PrithviBhende/emg-teleoperation-ros2/docs/images/pcb/ROUTING_BOTTOM.png

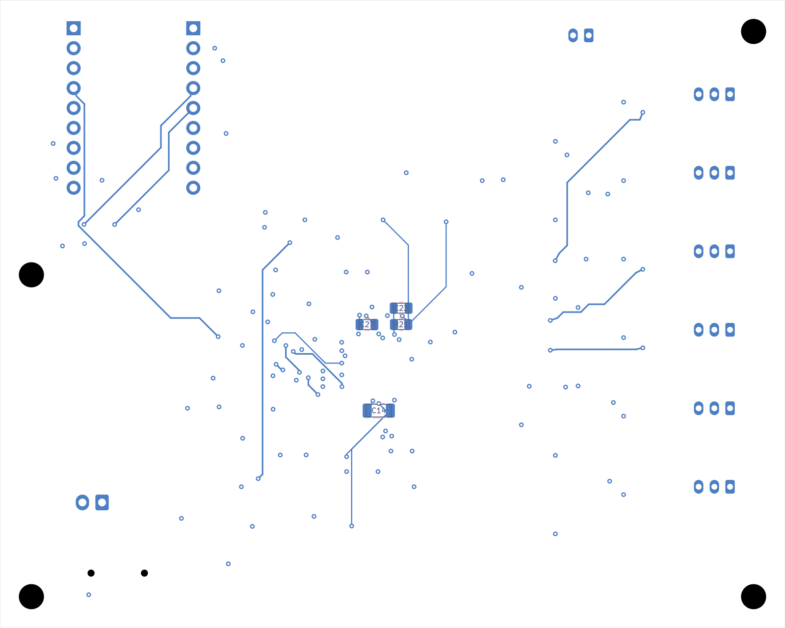
docs/images/pcb/ROUTING_BOTTOM.png
