PrithviBhende/emg-teleoperation-ros2/docs/images/projections/P01_P1_8_gestures_training_KNN_SVM_LDA_2D.png

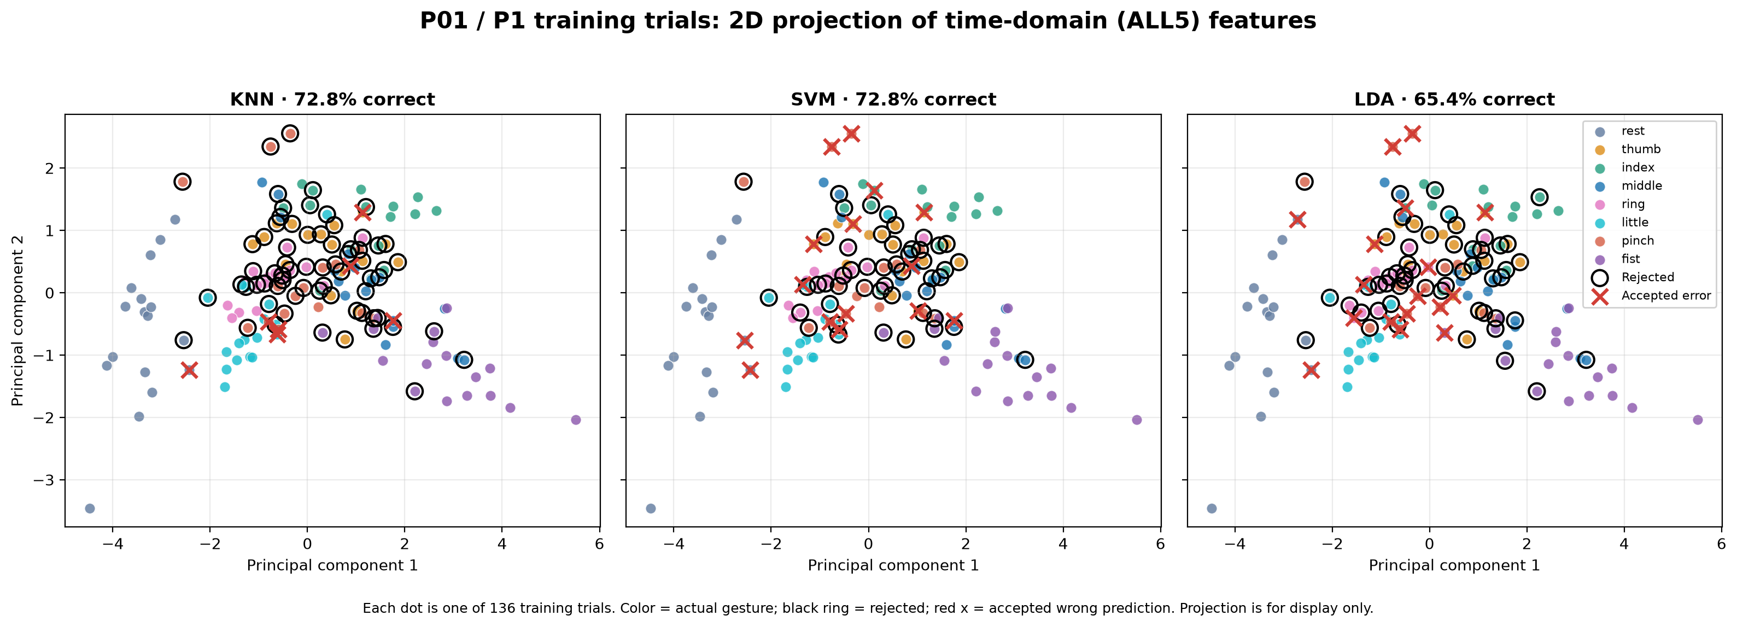
docs/images/projections/P01_P1_8_gestures_training_KNN_SVM_LDA_2D.png
