PrithviBhende/emg-teleoperation-ros2/docs/images/tiny_schematic.png

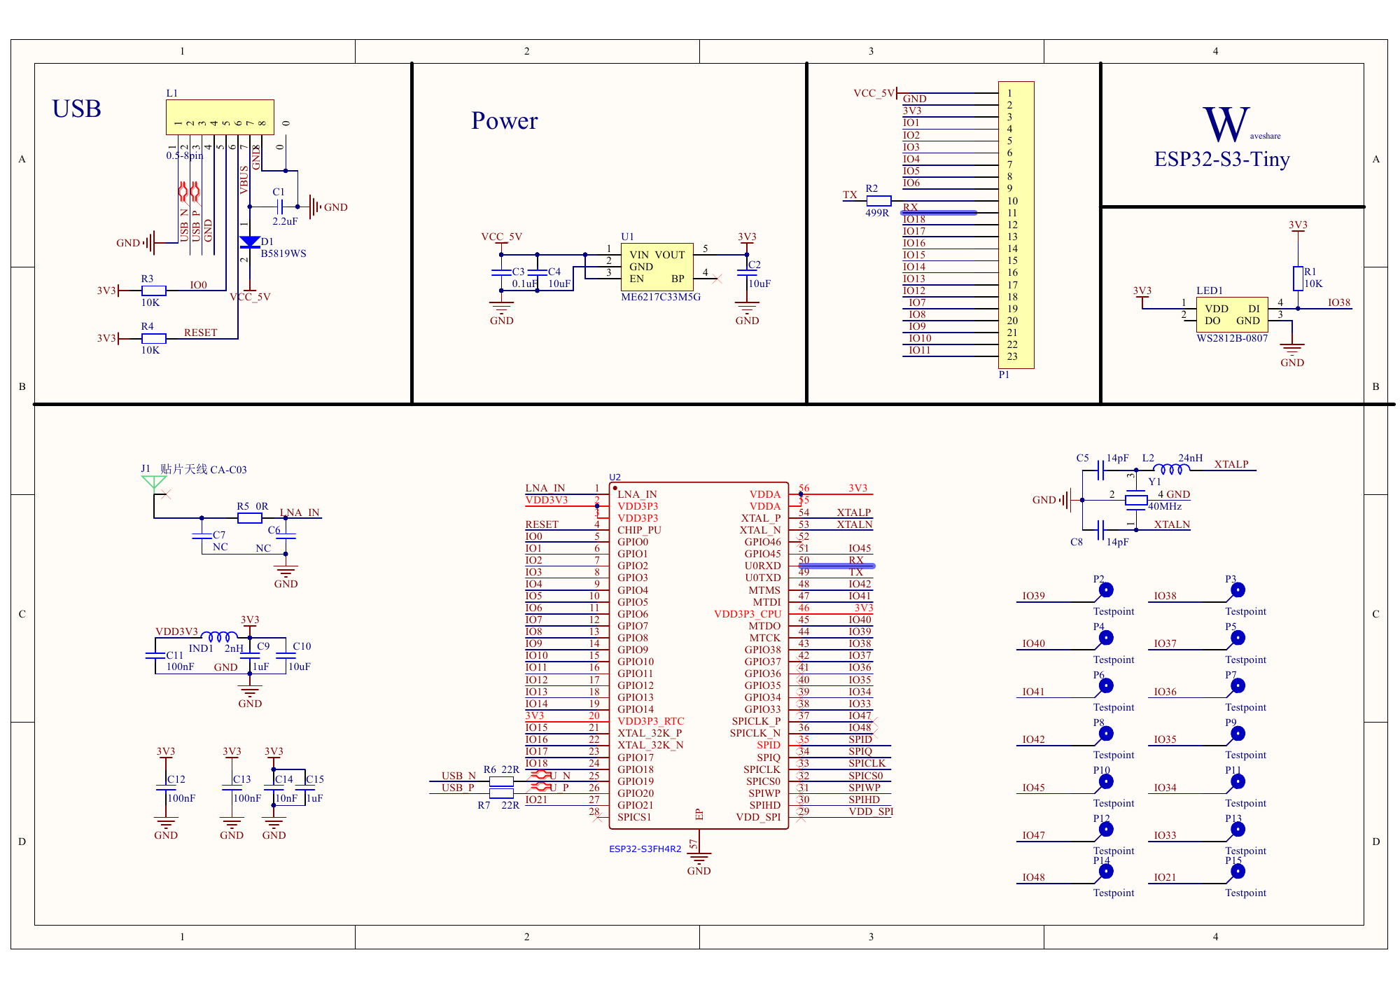
docs/images/tiny_schematic.png
