PrithviBhende/emg-teleoperation-ros2/docs/images/voltage_divider_schematic.png

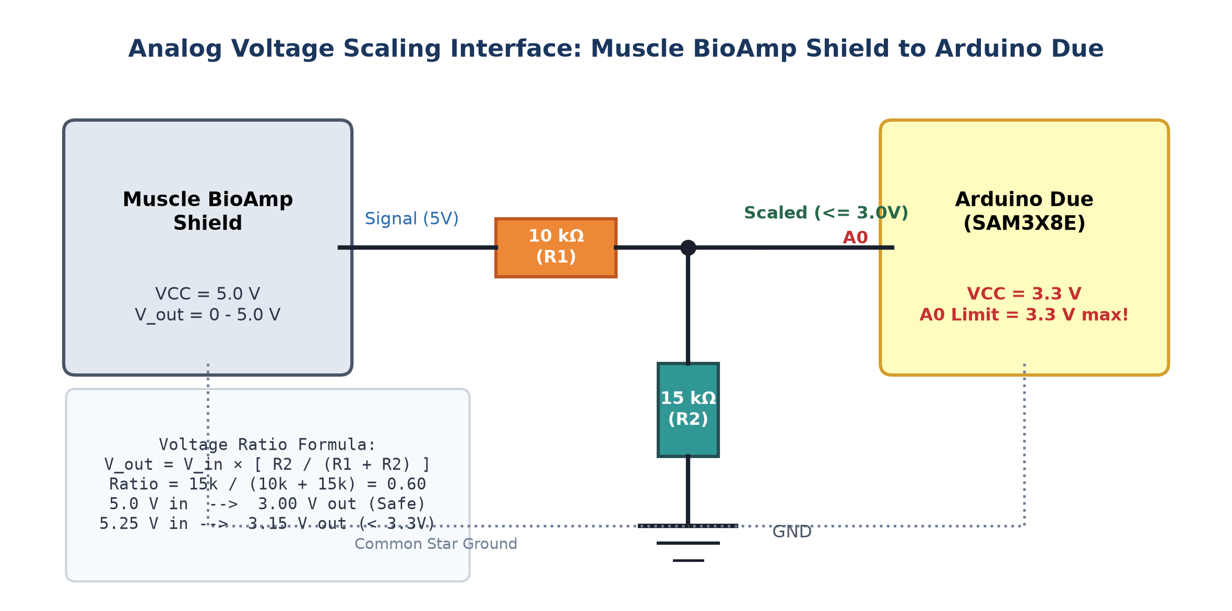
docs/images/voltage_divider_schematic.png
