PrithviBhende/emg-teleoperation-ros2/hardware/ADS1296_6CH_sEMG/connection_diagrams/01_main_connections.png

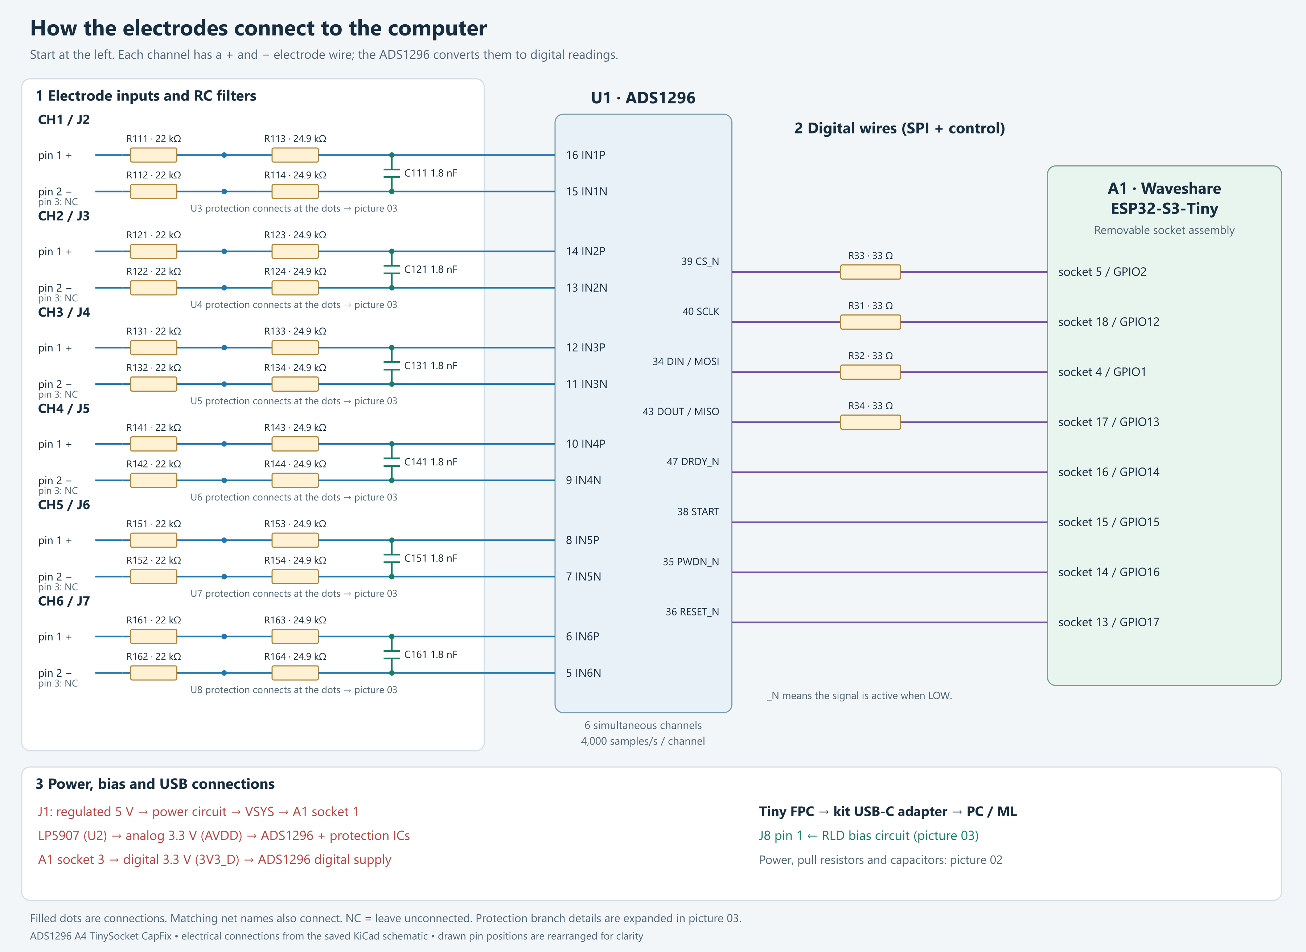
hardware/ADS1296_6CH_sEMG/connection_diagrams/01_main_connections.png
