PrithviBhende/emg-teleoperation-ros2/hardware/ADS1296_6CH_sEMG/connection_diagrams/02_power_and_capacitors.png

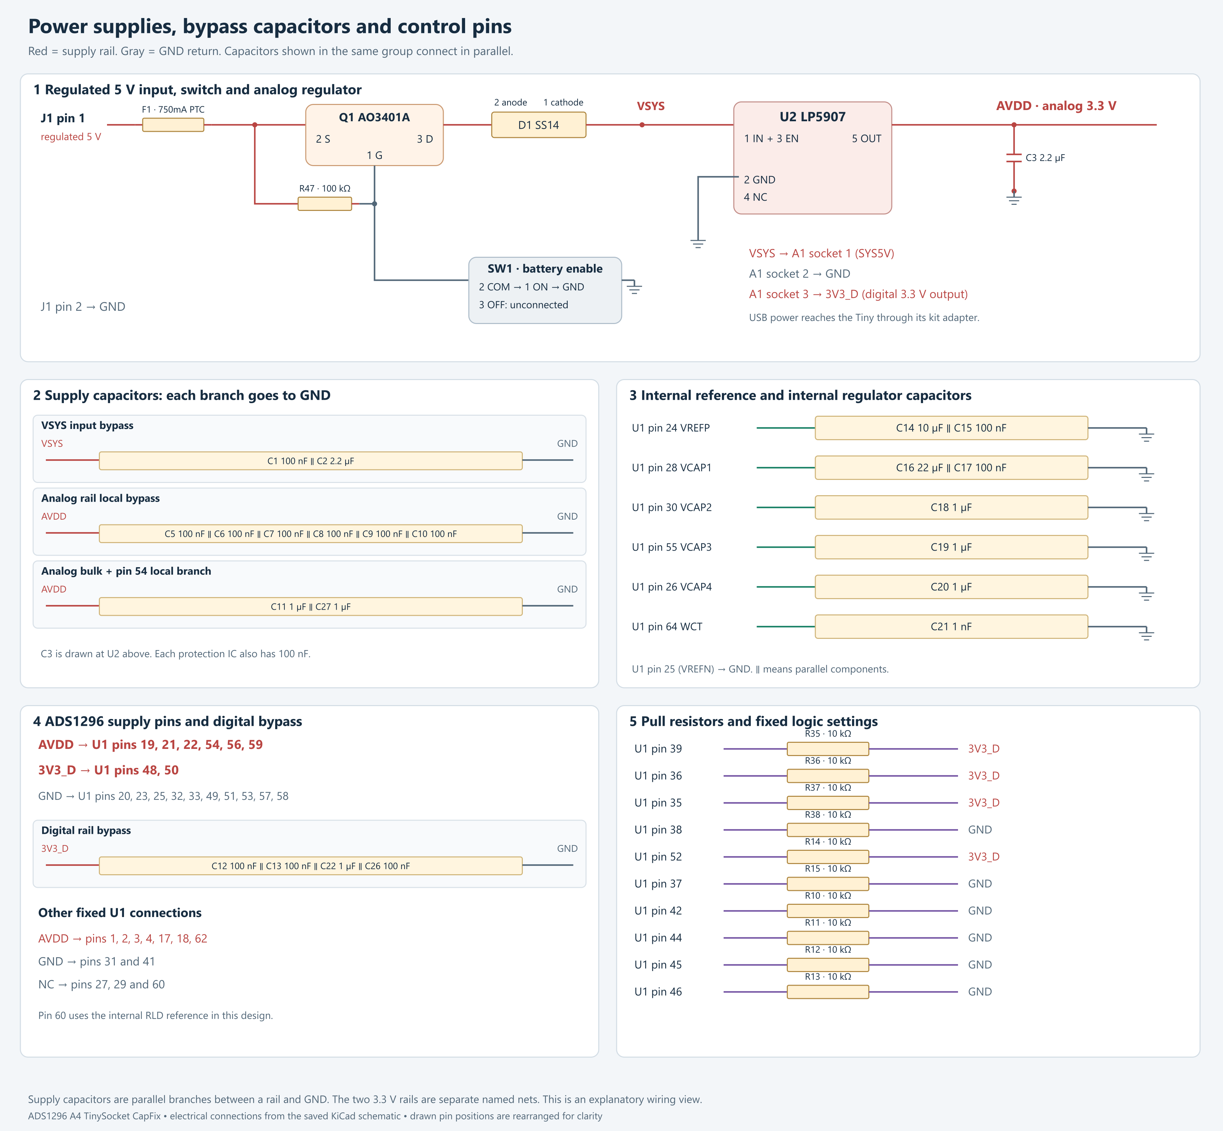
hardware/ADS1296_6CH_sEMG/connection_diagrams/02_power_and_capacitors.png
