PrithviBhende/emg-teleoperation-ros2/hardware/ADS1296_6CH_sEMG/connection_diagrams/03_protection_and_bias.png

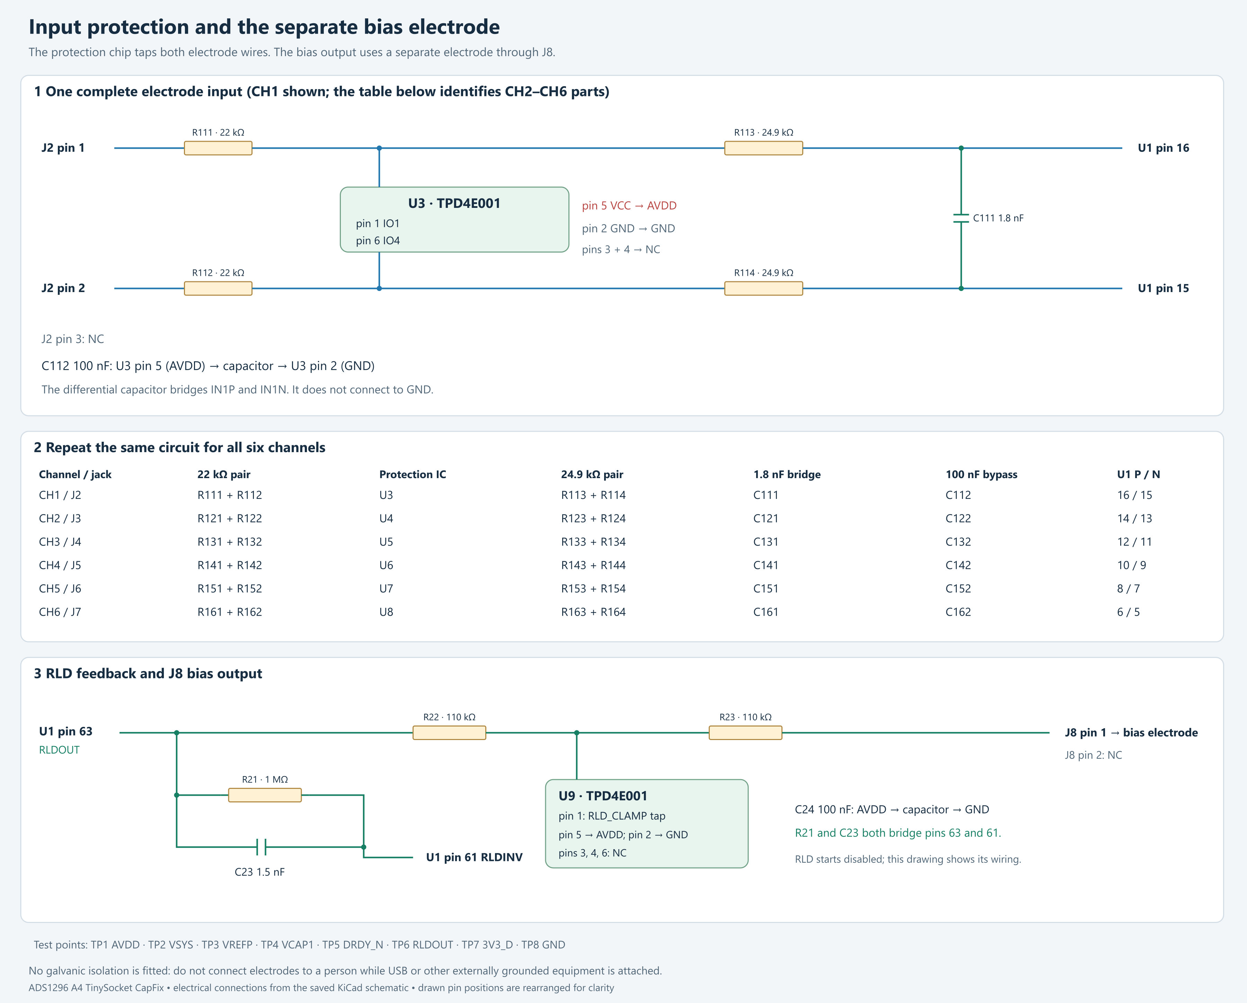
hardware/ADS1296_6CH_sEMG/connection_diagrams/03_protection_and_bias.png
