PrithviBhende/emg-teleoperation-ros2/hardware/ADS1296_6CH_sEMG/release_review_2026-10-08/external_items_preview.png

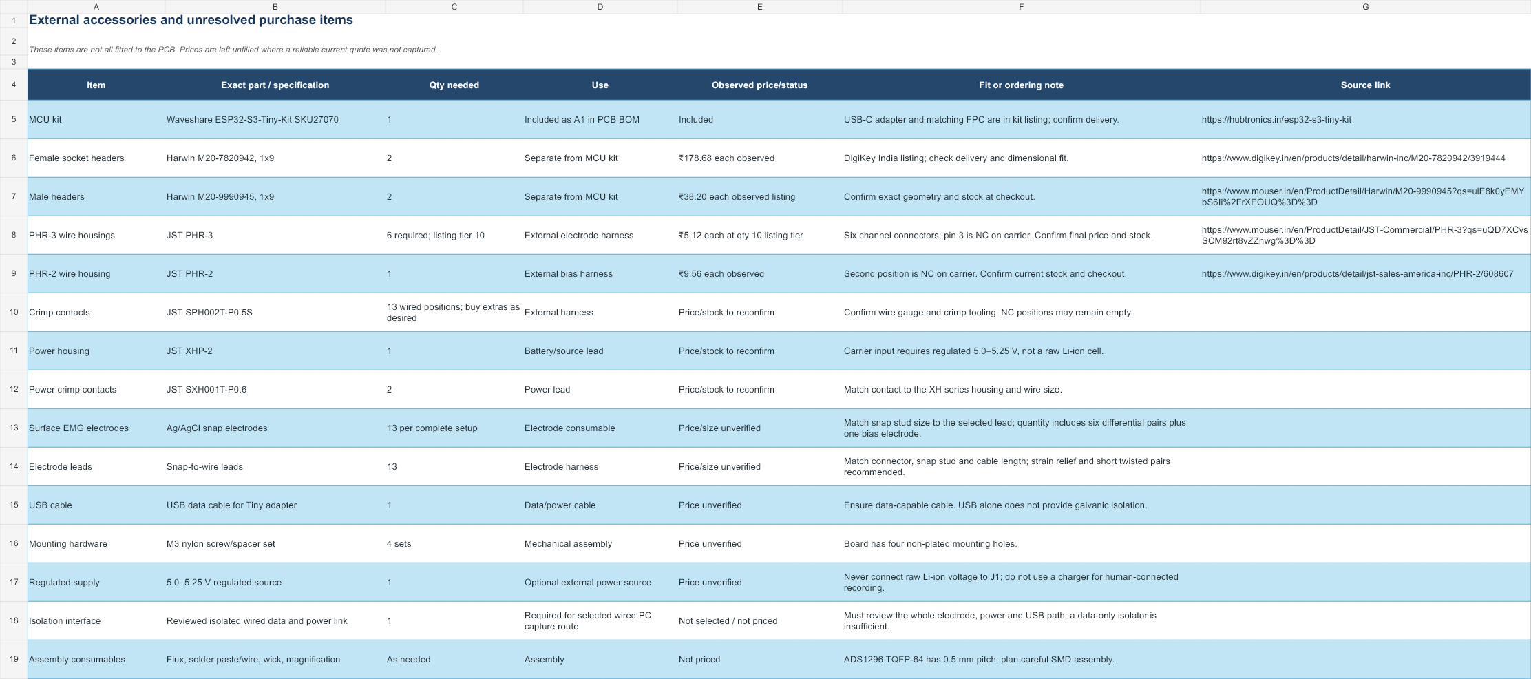
hardware/ADS1296_6CH_sEMG/release_review_2026-10-08/external_items_preview.png
