PrithviBhende/emg-teleoperation-ros2/hardware/ADS1296_6CH_sEMG/release_review_2026-10-08/ADS1296_RevA4_TinySocket_CapFix_BOM.xlsx

Sheet: PCB BOM
ADS1296 RevA4 TinySocket CapFix | Purchase BOM
Grouped by exact part number. Prices are observed listings, not a delivered quote. Blank amounts mean no dependable price was captured. Confirm stock, tax, shipping and PIN 576104 before ordering.
Note: 26 purchase groups cover 101 fitted components. TP1–TP8 are bare copper pads and H1–H4 are unplated holes, not purchased components. Amounts are estimates, not a landed total. TPD4E001 is out of stock.
Ref(s) | Component | Exact manufacturer part / SKU | Value / rating | PCB qty | Min quote qty | Observed unit price (₹) | Indicative buy amount (₹) | Quote status | Supplier | Price/source link | Package / footprint | Ordering notes
U1 | Six-channel biopotential ADC | ADS1296IPAG | 24-bit, 6-channel, TQFP-64 | 1 | 1 | ₹4429.78 | ₹4429.78 | Listing observed; reconfirm | Mouser India | https://www.mouser.in/en/ProductDetail/Texas-Instruments/ADS1296IPAG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 | TQFP-64, 0.5 mm pitch | Candidate price only; listing/stock/landed costs need checkout reconfirmation. TI direct showed out of stock.
A1 | MCU development module + adapter kit | ESP32-S3-Tiny-Kit, Waveshare SKU 27070 | ESP32-S3-Tiny + USB-C adapter + FPC | 1 | 1 | ₹635.00 | ₹635.00 | Listing observed; reconfirm | Hubtronics | https://hubtronics.in/esp32-s3-tiny-kit | Socket kit / assembled module | ₹635 incl. GST shown. Carrier socket fit and delivery to PIN 576104 remain unconfirmed.
SW1 | Slide switch | JS102011SAQN | SPDT, On-On, SMD | 1 | 1 | ₹86.00 | ₹86.00 | Listing observed; reconfirm | DigiKey India | https://www.digikey.in/en/products/detail/c-k/JS102011SAQN/1640095 | SMD | In stock shown on 2026-10-08.
C16 | Ceramic capacitor | C1210C226K4PACTU | 22 µF, 16 V, X5R, 10%, 1210 | 1 | 1 | ₹83.13 | ₹83.13 | Listing observed; reconfirm | DigiKey India | https://www.digikey.in/en/products/detail/kemet/C1210C226K4PACTU/1465626 | 1210 | Observed listing; reconfirm current price, import/tax and shipping at checkout.
U3-U8, U9 | ESD protection array | TPD4E001DBVR | 4-line low-capacitance ESD, standard DBV pinout | 7 | 1 | ₹64.01 | ₹448.07 | Unavailable at checked suppliers | Mouser India | https://www.mouser.in/en/ProductDetail/Texas-Instruments/TPD4E001DBVR?qs=TeC8nwD7mVpPZhmkNxkg4A%3D%3D | SOT-23-6 | BLOCKED: checked stock 0; incoming shown in 2027. Do not treat as buyable for the deadline. Alternative not approved.
C14 | Ceramic capacitor | C1206C106K4PACTU | 10 µF, 16 V, X5R, 10%, 1206 | 1 | 1 | ₹51.60 | ₹51.60 | Listing observed; reconfirm | DigiKey India | https://www.digikey.in/en/products/detail/kemet/C1206C106K4PACTU/1465625 | 1206 | DigiKey listing showed ₹51.60 each and stock on 2026-10-08; import/tax/shipping extra per checkout.
Q1 | P-channel MOSFET | AO3401A | 30 V, SOT-23 | 1 | 1 | ₹49.69 | ₹49.69 | Listing observed; reconfirm | DigiKey India | https://www.digikey.in/en/products/detail/alpha-omega-semiconductor-inc/AO3401A/1855773 | SOT-23 | Quote is for AOS manufacturer part.
D1 | Schottky diode | SS14 (onsemi) | 40 V, 1 A, SMA / DO-214AC | 1 | 1 | ₹42.04 | ₹42.04 | Listing observed; reconfirm | DigiKey India | https://www.digikey.in/en/products/detail/onsemi/SS14/965474 | SMA | Use SMA package; SS14W in SOD-123 is not footprint-compatible.
C2-C3 | Ceramic capacitor | C0805C225K4RACTU | 2.2 µF, 16 V, X7R, 10%, 0805 | 2 | 1 | ₹37.70 | ₹75.40 | Listing observed; reconfirm | LionCircuits | https://www.lioncircuits.com/parts/C0805C225K4RACTU | 0805 | Observed listing; reconfirm live price, stock and delivery at checkout.
F1 | Resettable fuse | MF-MSMF075-2 | 750 mA hold, 1.5 A trip, 13.2 V, 1812 | 1 | 1 | ₹36.31 | ₹36.31 | Listing observed; reconfirm | DigiKey India | https://www.digikey.in/en/products/detail/bourns-inc/MF-MSMF075-2/662843 | 1812 SMD | In stock shown on 2026-10-08; marked Not For New Designs by supplier.
U2 | Low-noise LDO regulator | LP5907MFX-3.3/NOPB | 3.3 V fixed, 250 mA, SOT-23-5 | 1 | 1 | ₹17.11 | ₹17.11 | Listing observed; reconfirm | Evelta | https://evelta.com/texas-instruments-lp5907mfx-3-3-nopb-fixed-ldo-voltage-regulator-3-3vout/ | SOT-23-5 | ₹17.11 incl. GST shown; supplier authorization not established; reconfirm.
C21 | Ceramic capacitor | C0805C102J5GACTU | 1 nF, 50 V, C0G, 5%, 0805 | 1 | 1 | ₹16.24 | ₹16.24 | Listing observed; reconfirm | DigiKey India | https://www.digikey.in/en/products/detail/kemet/C0805C102J5GACTU/411135 | 0805 | DigiKey listing showed ₹16.24 each and stock on 2026-10-08; import/tax/shipping extra per checkout.
C111, C121, C131, C141, C151, C161 | Ceramic capacitor | C0805C182J5GACTU | 1.8 nF, 50 V, C0G, 5%, 0805 | 6 | 10 | ₹15.62 | ₹156.21 | Observed; delivery unconfirmed | LionCircuits | https://www.lioncircuits.com/ | 0805 | Fresh listing: 10-piece tier ₹15.621 each; buy quantity 10 minimum (₹156.21 listing subtotal); delivery estimate 7-10 days, not arrival guarantee.
J2-J7 | 3-way electrode connector | B3B-PH-K-S(LF)(SN) | JST PH, 2.00 mm, vertical | 6 | 1 | ₹15.29 | ₹91.74 | Listing observed; reconfirm | DigiKey India | https://www.digikey.in/en/products/detail/jst-sales-america-inc/B3B-PH-K-S/926612 | Through-hole | Unit listing observed; checkout/tax/shipping reconfirm.
C23 | Ceramic capacitor | C0805C152J5GACTU | 1.5 nF, 50 V, C0G, 5%, 0805 | 1 | 1 | ₹15.29 | ₹15.29 | Listing observed; reconfirm | DigiKey India | https://www.digikey.in/en/products/detail/kemet/C0805C152J5GACTU/2211962 | 0805 | DigiKey listing showed ₹15.29 each and stock on 2026-10-08; import/tax/shipping extra per checkout.
J8 | 2-way bias connector | B2B-PH-K-S(LF)(SN) | JST PH, 2.00 mm, vertical | 1 | 1 | ₹11.47 | ₹11.47 | Listing observed; reconfirm | DigiKey India | https://www.digikey.in/en/products/detail/jst-sales-america-inc/B2B-PH-K-S/926611 | Through-hole | Unit listing observed; confirm current stock/tax at checkout.
R47 | Resistor | RC0805FR-07100KL | 100 kΩ, 1%, 0805 | 1 | 1 | ₹9.32 | ₹9.32 | Listing observed; reconfirm | Mouser India | https://www.mouser.in/en/ProductDetail/YAGEO/RC0805FR-07100KL?qs=8Y8p%252BasKcI7rEWn6FcVdAA%3D%3D | 0805 | Observed supplier listing; reconfirm price, tax and stock.
C11, C18-C20, C22, C27 | Ceramic capacitor | C0805C105K4RACTU | 1 µF, 16 V, X7R, 10%, 0805 | 6 | 10 | ₹8.39 | ₹83.90 | Listing observed; reconfirm | Mouser India | https://www.mouser.in/ProductDetail/KEMET/C0805C105K4RACTU?qs=yrVqjCObULOefkidH6lLLQ%3D%3D | 0805 | Mouser listing showed ₹8.39 each at quantity 10 and stock on 2026-10-08; delivery/tax at checkout.
R111, R121, R131, R141, R151, R161, R112, R122, R132, R142, R152, R162 | Precision resistor | RT0805BRD0722KL | 22 kΩ, 0.1%, ≤25 ppm/K, 0805 | 12 | 10 | ₹7.93 | ₹95.17 | Listing observed; reconfirm | DigiKey India | https://www.digikey.in/en/products/detail/yageo/RT0805BRD0722KL/5139281 | 0805 | Quantity-10 tier; 12 required. ₹7.931/unit observed; tax/shipping treatment to confirm.
R113, R123, R133, R143, R153, R163, R114, R124, R134, R144, R154, R164 | Precision resistor | RT0805BRD0724K9L | 24.9 kΩ, 0.1%, ≤25 ppm/K, 0805 | 12 | 10 | ₹7.93 | ₹95.17 | Listing observed; reconfirm | DigiKey India | https://www.digikey.in/en/products/detail/yageo/RT0805BRD0724K9L/1075743 | 0805 | Quantity-10 tier; 12 required. ₹7.931/unit observed; tax/shipping treatment to confirm.
J1 | 2-way power connector | B2B-XH-A(LF)(SN) | JST XH, 2.50 mm, vertical | 1 | 1 | ₹7.43 | ₹7.43 | Listing observed; reconfirm | element14 India | https://in.element14.com/jst-japan-solderless-terminals/b2b-xh-a-lf-sn/header-vertical-2way/dp/1516276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 | Through-hole | ₹7.43 listing, MOQ 1; checkout/tax/delivery reconfirm.
C1, C5-C10, C12-C13, C15, C17, C24, C26, C112, C122, C132, C142, C152, C162 | Ceramic capacitor | C0805C104K4RACTU | 100 nF, 16 V, X7R, 10%, 0805 | 19 | 10 | ₹5.57 | ₹105.83 | Listing observed; reconfirm | Mouser India | https://www.mouser.in/ProductDetail/KEMET/C0805C104K4RACTU?qs=Pc30aiB8zWWfqQNJWggt%252BA%3D%3D | 0805 | Historical observed quantity-tier price; live stock/price needs reconfirmation.
R31-R34 | Resistor | RC0805FR-0733RL | 33 Ω, 1%, 0805 | 4 | 1 | ₹2.36 | ₹9.44 | Listing observed; reconfirm | Evelta | https://evelta.com/33r-1-0-125w-0805-chip-resistor/ | 0805 | ₹2 ex-GST each; ₹2.36 incl. 18% GST estimate; shipping extra.
R21 | Resistor | RC0805FR-071ML | 1 MΩ, 1%, 0805 | 1 | 1 | ₹1.30 | ₹1.30 | Listing observed; reconfirm | Evelta | https://evelta.com/1m-1-0-125w-0805-chip-resistor/ | 0805 | ₹1.10 ex-GST / ₹1.30 incl. GST observed; shipping extra.
R22-R23 | Resistor | RC0805FR-07110KL | 110 kΩ, 1%, 0805 | 2 | 1 | ₹1.30 | ₹2.60 | Listing observed; reconfirm | Evelta | https://evelta.com/110k-1-0-125w-0805-chip-resistor/ | 0805 | ₹1.10 ex-GST each; ₹1.298 incl. 18% GST estimate; shipping extra.
R10-R15, R35-R38 | Resistor | RC0805FR-0710KL | 10 kΩ, 1%, 0805 | 10 | 10 | ₹1.27 | ₹12.74 | Listing observed; reconfirm | Evelta | https://evelta.com/10k-1-0-125w-0805-chip-resistor/ | 0805 | ₹1.08 ex-GST each at qty 10; ₹1.2744 incl. 18% GST estimate; shipping extra.
Indicative extension of priced rows only (mixed tax basis; excludes shipping, PCB, isolation and unpriced items) |  |  |  |  |  |  | 6667.98

Sheet: External items
External accessories and unresolved purchase items
These items are not all fitted to the PCB. Prices are left unfilled where a reliable current quote was not captured.
Item | Exact part / specification | Qty needed | Use | Observed price/status | Fit or ordering note | Source link
MCU kit | Waveshare ESP32-S3-Tiny-Kit SKU27070 | 1 | Included as A1 in PCB BOM | Included | USB-C adapter and matching FPC are in kit listing; confirm delivery. | https://hubtronics.in/esp32-s3-tiny-kit
Female socket headers | Harwin M20-7820942, 1x9 | 2 | Separate from MCU kit | ₹178.68 each observed | DigiKey India listing; check delivery and dimensional fit. | https://www.digikey.in/en/products/detail/harwin-inc/M20-7820942/3919444
Male headers | Harwin M20-9990945, 1x9 | 2 | Separate from MCU kit | ₹38.20 each observed listing | Confirm exact geometry and stock at checkout. | https://www.mouser.in/en/ProductDetail/Harwin/M20-9990945?qs=ulE8k0yEMYbS6Ii%2FrXEOUQ%3D%3D
PHR-3 wire housings | JST PHR-3 | 6 required; listing tier 10 | External electrode harness | ₹5.12 each at qty 10 listing tier | Six channel connectors; pin 3 is NC on carrier. Confirm final price and stock. | https://www.mouser.in/en/ProductDetail/JST-Commercial/PHR-3?qs=uQD7XCvsSCM92rt8vZZnwg%3D%3D
PHR-2 wire housing | JST PHR-2 | 1 | External bias harness | ₹9.56 each observed | Second position is NC on carrier. Confirm current stock and checkout. | https://www.digikey.in/en/products/detail/jst-sales-america-inc/PHR-2/608607
Crimp contacts | JST SPH002T-P0.5S | 13 wired positions; buy extras as desired | External harness | Price/stock to reconfirm | Confirm wire gauge and crimp tooling. NC positions may remain empty.
Power housing | JST XHP-2 | 1 | Battery/source lead | Price/stock to reconfirm | Carrier input requires regulated 5.0–5.25 V, not a raw Li-ion cell.
Power crimp contacts | JST SXH001T-P0.6 | 2 | Power lead | Price/stock to reconfirm | Match contact to the XH series housing and wire size.
Surface EMG electrodes | Ag/AgCl snap electrodes | 13 per complete setup | Electrode consumable | Price/size unverified | Match snap stud size to the selected lead; quantity includes six differential pairs plus one bias electrode.
Electrode leads | Snap-to-wire leads | 13 | Electrode harness | Price/size unverified | Match connector, snap stud and cable length; strain relief and short twisted pairs recommended.
USB cable | USB data cable for Tiny adapter | 1 | Data/power cable | Price unverified | Ensure data-capable cable. USB alone does not provide galvanic isolation.
Mounting hardware | M3 nylon screw/spacer set | 4 sets | Mechanical assembly | Price unverified | Board has four non-plated mounting holes.
Regulated supply | 5.0–5.25 V regulated source | 1 | Optional external power source | Price unverified | Never connect raw Li-ion voltage to J1; do not use a charger for human-connected recording.
Isolation interface | Reviewed isolated wired data and power link | 1 | Required for selected wired PC capture route | Not selected / not priced | Must review the whole electrode, power and USB path; a data-only isolator is insufficient.
Assembly consumables | Flux, solder paste/wire, wick, magnification | As needed | Assembly | Not priced | ADS1296 TQFP-64 has 0.5 mm pitch; plan careful SMD assembly.
