PrithviBhende/emg-teleoperation-ros2/hardware/ADS1296_6CH_sEMG/release_review_2026-10-08/bom_preview.png

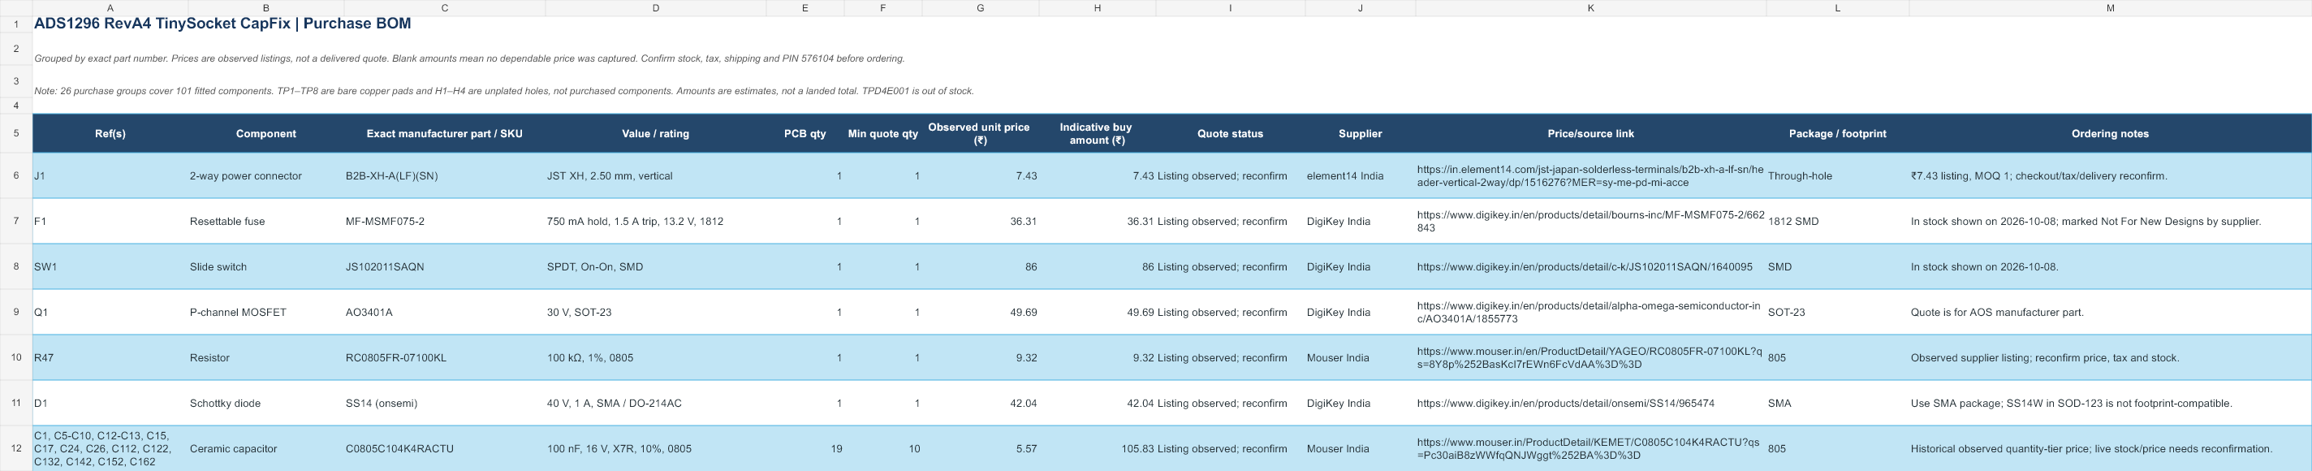
hardware/ADS1296_6CH_sEMG/release_review_2026-10-08/bom_preview.png
