PrithviBhende/emg-teleoperation-ros2/ros2/inmoov_hand_ros/src/inmoov_hand_description/meshes/r_cover_ring.stl

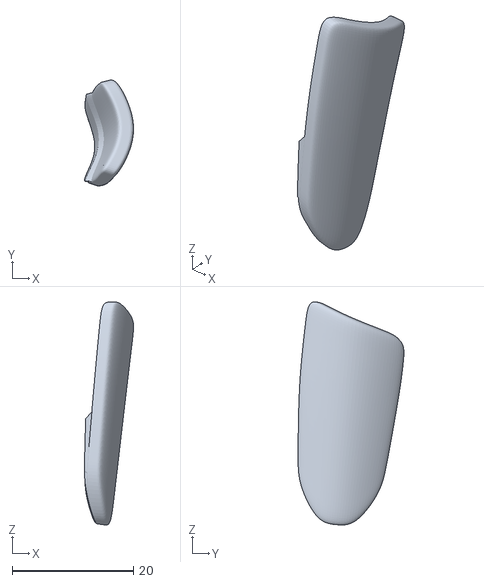
[picture p34: CAD file, 2026-11-13]
ros2/inmoov_hand_ros/src/inmoov_hand_description/meshes/r_cover_ring.stl
8.09 x 17.4 x 36.7
