PrithviBhende/emg-teleoperation-ros2/ros2/inmoov_hand_ros/src/inmoov_hand_description/meshes/l_ring3_1.stl

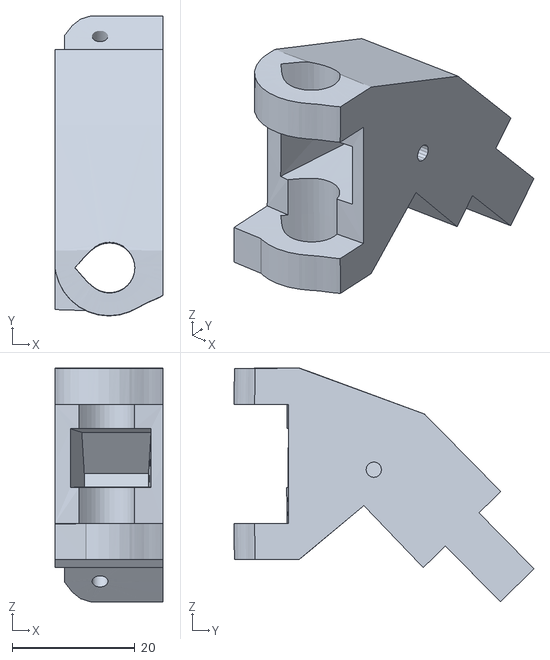
[picture p35: CAD file, 2026-11-13]
ros2/inmoov_hand_ros/src/inmoov_hand_description/meshes/l_ring3_1.stl
17.7 x 48.9 x 38.1
