PrithviBhende/emg-teleoperation-ros2/ros2/inmoov_hand_ros/src/inmoov_hand_description/meshes/virtual.stl

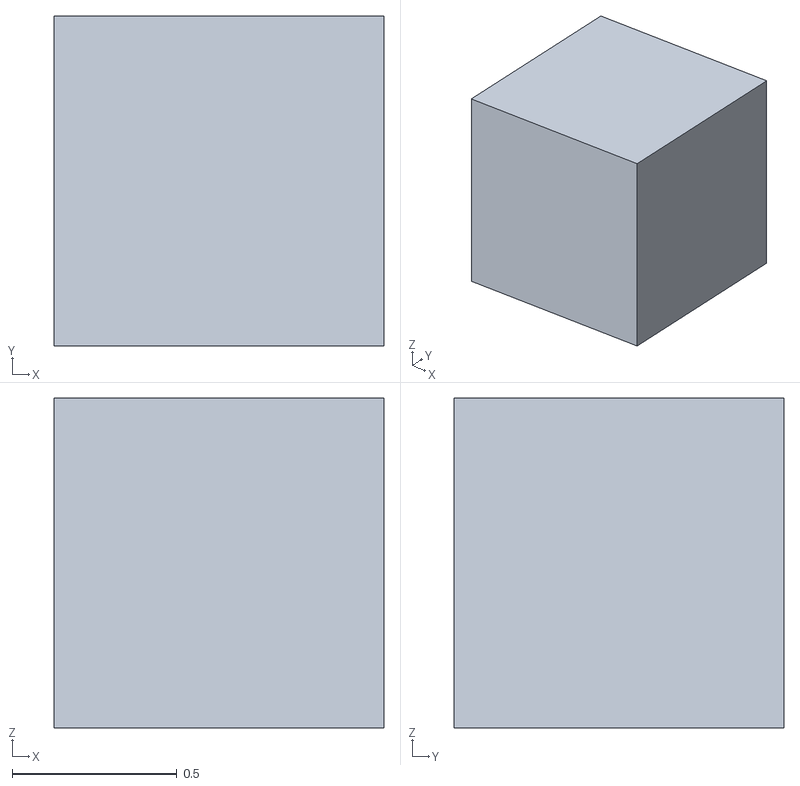
[picture p36: CAD file, 2026-11-13]
ros2/inmoov_hand_ros/src/inmoov_hand_description/meshes/virtual.stl
1.00 x 1.00 x 1.00
