PrithviBhende/emg-teleoperation-ros2/ros2/inmoov_hand_ros/src/inmoov_hand_description/meshes/head.stl

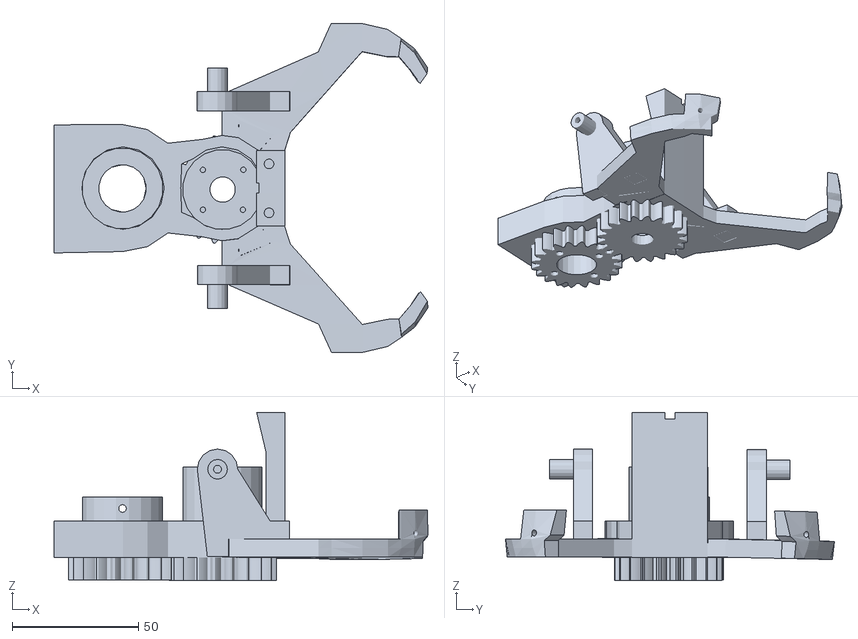
[picture p37: CAD file, 2026-11-13]
ros2/inmoov_hand_ros/src/inmoov_hand_description/meshes/head.stl
148.3 x 130.5 x 66.7
