PrithviBhende/emg-teleoperation-ros2/ros2/inmoov_hand_ros/src/inmoov_hand_description/meshes/camera.stl

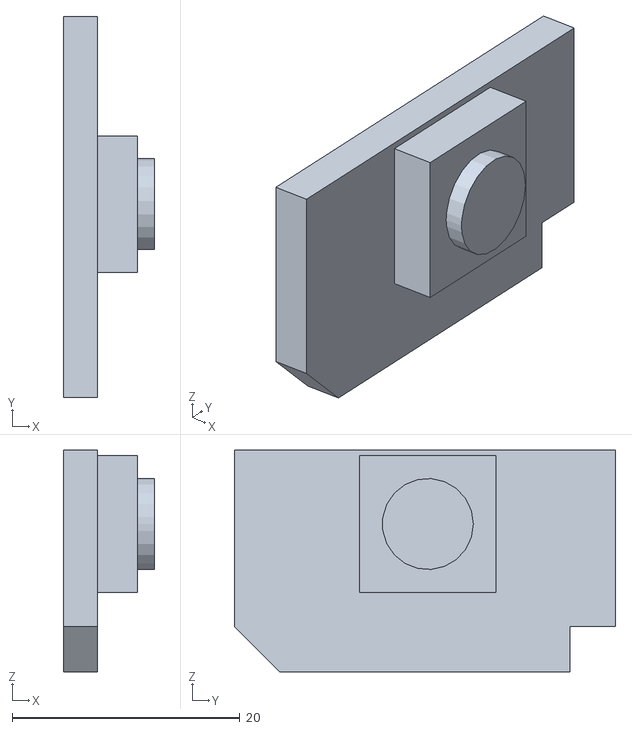
[picture p38: CAD file, 2026-11-13]
ros2/inmoov_hand_ros/src/inmoov_hand_description/meshes/camera.stl
8.00 x 33.5 x 19.5
