PrithviBhende/emg-teleoperation-ros2/ros2/inmoov_hand_ros/src/inmoov_hand_description/meshes/l_thumb5_1.stl

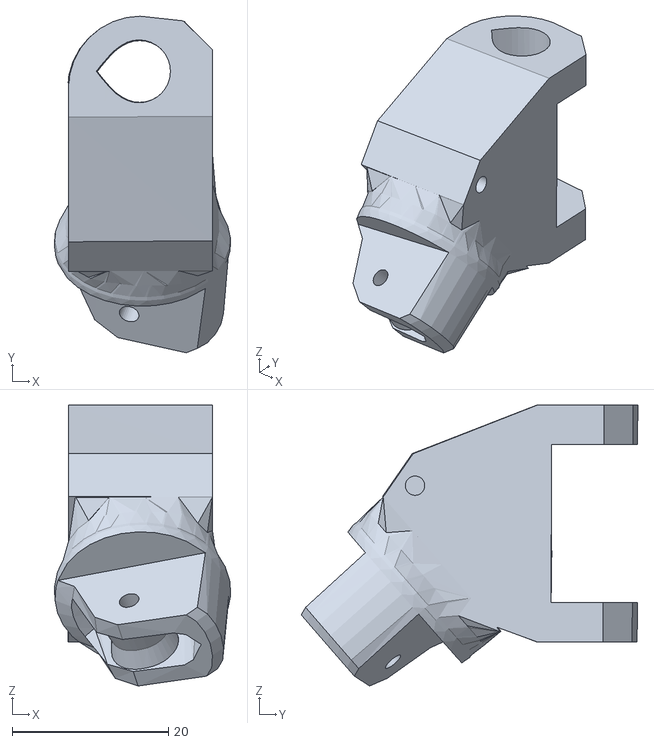
[picture p40: CAD file, 2026-11-13]
ros2/inmoov_hand_ros/src/inmoov_hand_description/meshes/l_thumb5_1.stl
22.6 x 43.0 x 35.9
