PrithviBhende/emg-teleoperation-ros2/ros2/inmoov_hand_ros/src/inmoov_hand_description/meshes/r_pinky3_1.stl

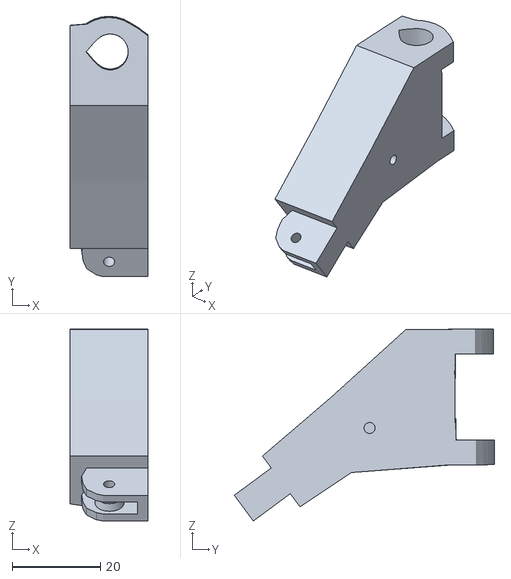
[picture p45: CAD file, 2026-11-13]
ros2/inmoov_hand_ros/src/inmoov_hand_description/meshes/r_pinky3_1.stl
17.7 x 58.9 x 43.4
