PrithviBhende/emg-teleoperation-ros2/ros2/inmoov_hand_ros/src/inmoov_hand_description/meshes/r_cover_middle.stl

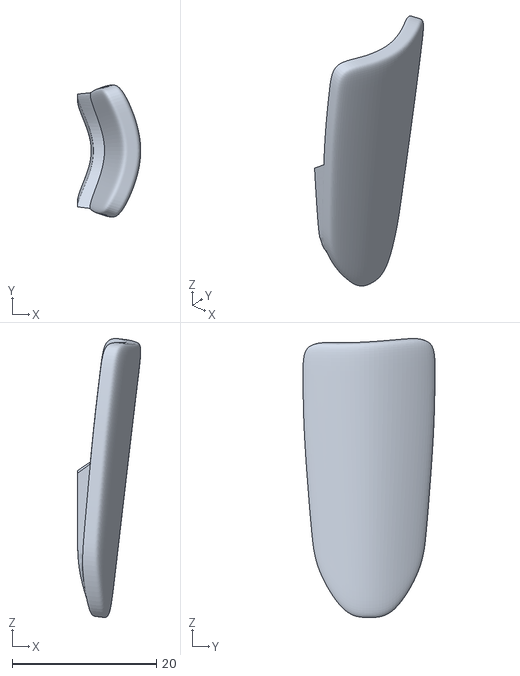
[picture p48: CAD file, 2026-11-13]
ros2/inmoov_hand_ros/src/inmoov_hand_description/meshes/r_cover_middle.stl
8.81 x 18.3 x 38.7
