PrithviBhende/emg-teleoperation-ros2/ros2/inmoov_hand_ros/src/inmoov_hand_description/meshes/l_cover_thumb.stl

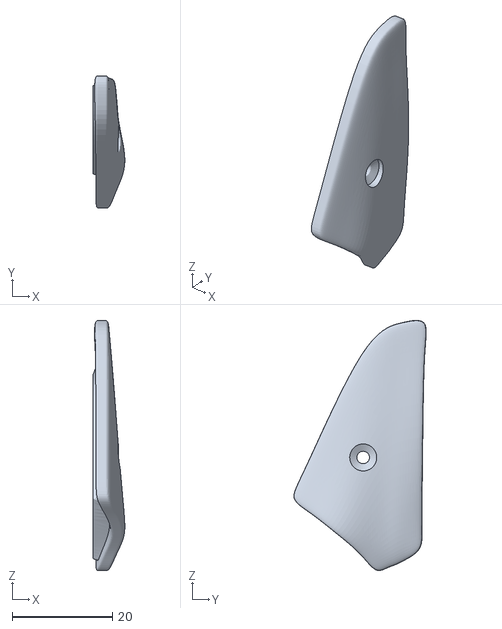
[picture p54: CAD file, 2026-11-13]
ros2/inmoov_hand_ros/src/inmoov_hand_description/meshes/l_cover_thumb.stl
6.32 x 26.3 x 49.8
