PrithviBhende/emg-teleoperation-ros2/ros2/inmoov_hand_ros/src/inmoov_hand_description/meshes/r_cover_handring.stl

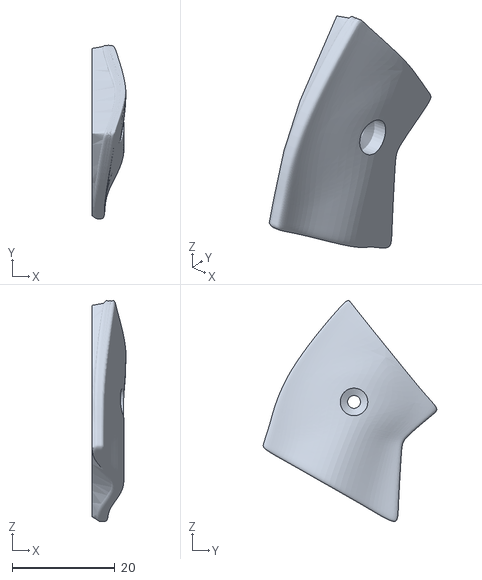
[picture p55: CAD file, 2026-11-13]
ros2/inmoov_hand_ros/src/inmoov_hand_description/meshes/r_cover_handring.stl
6.64 x 33.8 x 43.1
