PrithviBhende/emg-teleoperation-ros2/(list of files, cad)

Other CAD files:
ros2/inmoov_hand_ros/src/inmoov_hand_description/meshes/r_ring3_1.stl
ros2/inmoov_hand_ros/src/inmoov_hand_description/meshes/earleftv1.stl
ros2/inmoov_hand_ros/src/inmoov_hand_description/meshes/r_cover_thumb.stl
ros2/inmoov_hand_ros/src/inmoov_hand_description/meshes/l_cover_handring.stl
ros2/inmoov_hand_ros/src/inmoov_hand_description/meshes/r_cover_index.stl
ros2/inmoov_hand_ros/src/inmoov_hand_description/meshes/l_cover_ring.stl
ros2/inmoov_hand_ros/src/inmoov_hand_description/meshes/l_shoulder_base.stl
ros2/inmoov_hand_ros/src/inmoov_hand_description/meshes/r_thumb5_1.stl
ros2/inmoov_hand_ros/src/inmoov_hand_description/meshes/l_pinky3_1.stl
ros2/inmoov_hand_ros/src/inmoov_hand_description/meshes/l_cover_handpinky.stl
ros2/inmoov_hand_ros/src/inmoov_hand_description/meshes/r_cover_pinky.stl
ros2/inmoov_hand_ros/src/inmoov_hand_description/meshes/l_cover_middle.stl
ros2/inmoov_hand_ros/src/inmoov_hand_description/meshes/l_eyesupport.stl
ros2/inmoov_hand_ros/src/inmoov_hand_description/meshes/r_shoulder.stl
ros2/inmoov_hand_ros/src/inmoov_hand_description/meshes/r_forearm.stl
ros2/inmoov_hand_ros/src/inmoov_hand_description/meshes/l_cover_hand.stl
ros2/inmoov_hand_ros/src/inmoov_hand_description/meshes/l_hand.stl
