PrithviBhende/emg-teleoperation-ros2/docs/images/pcb/ASSEMBLY_BOTTOM.png

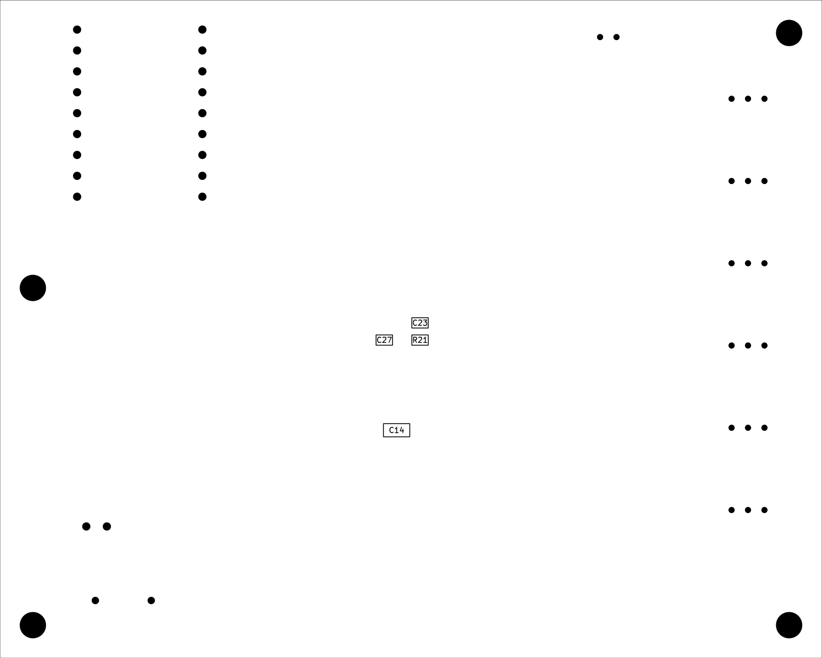
docs/images/pcb/ASSEMBLY_BOTTOM.png
