PrithviBhende/emg-teleoperation-ros2/results/training_results/01_rest_index_fist/README.md

# Study 1: rest, index, fist (3 Gestures)

- **Subject**: P01
- **Electrode Placement**: P4
- **Champion / Evaluated Model**: `A_RMS__KNN`
- **3-Fold Cross-Validation Accuracy**: 100.00% (60/60)
- **Held-Out Test Accuracy**: 100.00% (10/10)

---

## Graphical Representations & Decision Boundaries

### 2D Feature Projections & Decision Boundaries

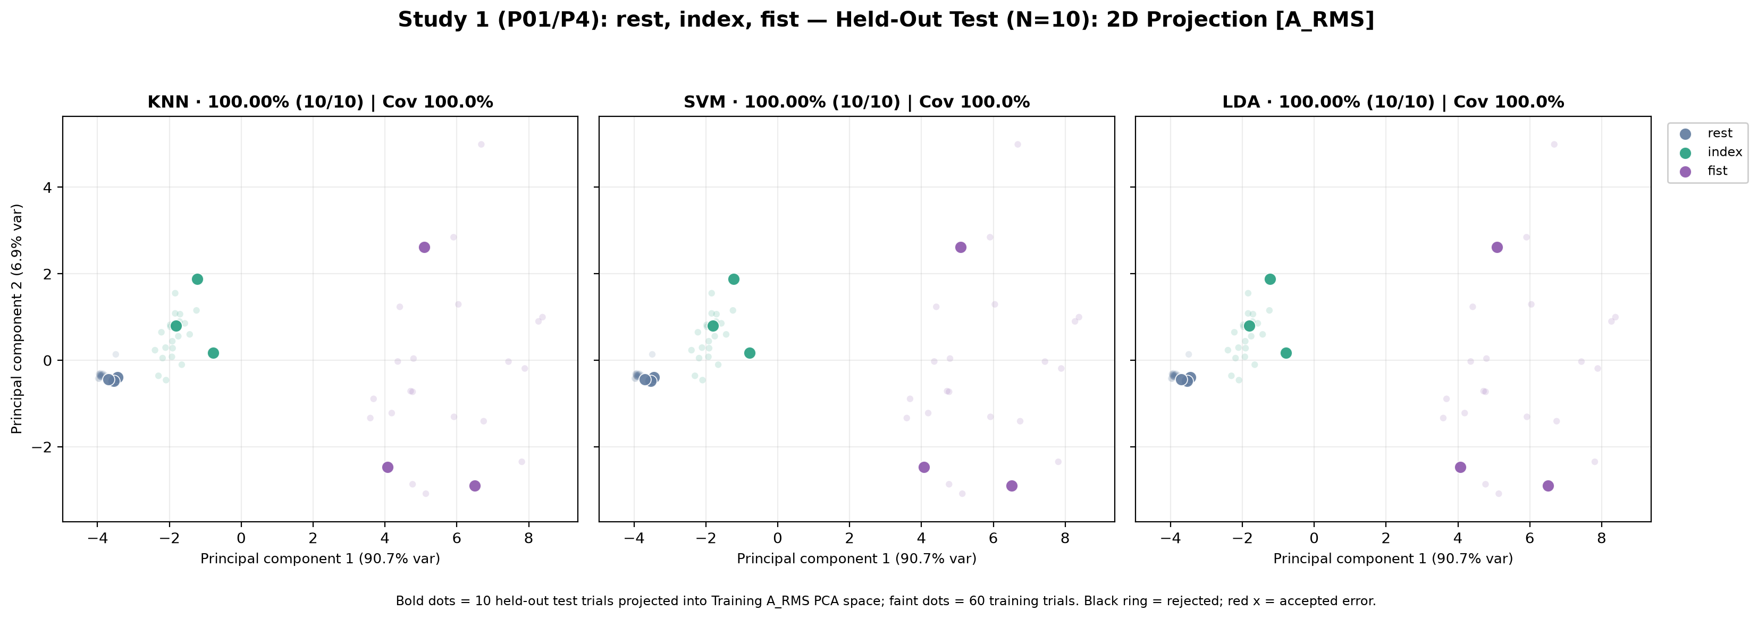
[picture p84: results/training_results/01_rest_index_fist/Study01_P01_P4_rest_index_fist_test_A_RMS_KNN_SVM_LDA_2D.png]


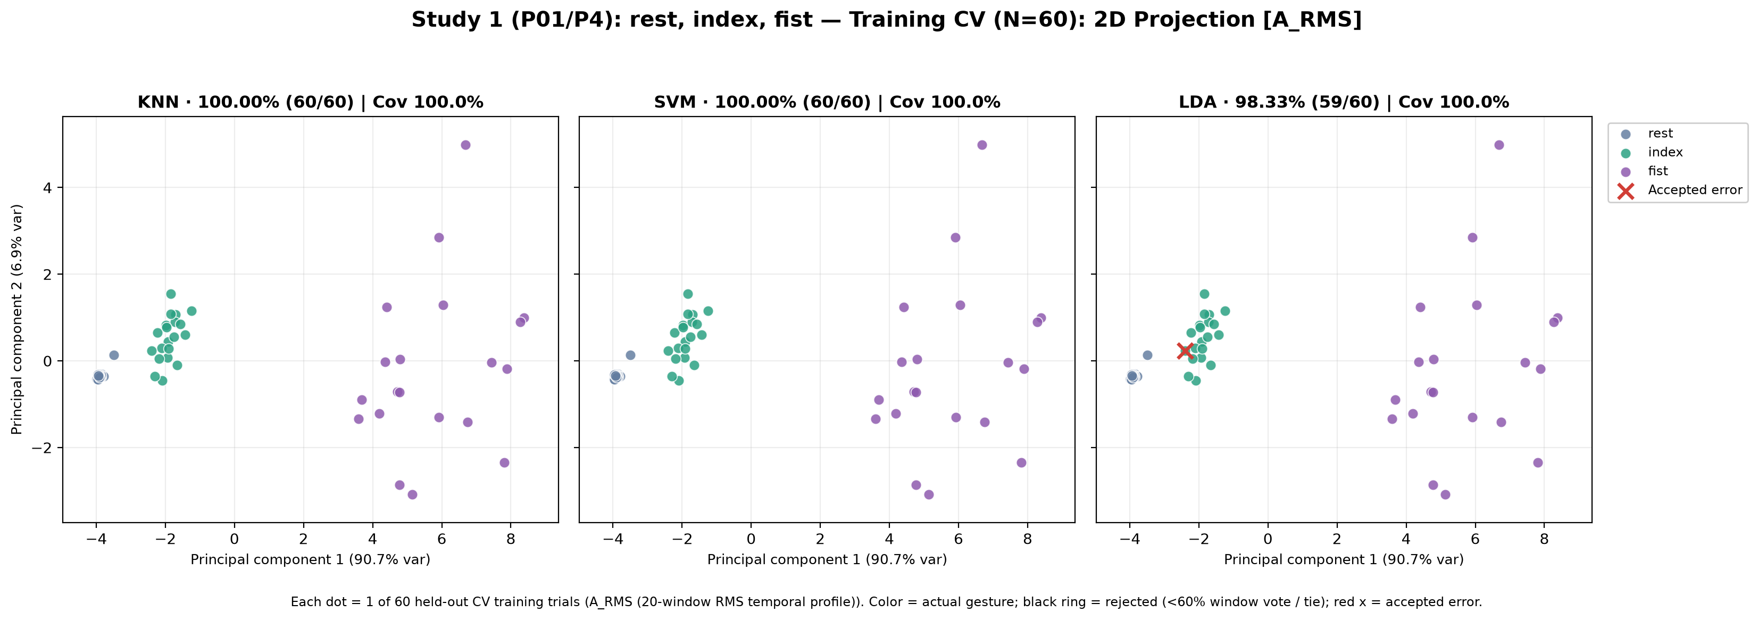
[picture p85: results/training_results/01_rest_index_fist/Study01_P01_P4_rest_index_fist_training_A_RMS_KNN_SVM_LDA_2D.png]


### 3D Feature Projections & Decision Boundaries

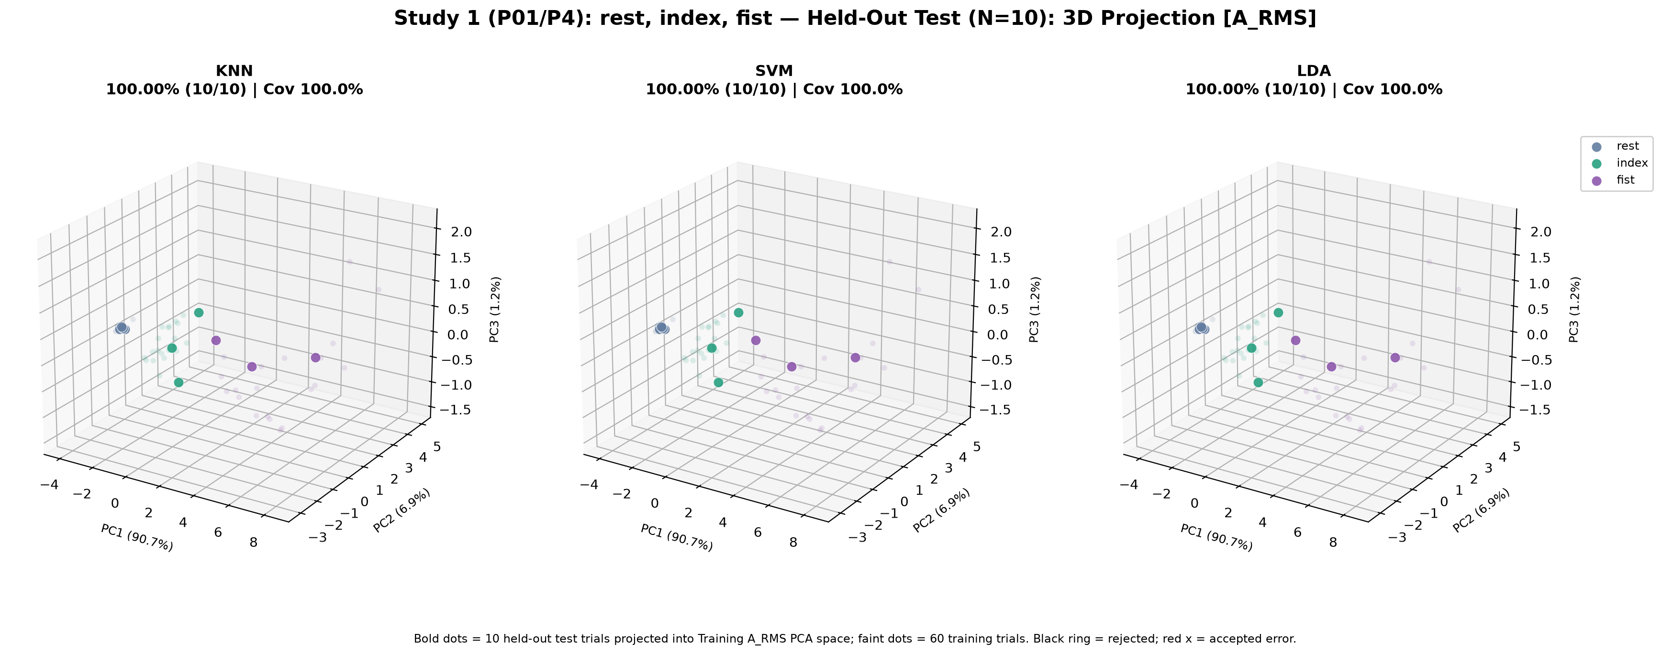
[picture p86: results/training_results/01_rest_index_fist/Study01_P01_P4_rest_index_fist_test_A_RMS_KNN_SVM_LDA_3D.png]


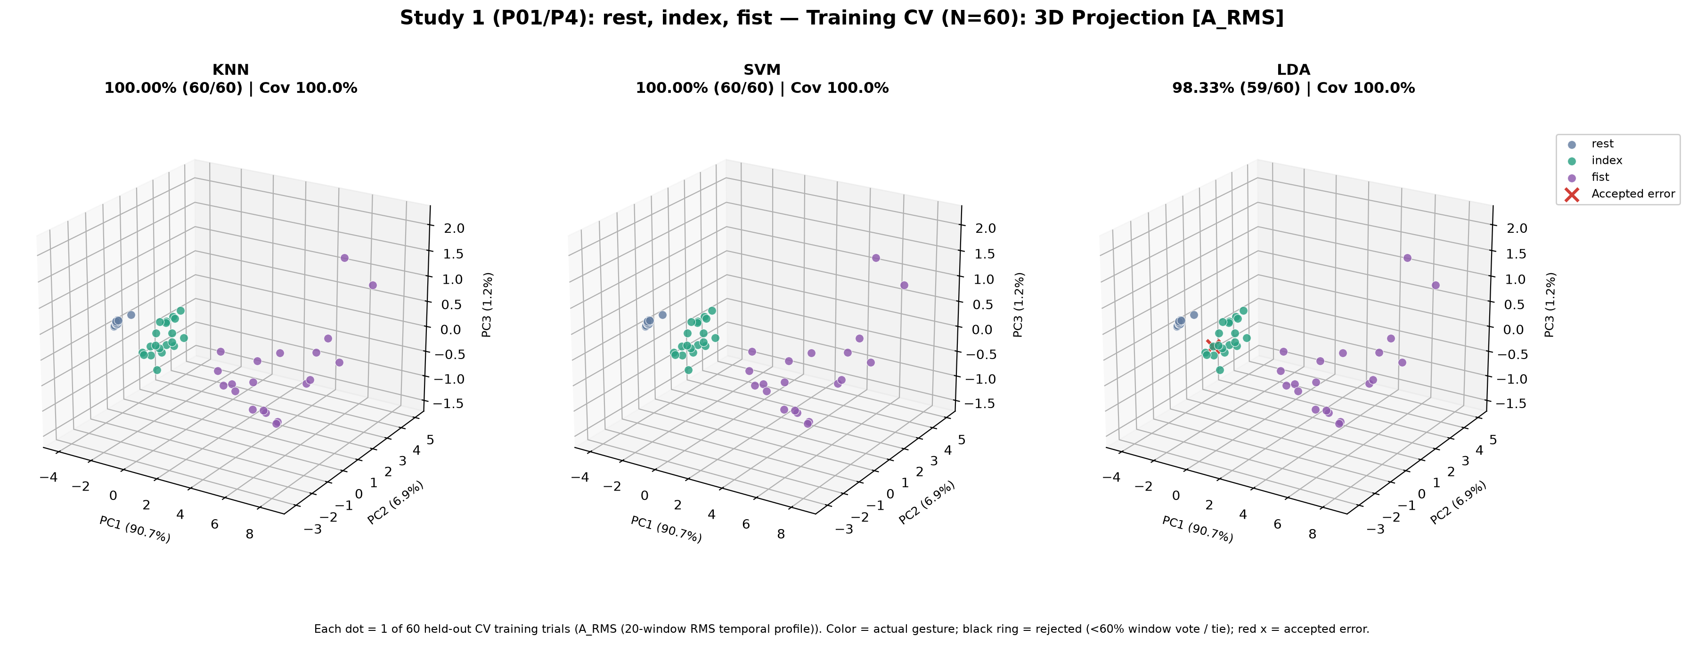
[picture p87: results/training_results/01_rest_index_fist/Study01_P01_P4_rest_index_fist_training_A_RMS_KNN_SVM_LDA_3D.png]


### Classifier Decision Boundary Gradient Heatmaps

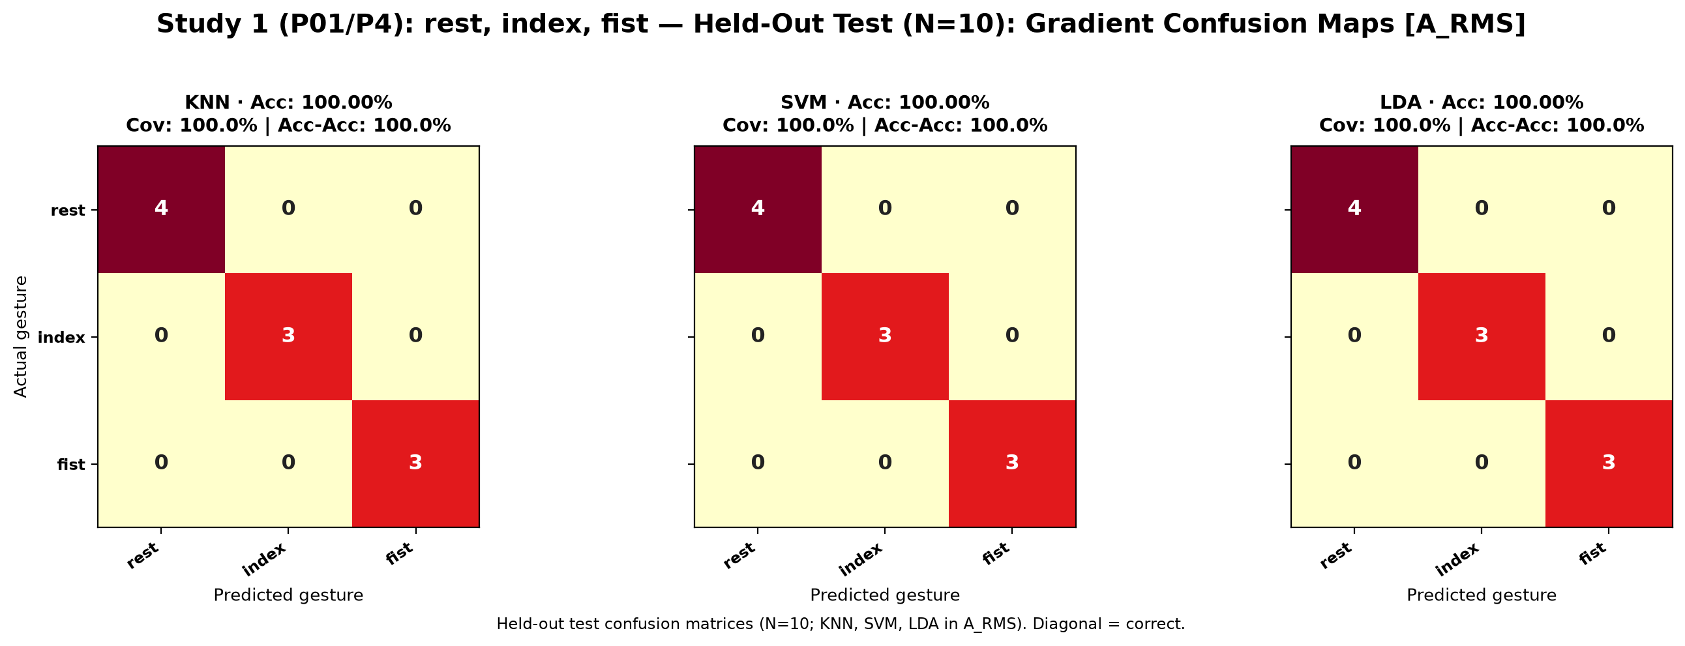
[picture p88: results/training_results/01_rest_index_fist/Study01_P01_P4_rest_index_fist_test_A_RMS_KNN_SVM_LDA_gradient_heatmaps.png]


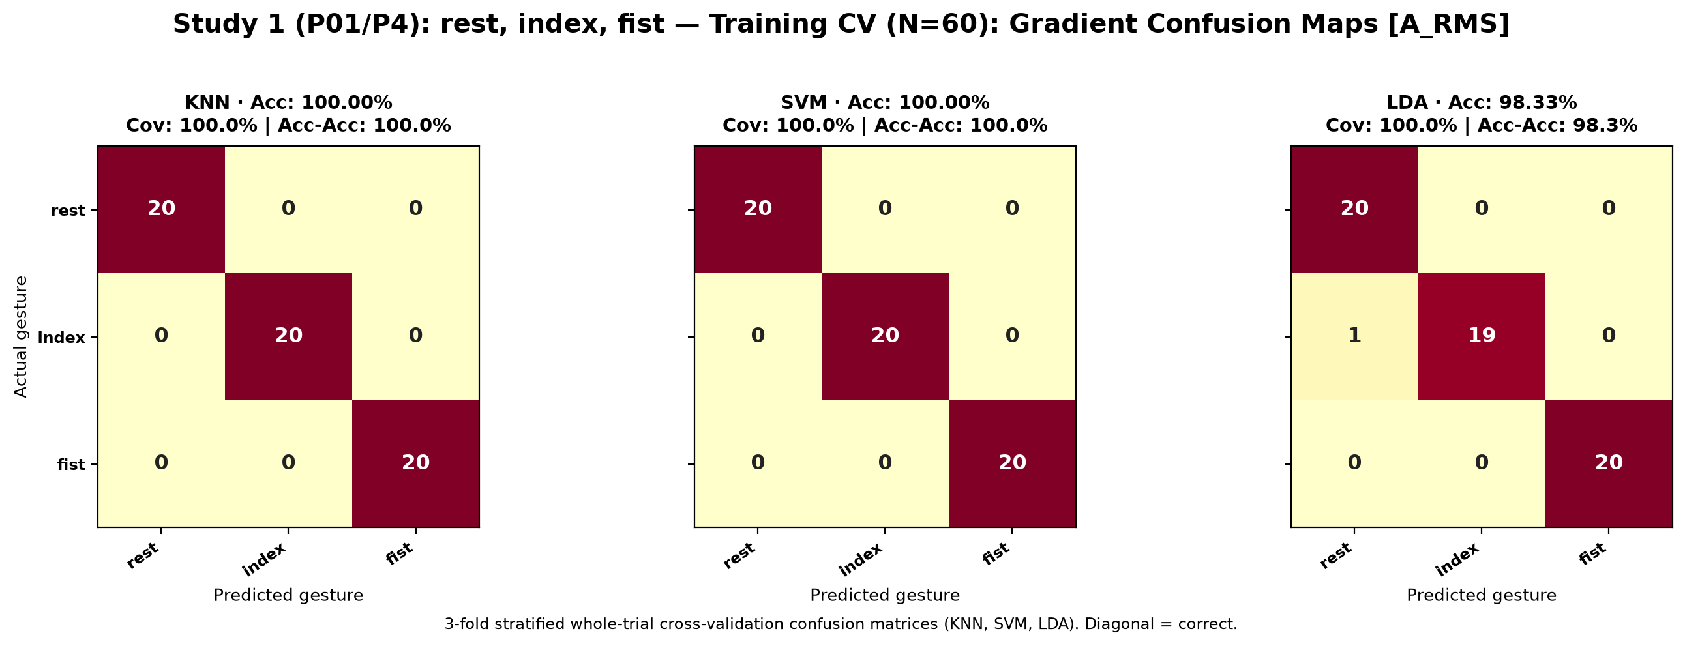
[picture p89: results/training_results/01_rest_index_fist/Study01_P01_P4_rest_index_fist_training_A_RMS_KNN_SVM_LDA_gradient_heatmaps.png]
