PrithviBhende/emg-teleoperation-ros2/results/training_results/02_rest_middle_fist/README.md

# Study 2: rest, middle, fist (3 Gestures)

- **Subject**: P01
- **Electrode Placement**: P5
- **Champion / Evaluated Model**: `B_MAV__KNN`
- **3-Fold Cross-Validation Accuracy**: 100.00% (60/60)
- **Held-Out Test Accuracy**: 100.00% (10/10)

---

## Graphical Representations & Decision Boundaries

### 2D Feature Projections & Decision Boundaries

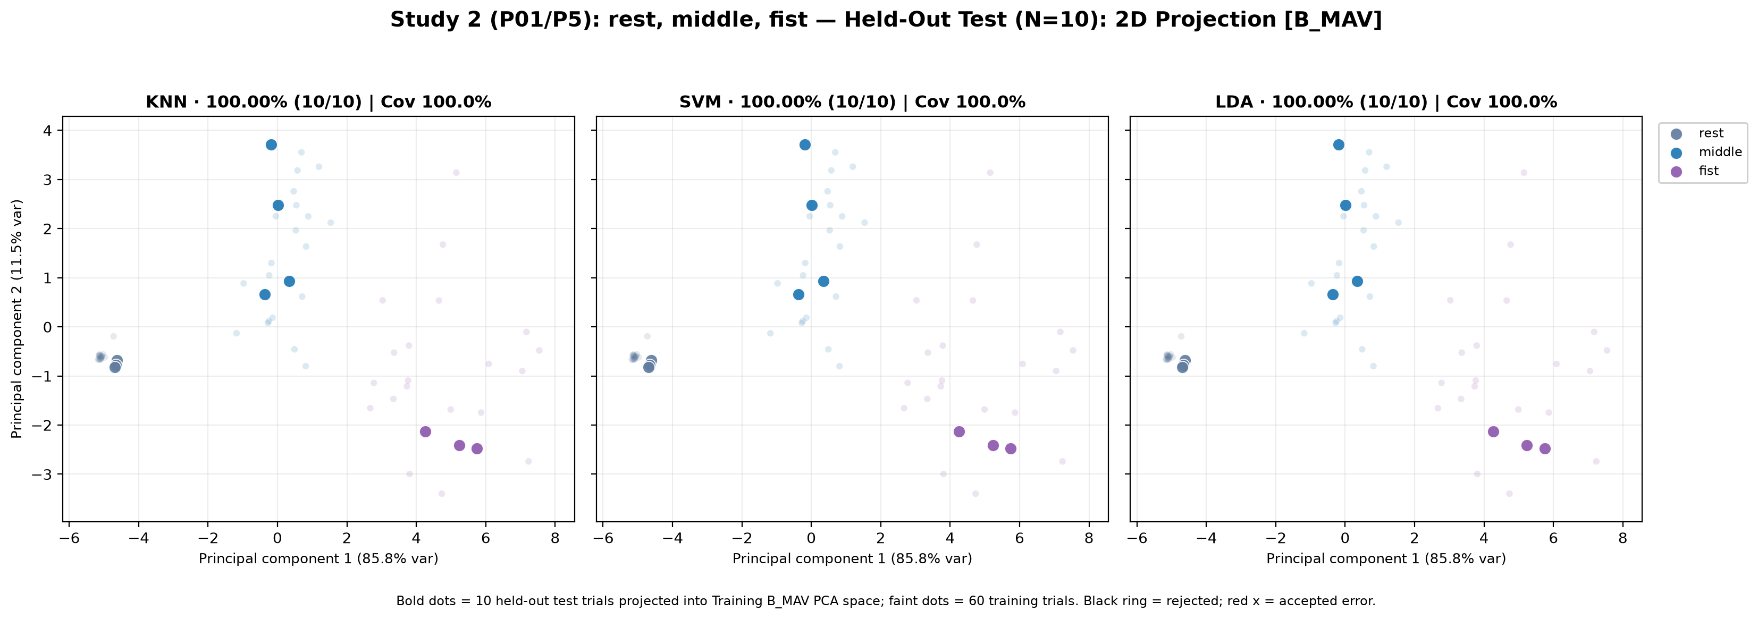
[picture p90: results/training_results/02_rest_middle_fist/Study02_P01_P5_rest_middle_fist_test_B_MAV_KNN_SVM_LDA_2D.png]


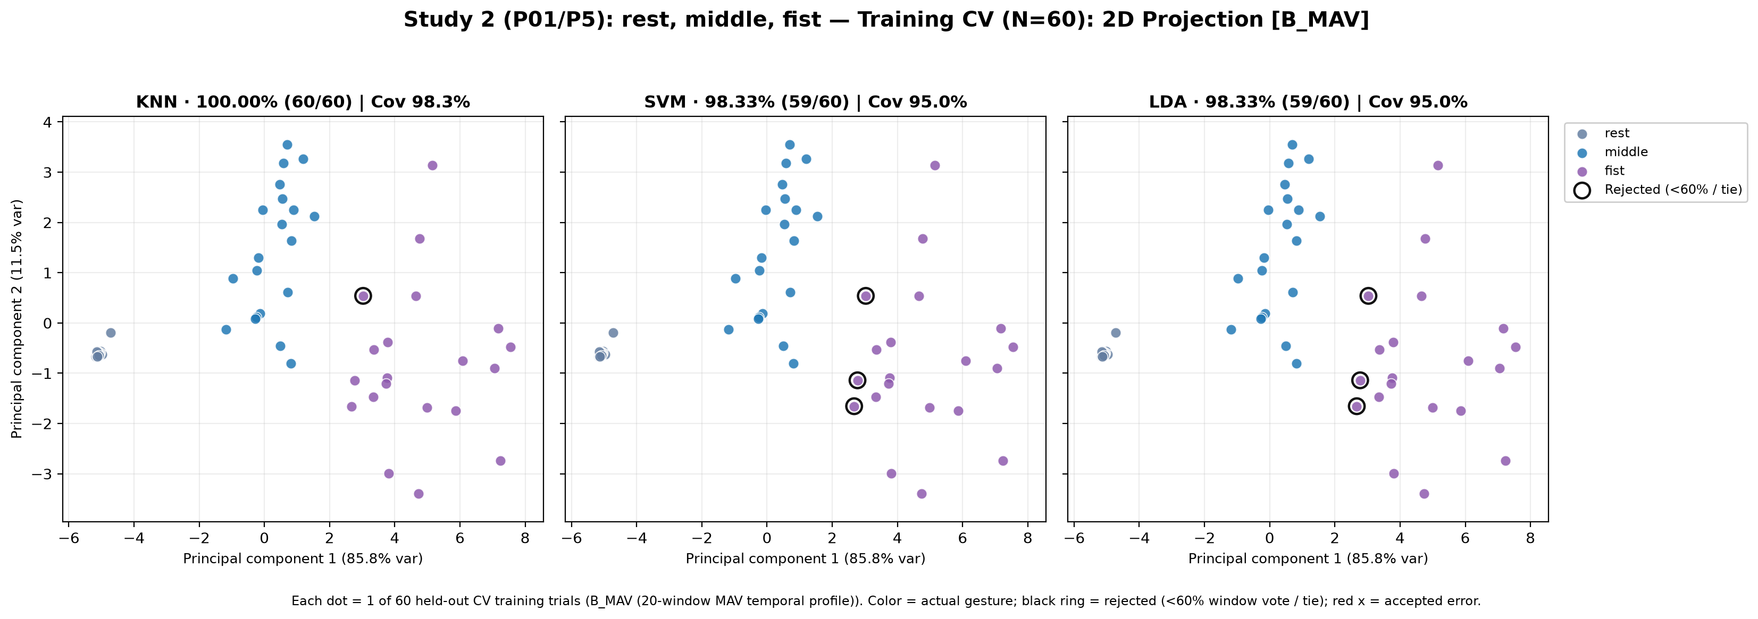
[picture p91: results/training_results/02_rest_middle_fist/Study02_P01_P5_rest_middle_fist_training_B_MAV_KNN_SVM_LDA_2D.png]


### 3D Feature Projections & Decision Boundaries

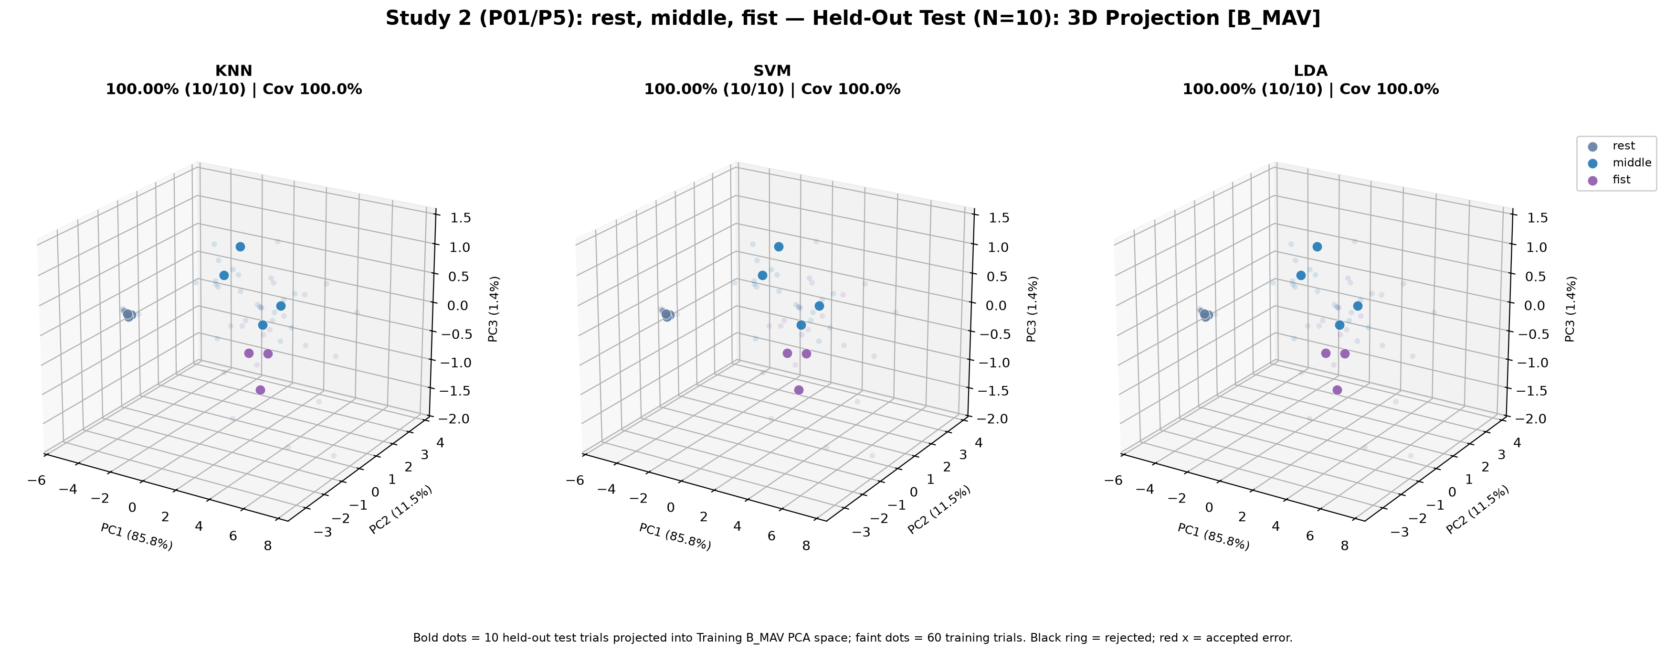
[picture p92: results/training_results/02_rest_middle_fist/Study02_P01_P5_rest_middle_fist_test_B_MAV_KNN_SVM_LDA_3D.png]


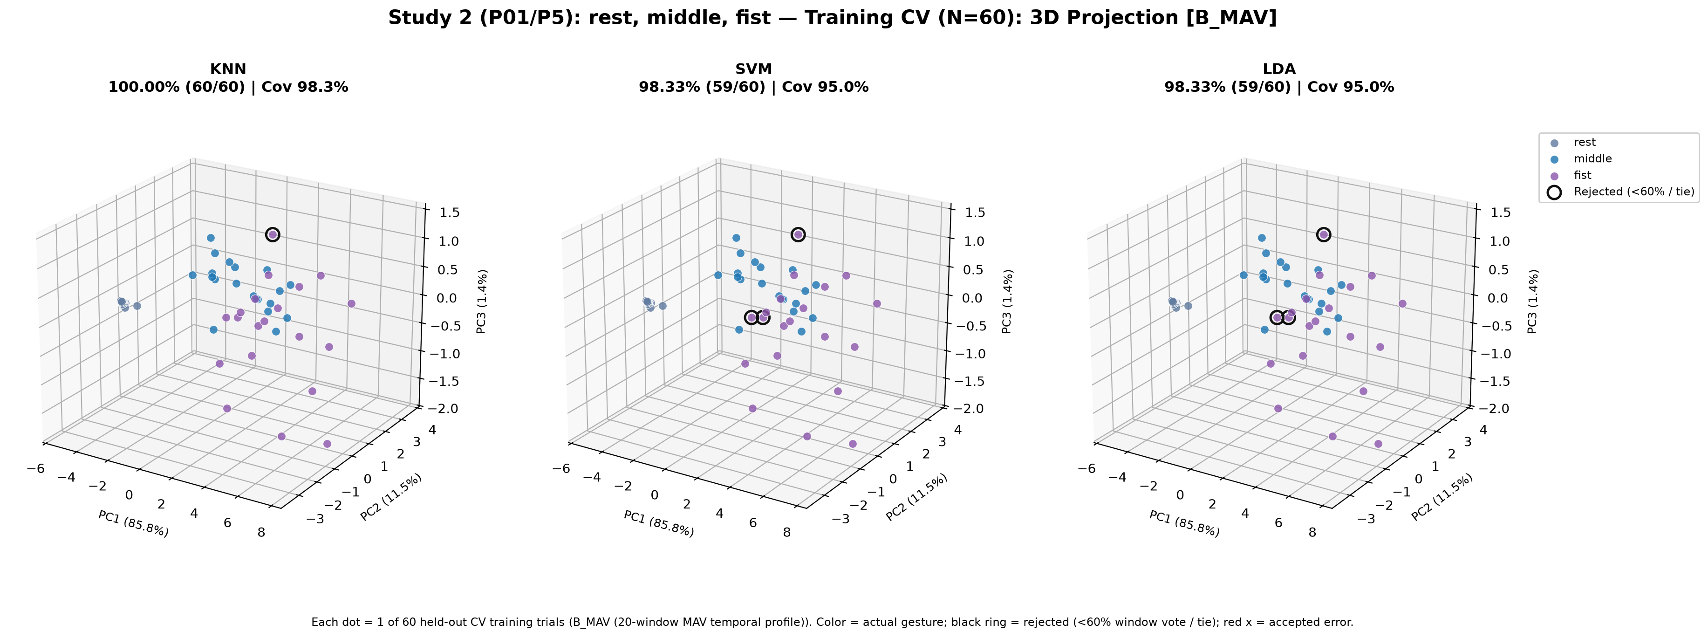
[picture p93: results/training_results/02_rest_middle_fist/Study02_P01_P5_rest_middle_fist_training_B_MAV_KNN_SVM_LDA_3D.png]


### Classifier Decision Boundary Gradient Heatmaps

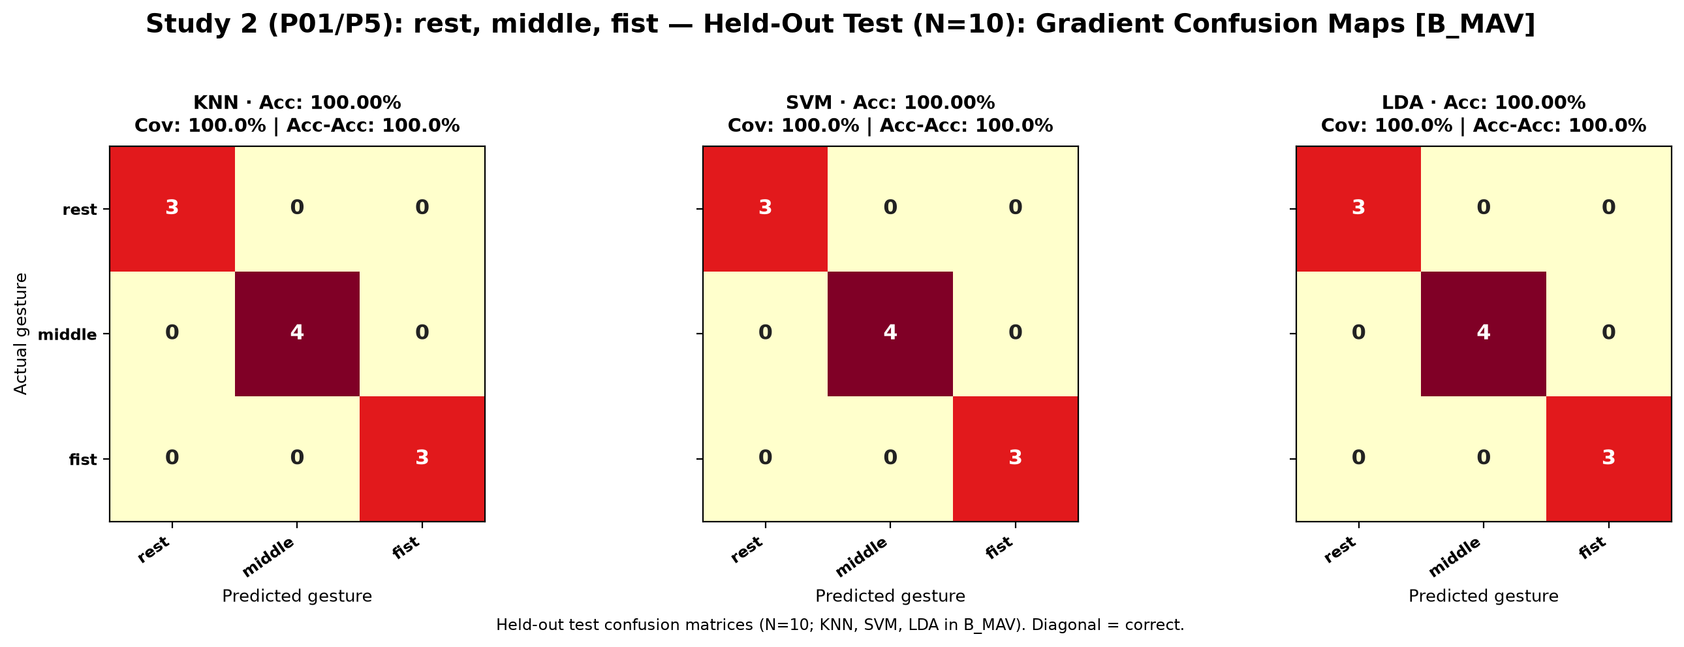
[picture p94: results/training_results/02_rest_middle_fist/Study02_P01_P5_rest_middle_fist_test_B_MAV_KNN_SVM_LDA_gradient_heatmaps.png]


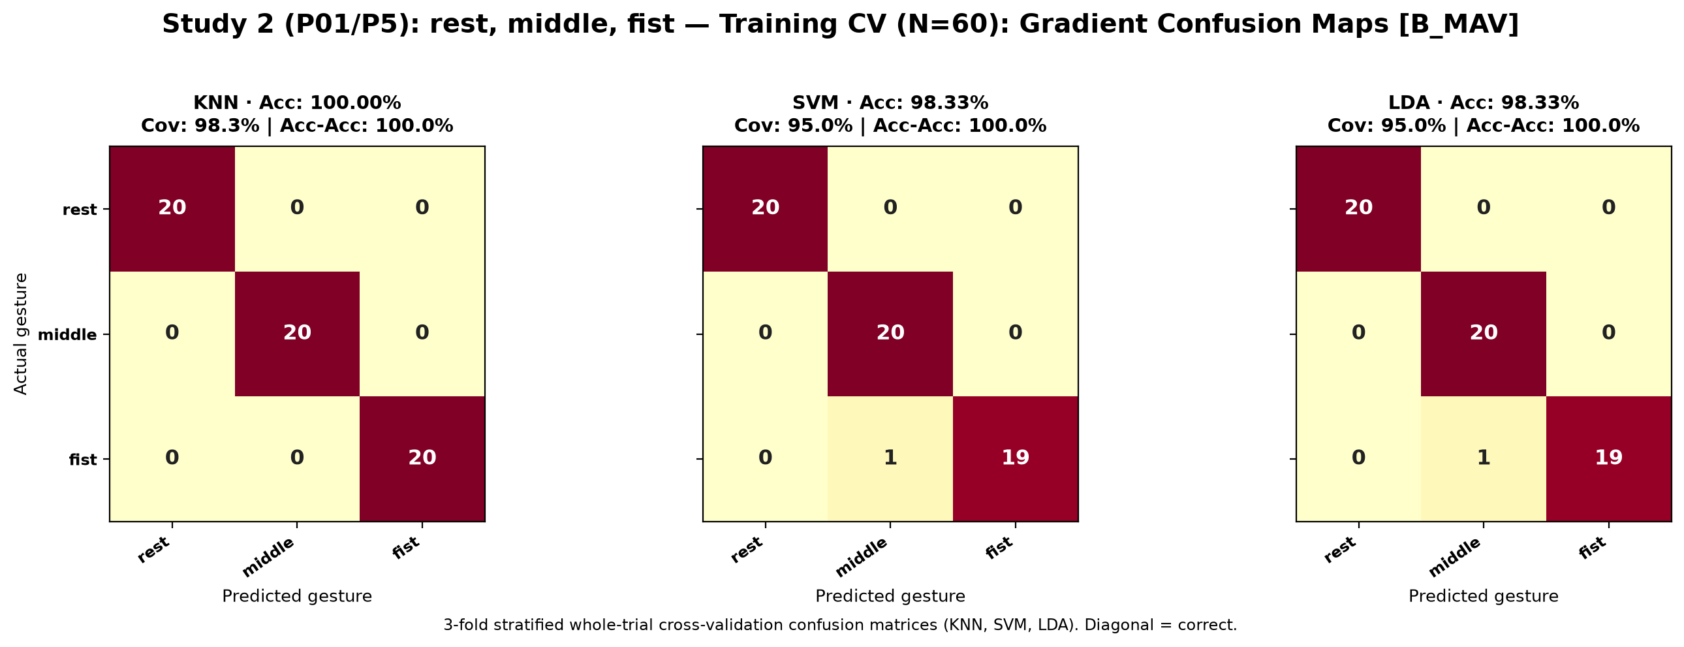
[picture p95: results/training_results/02_rest_middle_fist/Study02_P01_P5_rest_middle_fist_training_B_MAV_KNN_SVM_LDA_gradient_heatmaps.png]
