PrithviBhende/emg-teleoperation-ros2/results/training_results/03_ring_little/README.md

# Study 3: ring, little (2 Hard Adjacent Gestures)

- **Subject**: P01
- **Electrode Placement**: P7 / ring-little
- **Champion / Evaluated Model**: `C_WL__KNN (Selected) / F_MAV_MAX_MIN__SVM (Best Test)`
- **3-Fold Cross-Validation Accuracy**: 70.00% (28/40)
- **Held-Out Test Accuracy**: 50.00% (Selected) / 68.75% (Best Test)

---

## Graphical Representations & Decision Boundaries

### 2D Feature Projections & Decision Boundaries

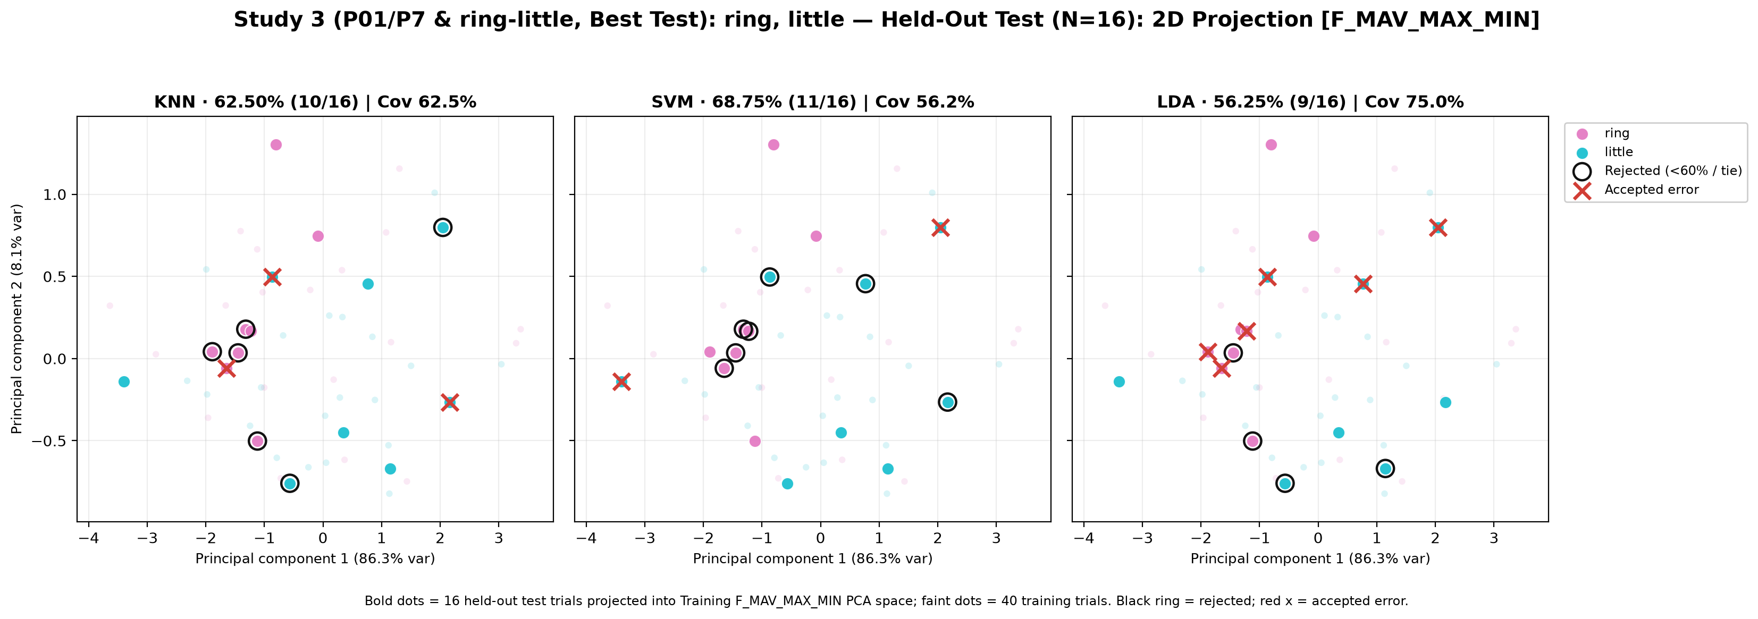
[picture p96: results/training_results/03_ring_little/Study03_P01_P7_ring_little_test_best_F_MAV_MAX_MIN_KNN_SVM_LDA_2D.png]


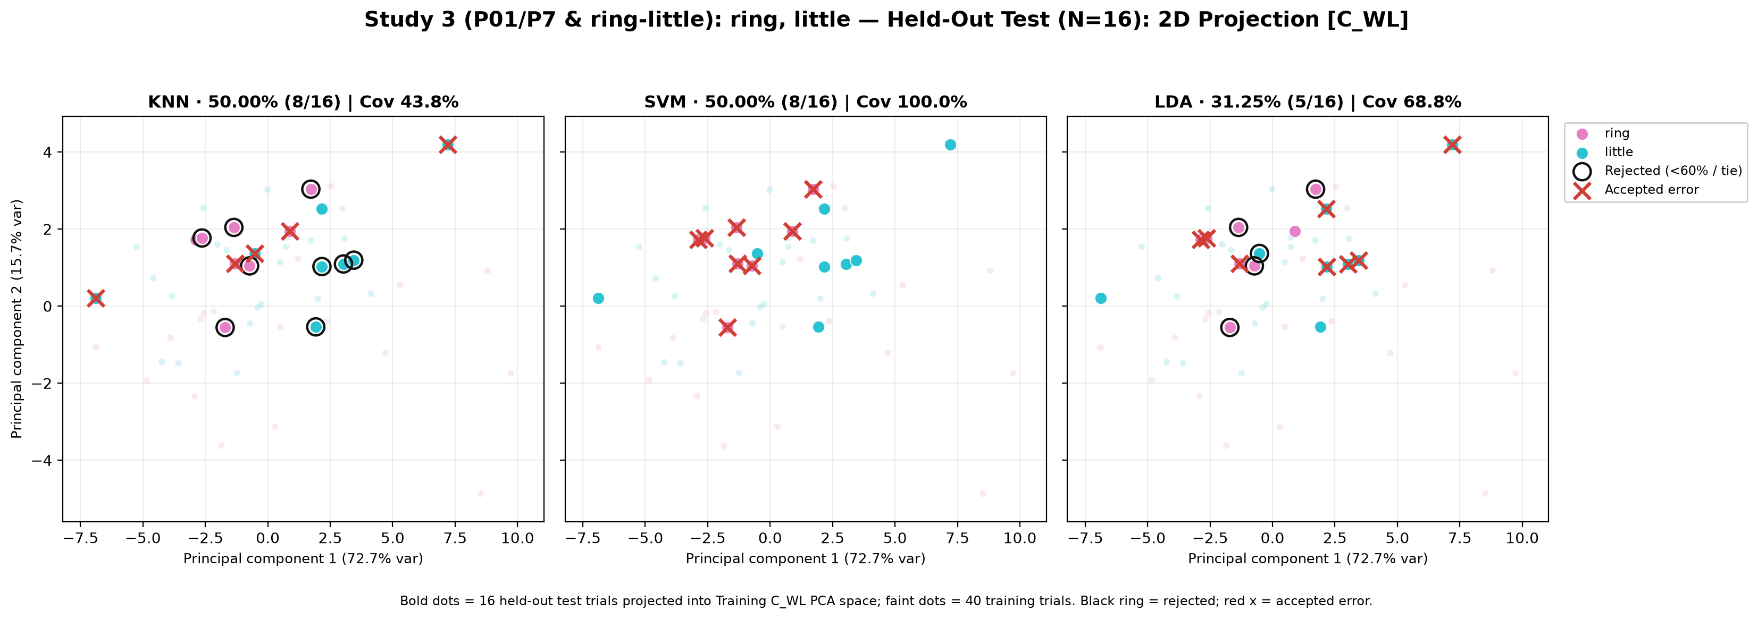
[picture p97: results/training_results/03_ring_little/Study03_P01_P7_ring_little_test_C_WL_KNN_SVM_LDA_2D.png]


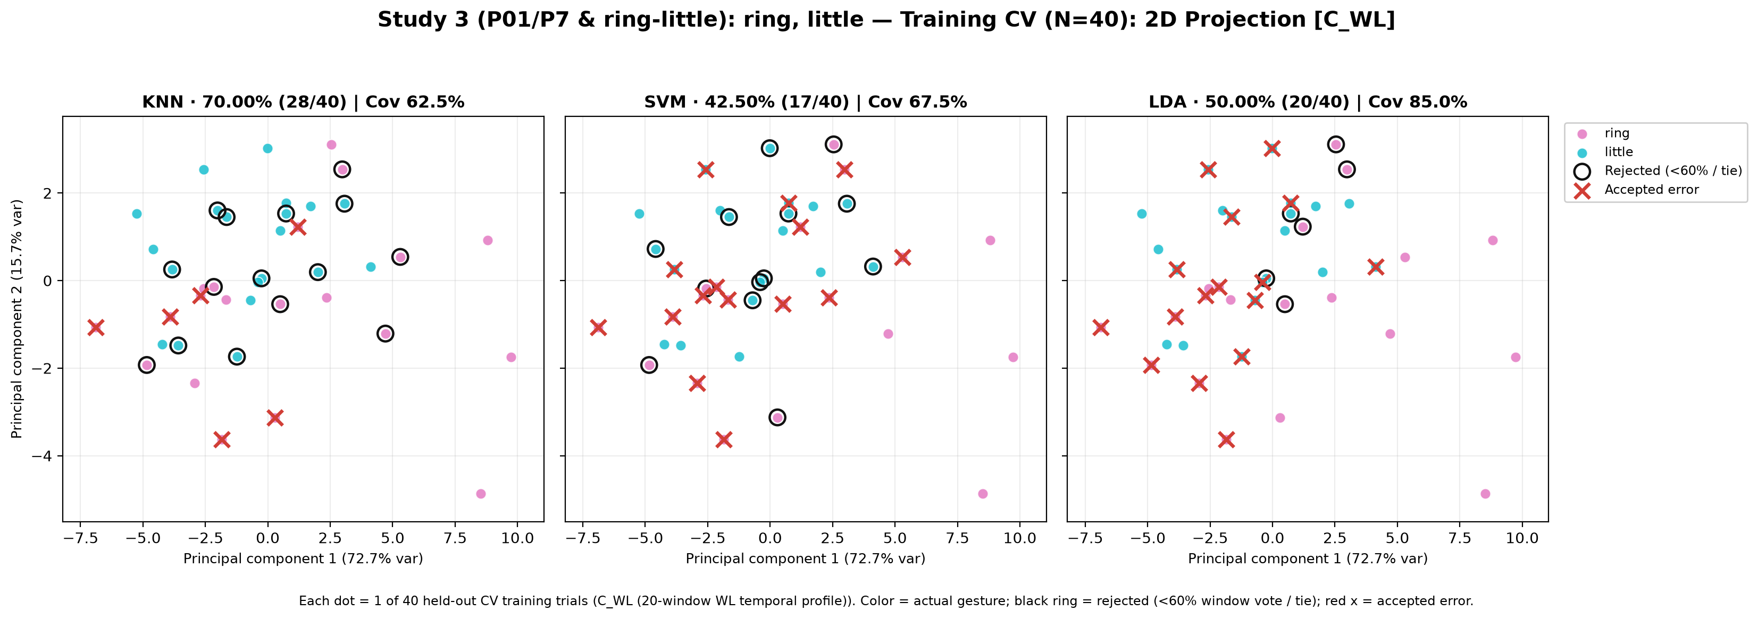
[picture p98: results/training_results/03_ring_little/Study03_P01_P7_ring_little_training_C_WL_KNN_SVM_LDA_2D.png]


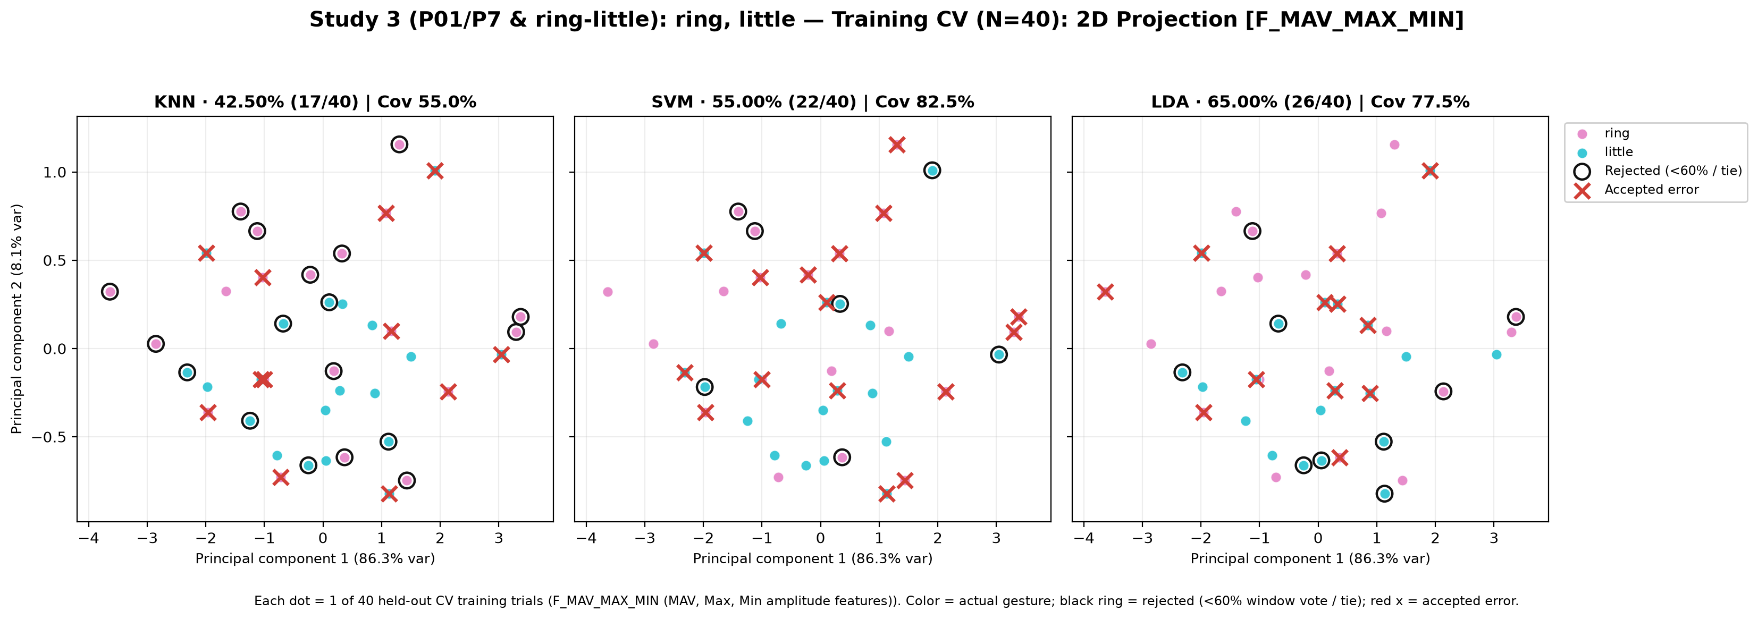
[picture p99: results/training_results/03_ring_little/Study03_P01_P7_ring_little_training_F_MAV_MAX_MIN_KNN_SVM_LDA_2D.png]


### 3D Feature Projections & Decision Boundaries

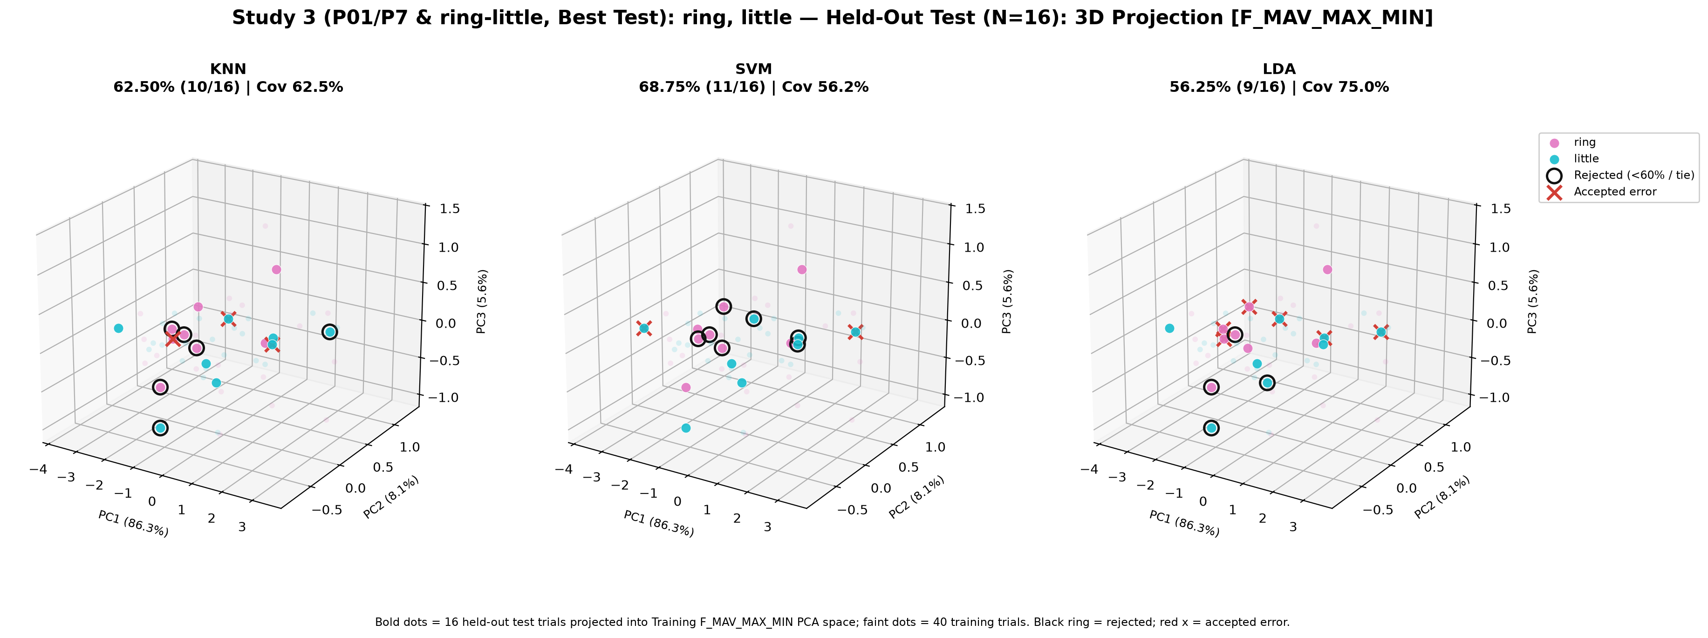
[picture p100: results/training_results/03_ring_little/Study03_P01_P7_ring_little_test_best_F_MAV_MAX_MIN_KNN_SVM_LDA_3D.png]


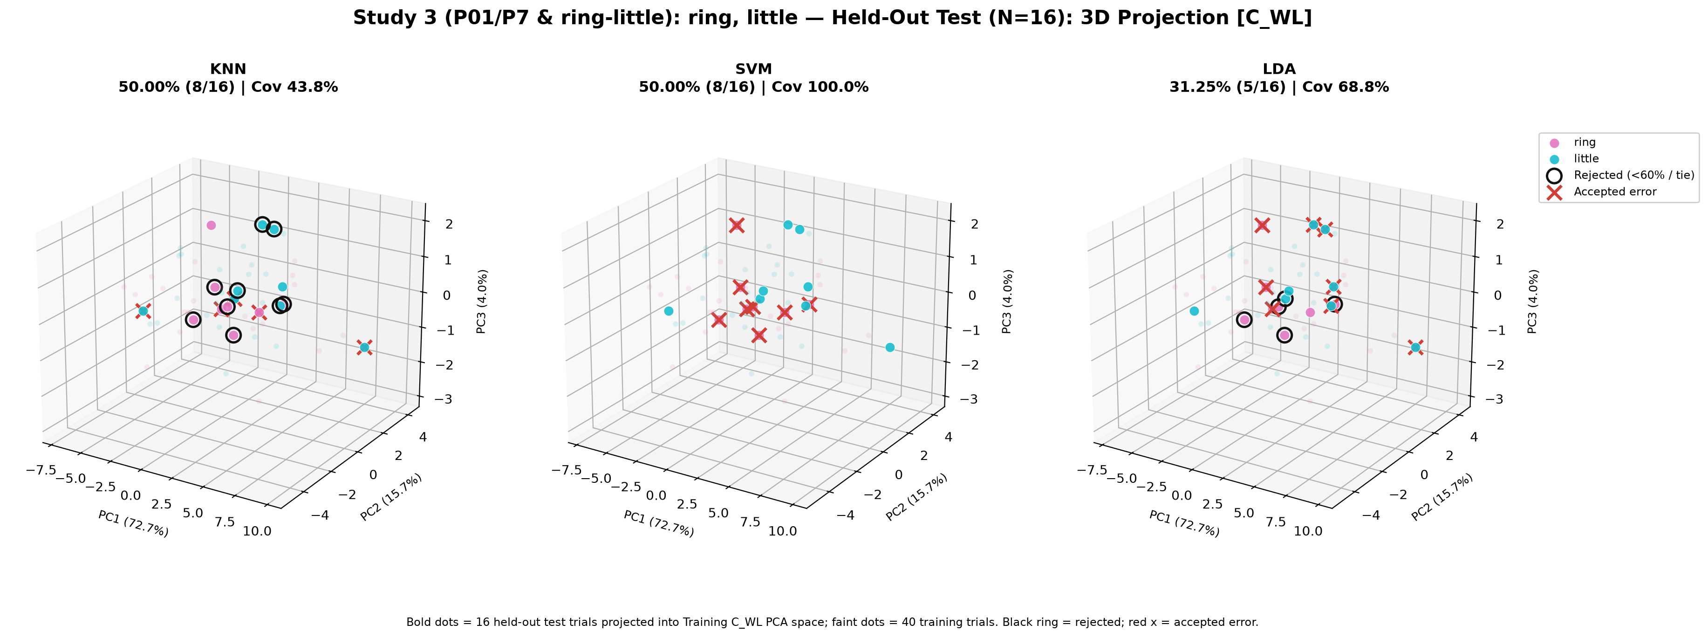
[picture p101: results/training_results/03_ring_little/Study03_P01_P7_ring_little_test_C_WL_KNN_SVM_LDA_3D.png]


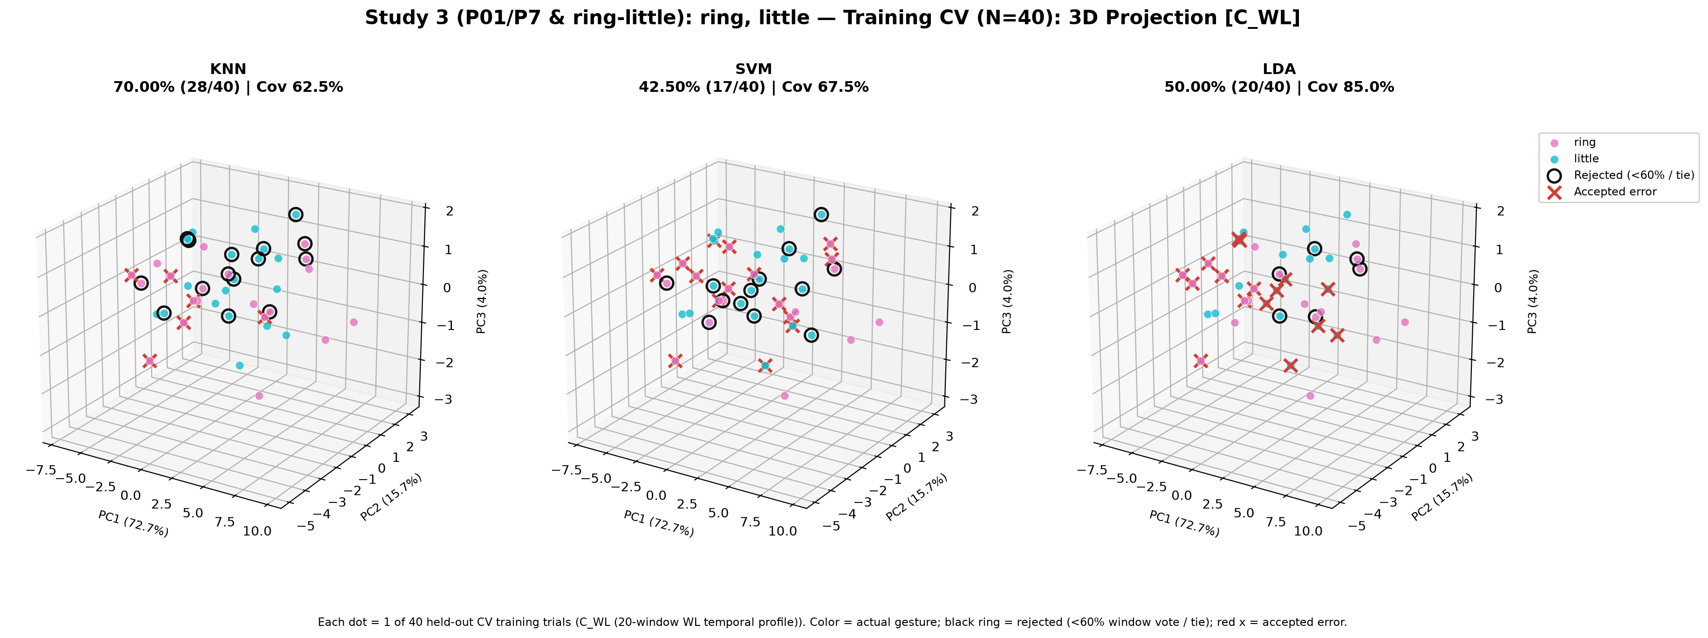
[picture p102: results/training_results/03_ring_little/Study03_P01_P7_ring_little_training_C_WL_KNN_SVM_LDA_3D.png]


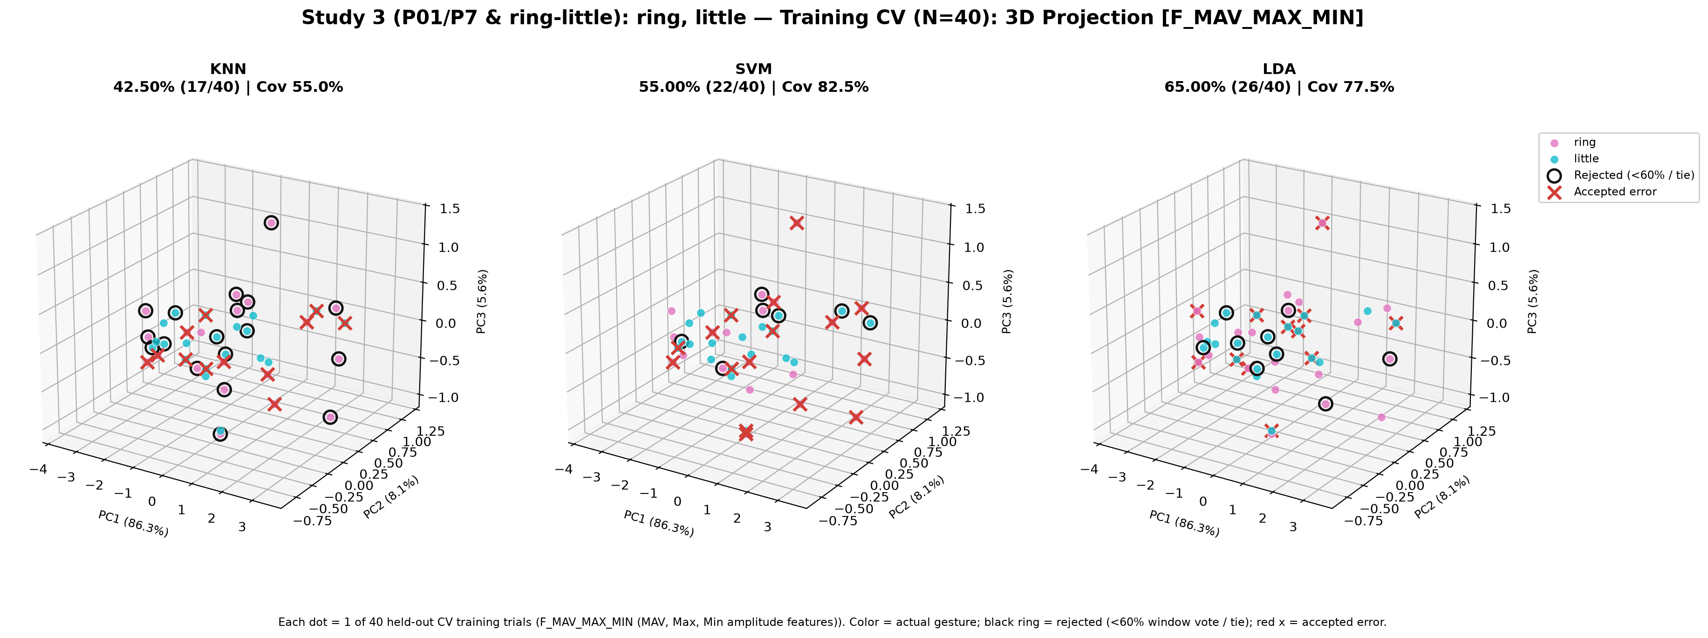
[picture p103: results/training_results/03_ring_little/Study03_P01_P7_ring_little_training_F_MAV_MAX_MIN_KNN_SVM_LDA_3D.png]


### Classifier Decision Boundary Gradient Heatmaps

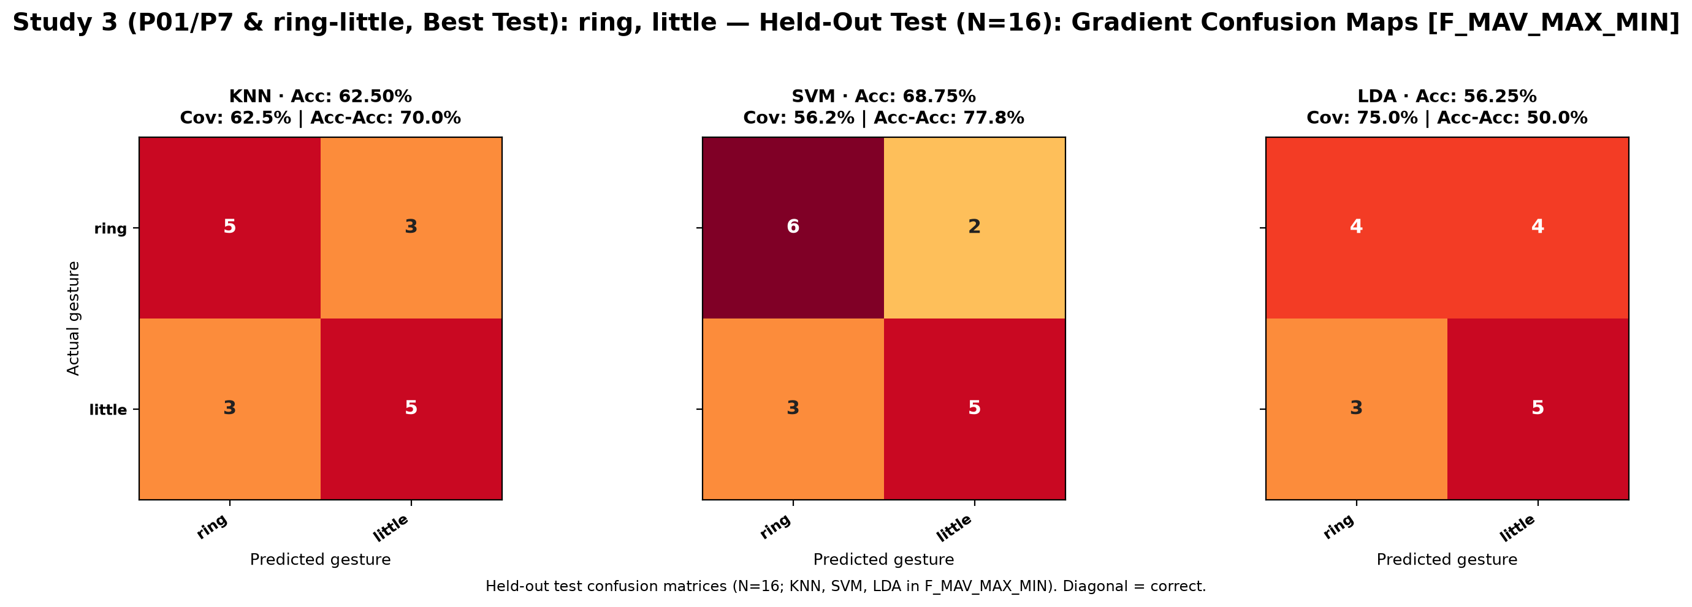
[picture p104: results/training_results/03_ring_little/Study03_P01_P7_ring_little_test_best_F_MAV_MAX_MIN_KNN_SVM_LDA_gradient_heatmaps.png]


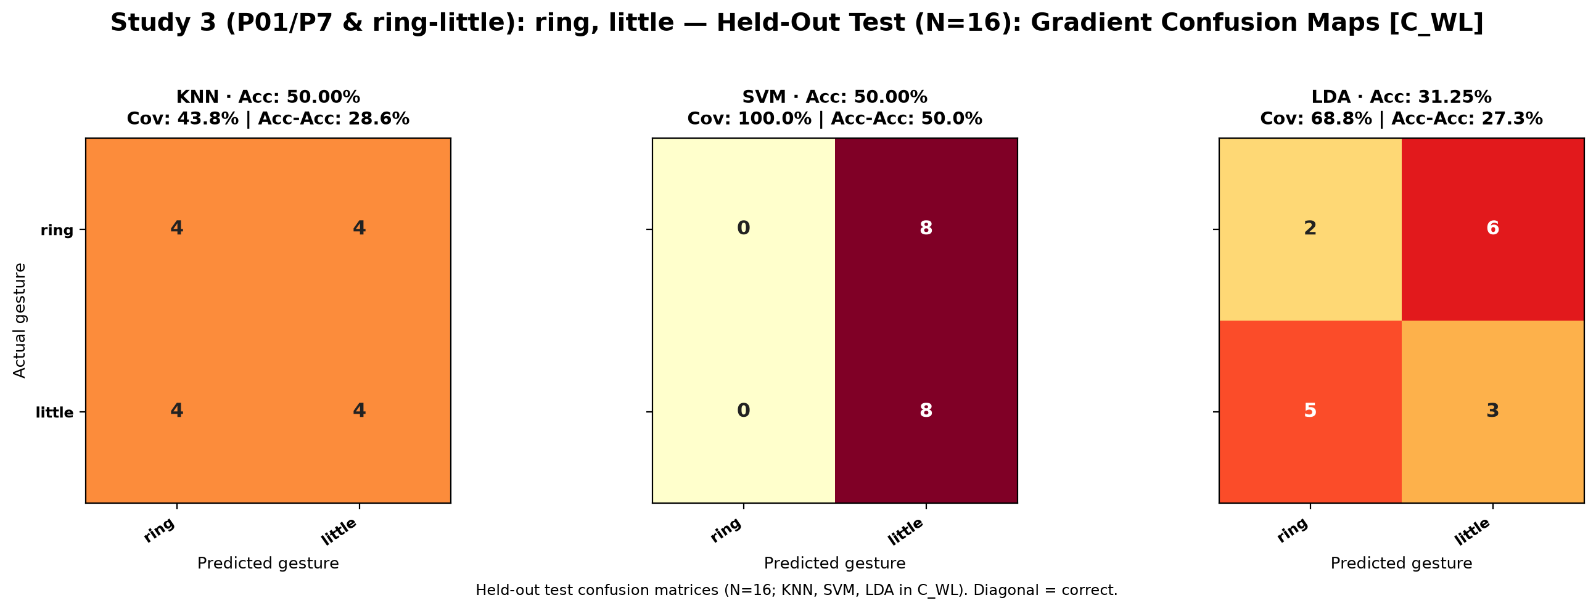
[picture p105: results/training_results/03_ring_little/Study03_P01_P7_ring_little_test_C_WL_KNN_SVM_LDA_gradient_heatmaps.png]


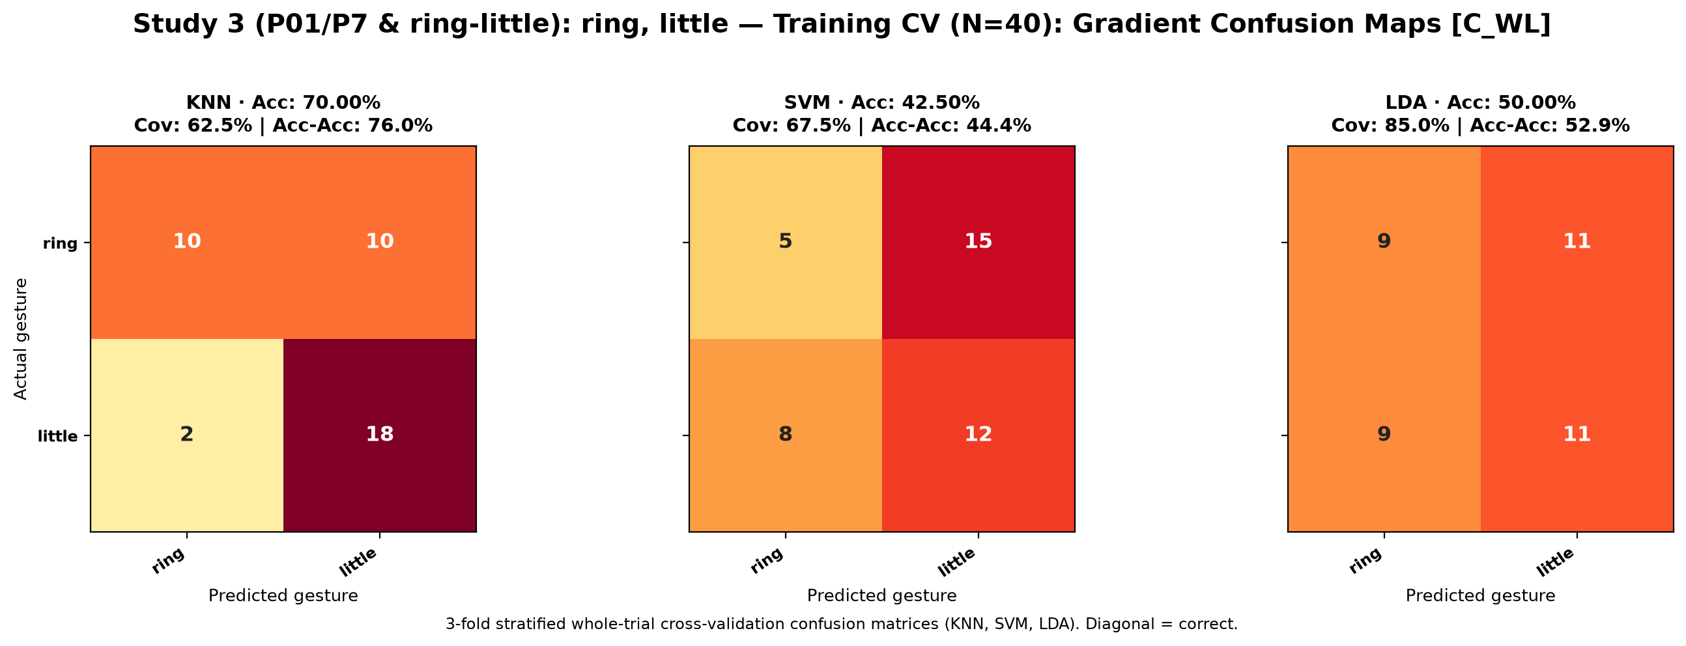
[picture p106: results/training_results/03_ring_little/Study03_P01_P7_ring_little_training_C_WL_KNN_SVM_LDA_gradient_heatmaps.png]


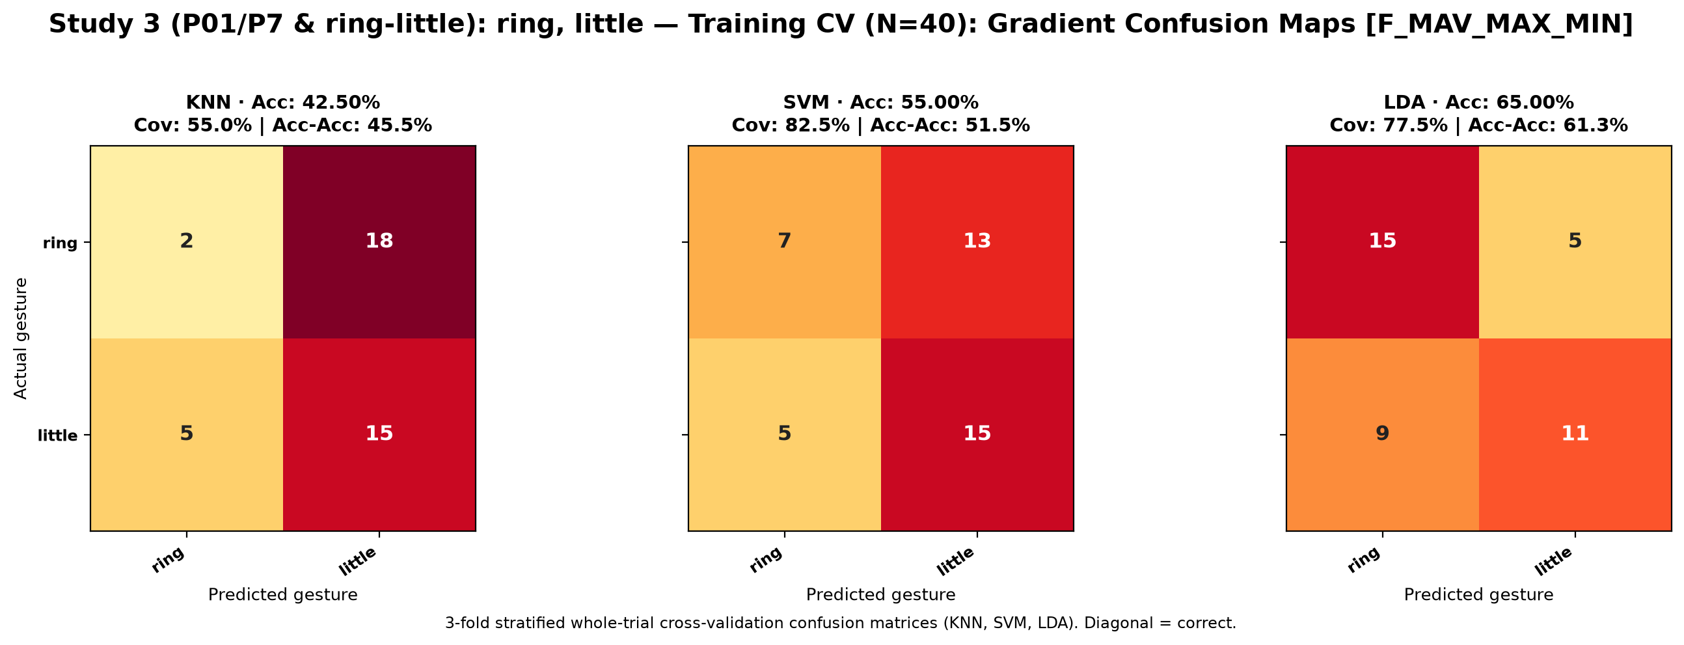
[picture p107: results/training_results/03_ring_little/Study03_P01_P7_ring_little_training_F_MAV_MAX_MIN_KNN_SVM_LDA_gradient_heatmaps.png]
