PrithviBhende/emg-teleoperation-ros2/results/training_results/04_middle_ring_little/README.md

# Study 4: middle, ring, little (3 Adjacent Central/Ulnar Digits)

- **Subject**: P01
- **Electrode Placement**: P7
- **Champion / Evaluated Model**: `D_TD4__LDA (Selected) / G_TF8__KNN (Best Test)`
- **3-Fold Cross-Validation Accuracy**: 76.67% (46/60)
- **Held-Out Test Accuracy**: 35.71% (Selected) / 92.86% (Best Test)

---

## Graphical Representations & Decision Boundaries

### 2D Feature Projections & Decision Boundaries

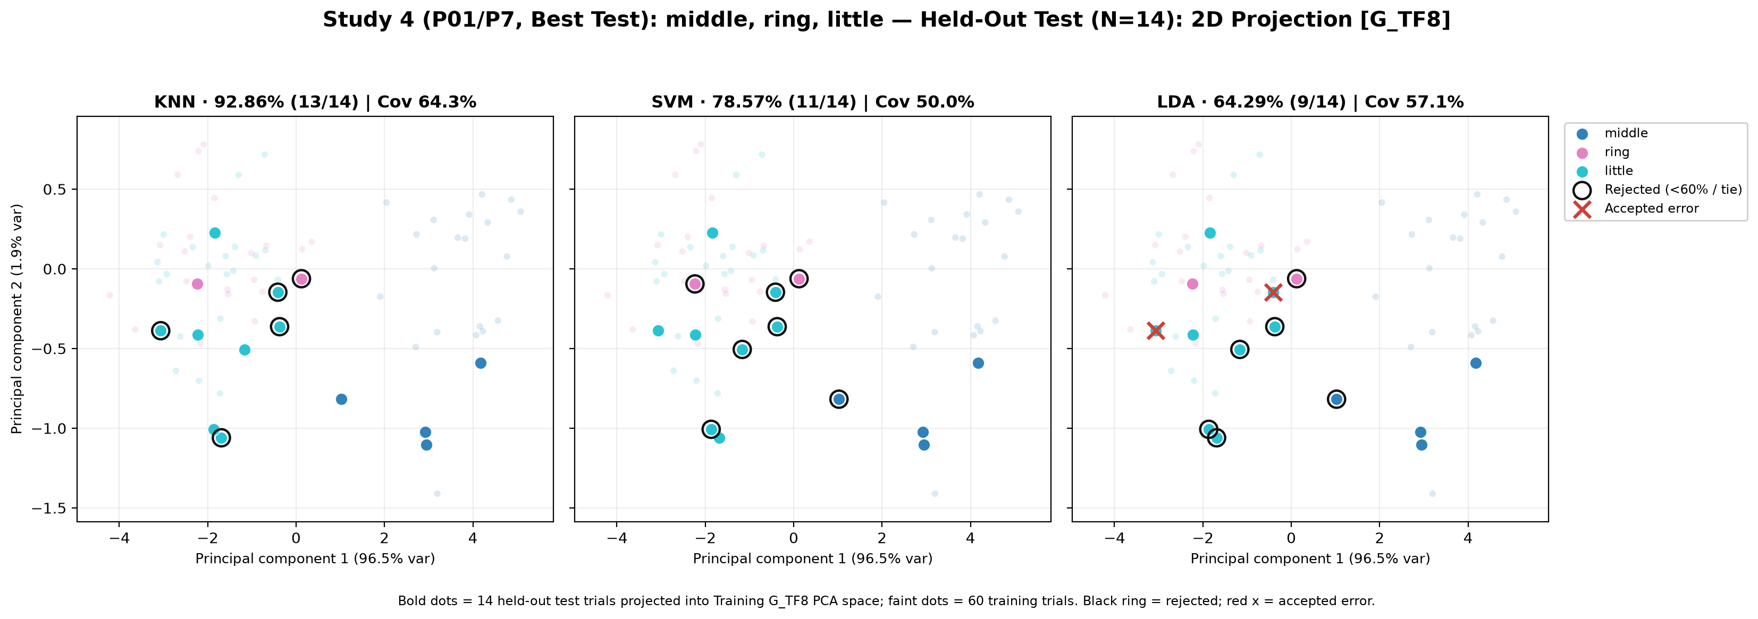
[picture p108: results/training_results/04_middle_ring_little/Study04_P01_P7_middle_ring_little_test_best_G_TF8_KNN_SVM_LDA_2D.png]


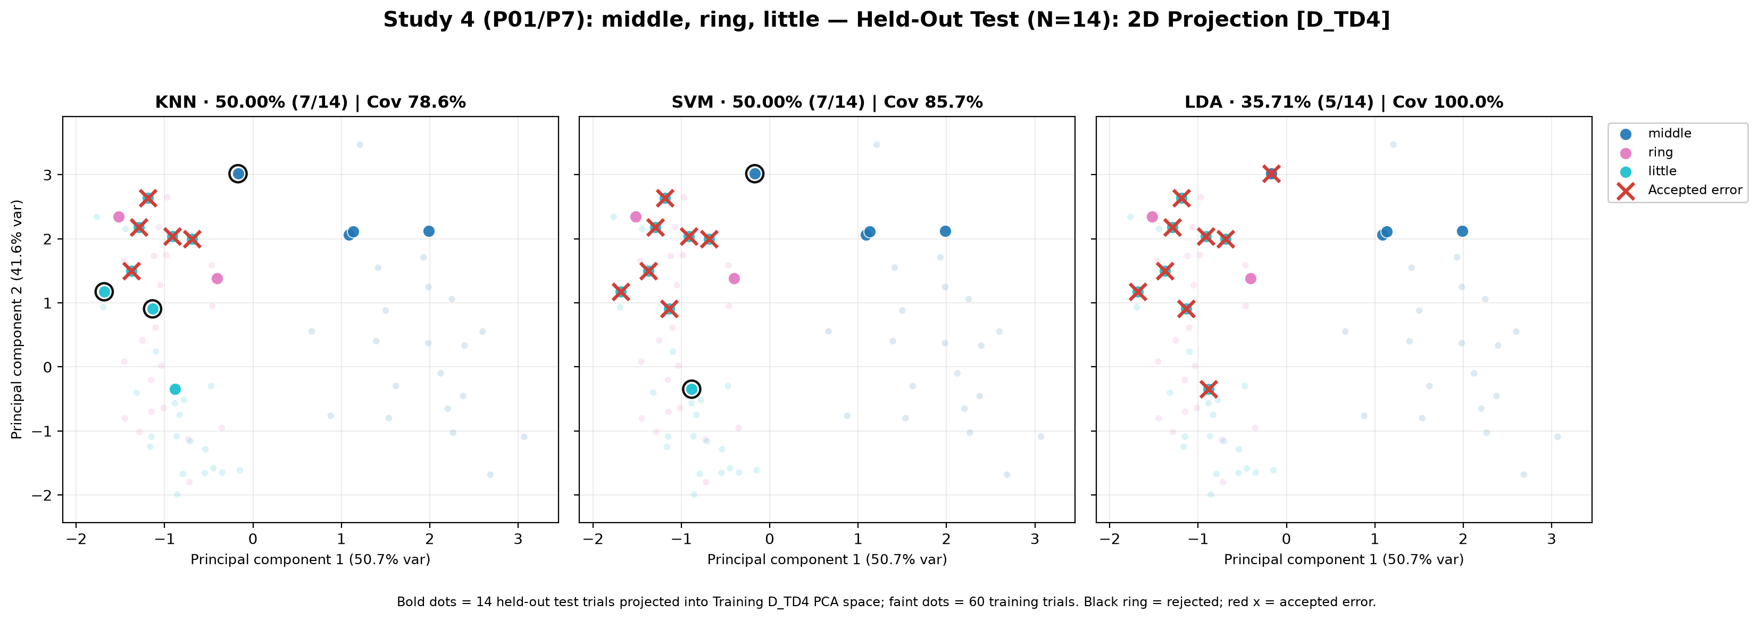
[picture p109: results/training_results/04_middle_ring_little/Study04_P01_P7_middle_ring_little_test_D_TD4_KNN_SVM_LDA_2D.png]


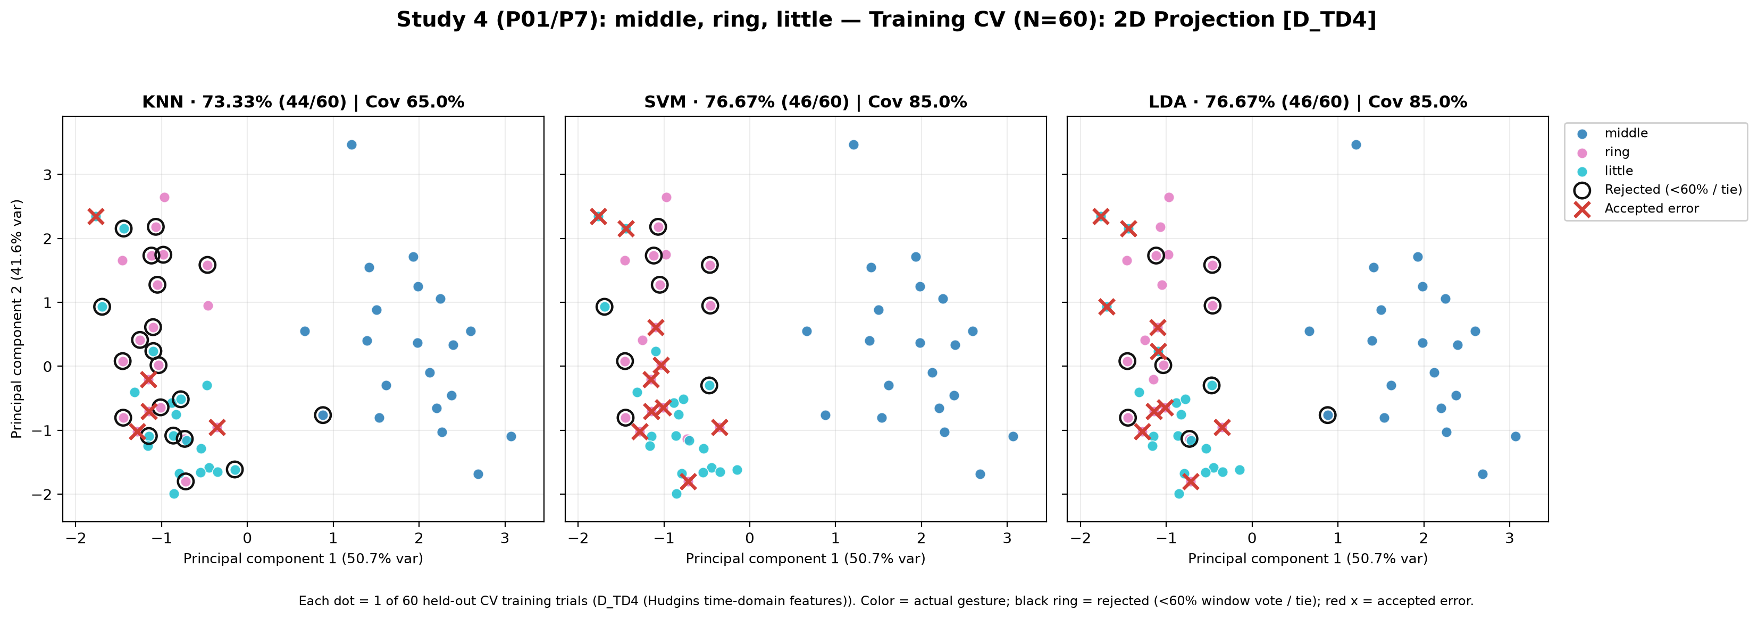
[picture p110: results/training_results/04_middle_ring_little/Study04_P01_P7_middle_ring_little_training_D_TD4_KNN_SVM_LDA_2D.png]


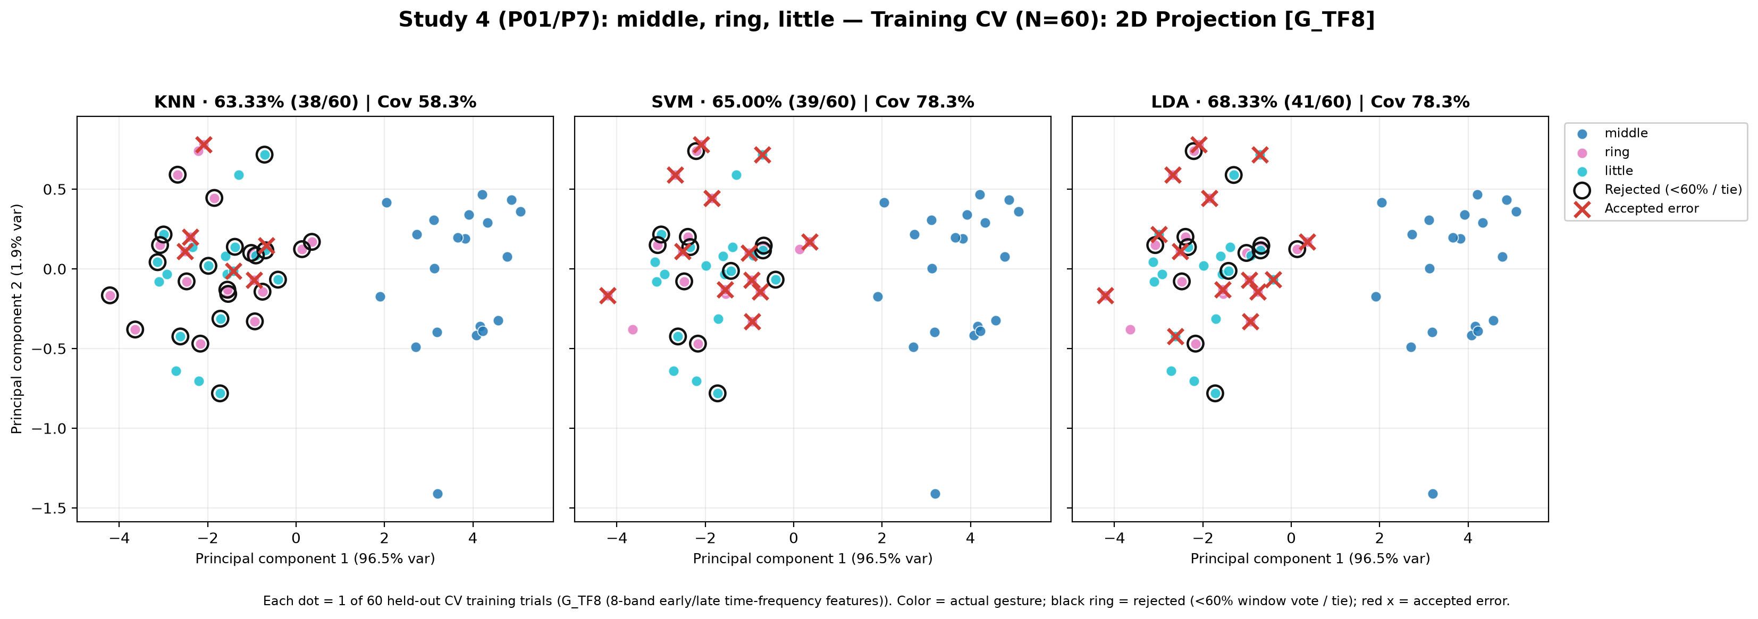
[picture p111: results/training_results/04_middle_ring_little/Study04_P01_P7_middle_ring_little_training_G_TF8_KNN_SVM_LDA_2D.png]


### 3D Feature Projections & Decision Boundaries

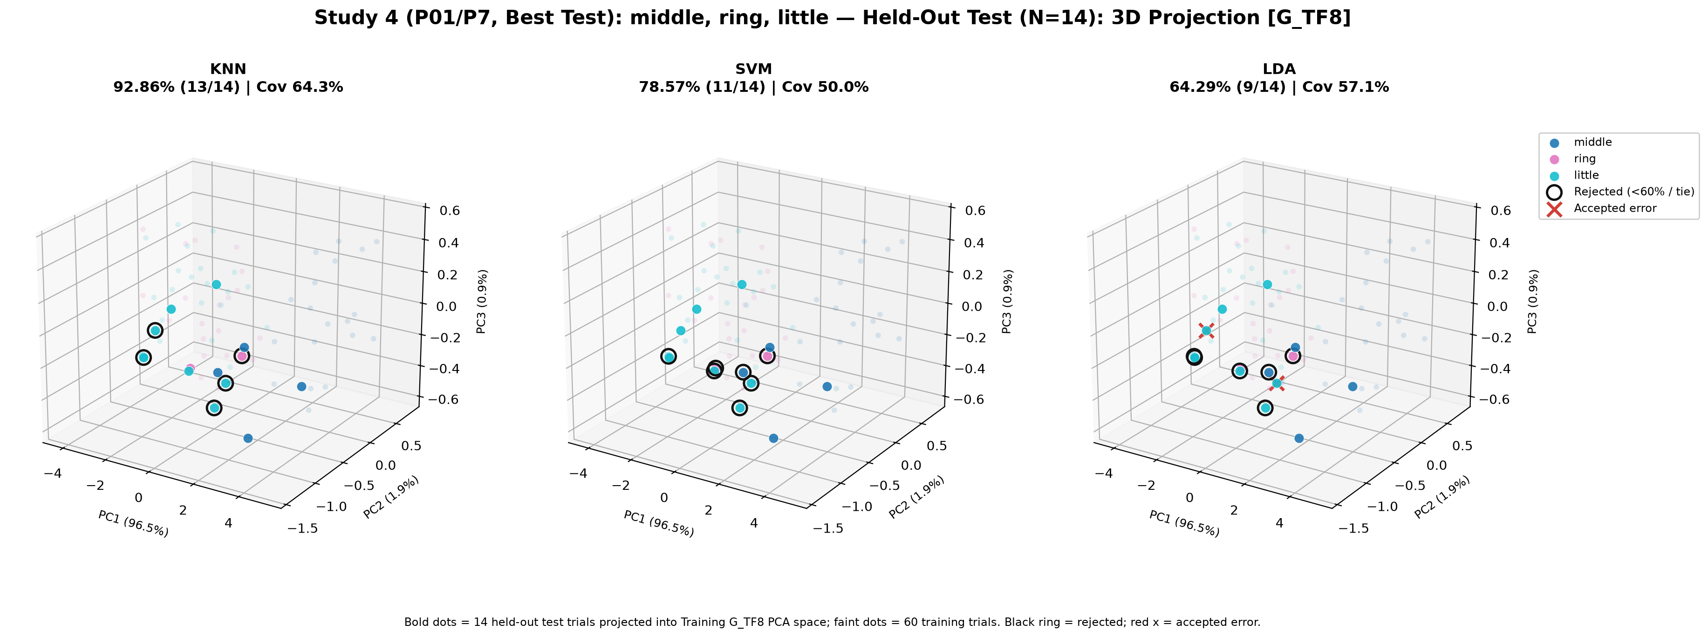
[picture p112: results/training_results/04_middle_ring_little/Study04_P01_P7_middle_ring_little_test_best_G_TF8_KNN_SVM_LDA_3D.png]


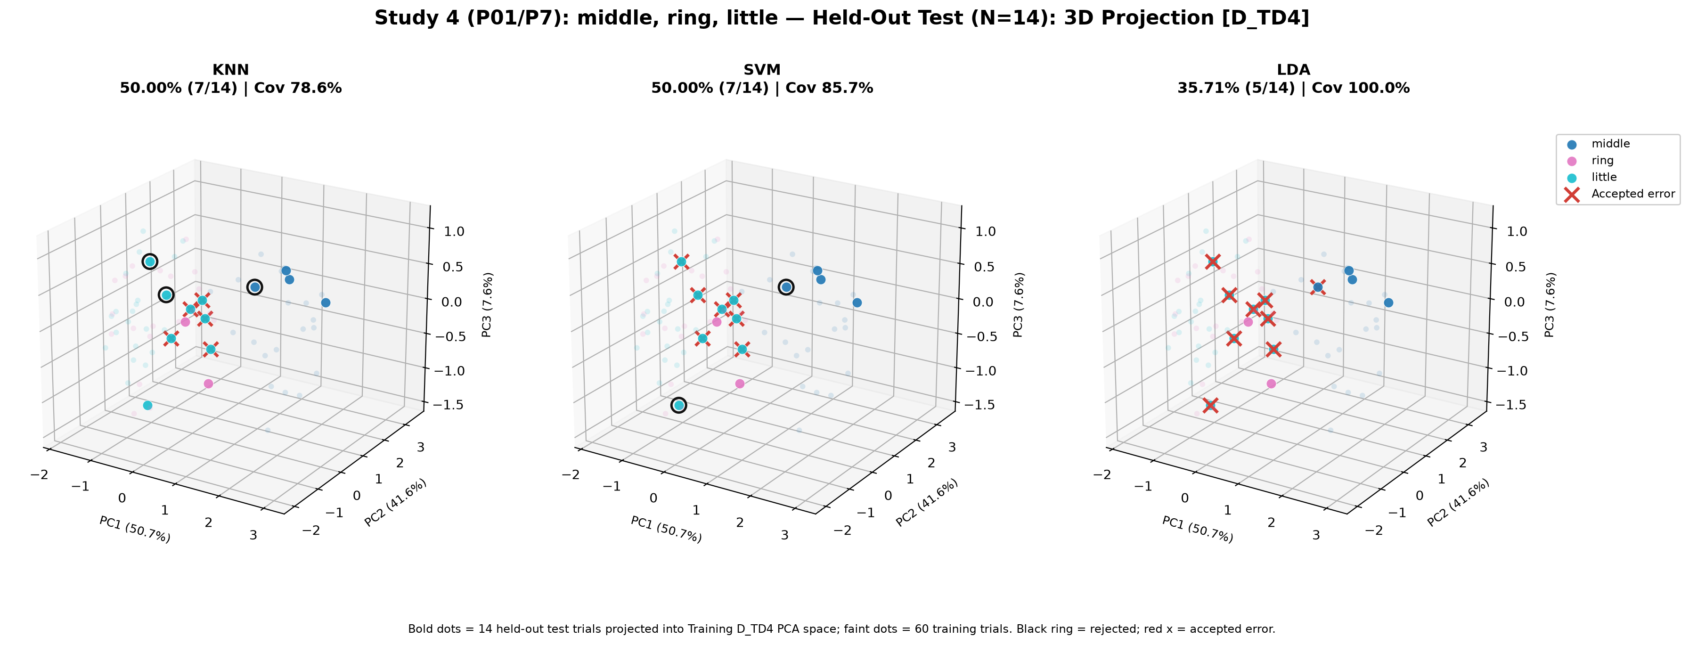
[picture p113: results/training_results/04_middle_ring_little/Study04_P01_P7_middle_ring_little_test_D_TD4_KNN_SVM_LDA_3D.png]


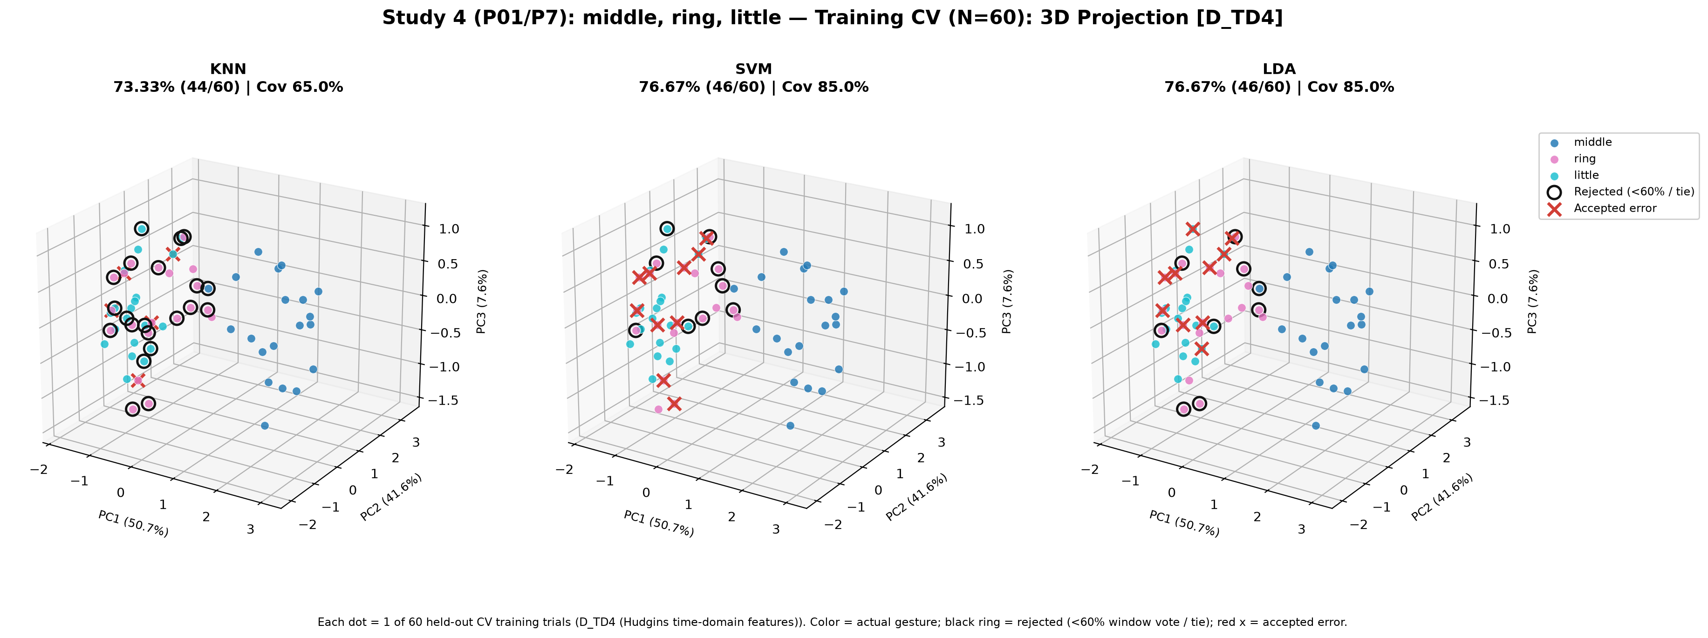
[picture p114: results/training_results/04_middle_ring_little/Study04_P01_P7_middle_ring_little_training_D_TD4_KNN_SVM_LDA_3D.png]


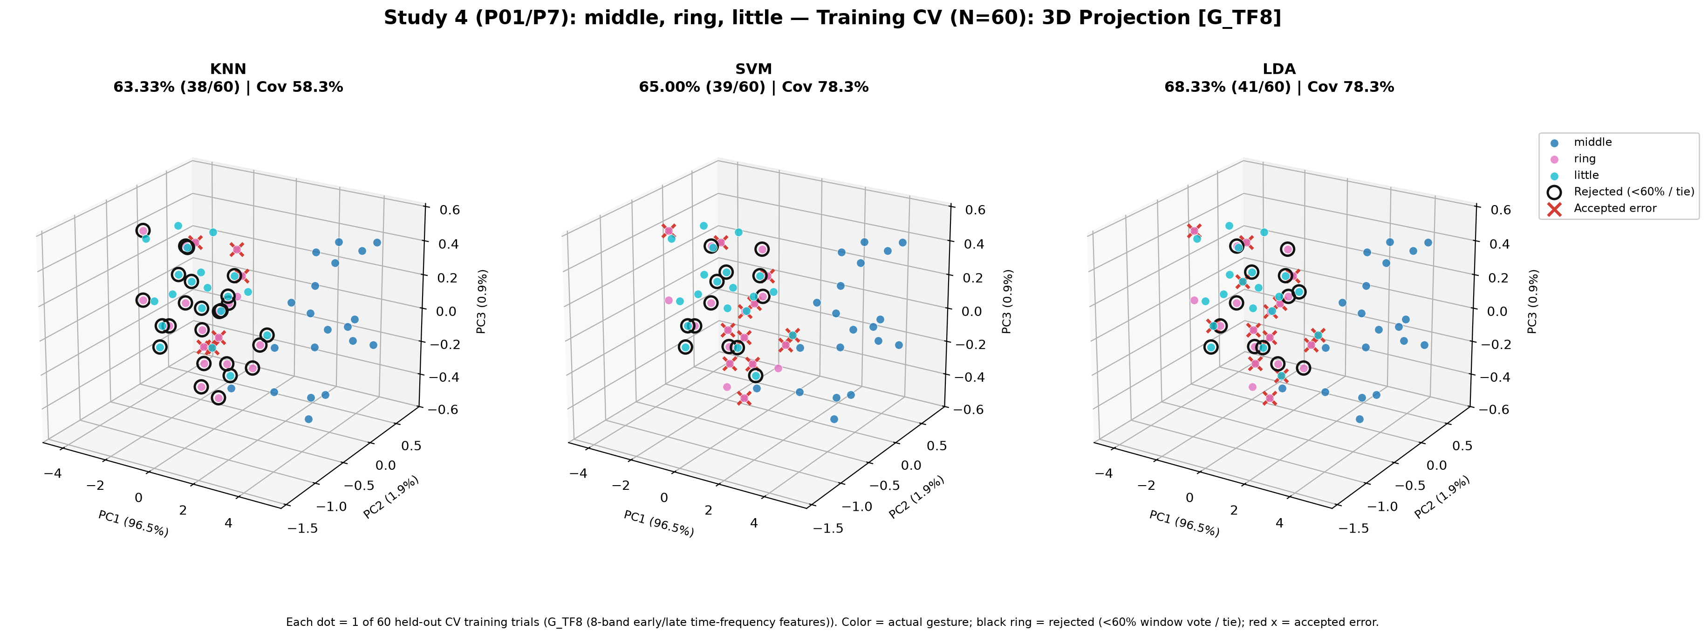
[picture p115: results/training_results/04_middle_ring_little/Study04_P01_P7_middle_ring_little_training_G_TF8_KNN_SVM_LDA_3D.png]


### Classifier Decision Boundary Gradient Heatmaps

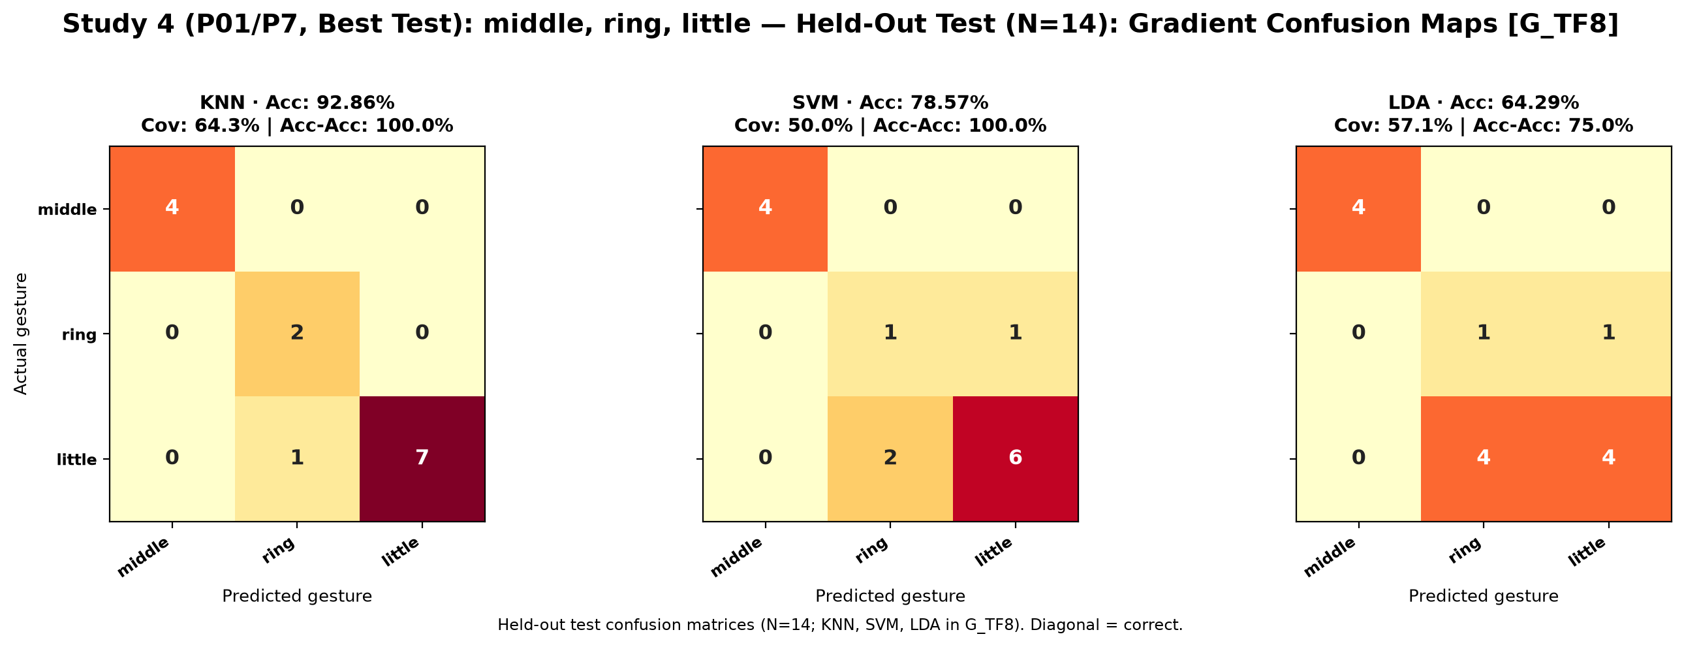
[picture p116: results/training_results/04_middle_ring_little/Study04_P01_P7_middle_ring_little_test_best_G_TF8_KNN_SVM_LDA_gradient_heatmaps.png]


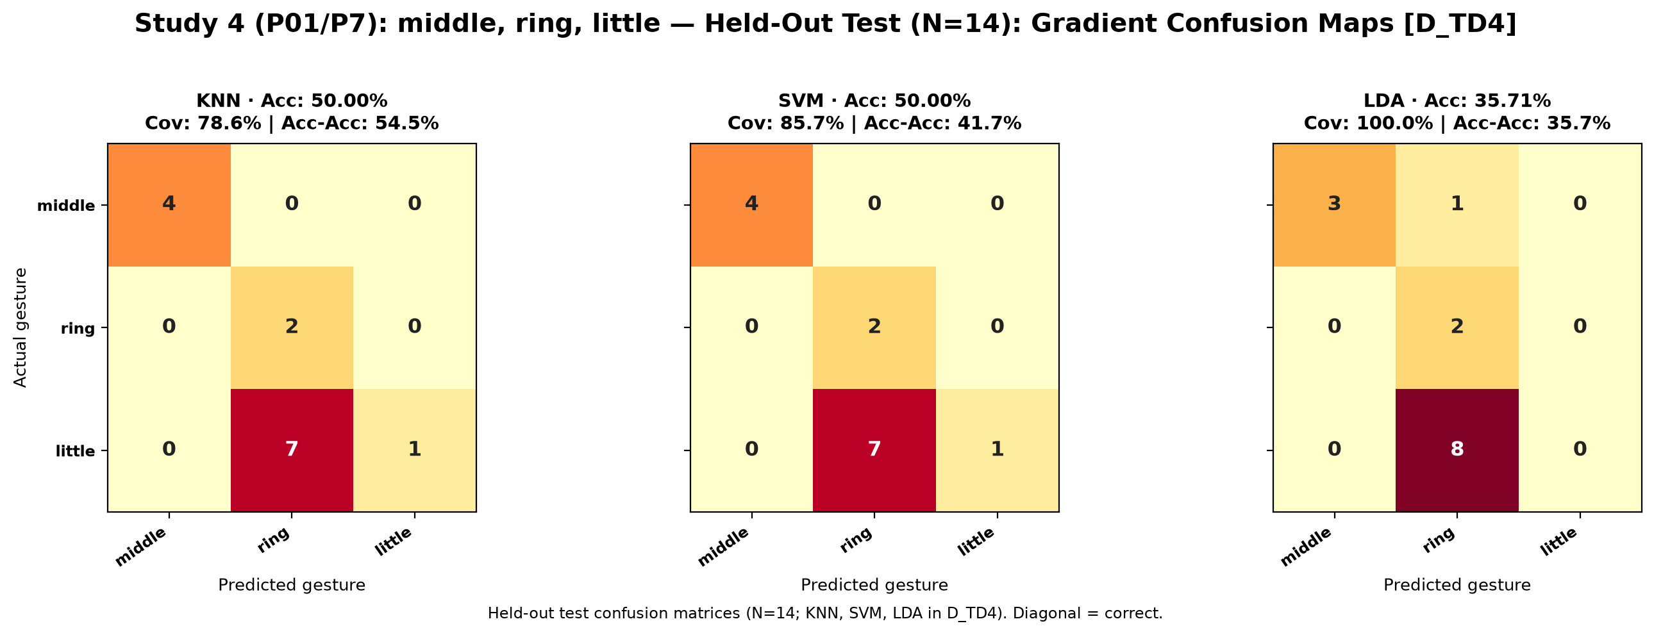
[picture p117: results/training_results/04_middle_ring_little/Study04_P01_P7_middle_ring_little_test_D_TD4_KNN_SVM_LDA_gradient_heatmaps.png]


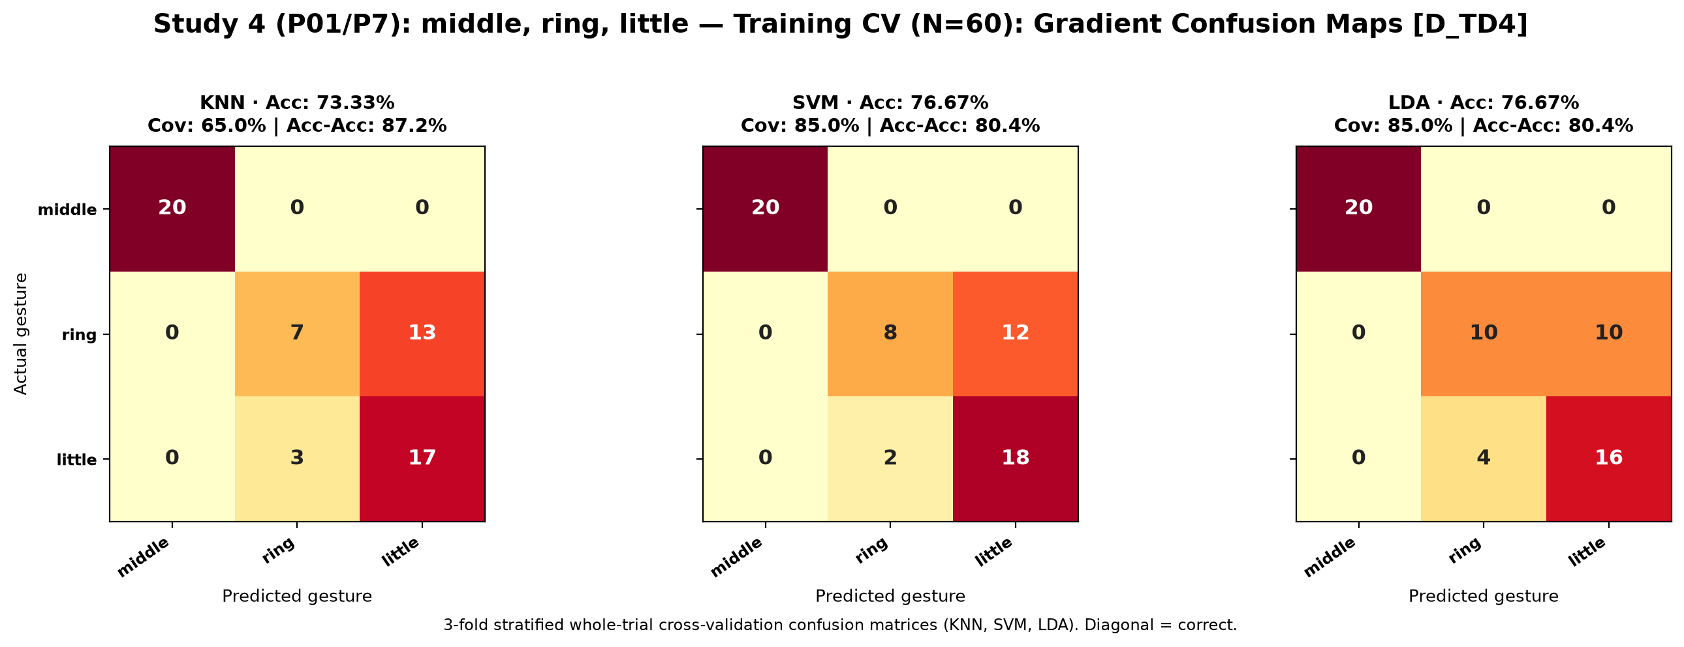
[picture p118: results/training_results/04_middle_ring_little/Study04_P01_P7_middle_ring_little_training_D_TD4_KNN_SVM_LDA_gradient_heatmaps.png]


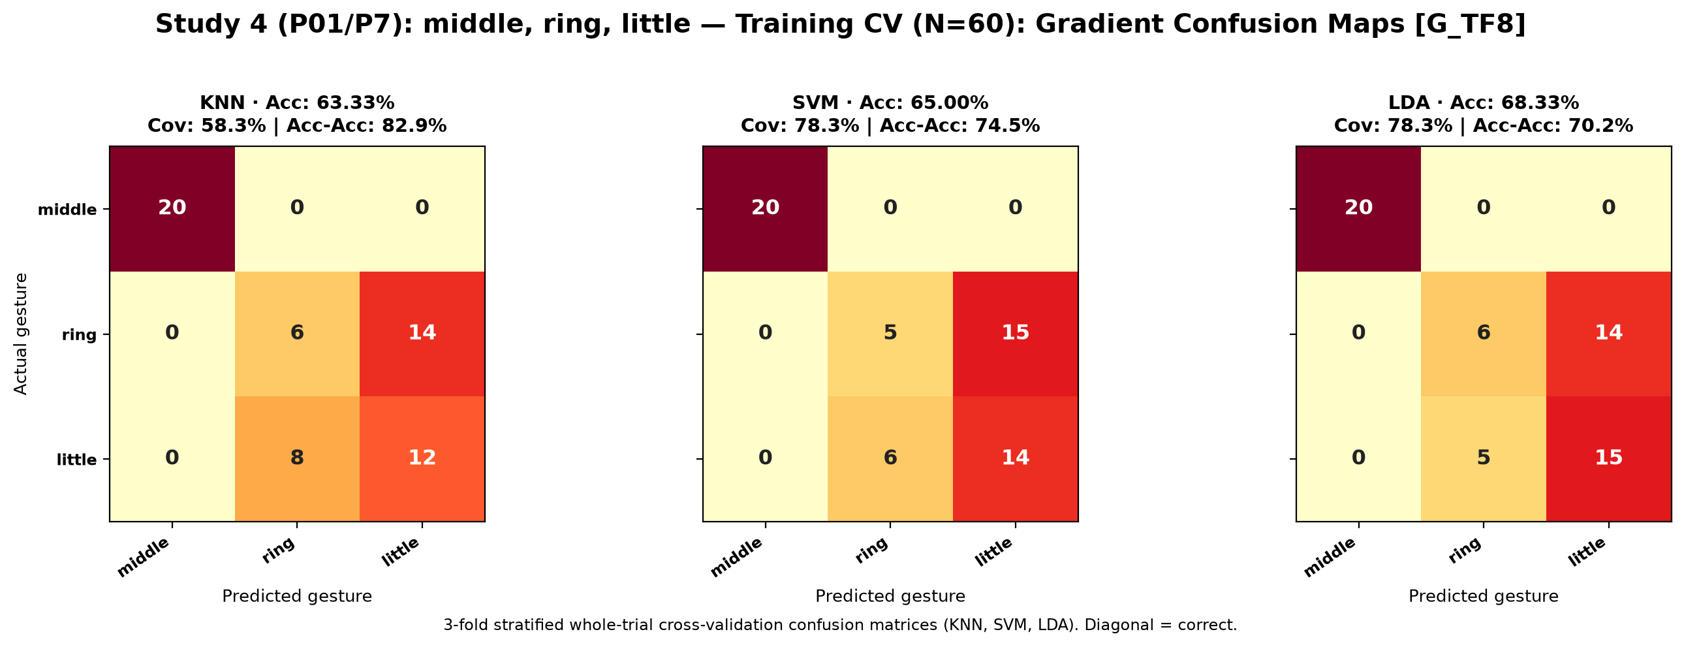
[picture p119: results/training_results/04_middle_ring_little/Study04_P01_P7_middle_ring_little_training_G_TF8_KNN_SVM_LDA_gradient_heatmaps.png]
