PrithviBhende/emg-teleoperation-ros2/results/training_results/05_rest_thumb_index_middle_fist/README.md

# Study 5: rest, thumb, index, middle, fist (5 Gestures)

- **Subject**: P01
- **Electrode Placement**: P6
- **Champion / Evaluated Model**: `G_TF8__SVM`
- **3-Fold Cross-Validation Accuracy**: 98.00% (98/100)
- **Held-Out Test Accuracy**: 86.67% (39/45)

---

## Graphical Representations & Decision Boundaries

### 2D Feature Projections & Decision Boundaries

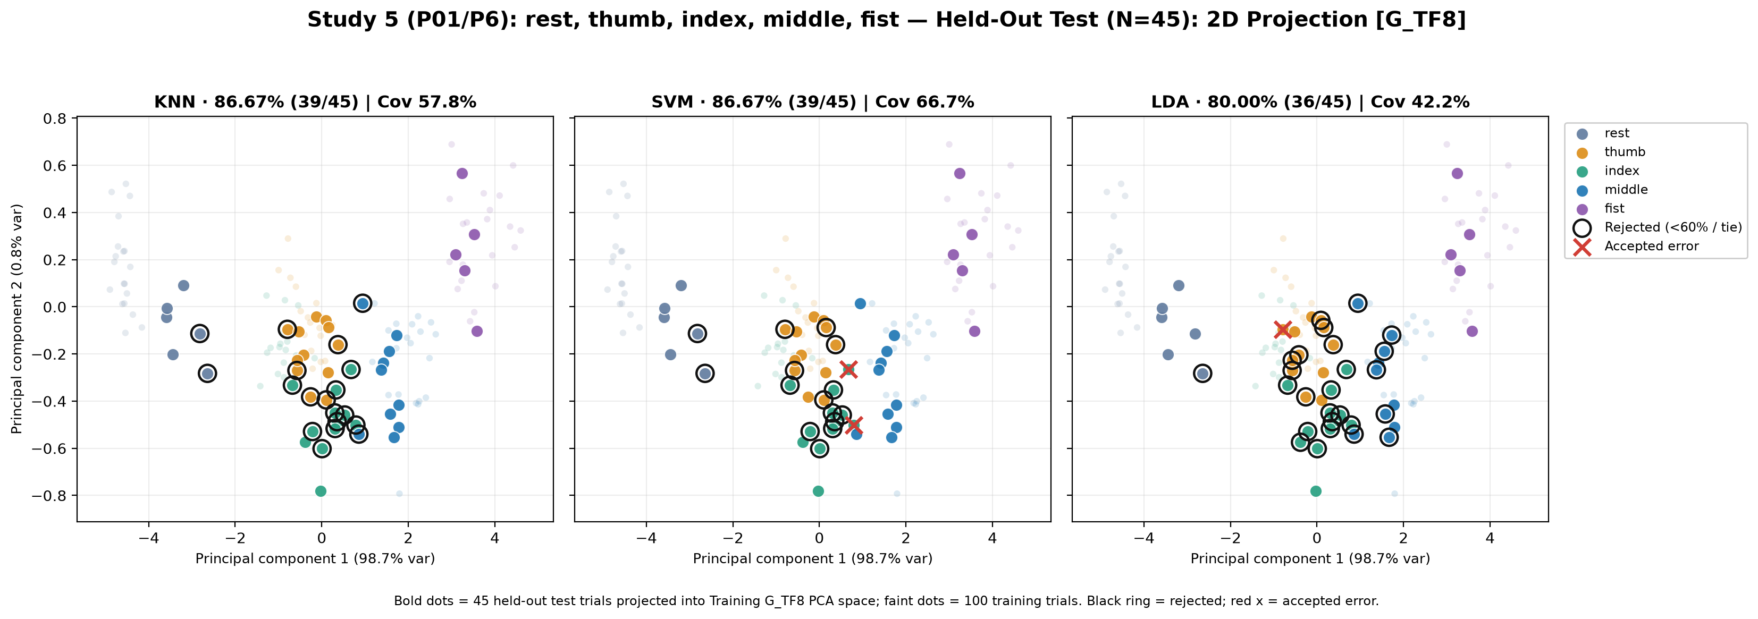
[picture p120: results/training_results/05_rest_thumb_index_middle_fist/Study05_P01_P6_rest_thumb_index_middle_fist_test_G_TF8_KNN_SVM_LDA_2D.png]


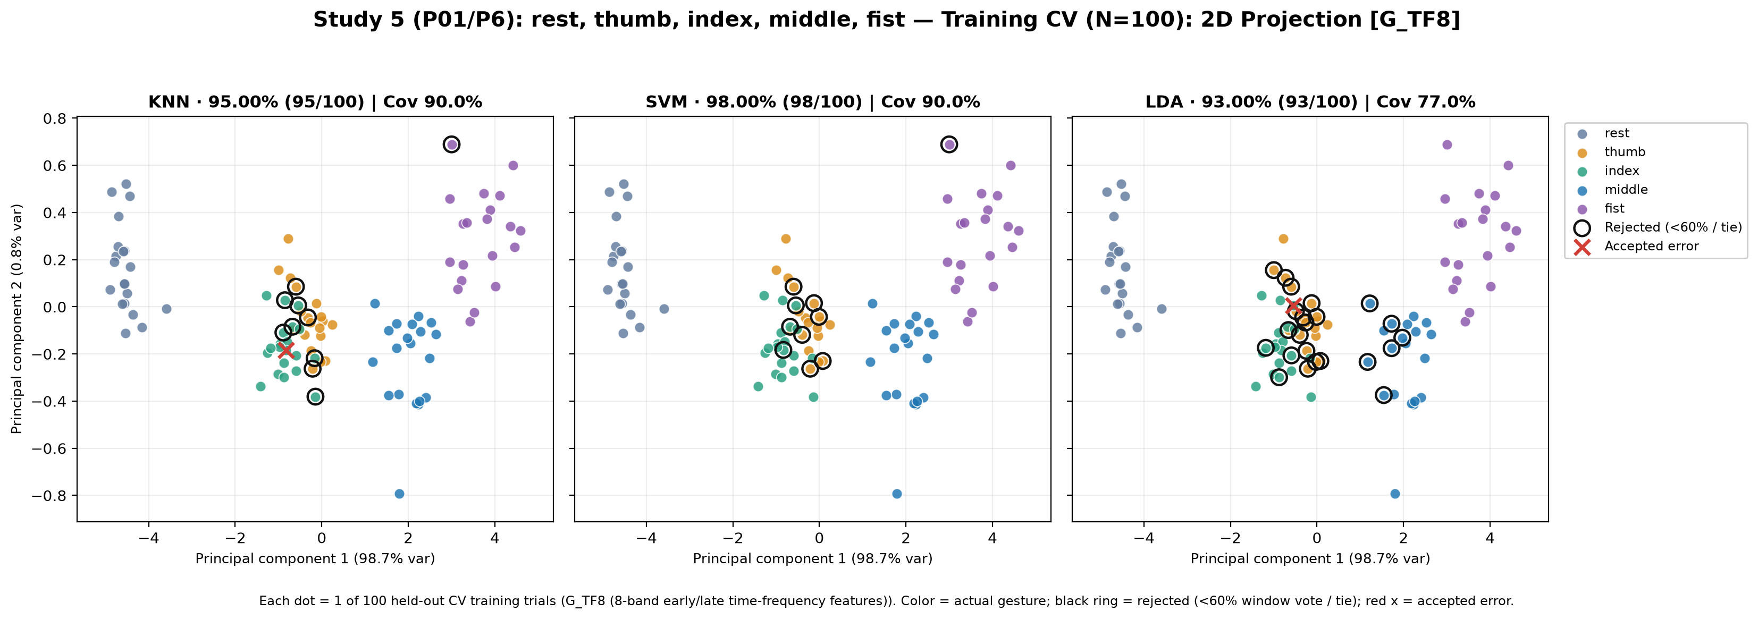
[picture p121: results/training_results/05_rest_thumb_index_middle_fist/Study05_P01_P6_rest_thumb_index_middle_fist_training_G_TF8_KNN_SVM_LDA_2D.png]


### 3D Feature Projections & Decision Boundaries

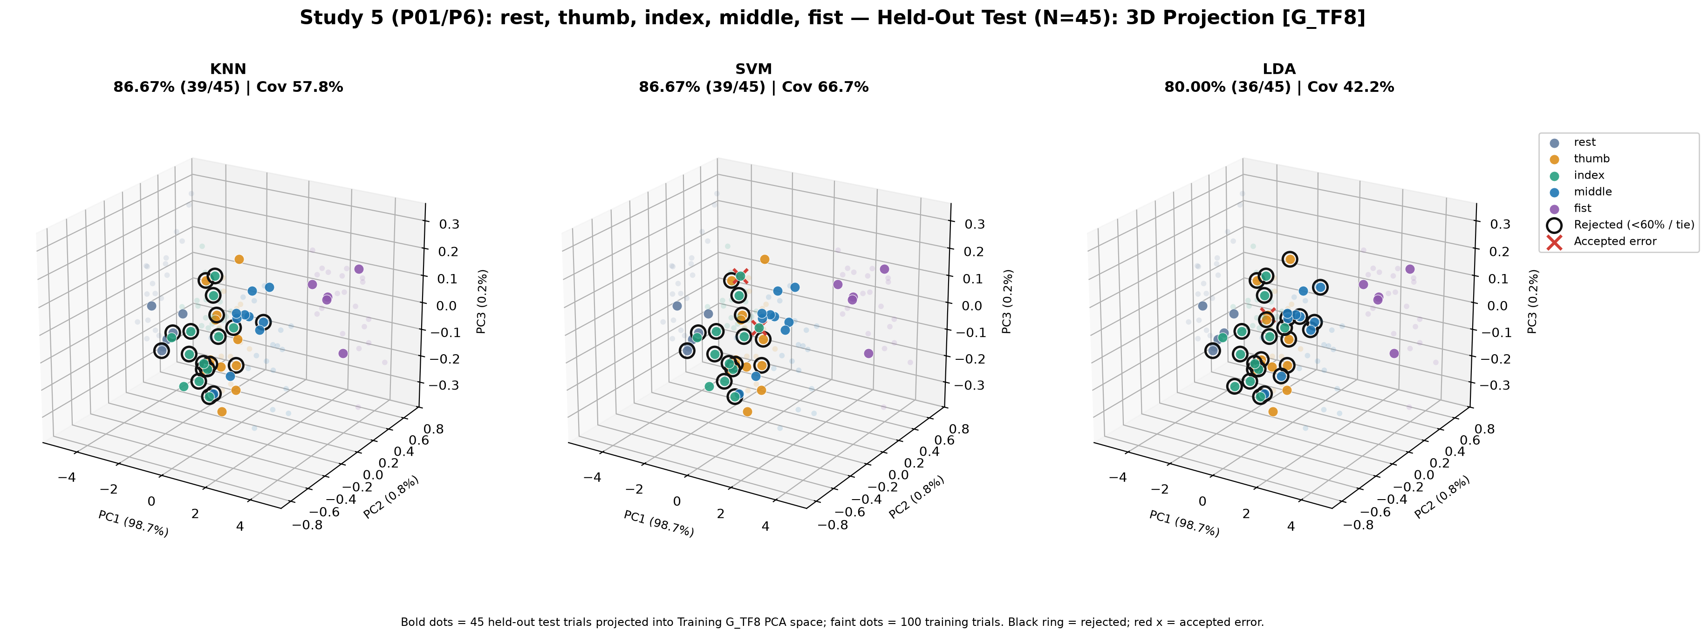
[picture p122: results/training_results/05_rest_thumb_index_middle_fist/Study05_P01_P6_rest_thumb_index_middle_fist_test_G_TF8_KNN_SVM_LDA_3D.png]


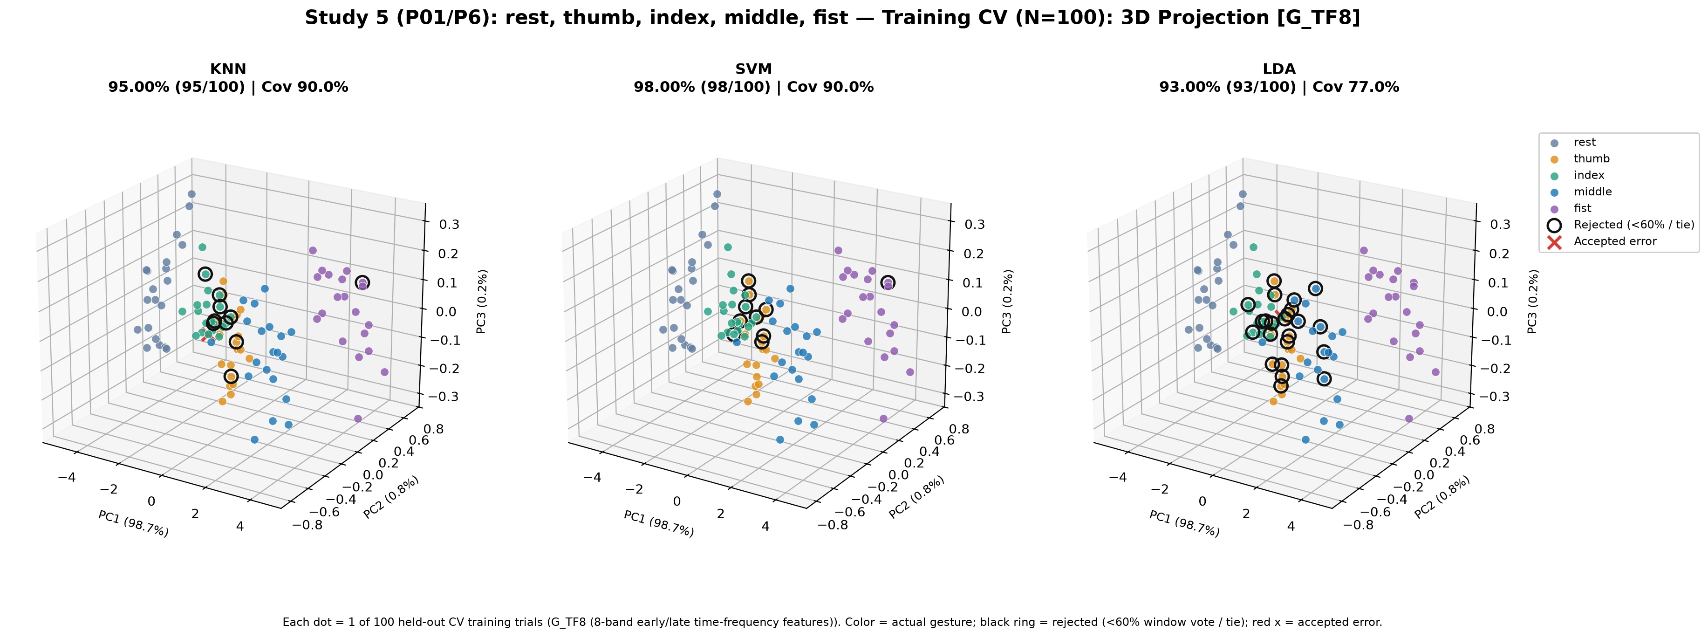
[picture p123: results/training_results/05_rest_thumb_index_middle_fist/Study05_P01_P6_rest_thumb_index_middle_fist_training_G_TF8_KNN_SVM_LDA_3D.png]


### Classifier Decision Boundary Gradient Heatmaps

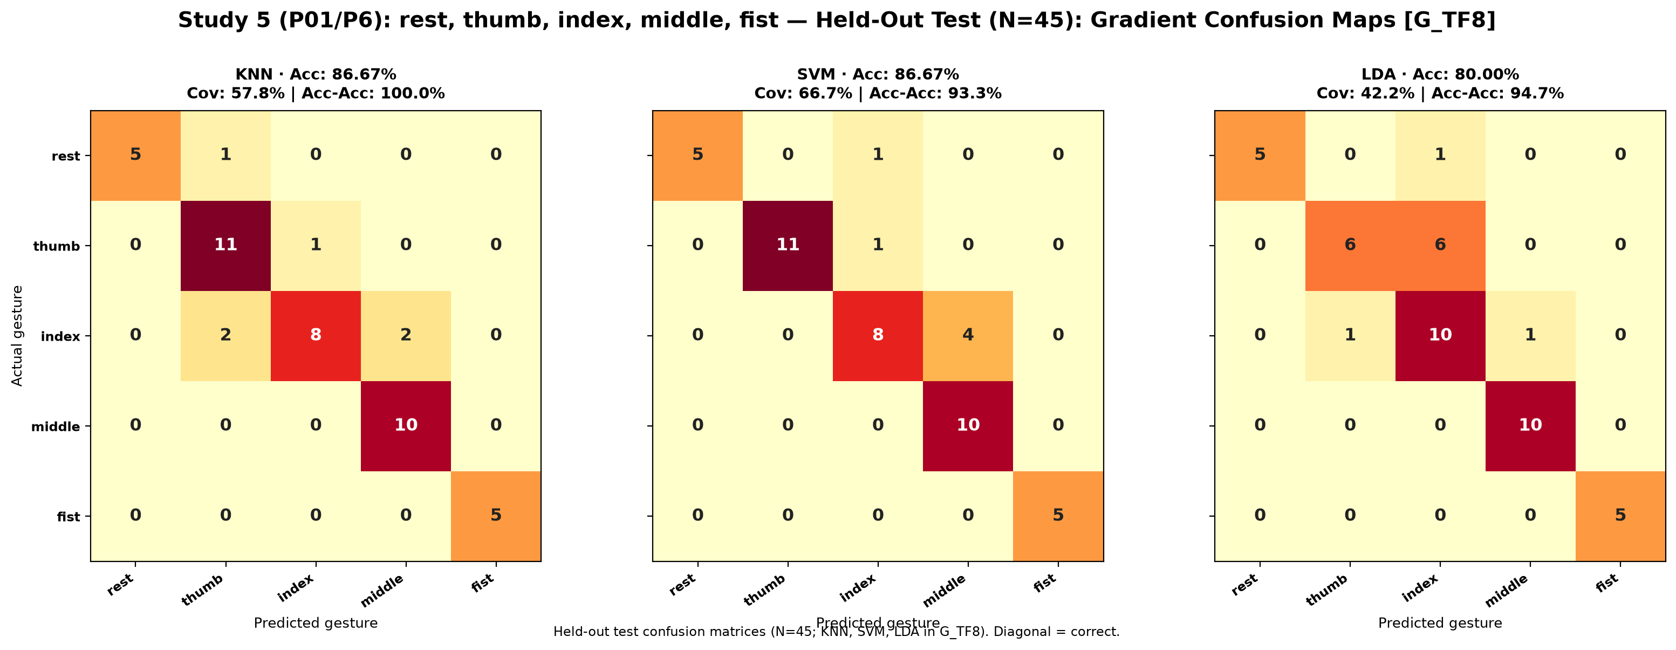
[picture p124: results/training_results/05_rest_thumb_index_middle_fist/Study05_P01_P6_rest_thumb_index_middle_fist_test_G_TF8_KNN_SVM_LDA_gradient_heatmaps.png]
Study05_P01_P6_rest_thumb_index_middle_fist_test_G_TF8_KNN_SVM_LDA_gradient_heatmaps.png


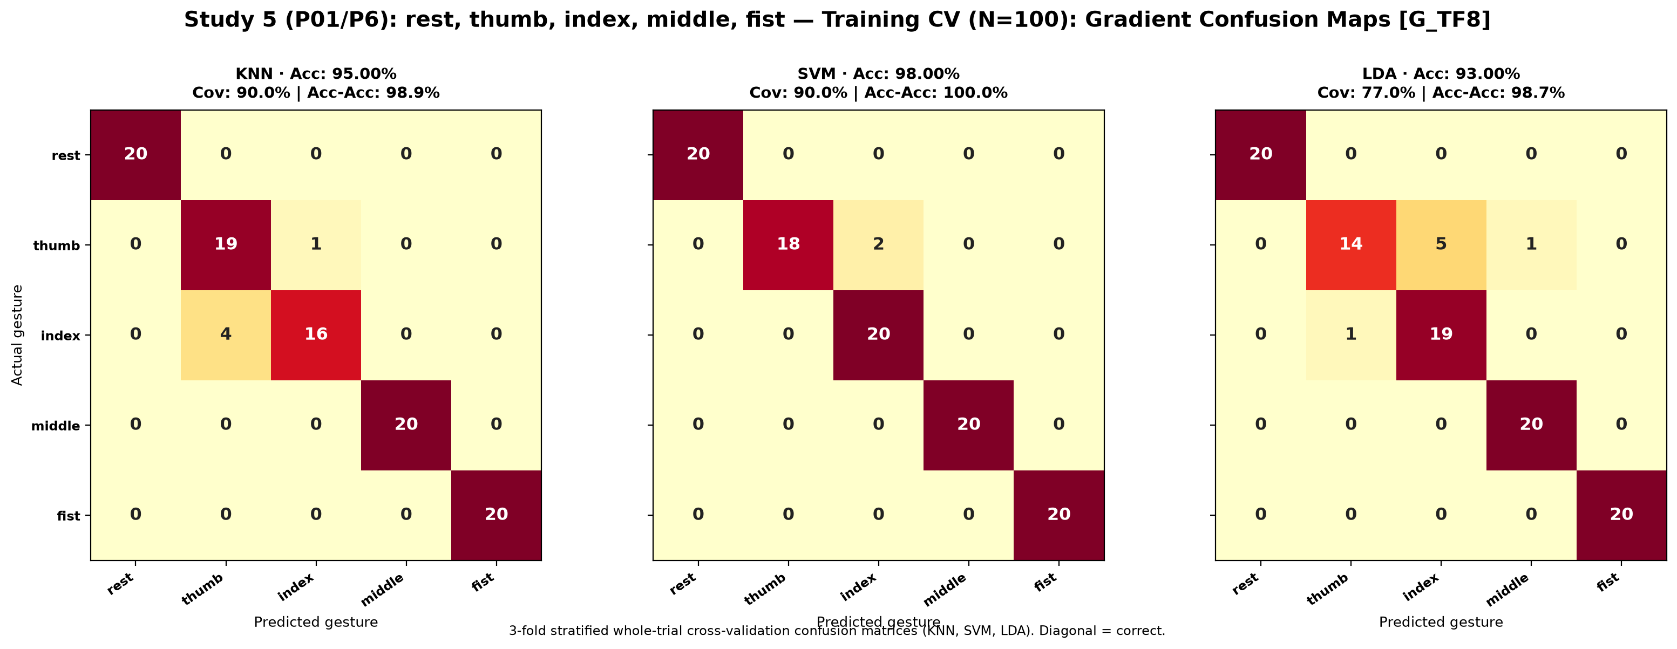
[picture p125: results/training_results/05_rest_thumb_index_middle_fist/Study05_P01_P6_rest_thumb_index_middle_fist_training_G_TF8_KNN_SVM_LDA_gradient_heatmaps.png]
Study05_P01_P6_rest_thumb_index_middle_fist_training_G_TF8_KNN_SVM_LDA_gradient_heatmaps.png
