PrithviBhende/emg-teleoperation-ros2/results/training_results/06_rest_thumb_index_pinch_fist/README.md

# Study 6: rest, thumb, index, pinch, fist (5 Gestures with Pinch)

- **Subject**: P01
- **Electrode Placement**: P8
- **Champion / Evaluated Model**: `G_TF8__SVM`
- **3-Fold Cross-Validation Accuracy**: 90.00% (90/100)
- **Held-Out Test Accuracy**: 92.31% (24/26)

---

## Graphical Representations & Decision Boundaries

### 2D Feature Projections & Decision Boundaries

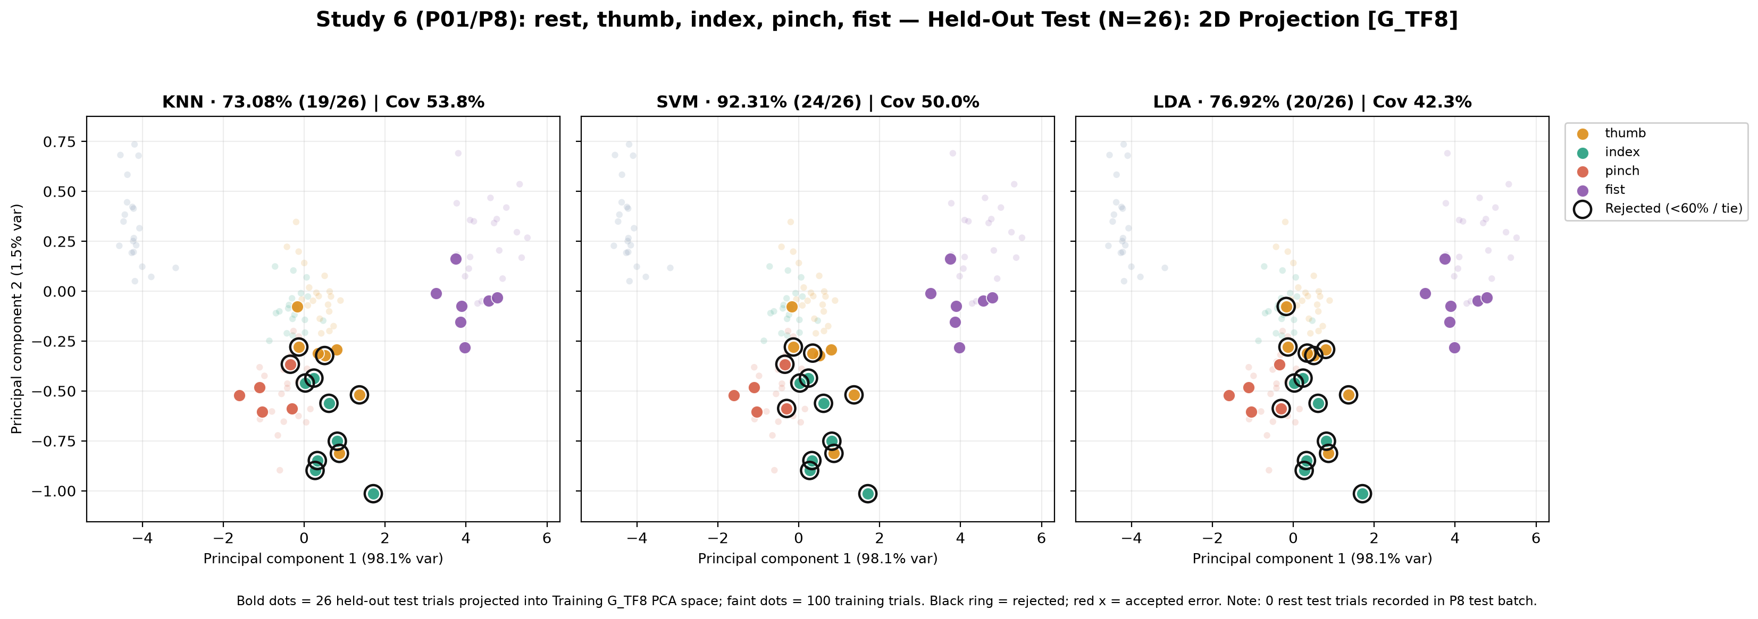
[picture p126: results/training_results/06_rest_thumb_index_pinch_fist/Study06_P01_P8_rest_thumb_index_pinch_fist_test_G_TF8_KNN_SVM_LDA_2D.png]


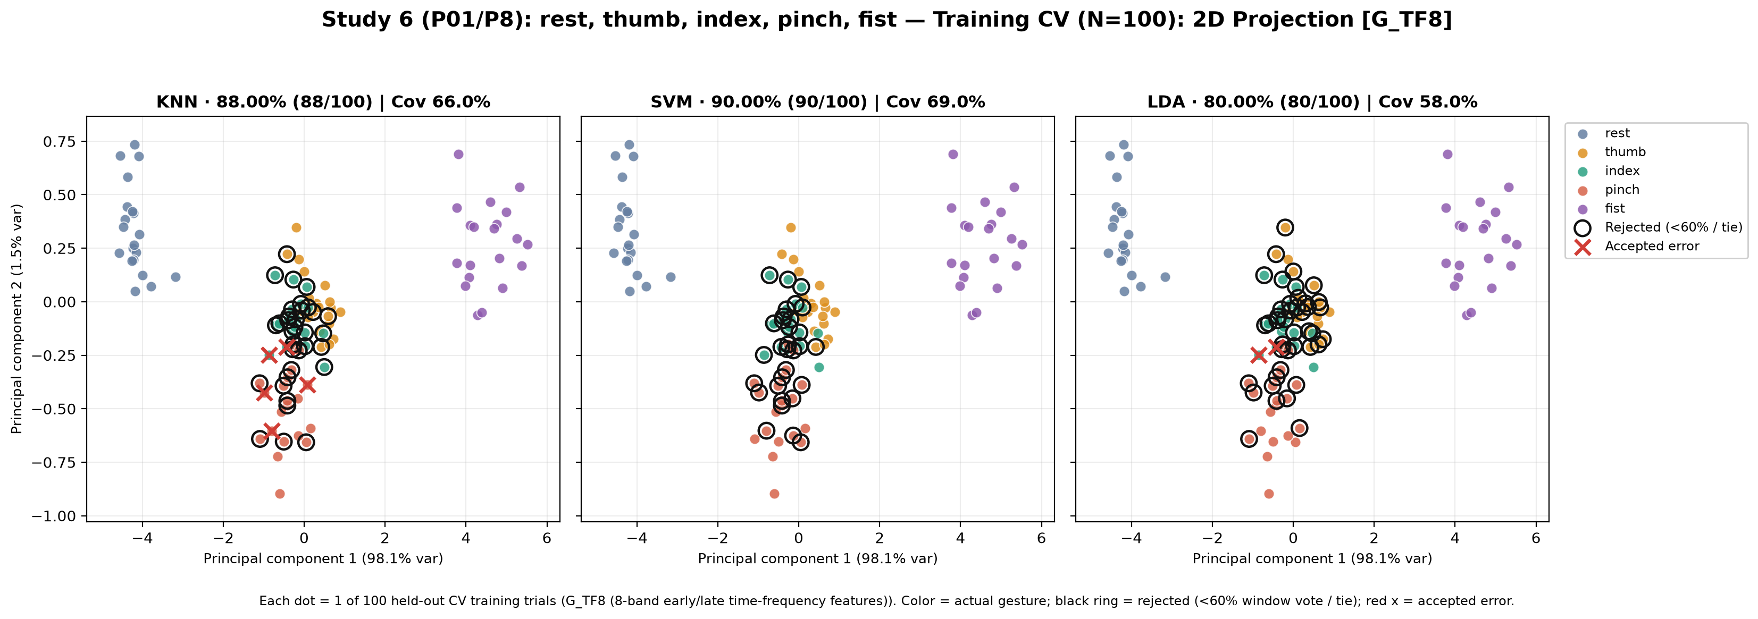
[picture p127: results/training_results/06_rest_thumb_index_pinch_fist/Study06_P01_P8_rest_thumb_index_pinch_fist_training_G_TF8_KNN_SVM_LDA_2D.png]


### 3D Feature Projections & Decision Boundaries

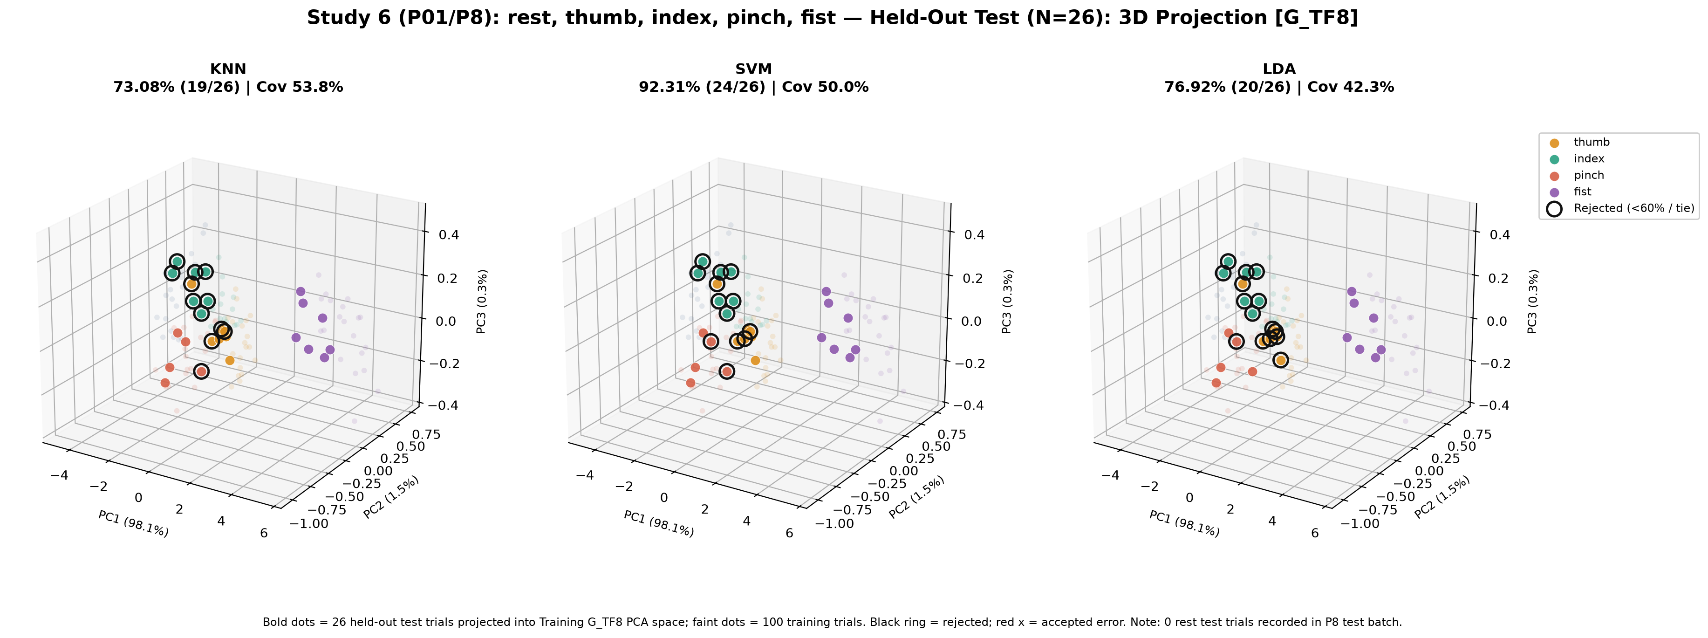
[picture p128: results/training_results/06_rest_thumb_index_pinch_fist/Study06_P01_P8_rest_thumb_index_pinch_fist_test_G_TF8_KNN_SVM_LDA_3D.png]


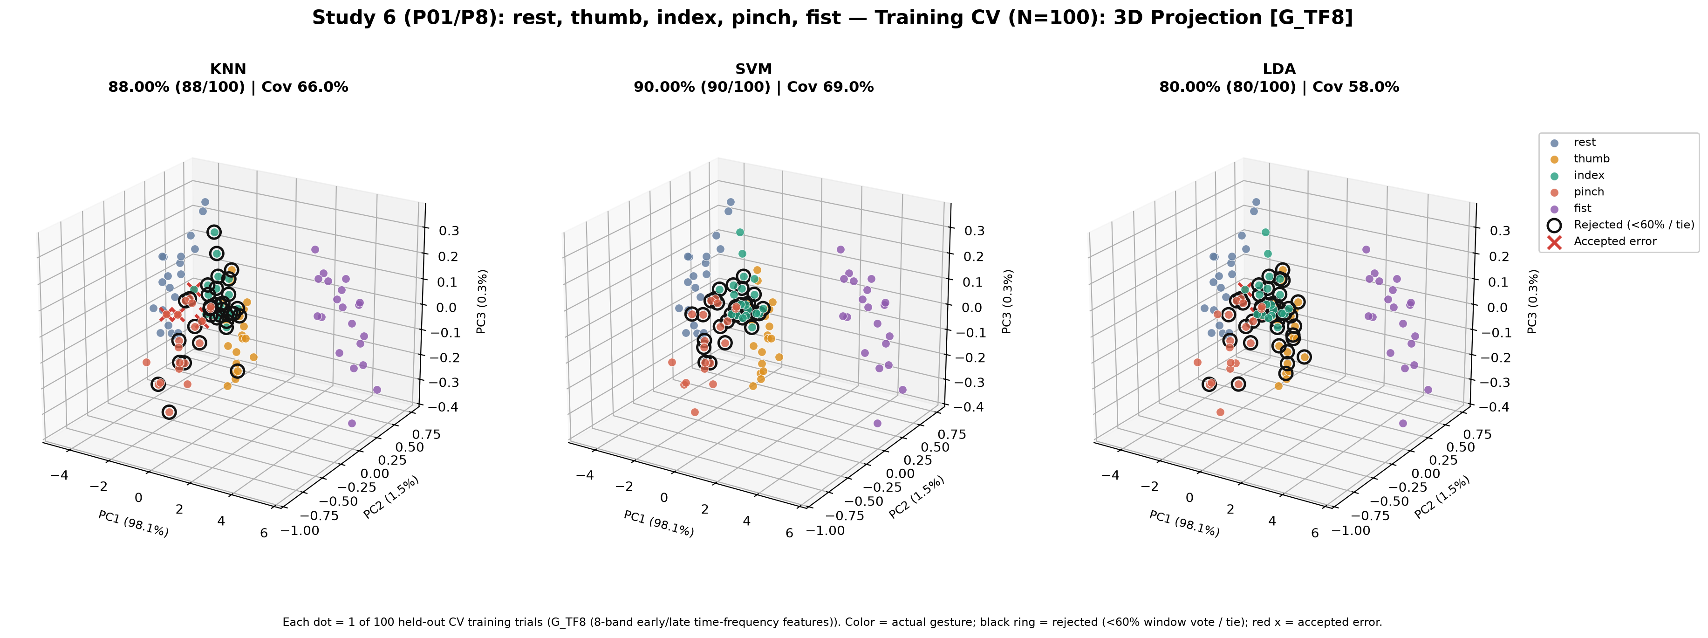
[picture p129: results/training_results/06_rest_thumb_index_pinch_fist/Study06_P01_P8_rest_thumb_index_pinch_fist_training_G_TF8_KNN_SVM_LDA_3D.png]


### Classifier Decision Boundary Gradient Heatmaps

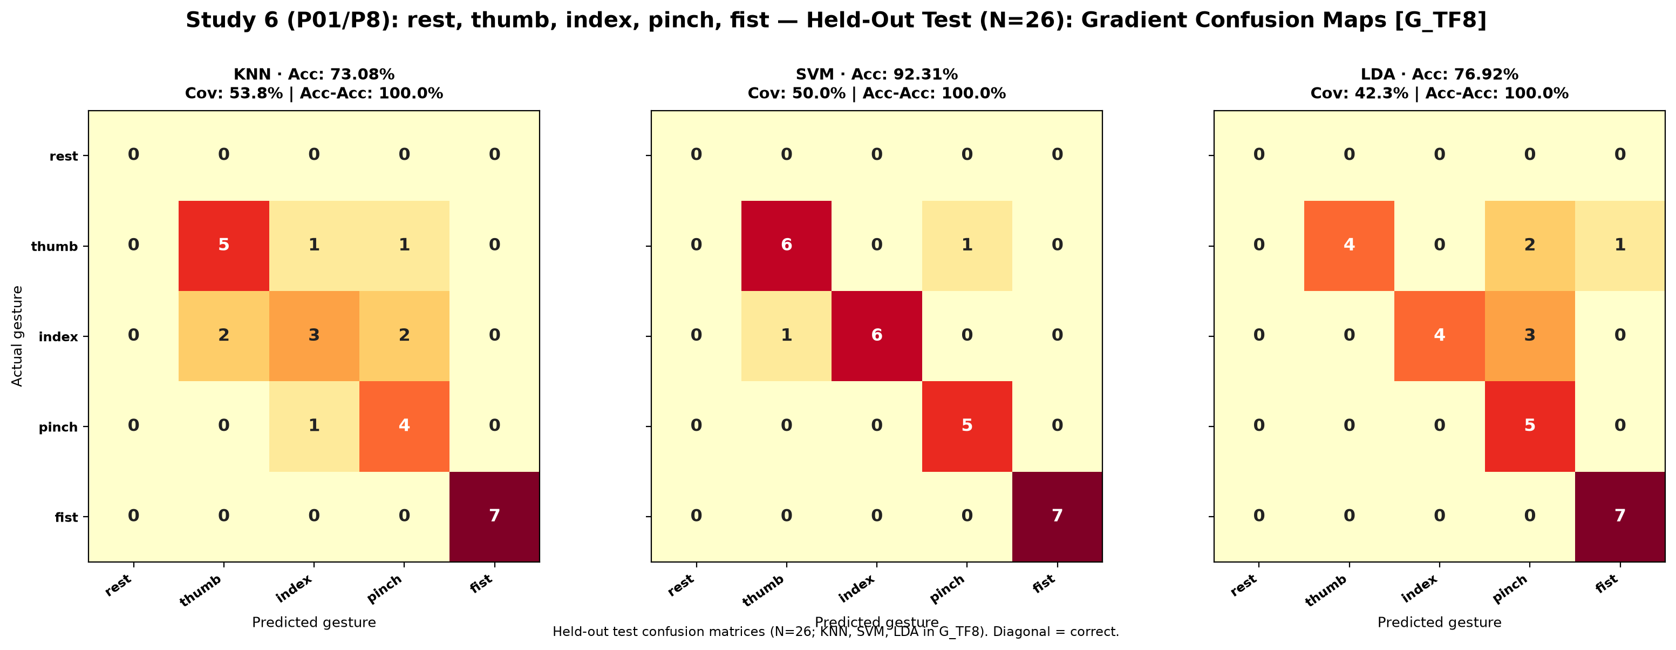
[picture p130: results/training_results/06_rest_thumb_index_pinch_fist/Study06_P01_P8_rest_thumb_index_pinch_fist_test_G_TF8_KNN_SVM_LDA_gradient_heatmaps.png]
Study06_P01_P8_rest_thumb_index_pinch_fist_test_G_TF8_KNN_SVM_LDA_gradient_heatmaps.png


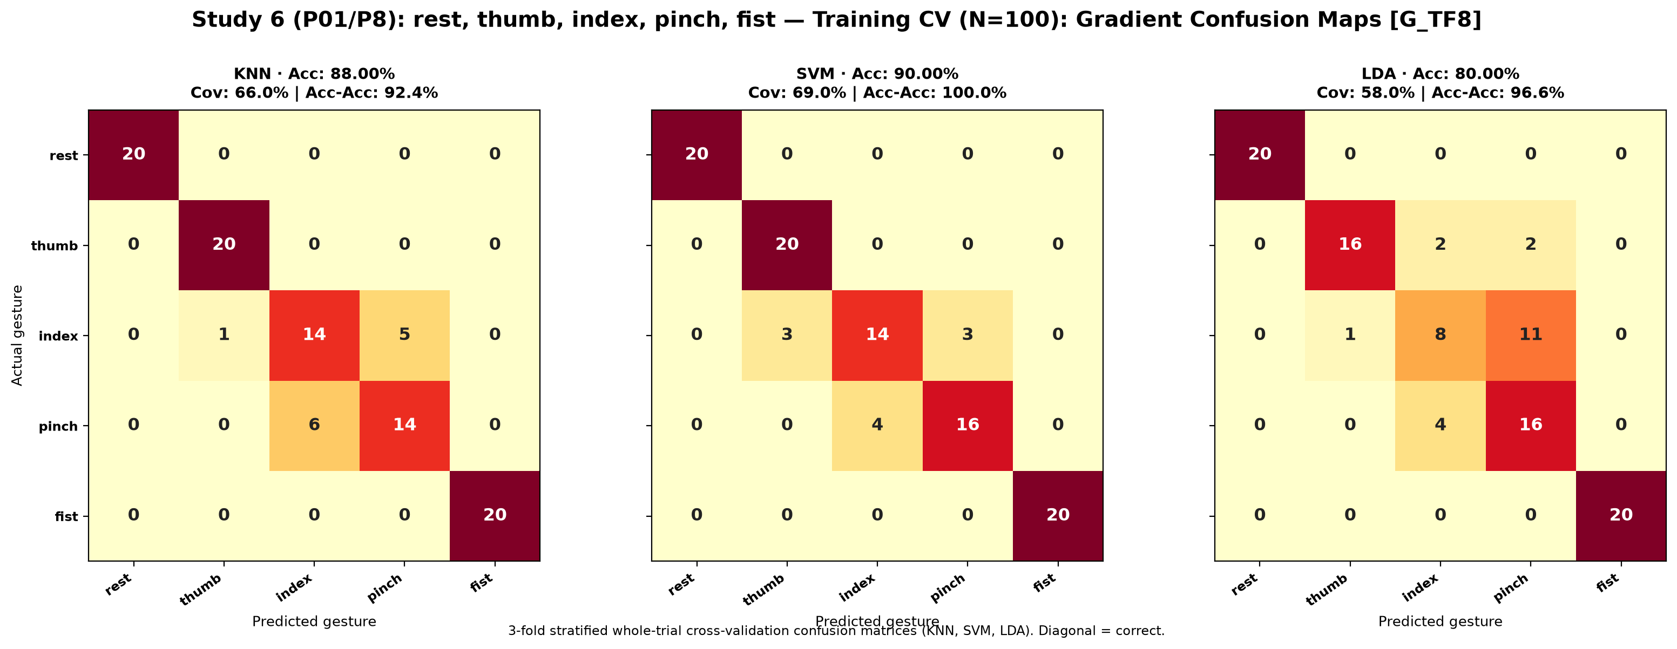
[picture p131: results/training_results/06_rest_thumb_index_pinch_fist/Study06_P01_P8_rest_thumb_index_pinch_fist_training_G_TF8_KNN_SVM_LDA_gradient_heatmaps.png]
Study06_P01_P8_rest_thumb_index_pinch_fist_training_G_TF8_KNN_SVM_LDA_gradient_heatmaps.png
