PrithviBhende/emg-teleoperation-ros2/results/training_results/07_all_8_gestures/README.md

# Study 7: All 8 Gestures (rest, thumb, index, middle, ring, little, pinch, fist)

- **Subject**: P01
- **Electrode Placement**: Train: all fingers (P02/P3), Test: P01/P1 (Cross-Day)
- **Champion / Evaluated Model**: `G_TF8__SVM`
- **3-Fold Cross-Validation Accuracy**: 76.40% (123/161)
- **Held-Out Test Accuracy**: 42.42% (14/33)

---

## Graphical Representations & Decision Boundaries

### 2D Feature Projections & Decision Boundaries

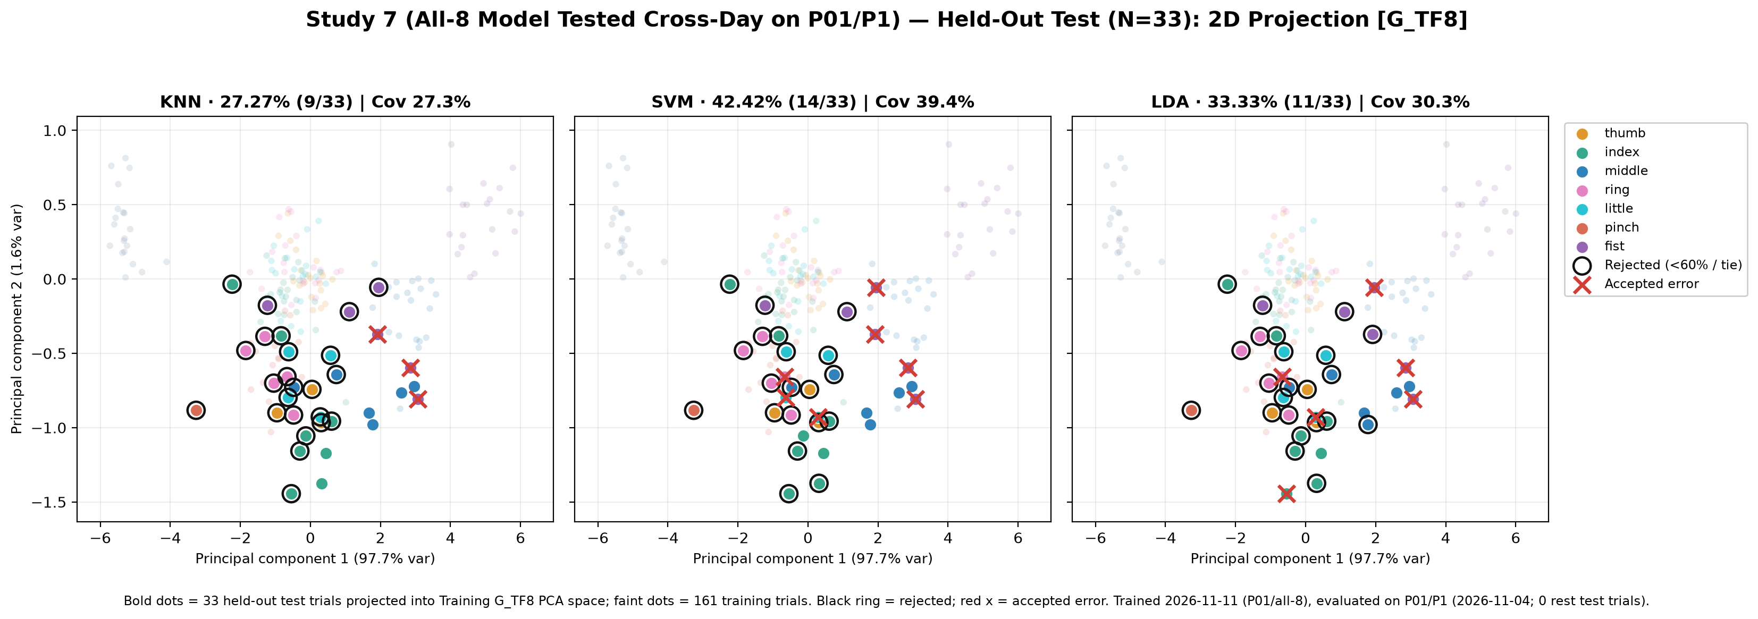
[picture p132: results/training_results/07_all_8_gestures/Study07_P01_all_8_gestures_test_on_P01_P1_G_TF8_KNN_SVM_LDA_2D.png]


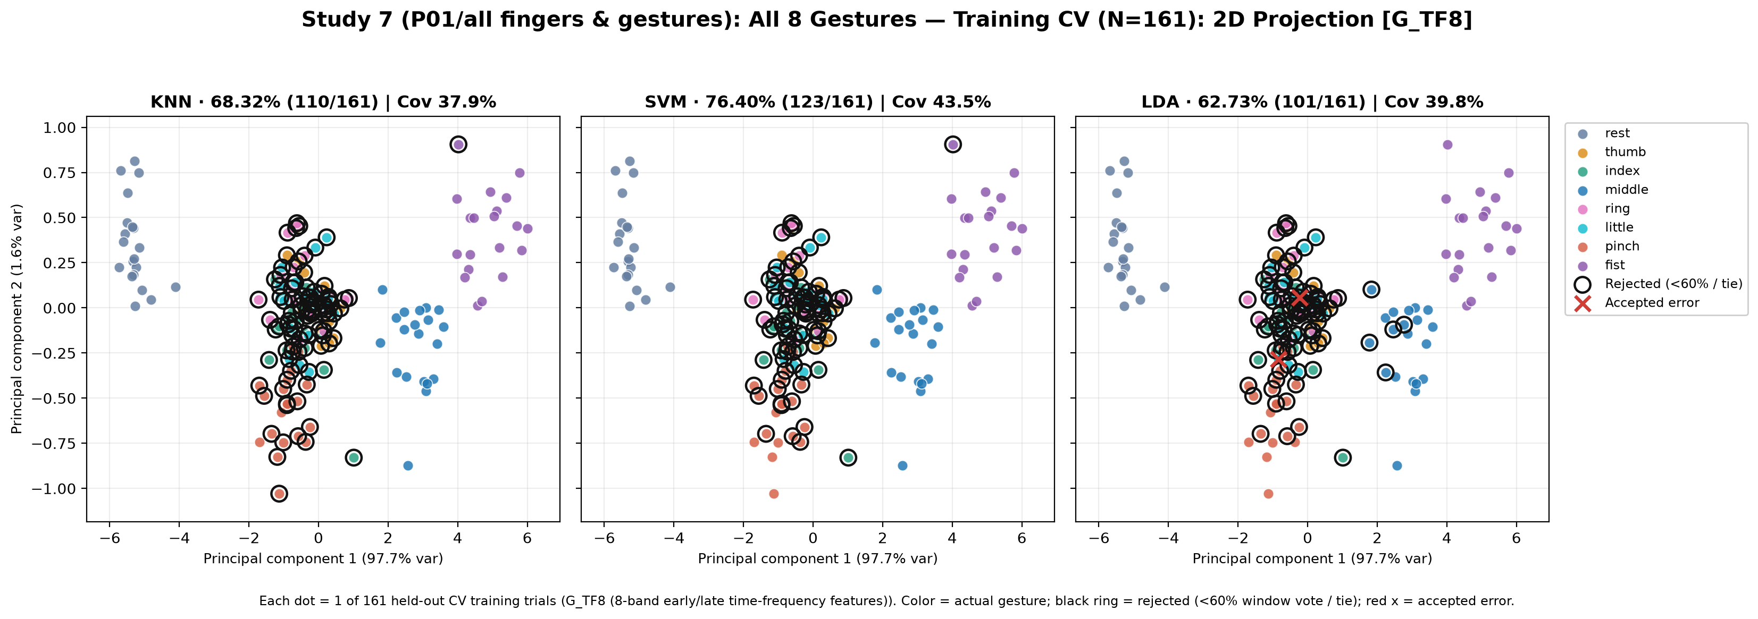
[picture p133: results/training_results/07_all_8_gestures/Study07_P01_all_8_gestures_training_G_TF8_KNN_SVM_LDA_2D.png]


### 3D Feature Projections & Decision Boundaries

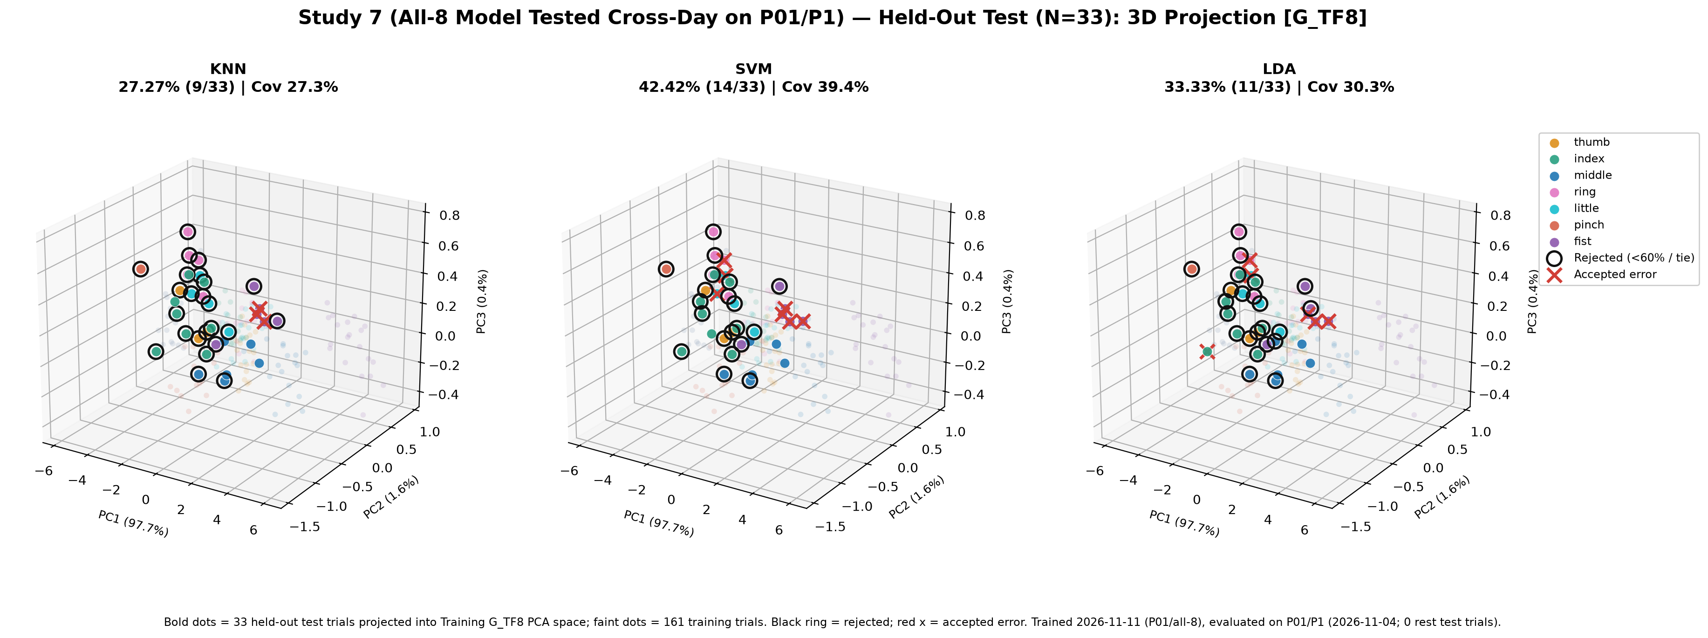
[picture p134: results/training_results/07_all_8_gestures/Study07_P01_all_8_gestures_test_on_P01_P1_G_TF8_KNN_SVM_LDA_3D.png]


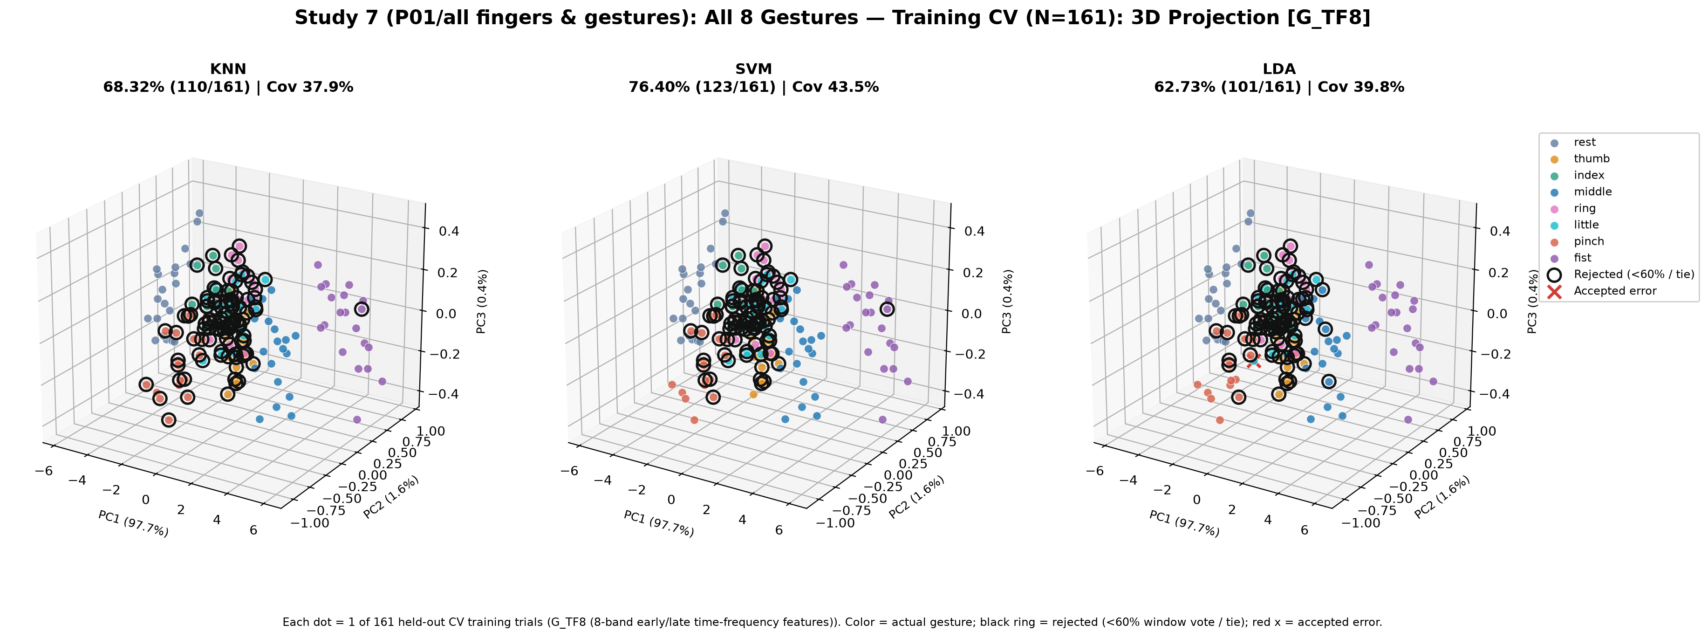
[picture p135: results/training_results/07_all_8_gestures/Study07_P01_all_8_gestures_training_G_TF8_KNN_SVM_LDA_3D.png]


### Classifier Decision Boundary Gradient Heatmaps

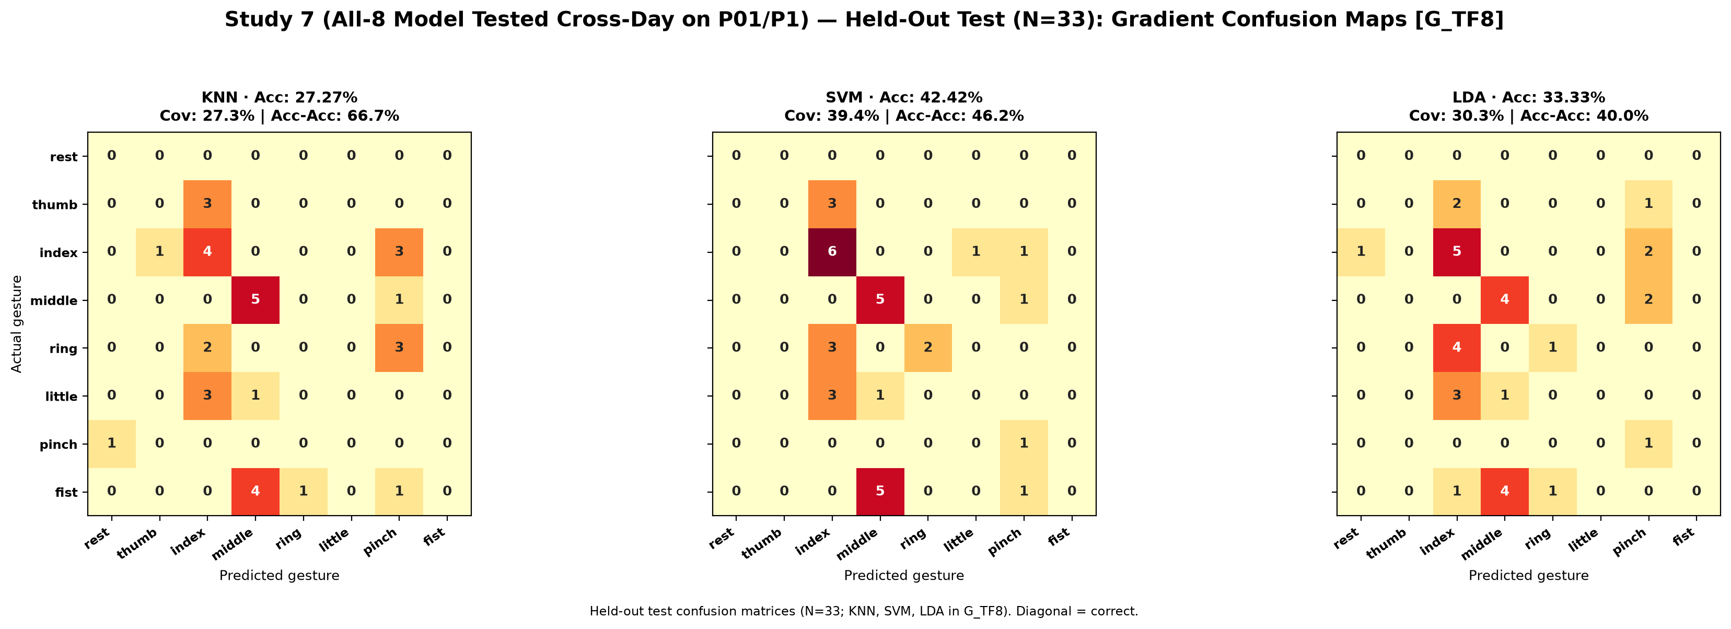
[picture p136: results/training_results/07_all_8_gestures/Study07_P01_all_8_gestures_test_on_P01_P1_G_TF8_KNN_SVM_LDA_gradient_heatmaps.png]


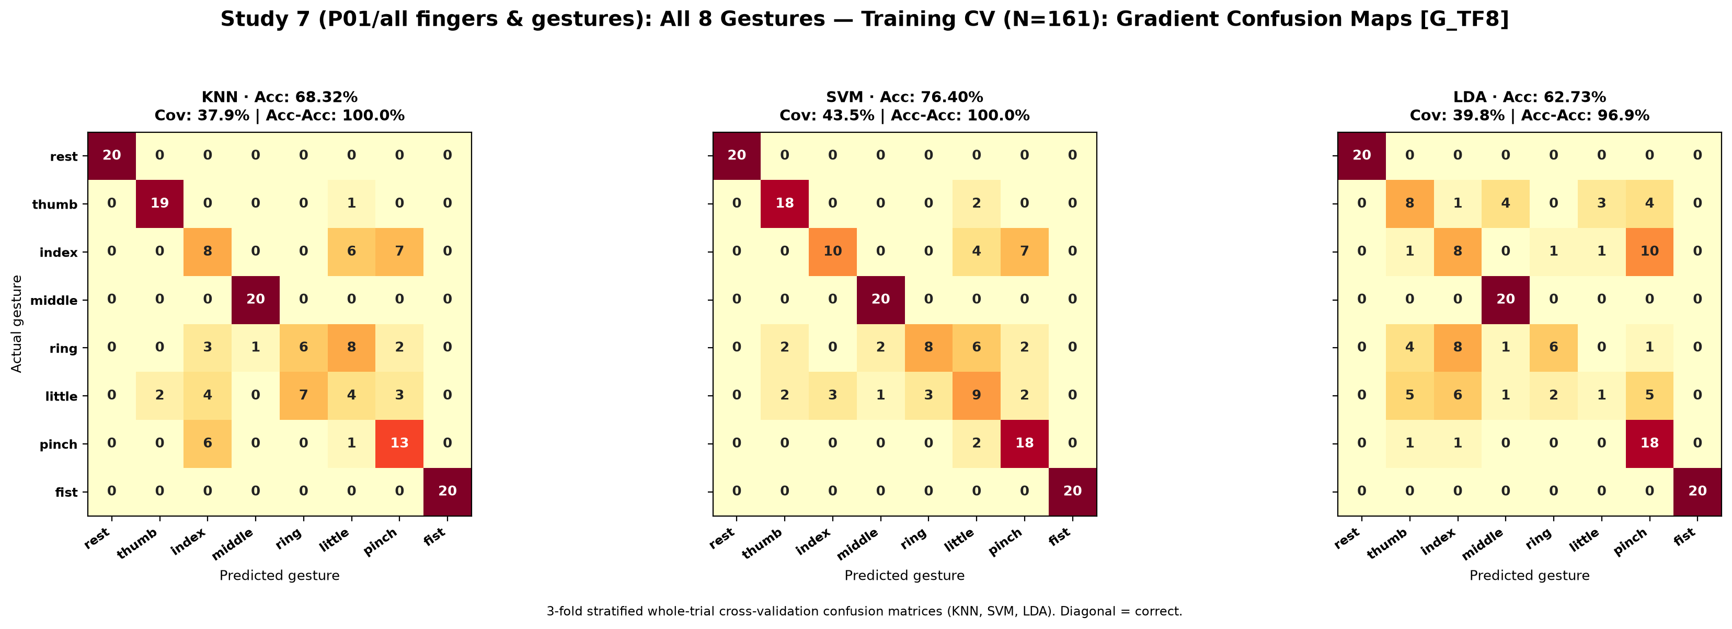
[picture p137: results/training_results/07_all_8_gestures/Study07_P01_all_8_gestures_training_G_TF8_KNN_SVM_LDA_gradient_heatmaps.png]
