PrithviBhende/emg-teleoperation-ros2/results/training_results/08_rest_index_fist_p3/README.md

# Study 8: rest, index, fist (Placement P3 Baseline)

- **Subject**: P01
- **Electrode Placement**: P3
- **Champion / Evaluated Model**: `C_WL__KNN`
- **3-Fold Cross-Validation Accuracy**: 100.00% (60/60)
- **Held-Out Test Accuracy**: 100.00% (5/5)

---

## Graphical Representations & Decision Boundaries

### 2D Feature Projections & Decision Boundaries

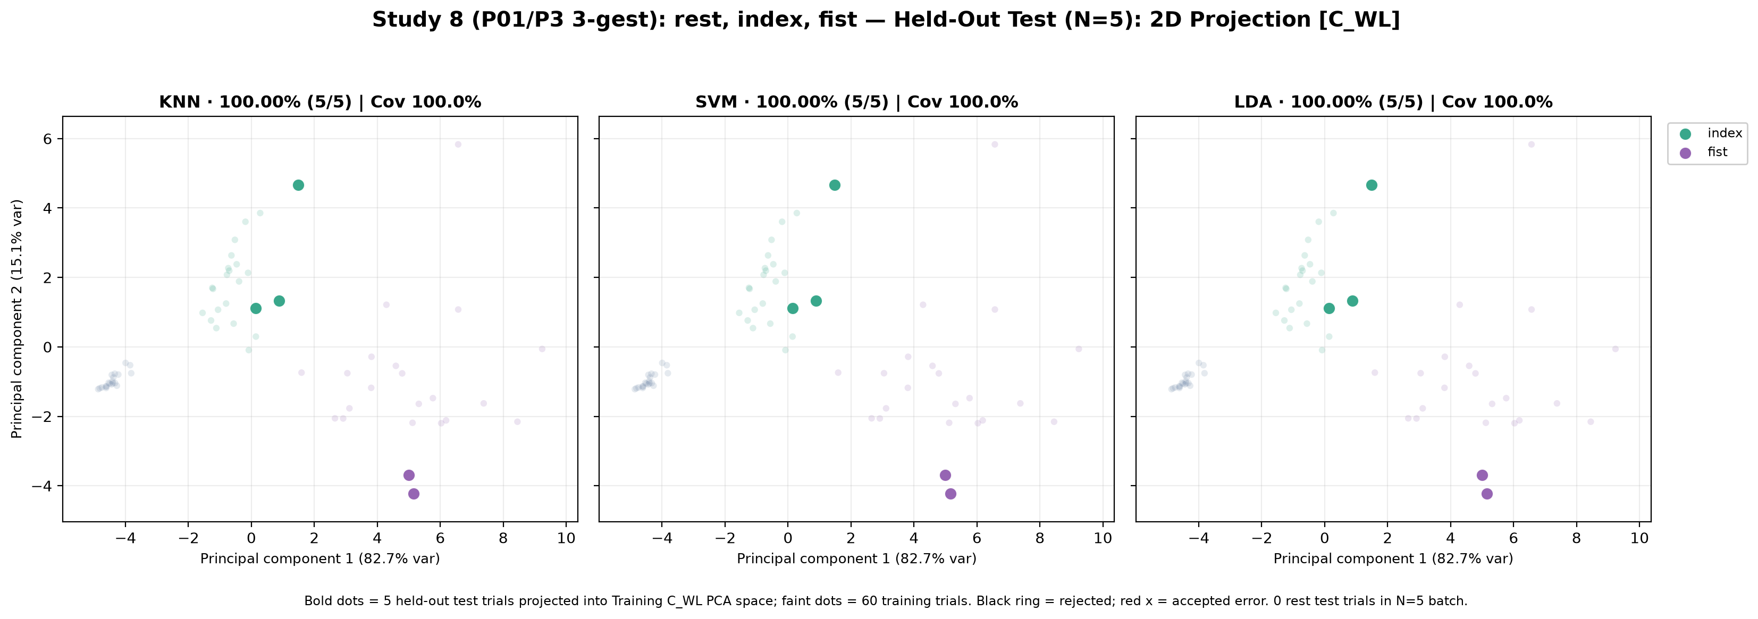
[picture p138: results/training_results/08_rest_index_fist_p3/Study08_P01_P3_rest_index_fist_test_C_WL_KNN_SVM_LDA_2D.png]


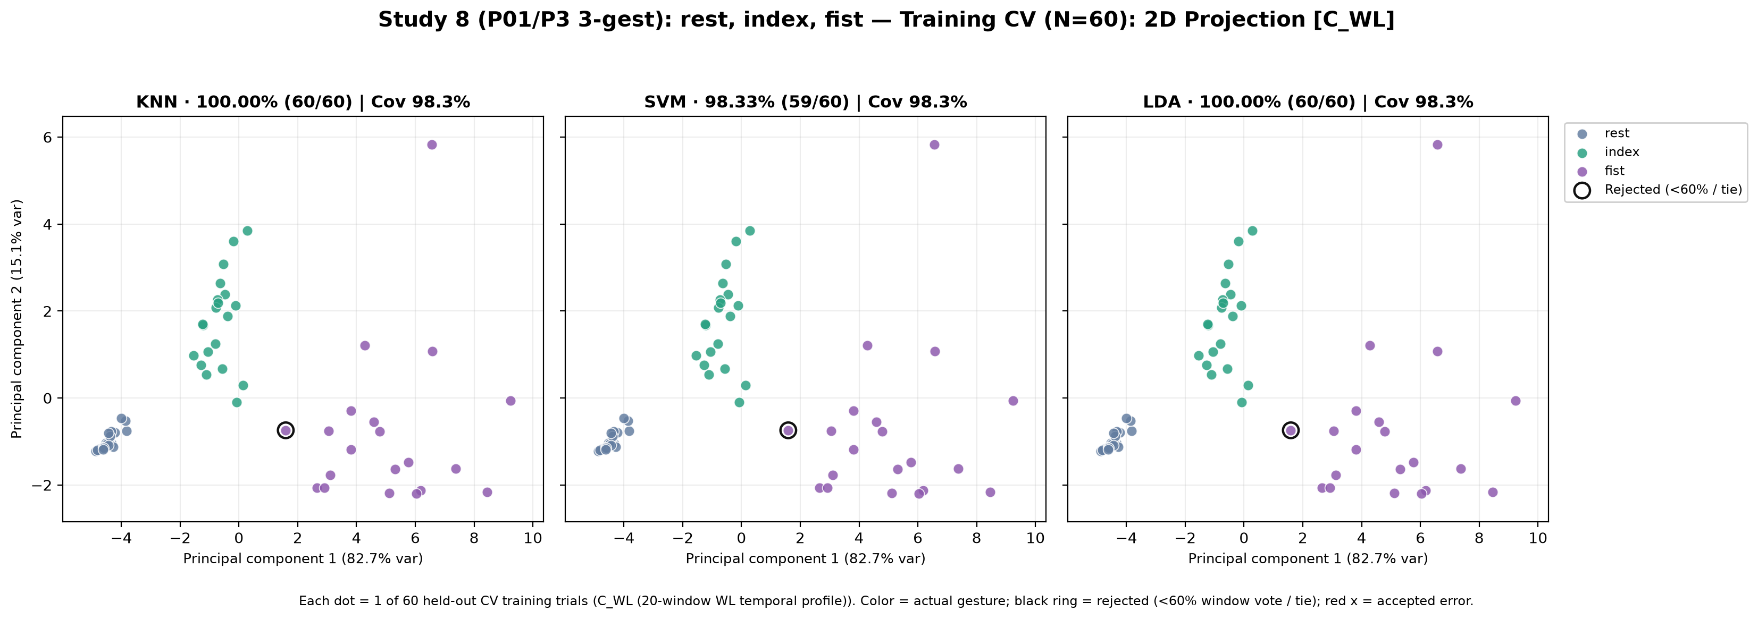
[picture p139: results/training_results/08_rest_index_fist_p3/Study08_P01_P3_rest_index_fist_training_C_WL_KNN_SVM_LDA_2D.png]


### 3D Feature Projections & Decision Boundaries

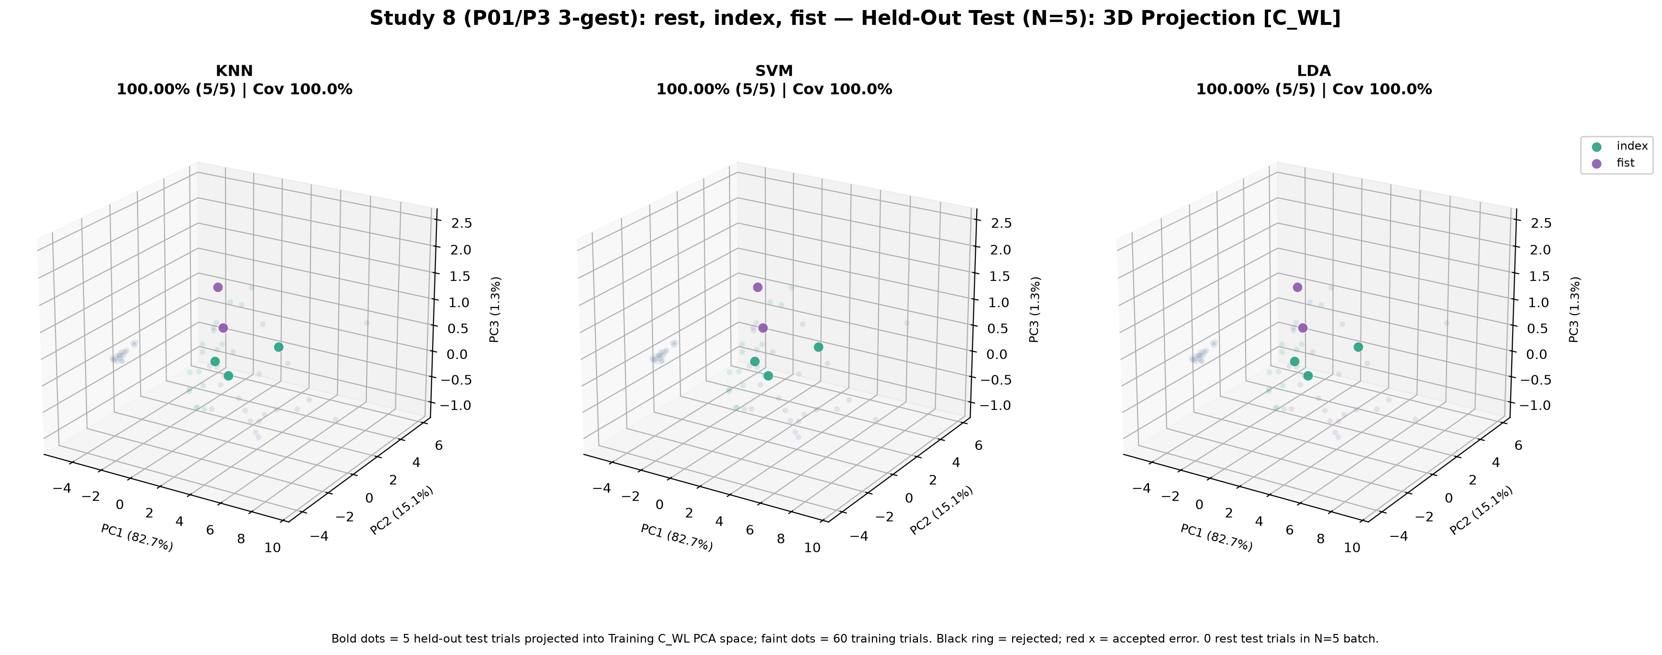
[picture p140: results/training_results/08_rest_index_fist_p3/Study08_P01_P3_rest_index_fist_test_C_WL_KNN_SVM_LDA_3D.png]


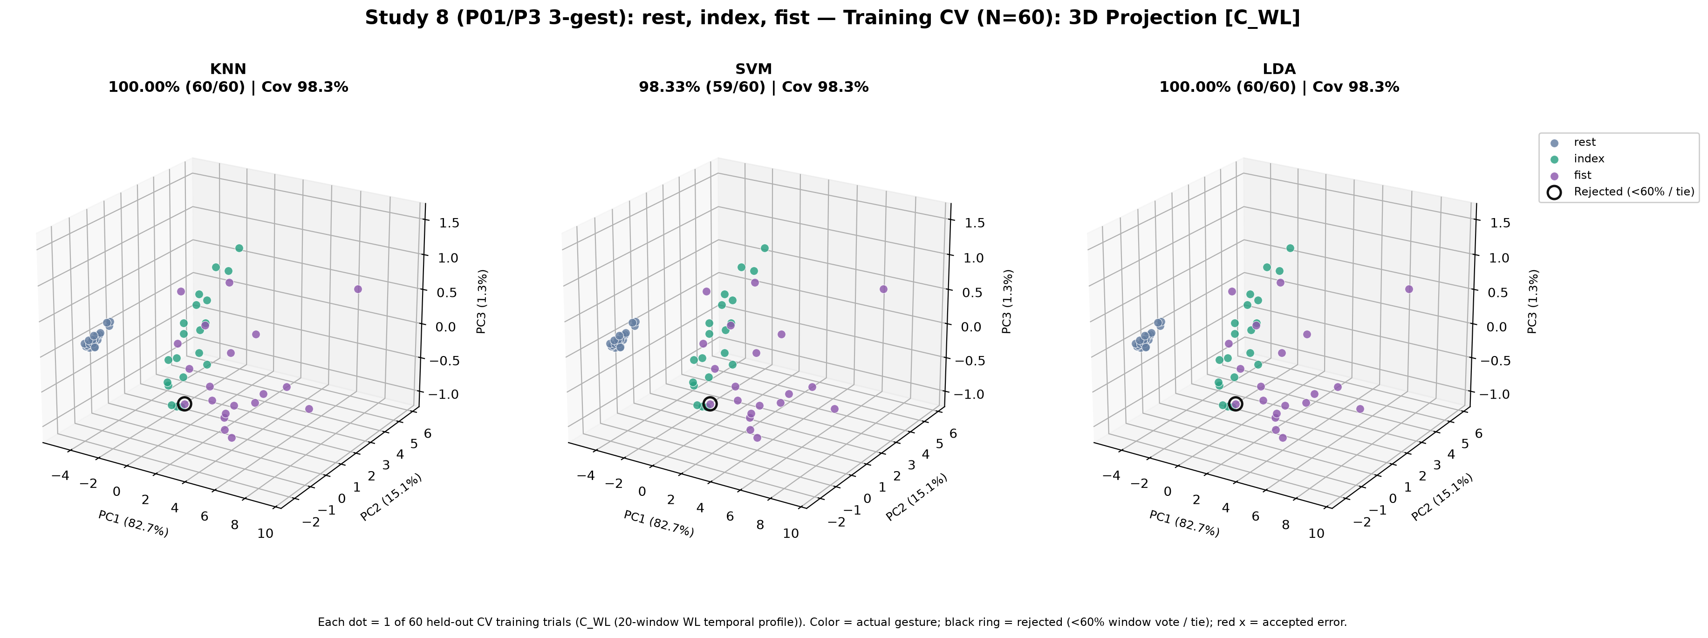
[picture p141: results/training_results/08_rest_index_fist_p3/Study08_P01_P3_rest_index_fist_training_C_WL_KNN_SVM_LDA_3D.png]


### Classifier Decision Boundary Gradient Heatmaps

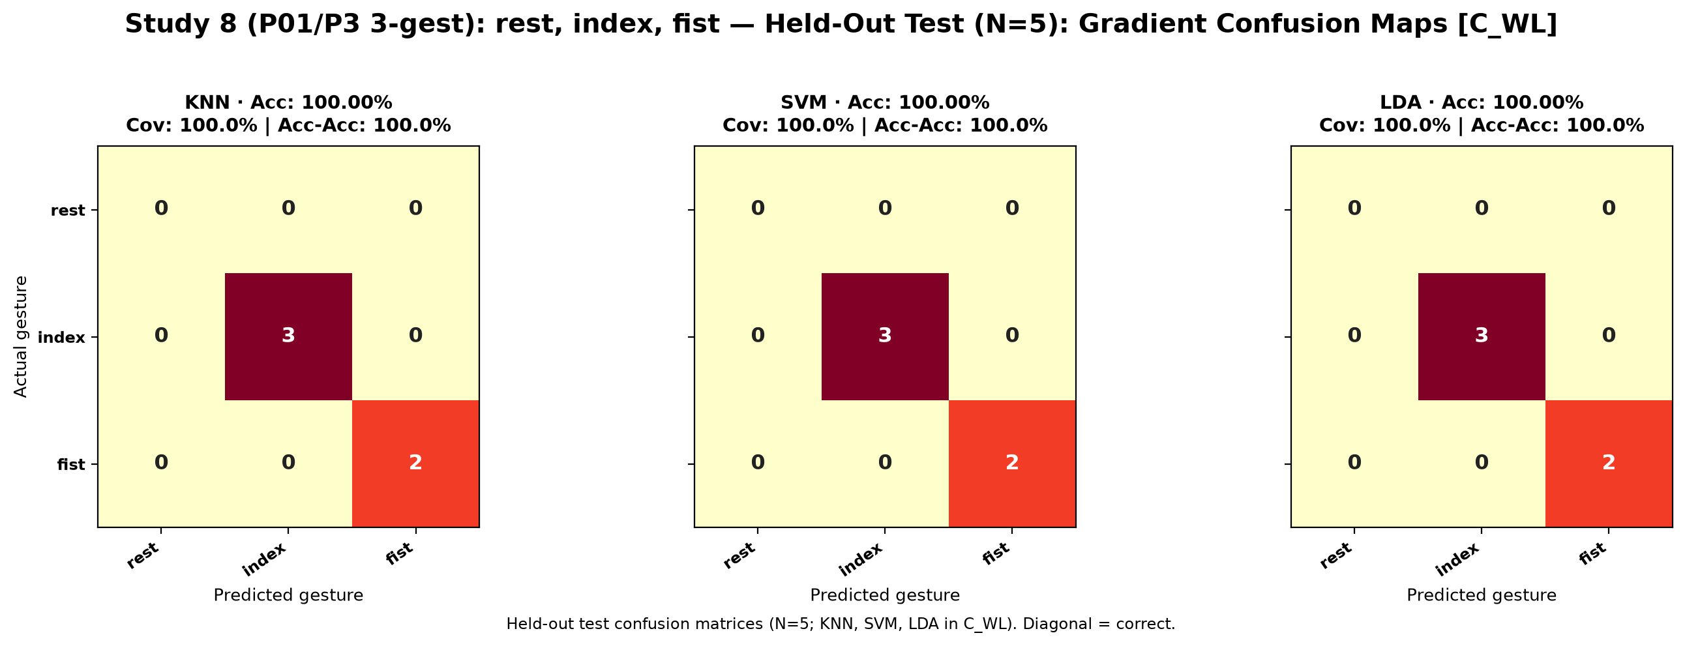
[picture p142: results/training_results/08_rest_index_fist_p3/Study08_P01_P3_rest_index_fist_test_C_WL_KNN_SVM_LDA_gradient_heatmaps.png]


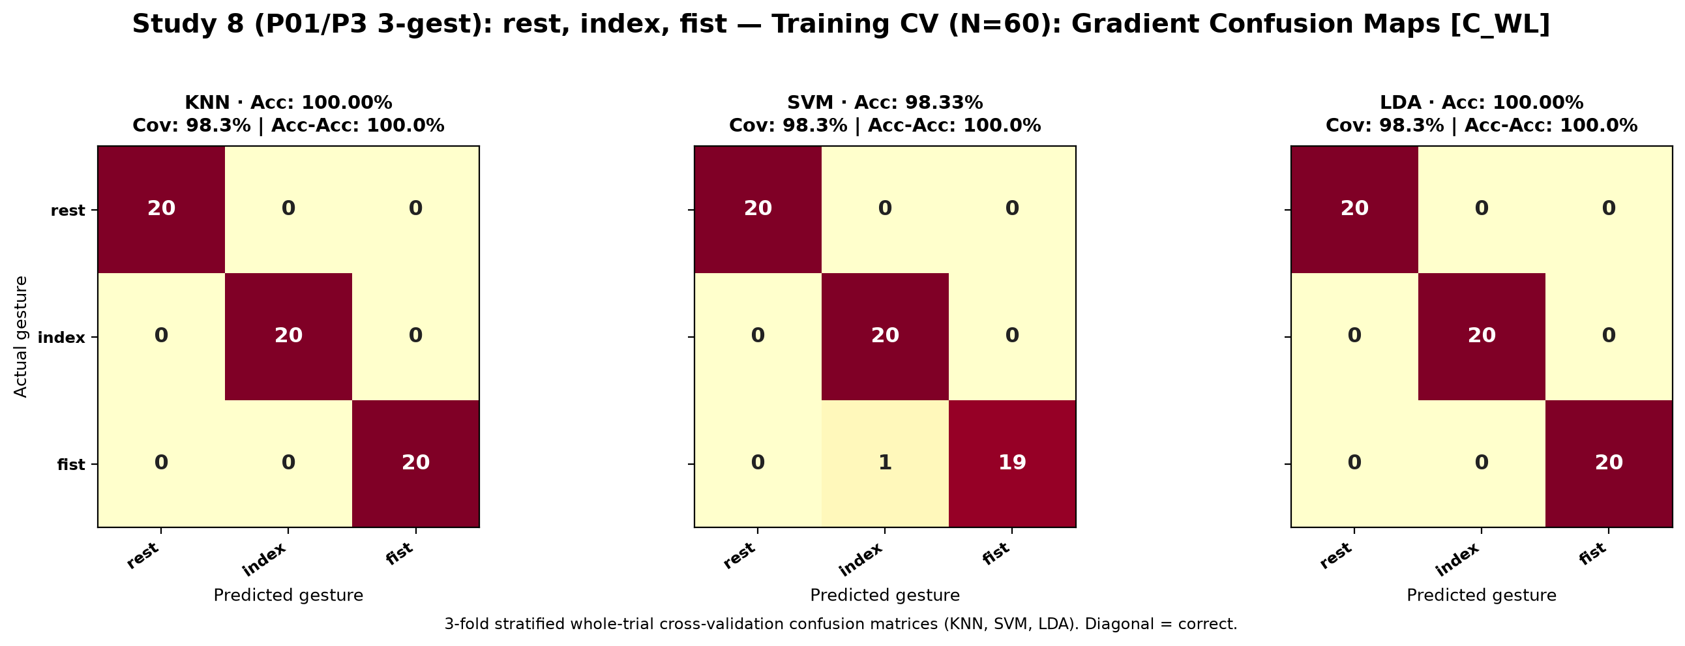
[picture p143: results/training_results/08_rest_index_fist_p3/Study08_P01_P3_rest_index_fist_training_C_WL_KNN_SVM_LDA_gradient_heatmaps.png]
