PrithviBhende/emg-teleoperation-ros2/results/training_results/09_rest_thumb_index_fist_p3/README.md

# Study 9: rest, thumb, index, fist (Placement P3 Multi-Session)

- **Subject**: P01
- **Electrode Placement**: P3
- **Champion / Evaluated Model**: `G_TF8__SVM / F_MAV_MAX_MIN__KNN`
- **3-Fold Cross-Validation Accuracy**: 96.25% (77/80)
- **Held-Out Test Accuracy**: 83.33% (N=30) / 87.27% (N=55 Best Test)

---

## Graphical Representations & Decision Boundaries

### 2D Feature Projections & Decision Boundaries

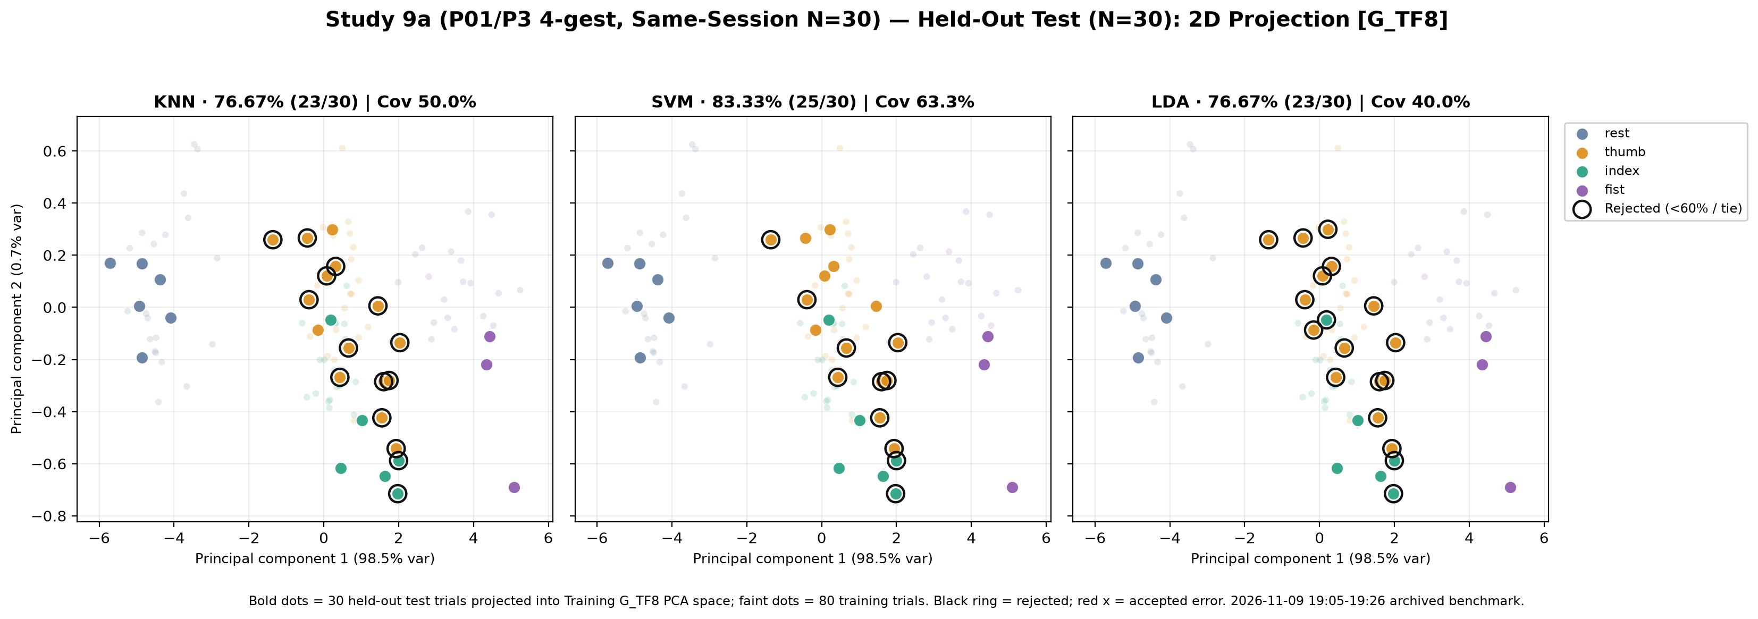
[picture p144: results/training_results/09_rest_thumb_index_fist_p3/Study09a_P01_P3_rest_thumb_index_fist_test_N30_G_TF8_KNN_SVM_LDA_2D.png]


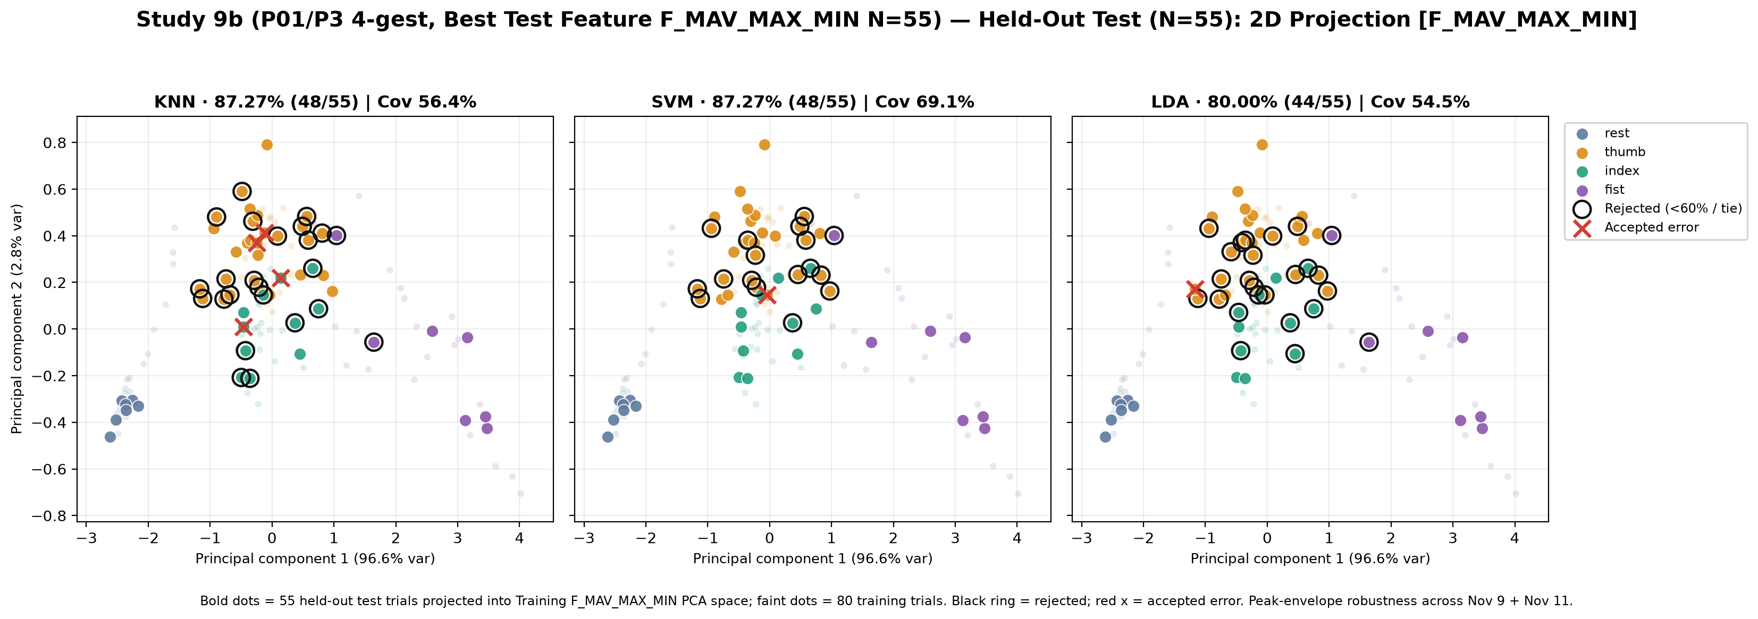
[picture p145: results/training_results/09_rest_thumb_index_fist_p3/Study09b_P01_P3_rest_thumb_index_fist_test_N55_best_F_MAV_MAX_MIN_KNN_SVM_LDA_2D.png]


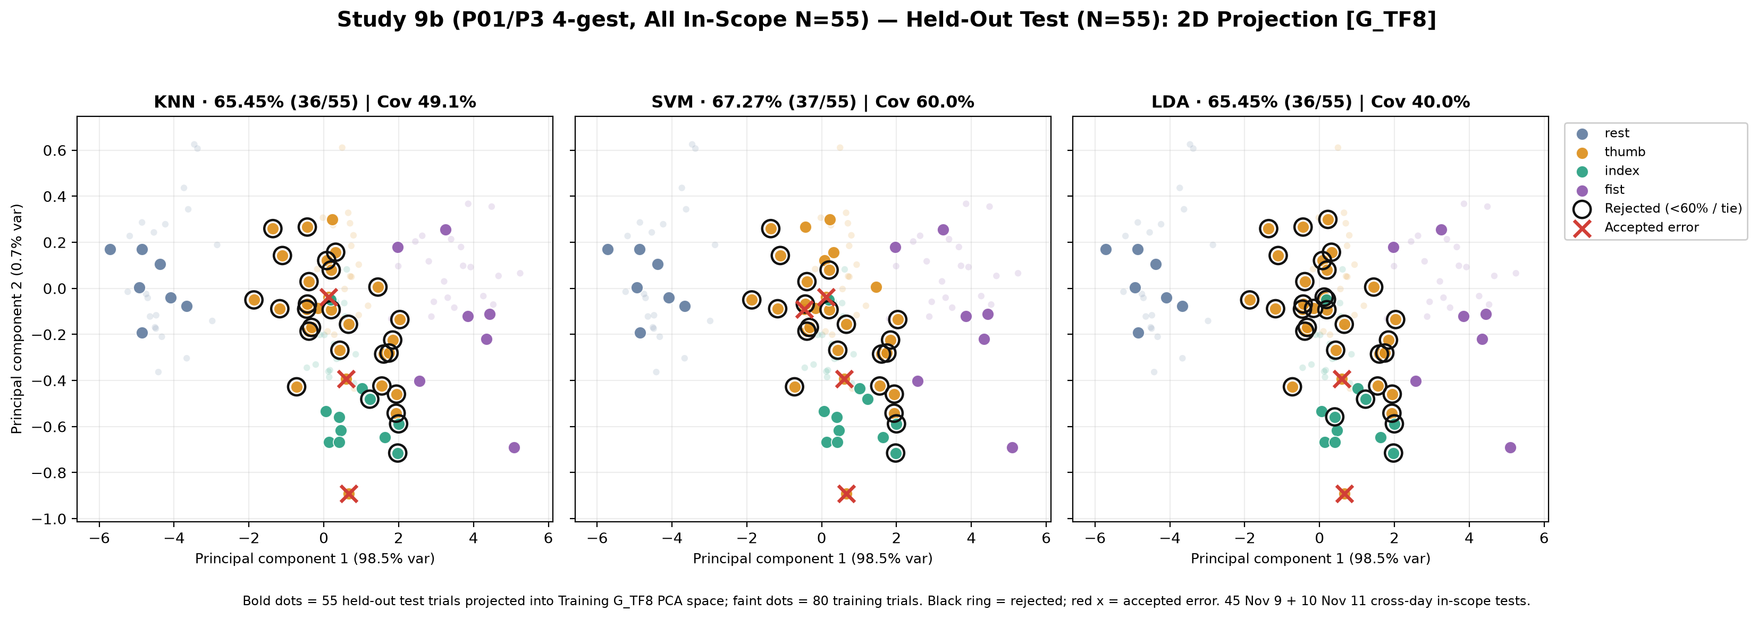
[picture p146: results/training_results/09_rest_thumb_index_fist_p3/Study09b_P01_P3_rest_thumb_index_fist_test_N55_inscope_G_TF8_KNN_SVM_LDA_2D.png]


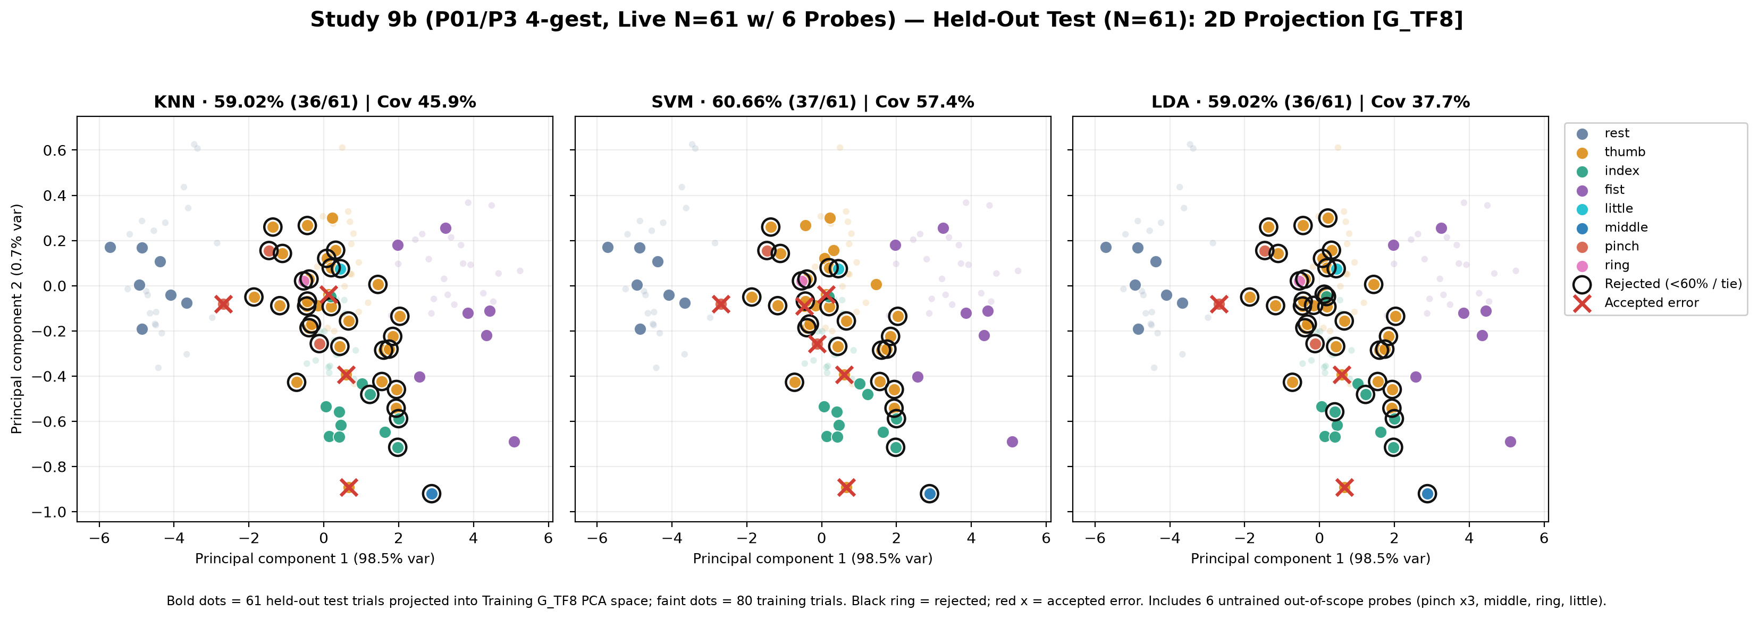
[picture p147: results/training_results/09_rest_thumb_index_fist_p3/Study09b_P01_P3_rest_thumb_index_fist_test_N61_live_G_TF8_KNN_SVM_LDA_2D.png]


### 3D Feature Projections & Decision Boundaries

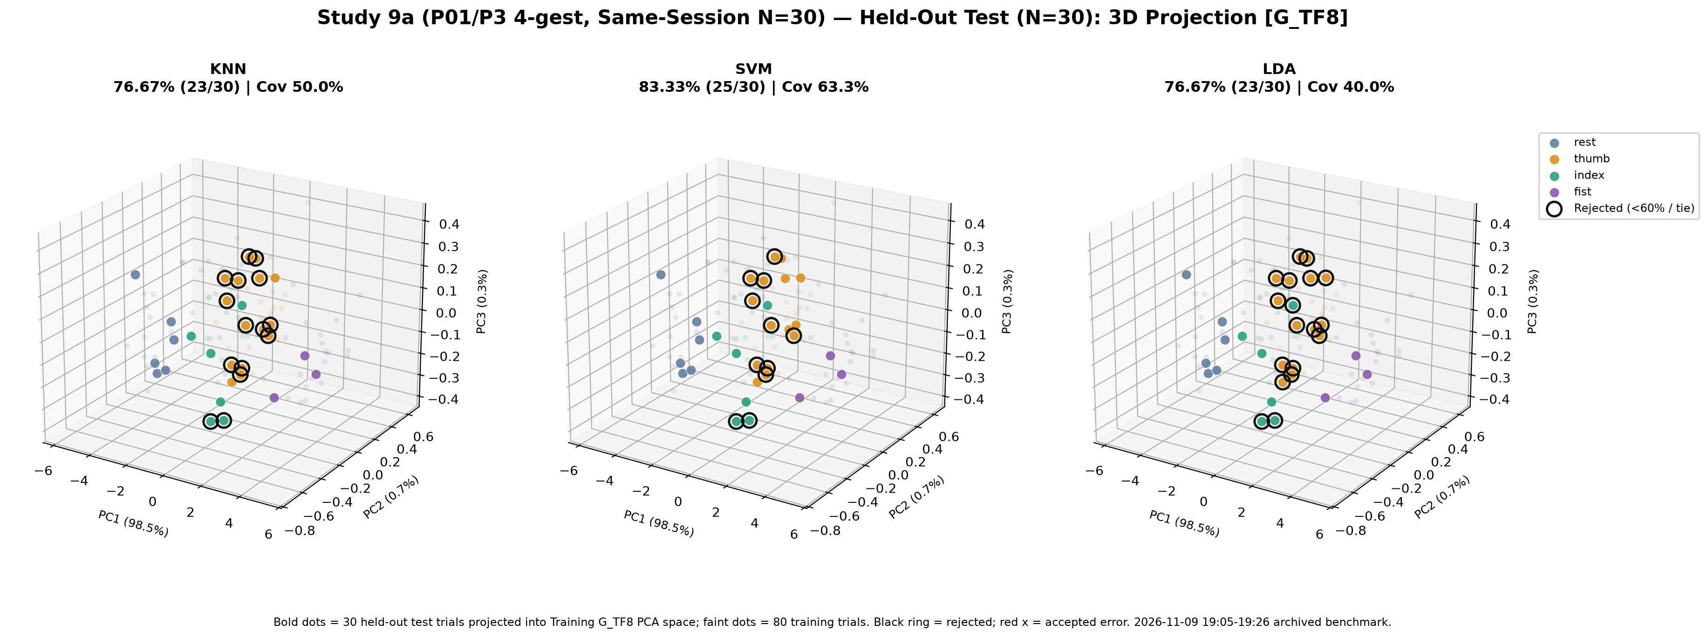
[picture p148: results/training_results/09_rest_thumb_index_fist_p3/Study09a_P01_P3_rest_thumb_index_fist_test_N30_G_TF8_KNN_SVM_LDA_3D.png]


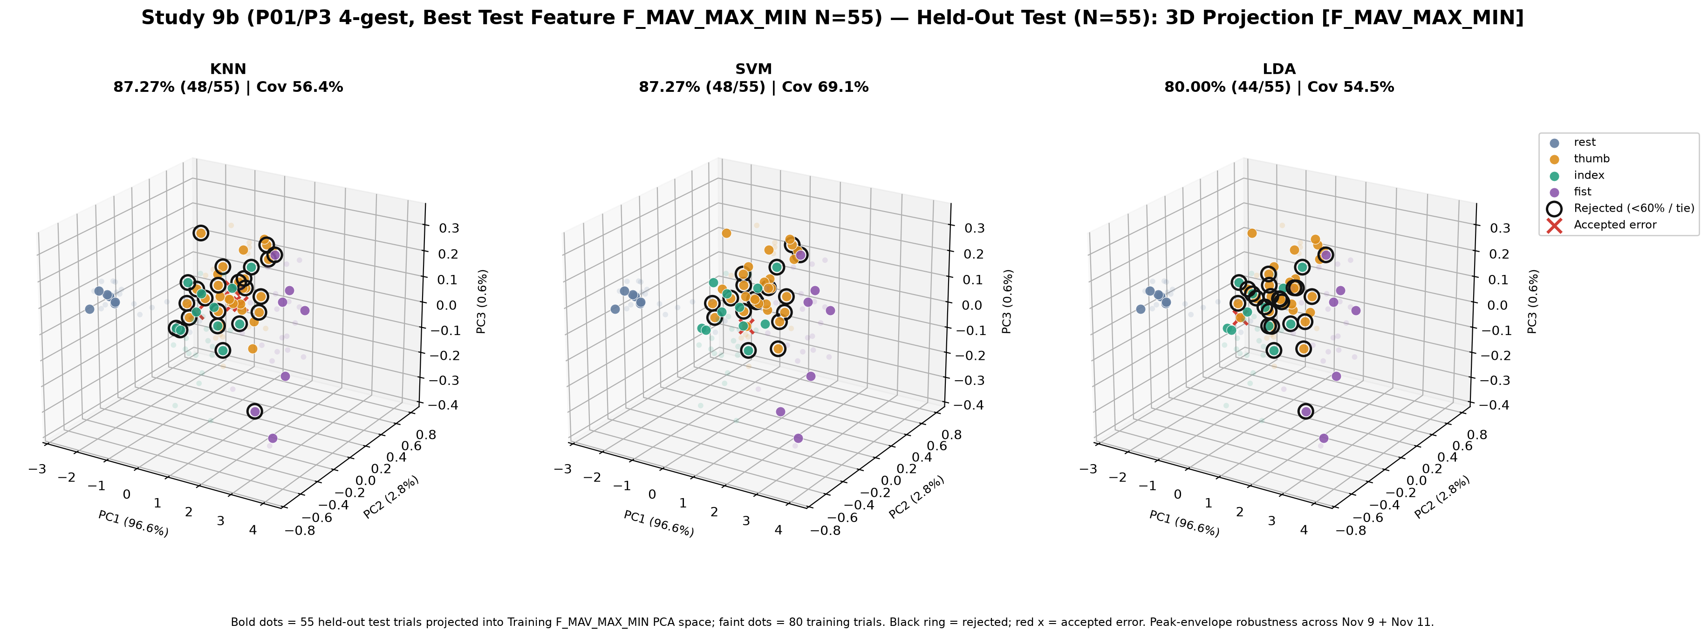
[picture p149: results/training_results/09_rest_thumb_index_fist_p3/Study09b_P01_P3_rest_thumb_index_fist_test_N55_best_F_MAV_MAX_MIN_KNN_SVM_LDA_3D.png]


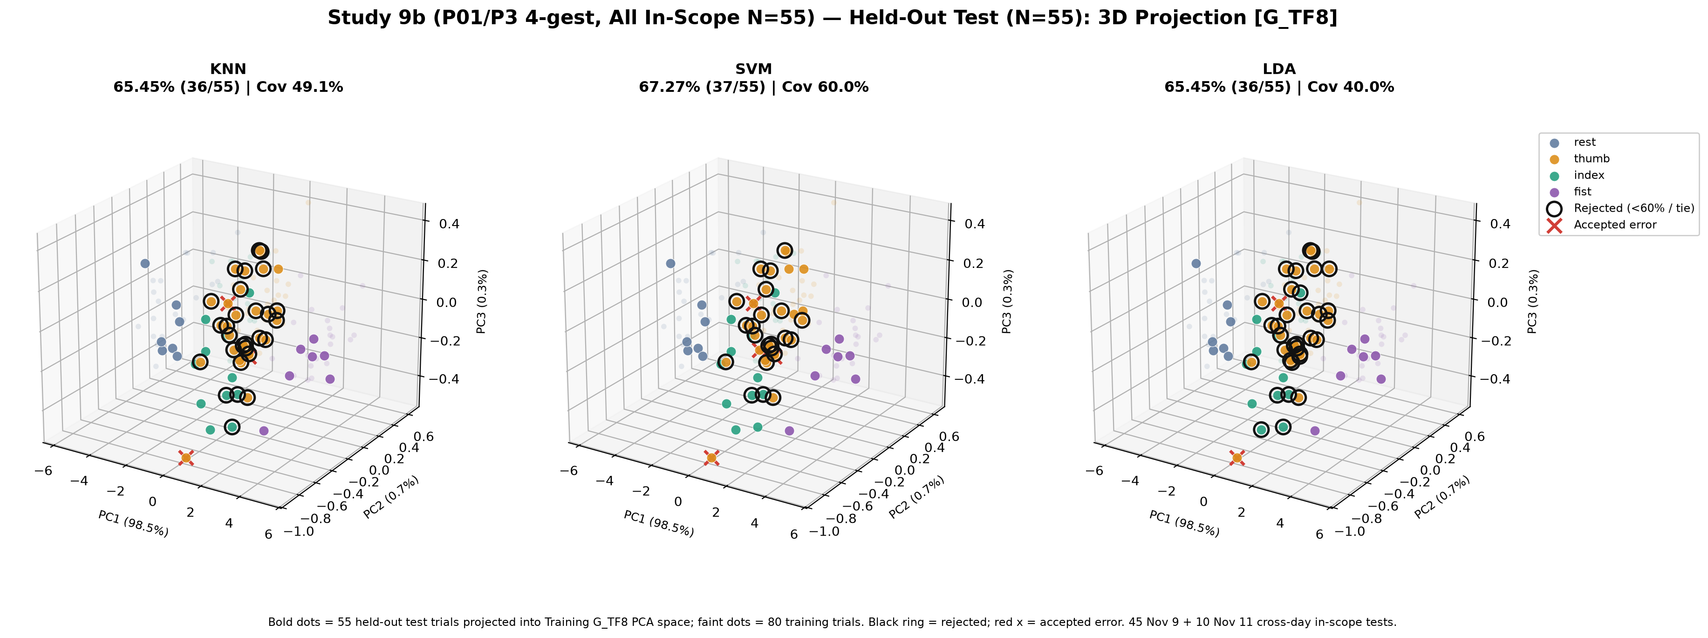
[picture p150: results/training_results/09_rest_thumb_index_fist_p3/Study09b_P01_P3_rest_thumb_index_fist_test_N55_inscope_G_TF8_KNN_SVM_LDA_3D.png]


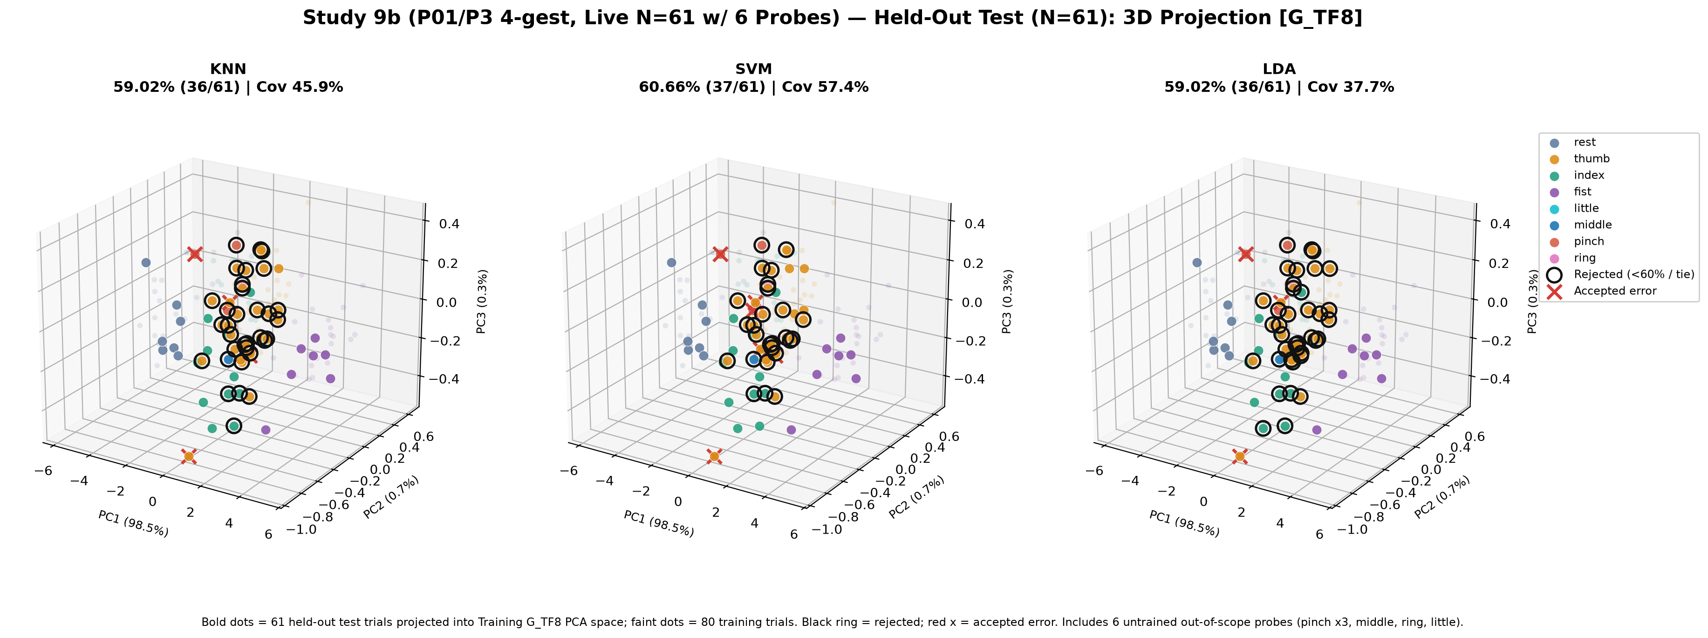
[picture p151: results/training_results/09_rest_thumb_index_fist_p3/Study09b_P01_P3_rest_thumb_index_fist_test_N61_live_G_TF8_KNN_SVM_LDA_3D.png]


### Classifier Decision Boundary Gradient Heatmaps

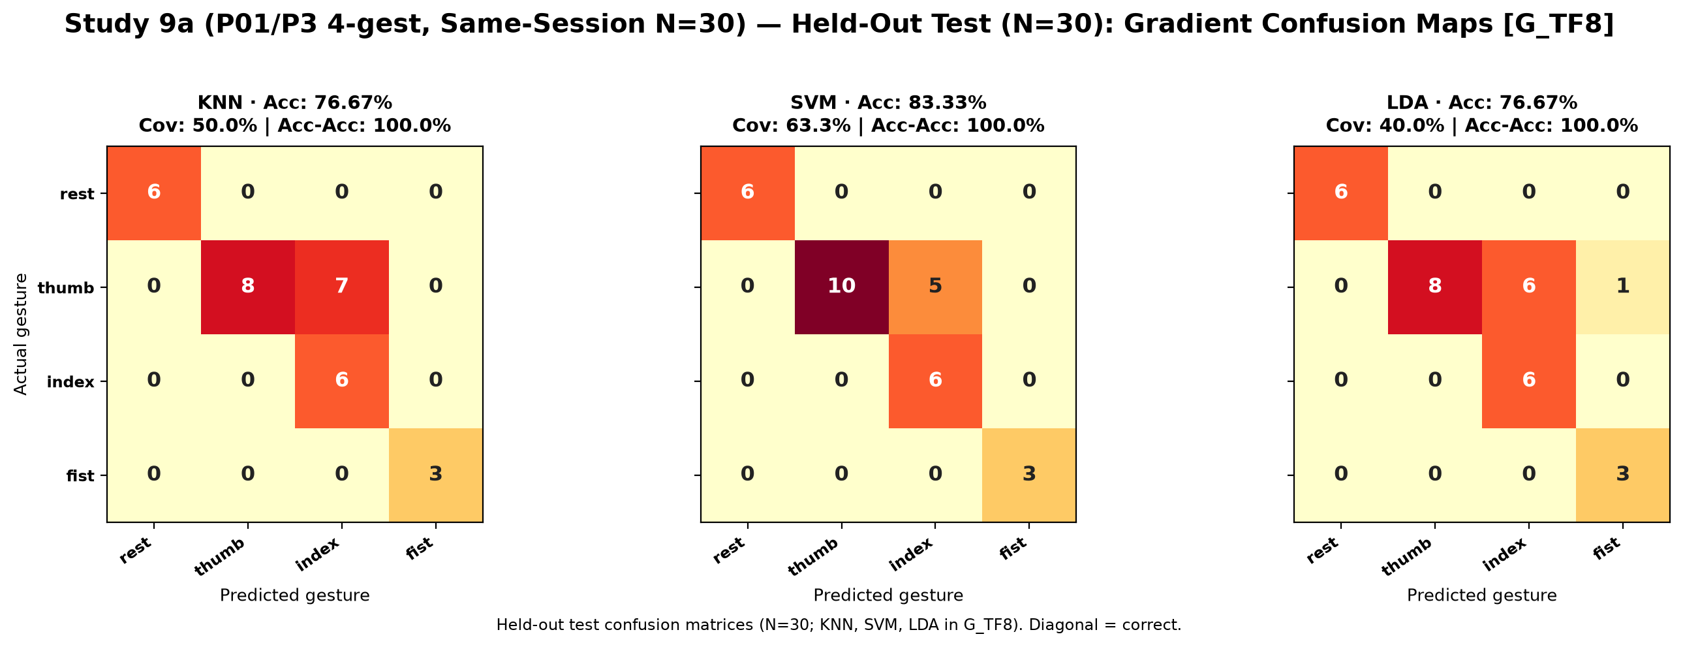
[picture p152: results/training_results/09_rest_thumb_index_fist_p3/Study09a_P01_P3_rest_thumb_index_fist_test_N30_G_TF8_KNN_SVM_LDA_gradient_heatmaps.png]
Study09a_P01_P3_rest_thumb_index_fist_test_N30_G_TF8_KNN_SVM_LDA_gradient_heatmaps.png


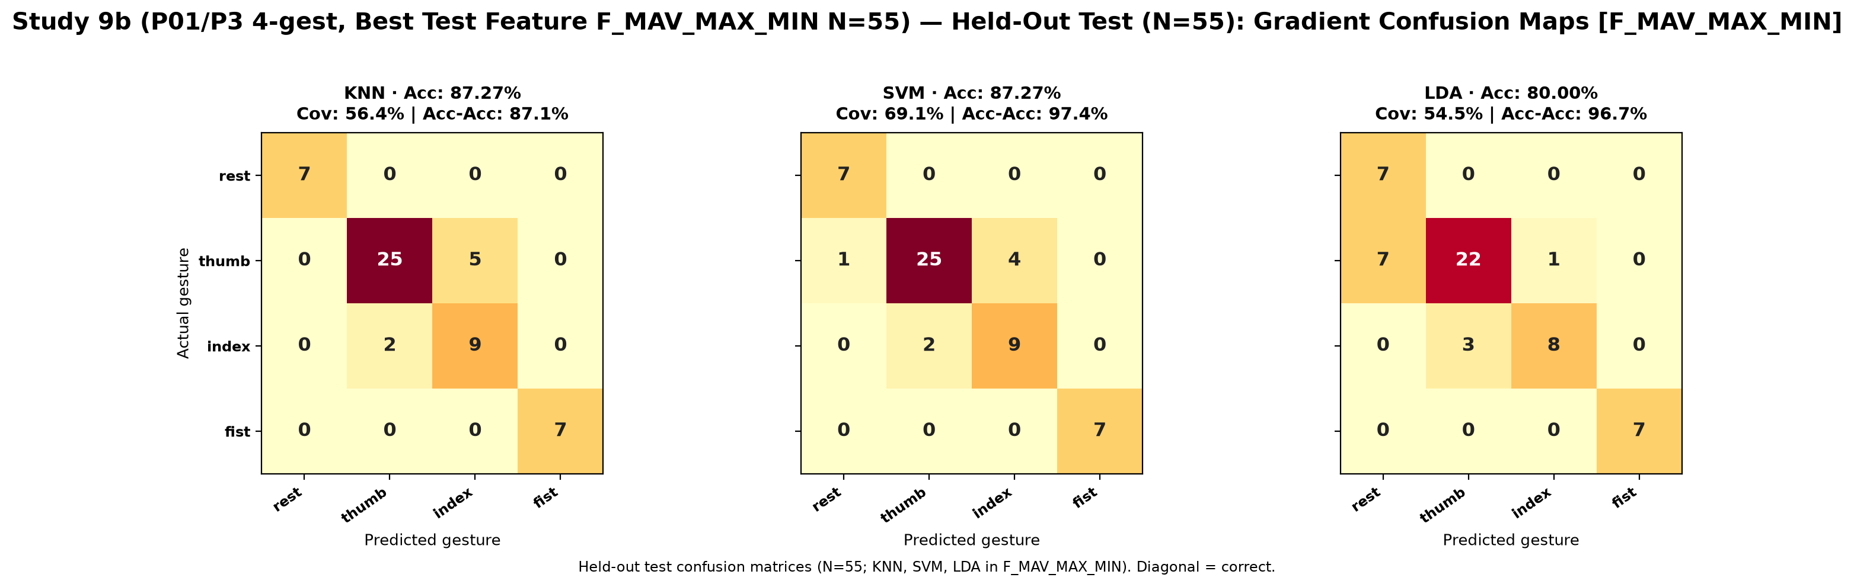
[picture p153: results/training_results/09_rest_thumb_index_fist_p3/Study09b_P01_P3_rest_thumb_index_fist_test_N55_best_F_MAV_MAX_MIN_KNN_SVM_LDA_gradient_heatmaps.png]
Study09b_P01_P3_rest_thumb_index_fist_test_N55_best_F_MAV_MAX_MIN_KNN_SVM_LDA_gradient_heatmaps.png


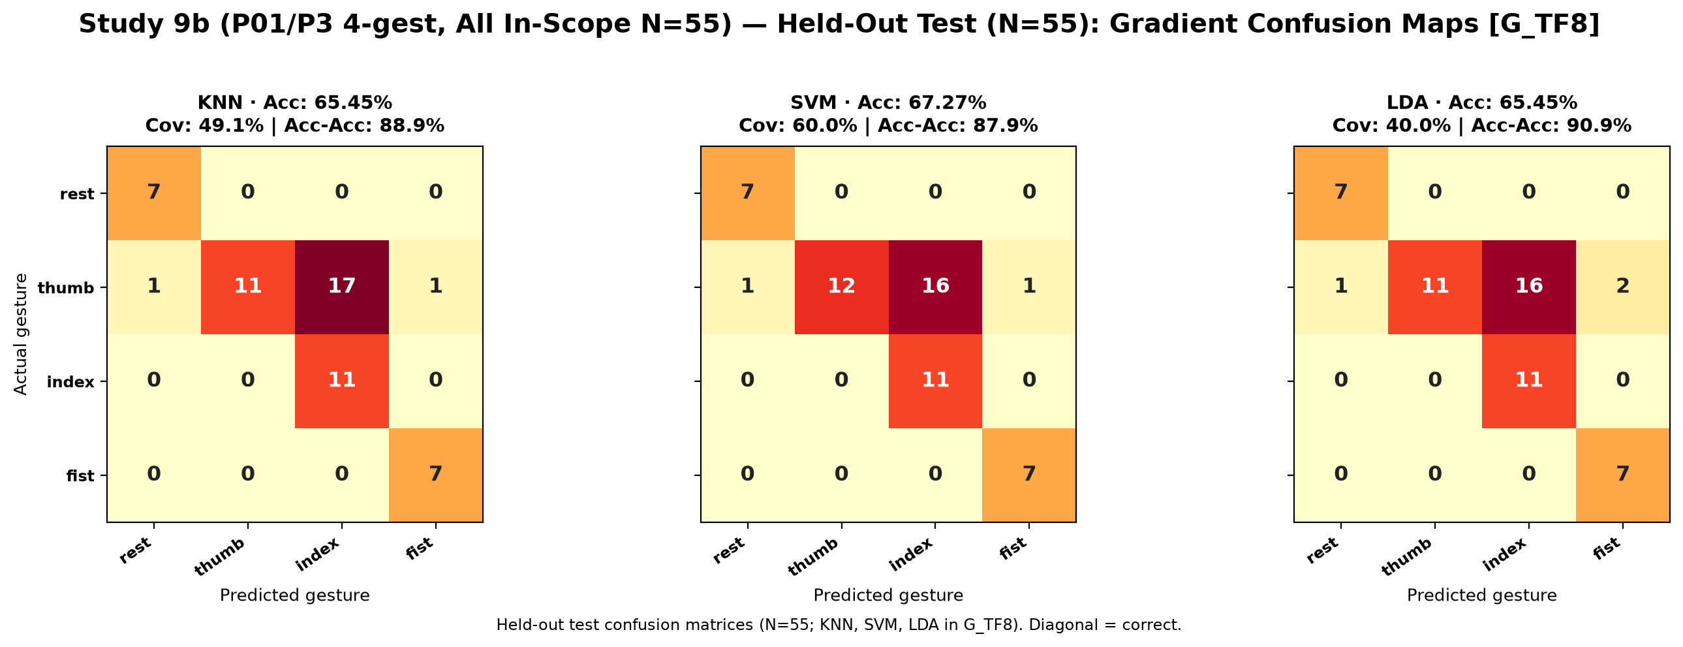
[picture p154: results/training_results/09_rest_thumb_index_fist_p3/Study09b_P01_P3_rest_thumb_index_fist_test_N55_inscope_G_TF8_KNN_SVM_LDA_gradient_heatmaps.png]
Study09b_P01_P3_rest_thumb_index_fist_test_N55_inscope_G_TF8_KNN_SVM_LDA_gradient_heatmaps.png


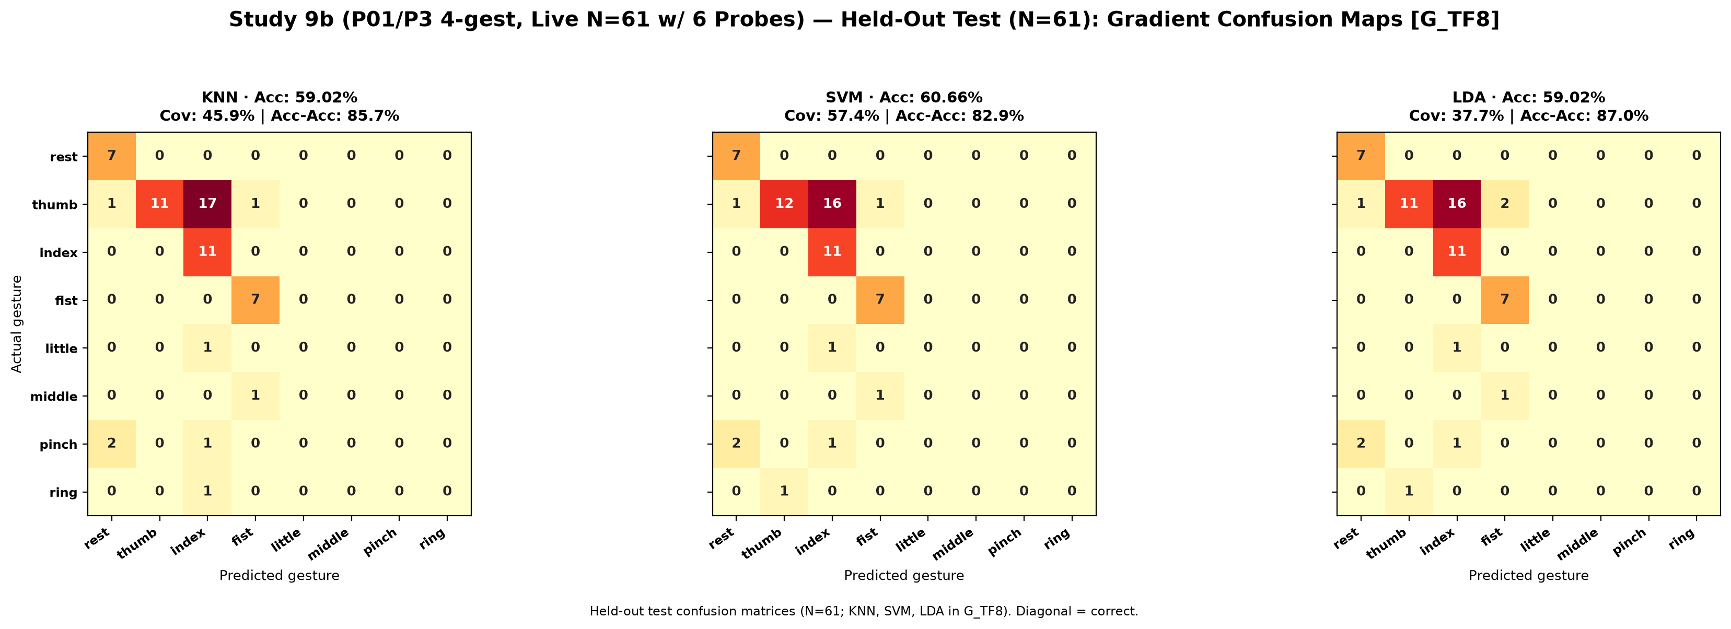
[picture p155: results/training_results/09_rest_thumb_index_fist_p3/Study09b_P01_P3_rest_thumb_index_fist_test_N61_live_G_TF8_KNN_SVM_LDA_gradient_heatmaps.png]
Study09b_P01_P3_rest_thumb_index_fist_test_N61_live_G_TF8_KNN_SVM_LDA_gradient_heatmaps.png
