PrithviBhende/emg-teleoperation-ros2/hardware/ADS1296_6CH_sEMG/ADS1296_RevA4_TinySocket.kicad_pcb

## KiCad design hardware/ADS1296_6CH_sEMG/ADS1296_RevA4_TinySocket.kicad_pcb (2026-11-13)

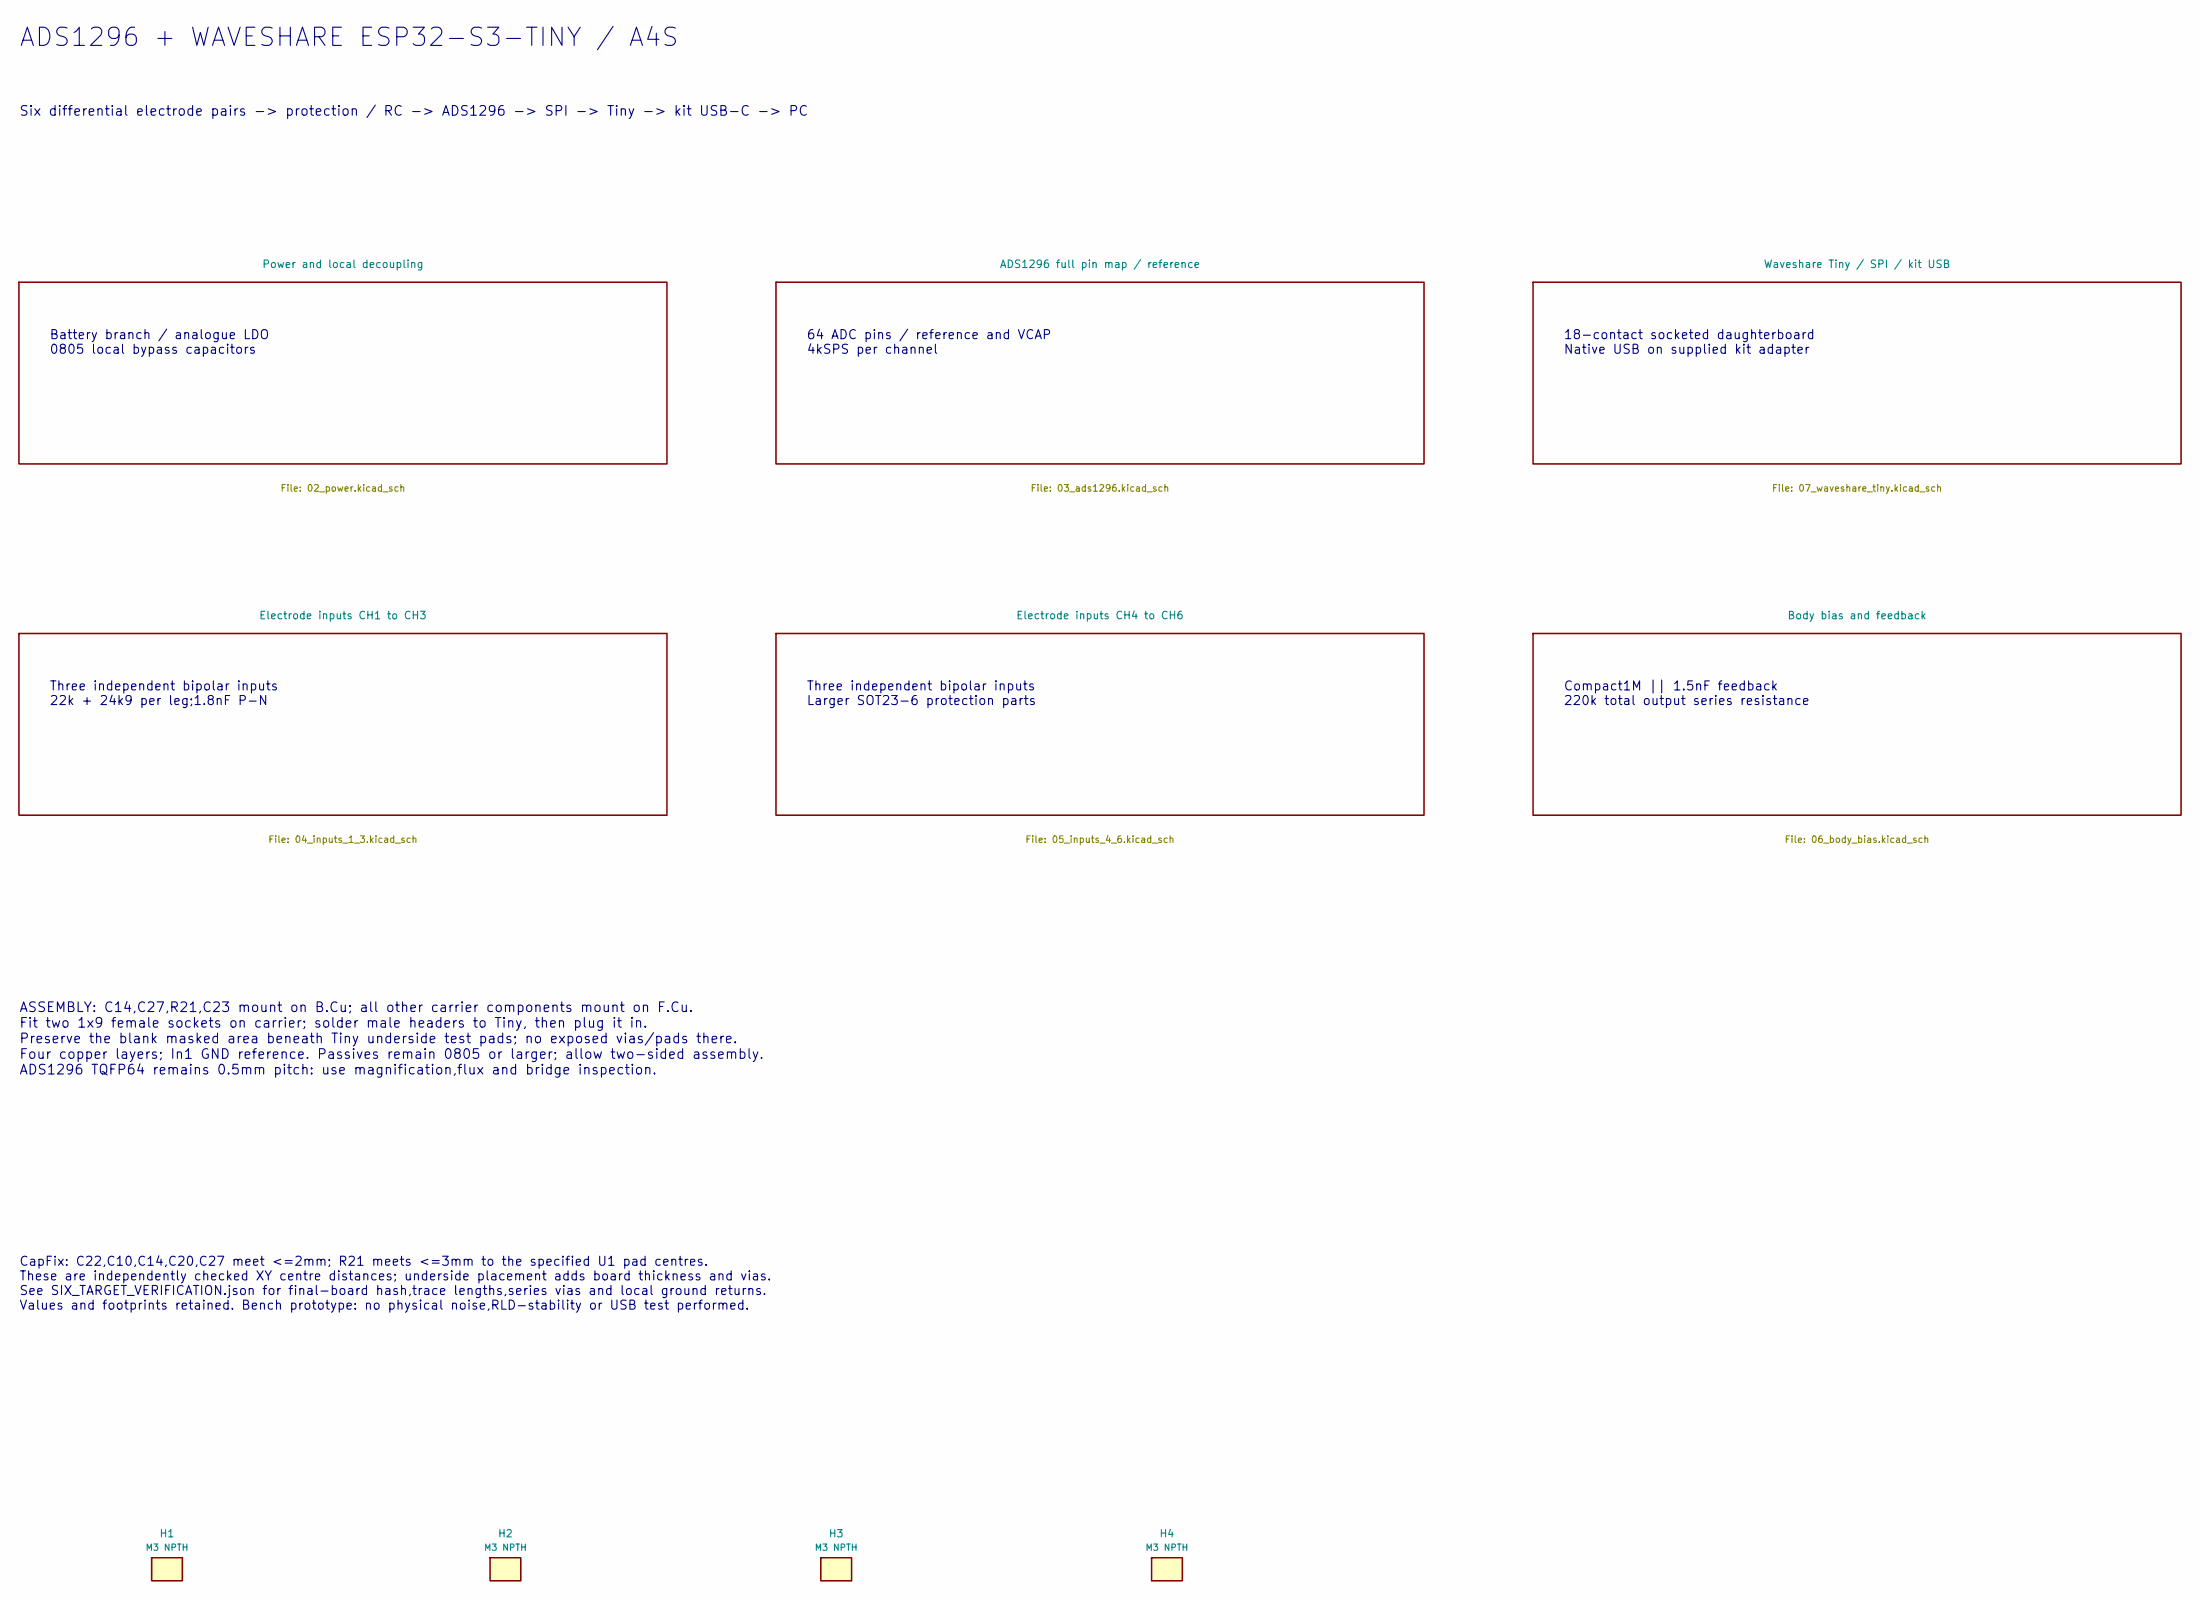
[picture p156: schematic ADS1296_RevA4_TinySocket.kicad_sch, 01 - Architecture / assembly]

Parts:
H1, H2, H3, H4: M3 NPTH; MountingHole_3.2mm_M3; MPN M3 nylon screw + spacer

Notes on the sheet:
ADS1296 + WAVESHARE ESP32-S3-TINY / A4S
Six differential electrode pairs -> protection / RC -> ADS1296 -> SPI -> Tiny -> kit USB-C -> PC
Battery branch / analogue LDO 0805 local bypass capacitors
64 ADC pins / reference and VCAP 4kSPS per channel
18-contact socketed daughterboard Native USB on supplied kit adapter
Three independent bipolar inputs 22k + 24k9 per leg;1.8nF P-N
Three independent bipolar inputs Larger SOT23-6 protection parts
Compact1M || 1.5nF feedback 220k total output series resistance
ASSEMBLY: C14,C27,R21,C23 mount on B.Cu; all other carrier components mount on F.Cu. Fit two 1x9 female sockets on carrier; solder male headers to Tiny, then plug it in. Preserve the blank masked area beneath Tiny underside test pads; no exposed vias/pads there. Four copper layers; In1 GND referenc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
CapFix: C22,C10,C14,C20,C27 meet <=2mm; R21 meets <=3mm to the specified U1 pad centres. These are independently checked XY centre distances; underside placement adds board thickness and vias. See SIX_TARGET_VERIFICATION.json for final-board hash,trace lengths,series vias and local ground returns. 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

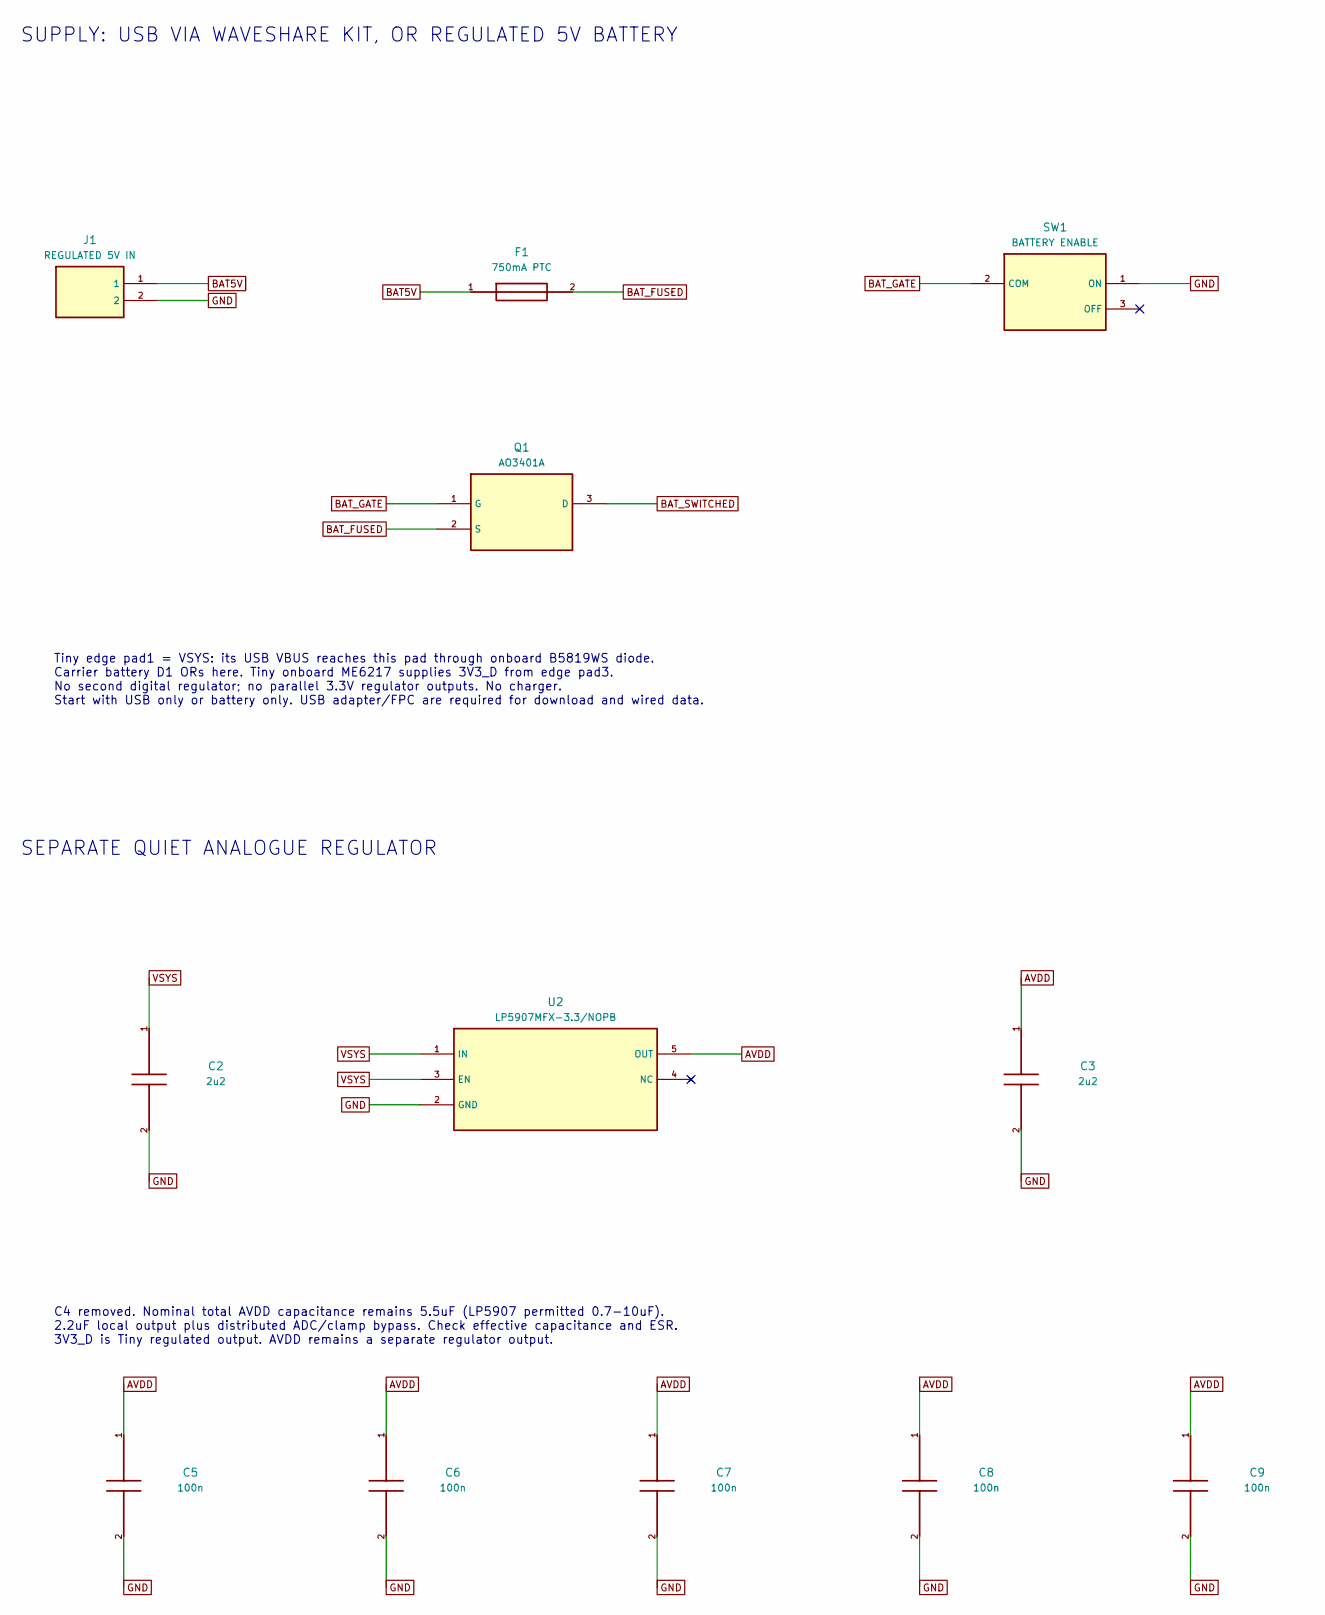
[picture p157: schematic 02_power.kicad_sch, 02 - Power and local decoupling, part in row 1, column 1]

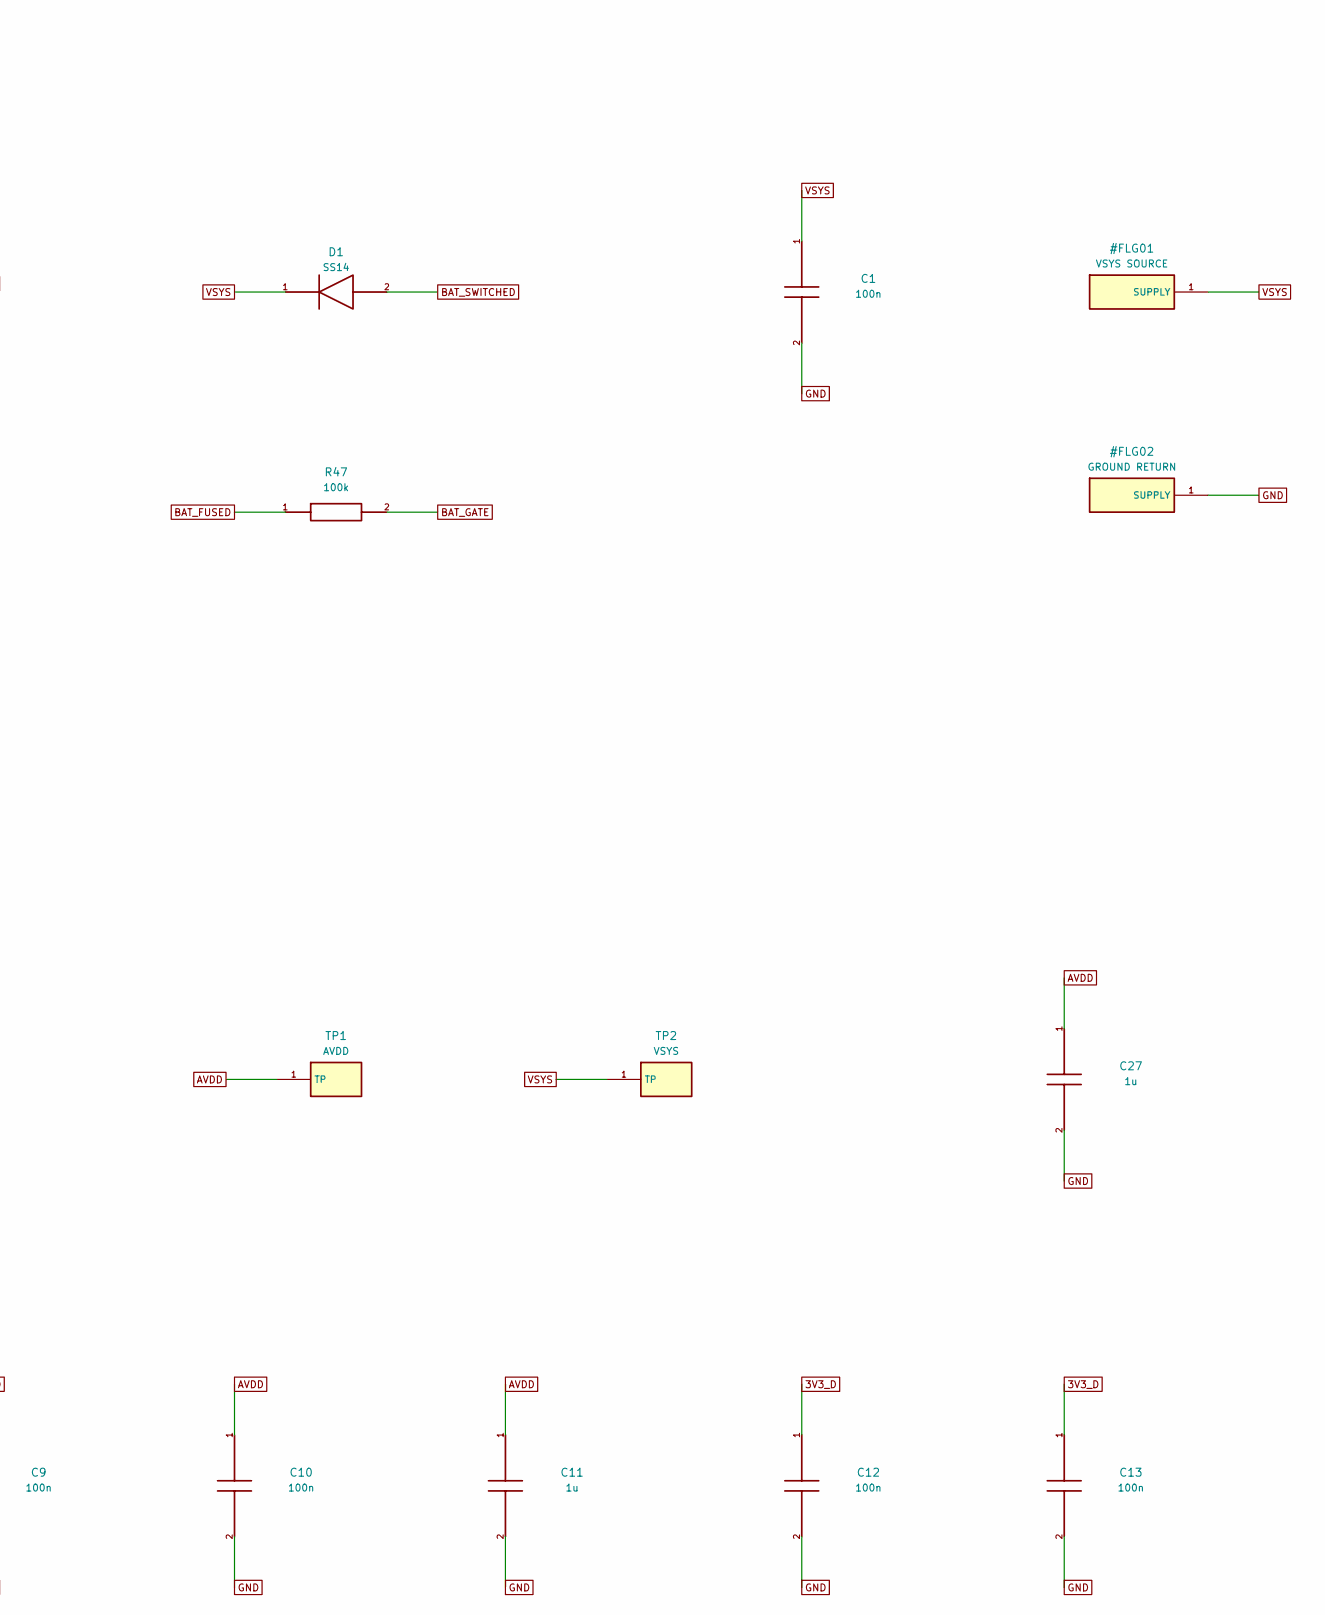
[picture p158: schematic 02_power.kicad_sch, 02 - Power and local decoupling, part in row 1, column 2]

Parts:
C1, C5, C6, C7, C8, C9, C10, C12, C13: 100n; C_0805_2012Metric; MPN C0805C104K4RACTU
C2, C3: 2u2; C_0805_2012Metric; MPN C0805C225K4RACTU
C11, C27: 1u; C_0805_2012Metric; MPN C0805C105K4RACTU
D1: SS14; D_SMA; MPN SS14
F1: 750mA PTC; Fuse_1812_4532Metric; MPN MF-MSMF075-2
J1: REGULATED 5V IN; JST_XH_B2B-XH-A_1x02_P2.50mm_Vertical; MPN B2B-XH-A(LF)(SN)
Q1: AO3401A; SOT-23; MPN AO3401A
R47: 100k; R_0805_2012Metric; MPN RC0805FR-07100KL
SW1: BATTERY ENABLE; SW_SPDT_CK_JS102011SAQN; MPN JS102011SAQN
TP1: AVDD; TestPoint_Pad_D1.5mm
TP2: VSYS; TestPoint_Pad_D1.5mm
U2: LP5907MFX-3.3/NOPB; SOT-23-5; MPN LP5907MFX-3.3/NOPB

Connections:
3V3_D: C12.1, C13.1; also elsewhere on the board
AVDD: C3.1, C5.1, C6.1, C7.1, C8.1, C9.1, C10.1, C11.1, C27.1, TP1.1, U2.5 (OUT); also elsewhere on the board
BAT5V: F1.1, J1.1
BAT_FUSED: F1.2, Q1.2 (S), R47.1
BAT_GATE: Q1.1 (G), R47.2, SW1.2 (COM)
BAT_SWITCHED: D1.2, Q1.3 (D)
GND: C1.2, C2.2, C3.2, C5.2, C6.2, C7.2, C8.2, C9.2, C10.2, C11.2, C12.2, C13.2, C27.2, J1.2, SW1.1 (ON), U2.2 (GND); also elsewhere on the board
VSYS: C1.1, C2.1, D1.1, TP2.1, U2.1 (IN), U2.3 (EN); also elsewhere on the board

Notes on the sheet:
SUPPLY: USB VIA WAVESHARE KIT, OR REGULATED 5V BATTERY
Tiny edge pad1 = VSYS: its USB VBUS reaches this pad through onboard B5819WS diode. Carrier battery D1 ORs here. Tiny onboard ME6217 supplies 3V3_D from edge pad3. No second digital regulator; no parallel 3.3V regulator outputs. No charger. Start with USB only or battery only. USB adapter/FPC are r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
SEPARATE QUIET ANALOGUE REGULATOR
C4 removed. Nominal total AVDD capacitance remains 5.5uF (LP5907 permitted 0.7-10uF). 2.2uF local output plus distributed ADC/clamp bypass. Check effective capacitance and ESR. 3V3_D is Tiny regulated output. AVDD remains a separate regulator output.

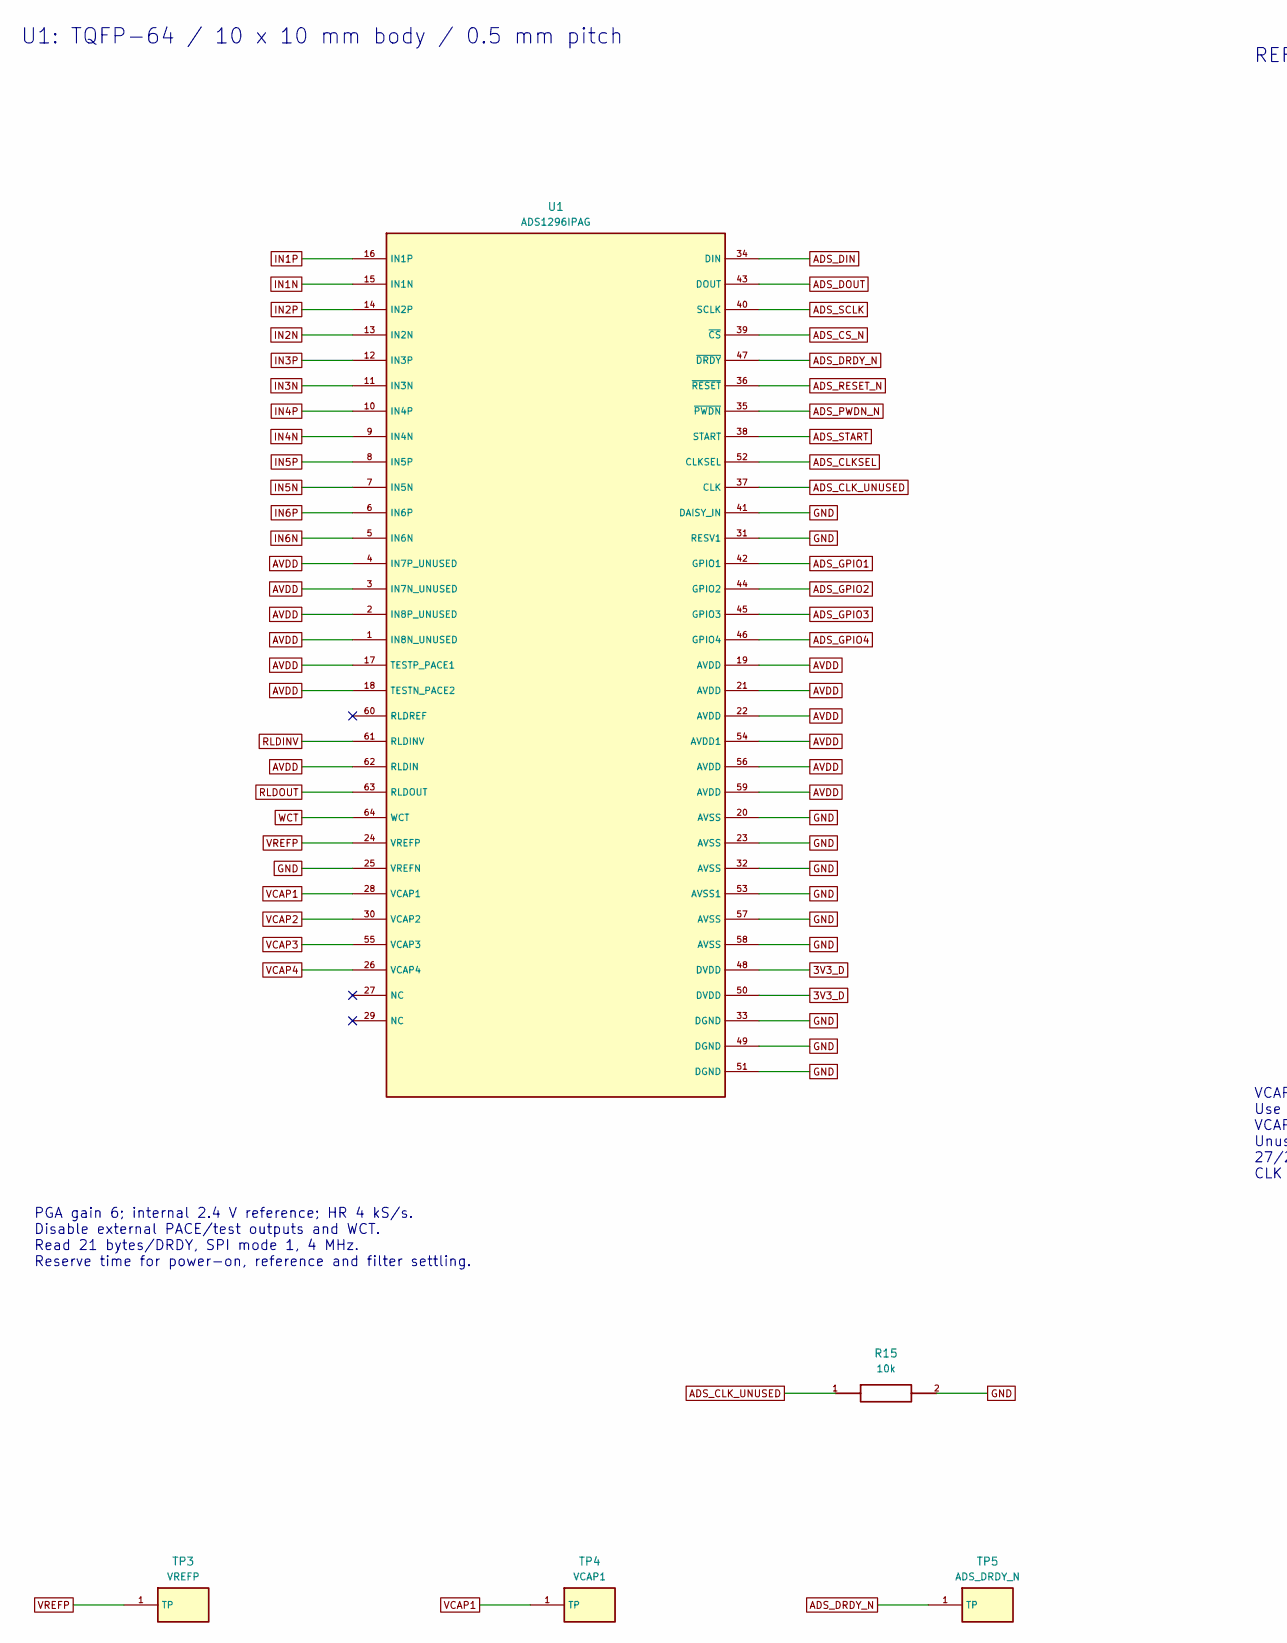
[picture p159: schematic 03_ads1296.kicad_sch, 03 - ADS1296 full pin map / reference, part in row 1, column 1]

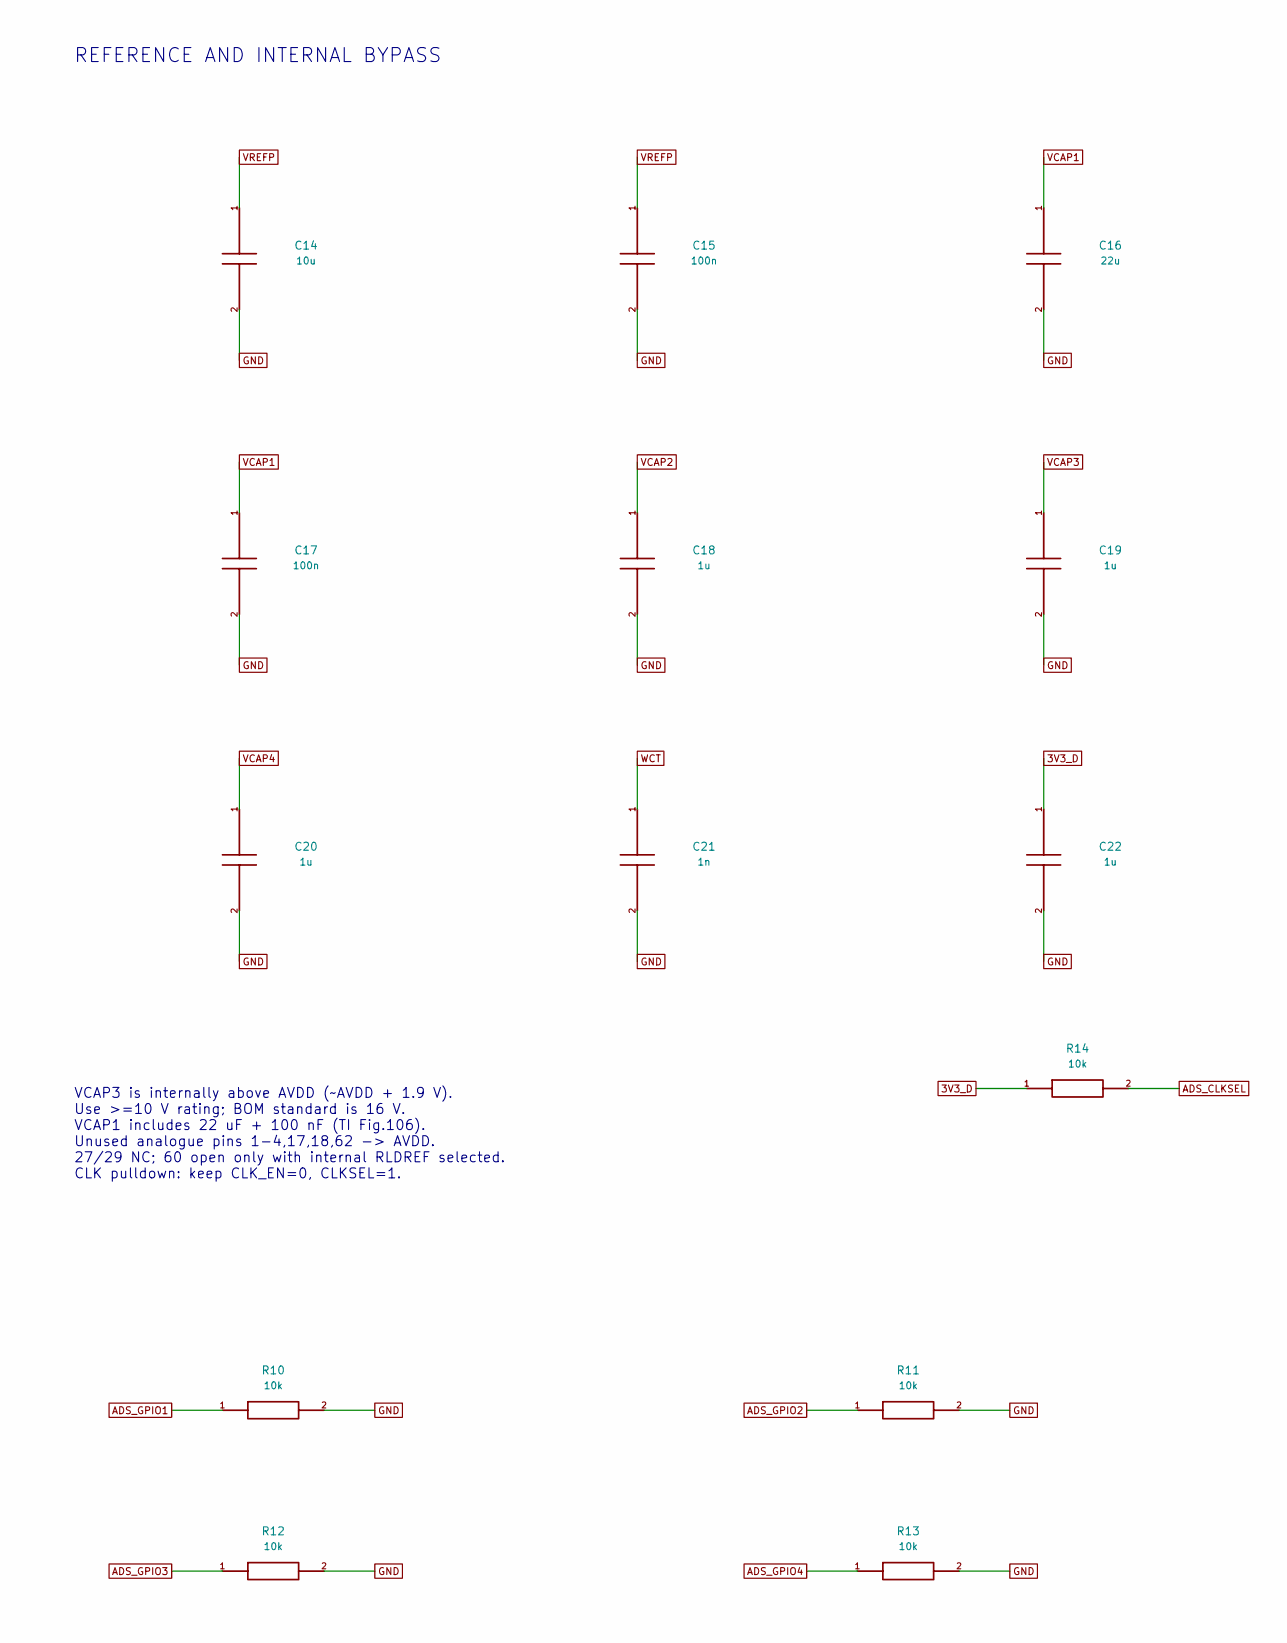
[picture p160: schematic 03_ads1296.kicad_sch, 03 - ADS1296 full pin map / reference, part in row 1, column 2]

Parts:
C14: 10u; C_1206_3216Metric; MPN C1206C106K4PACTU
C15, C17: 100n; C_0805_2012Metric; MPN C0805C104K4RACTU
C16: 22u; C_1210_3225Metric; MPN C1210C226K4PACTU
C18, C19, C20, C22: 1u; C_0805_2012Metric; MPN C0805C105K4RACTU
C21: 1n; C_0805_2012Metric; MPN C0805C102J5GACTU
R10, R11, R12, R13, R14, R15: 10k; R_0805_2012Metric; MPN RC0805FR-0710KL
TP3: VREFP; TestPoint_Pad_D1.5mm
TP4: VCAP1; TestPoint_Pad_D1.5mm
TP5: ADS_DRDY_N; TestPoint_Pad_D1.5mm
U1: ADS1296IPAG; TQFP-64_10x10mm_P0.5mm; MPN ADS1296IPAG

Connections:
3V3_D: C22.1, R14.1, U1.48 (DVDD), U1.50 (DVDD); also elsewhere on the board
ADS_CLKSEL: R14.2, U1.52 (CLKSEL)
ADS_CLK_UNUSED: R15.1, U1.37 (CLK)
ADS_CS_N: U1.39 (~CS); also elsewhere on the board
ADS_DIN: U1.34 (DIN); also elsewhere on the board
ADS_DOUT: U1.43 (DOUT); also elsewhere on the board
ADS_DRDY_N: TP5.1, U1.47 (~DRDY); also elsewhere on the board
ADS_GPIO1: R10.1, U1.42 (GPIO1)
ADS_GPIO2: R11.1, U1.44 (GPIO2)
ADS_GPIO3: R12.1, U1.45 (GPIO3)
ADS_GPIO4: R13.1, U1.46 (GPIO4)
ADS_PWDN_N: U1.35 (~PWDN); also elsewhere on the board
ADS_RESET_N: U1.36 (~RESET); also elsewhere on the board
ADS_SCLK: U1.40 (SCLK); also elsewhere on the board
ADS_START: U1.38 (START); also elsewhere on the board
AVDD: U1.1 (IN8N_UNUSED), U1.2 (IN8P_UNUSED), U1.3 (IN7N_UNUSED), U1.4 (IN7P_UNUSED), U1.17 (TESTP_PACE1), U1.18 (TESTN_PACE2), U1.19 (AVDD), U1.21 (AVDD), U1.22 (AVDD), U1.54 (AVDD1), U1.56 (AVDD), U1.59 (AVDD), U1.62 (RLDIN); also elsewhere on the board
GND: C14.2, C15.2, C16.2, C17.2, C18.2, C19.2, C20.2, C21.2, C22.2, R10.2, R11.2, R12.2, R13.2, R15.2, U1.20 (AVSS), U1.23 (AVSS), U1.25 (VREFN), U1.31 (RESV1), U1.32 (AVSS), U1.33 (DGND), U1.41 (DAISY_IN), U1.49 (DGND), U1.51 (DGND), U1.53 (AVSS1), U1.57 (AVSS), U1.58 (AVSS); also elsewhere on the board
IN1N: U1.15 (IN1N); also elsewhere on the board
IN1P: U1.16 (IN1P); also elsewhere on the board
IN2N: U1.13 (IN2N); also elsewhere on the board
IN2P: U1.14 (IN2P); also elsewhere on the board
IN3N: U1.11 (IN3N); also elsewhere on the board
IN3P: U1.12 (IN3P); also elsewhere on the board
IN4N: U1.9 (IN4N); also elsewhere on the board
IN4P: U1.10 (IN4P); also elsewhere on the board
IN5N: U1.7 (IN5N); also elsewhere on the board
IN5P: U1.8 (IN5P); also elsewhere on the board
IN6N: U1.5 (IN6N); also elsewhere on the board
IN6P: U1.6 (IN6P); also elsewhere on the board
RLDINV: U1.61 (RLDINV); also elsewhere on the board
RLDOUT: U1.63 (RLDOUT); also elsewhere on the board
VCAP1: C16.1, C17.1, TP4.1, U1.28 (VCAP1)
VCAP2: C18.1, U1.30 (VCAP2)
VCAP3: C19.1, U1.55 (VCAP3)
VCAP4: C20.1, U1.26 (VCAP4)
VREFP: C14.1, C15.1, TP3.1, U1.24 (VREFP)
WCT: C21.1, U1.64 (WCT)

Notes on the sheet:
U1: TQFP-64 / 10 x 10 mm body / 0.5 mm pitch
REFERENCE AND INTERNAL BYPASS
VCAP3 is internally above AVDD (~AVDD + 1.9 V). Use >=10 V rating; BOM standard is 16 V. VCAP1 includes 22 uF + 100 nF (TI Fig.106). Unused analogue pins 1-4,17,18,62 -> AVDD. 27/29 NC; 60 open only with internal RLDREF selected. CLK pulldown: keep CLK_EN=0, CLKSEL=1.
PGA gain 6; internal 2.4 V reference; HR 4 kS/s. Disable external PACE/test outputs and WCT. Read 21 bytes/DRDY, SPI mode 1, 4 MHz. Reserve time for power-on, reference and filter settling.

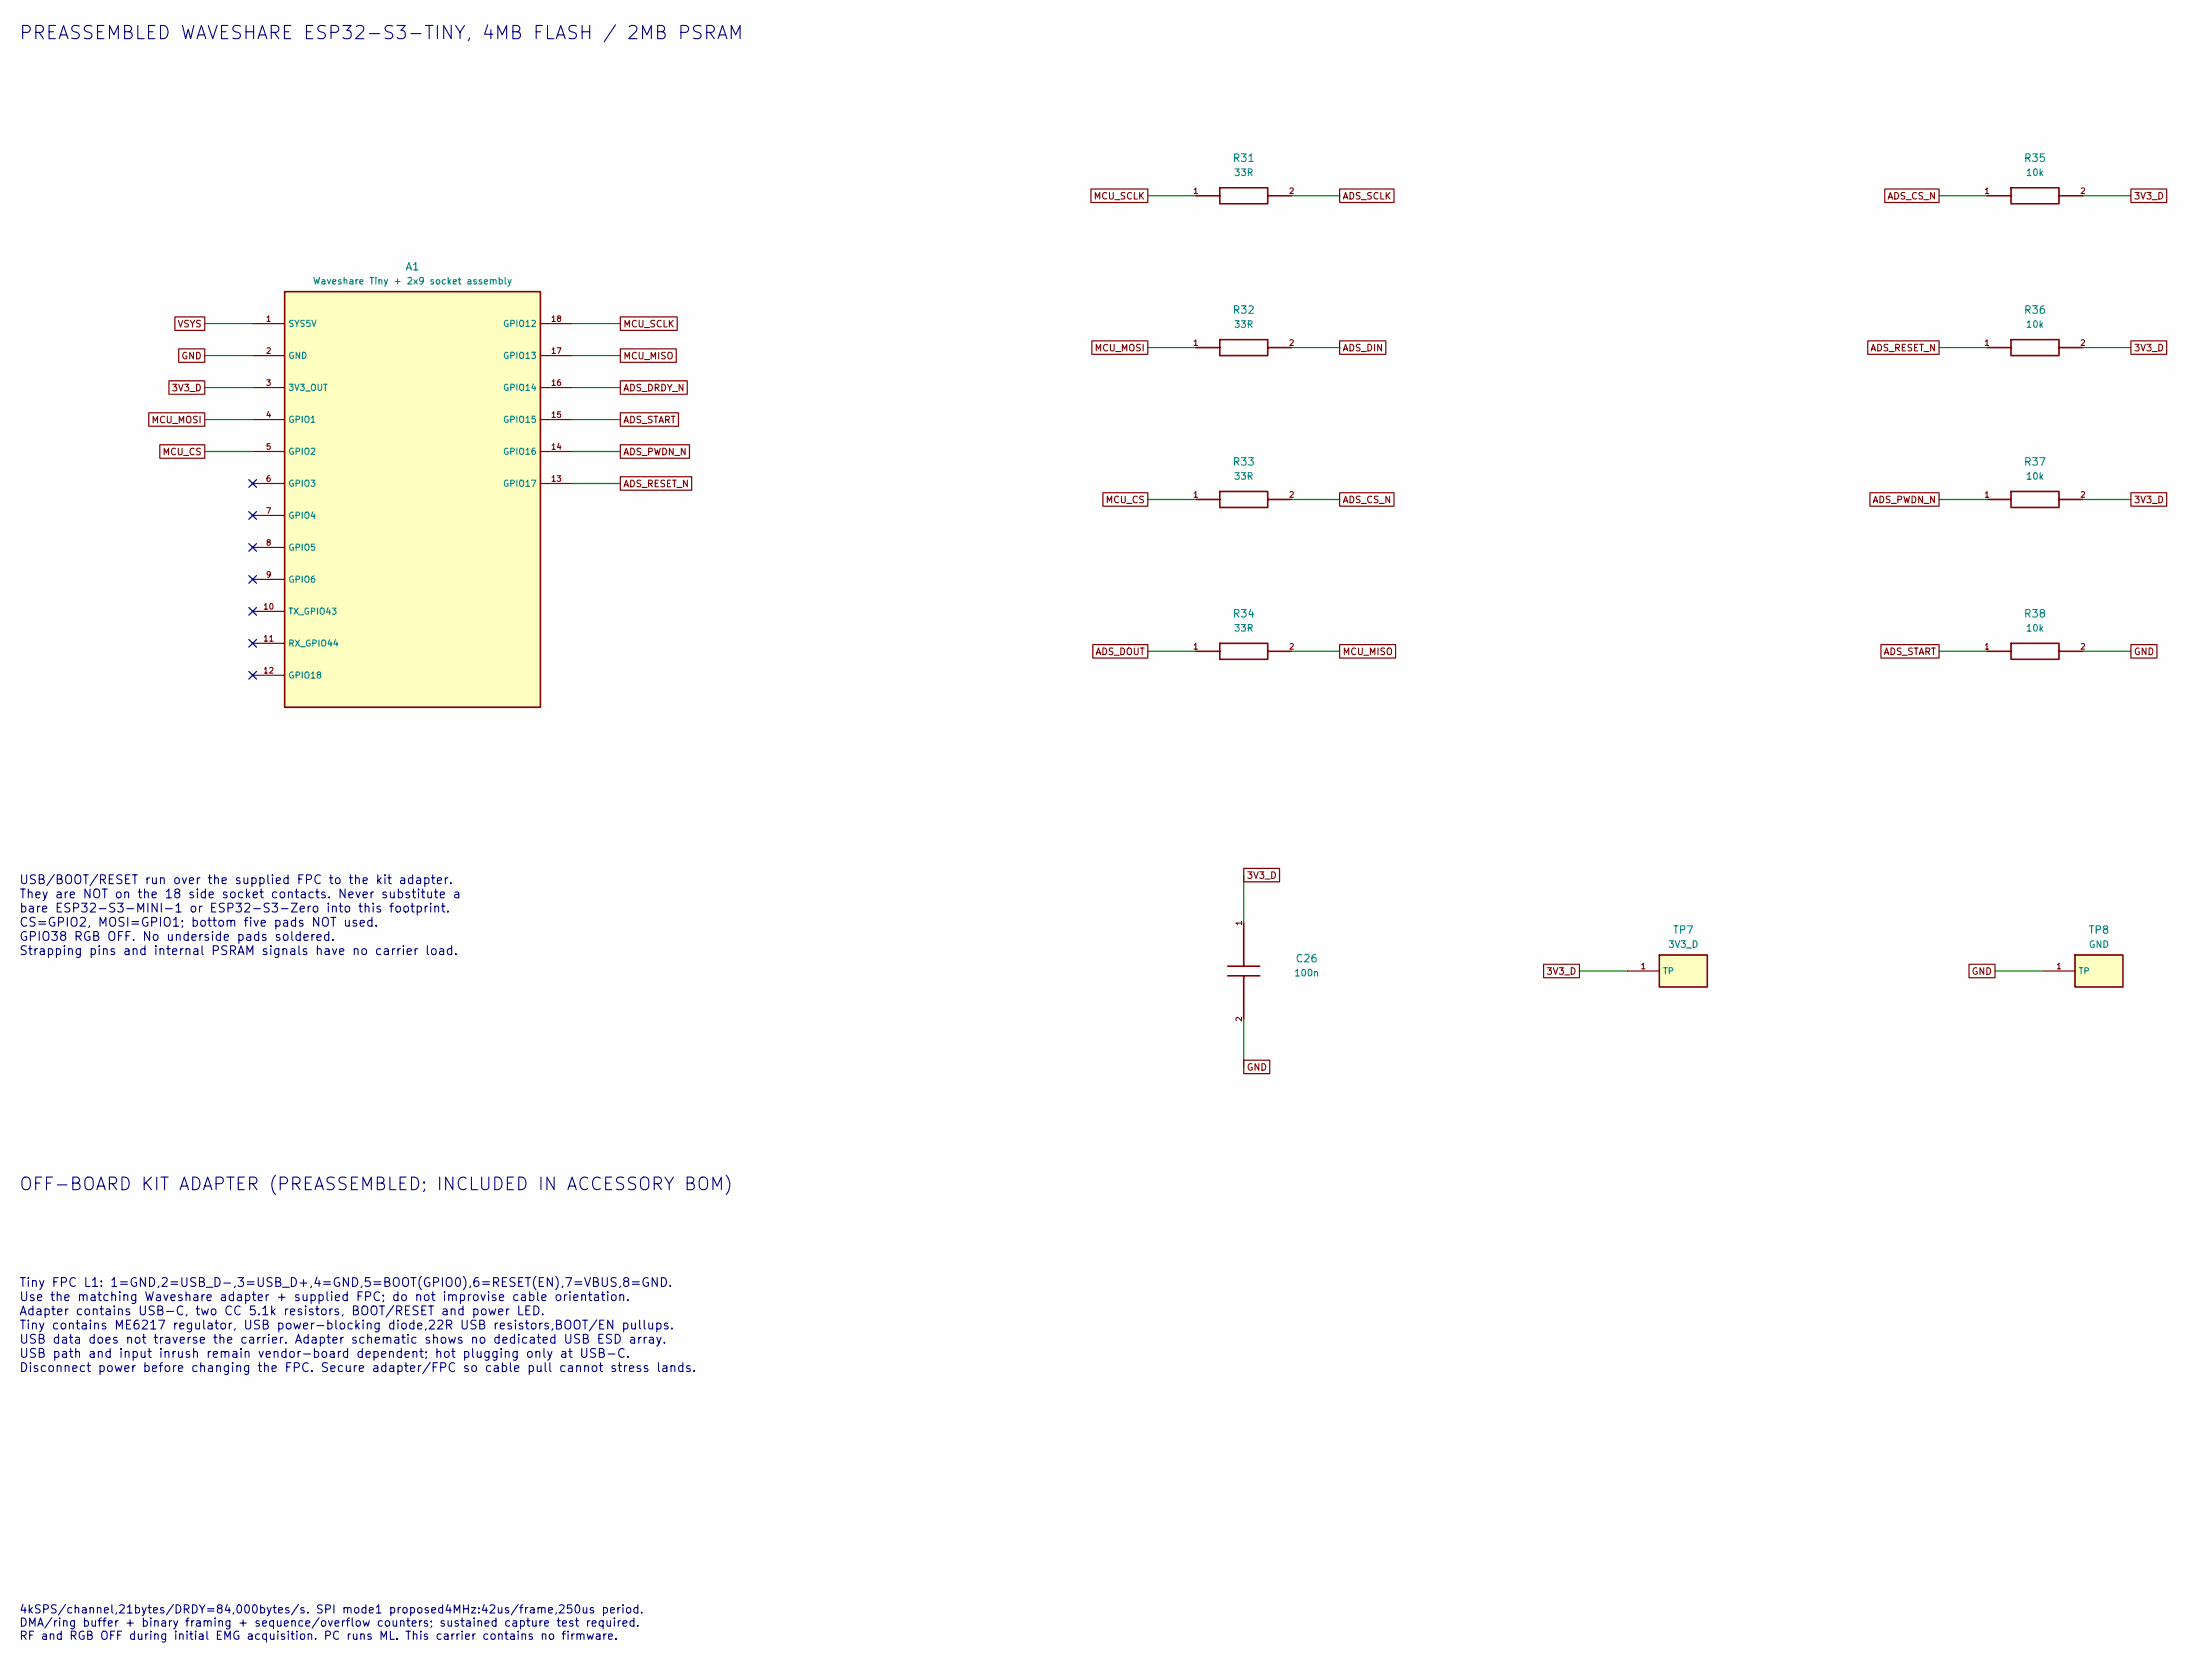
[picture p161: schematic 07_waveshare_tiny.kicad_sch, 07 - Waveshare Tiny / SPI / kit USB]

Parts:
A1: Waveshare Tiny + 2x9 socket assembly; Waveshare_ESP32_S3_Tiny_Socket18; MPN ESP32-S3-Tiny-Kit (27070)
C26: 100n; C_0805_2012Metric; MPN C0805C104K4RACTU
R31, R32, R33, R34: 33R; R_0805_2012Metric; MPN RC0805FR-0733RL
R35, R36, R37, R38: 10k; R_0805_2012Metric; MPN RC0805FR-0710KL
TP7: 3V3_D; TestPoint_Pad_D1.5mm
TP8: GND; TestPoint_Pad_D1.5mm

Connections:
3V3_D: A1.3 (3V3_OUT), C26.1, R35.2, R36.2, R37.2, TP7.1; also elsewhere on the board
ADS_CS_N: R33.2, R35.1; also elsewhere on the board
ADS_DIN: R32.2; also elsewhere on the board
ADS_DOUT: R34.1; also elsewhere on the board
ADS_DRDY_N: A1.16 (GPIO14); also elsewhere on the board
ADS_PWDN_N: A1.14 (GPIO16), R37.1; also elsewhere on the board
ADS_RESET_N: A1.13 (GPIO17), R36.1; also elsewhere on the board
ADS_SCLK: R31.2; also elsewhere on the board
ADS_START: A1.15 (GPIO15), R38.1; also elsewhere on the board
GND: A1.2 (GND), C26.2, R38.2, TP8.1; also elsewhere on the board
MCU_CS: A1.5 (GPIO2), R33.1
MCU_MISO: A1.17 (GPIO13), R34.2
MCU_MOSI: A1.4 (GPIO1), R32.1
MCU_SCLK: A1.18 (GPIO12), R31.1
VSYS: A1.1 (SYS5V); also elsewhere on the board

Notes on the sheet:
PREASSEMBLED WAVESHARE ESP32-S3-TINY, 4MB FLASH / 2MB PSRAM
USB/BOOT/RESET run over the supplied FPC to the kit adapter. They are NOT on the 18 side socket contacts. Never substitute a bare ESP32-S3-MINI-1 or ESP32-S3-Zero into this footprint. CS=GPIO2, MOSI=GPIO1; bottom five pads NOT used. GPIO38 RGB OFF. No underside pads soldered. Strapping pins and int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
OFF-BOARD KIT ADAPTER (PREASSEMBLED; INCLUDED IN ACCESSORY BOM)
Tiny FPC L1: 1=GND,2=USB_D-,3=USB_D+,4=GND,5=BOOT(GPIO0),6=RESET(EN),7=VBUS,8=GND. Use the matching Waveshare adapter + supplied FPC; do not improvise cable orientation. Adapter contains USB-C, two CC 5.1k resistors, BOOT/RESET and power LED. Tiny contains ME6217 regulator, USB power-blocking diode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
4kSPS/channel,21bytes/DRDY=84,000bytes/s. SPI mode1 proposed4MHz:42us/frame,250us period. DMA/ring buffer + binary framing + sequence/overflow counters; sustained capture test required. RF and RGB OFF during initial EMG acquisition. PC runs ML. This carrier contains no firmware.
