PrithviBhende/emg-teleoperation-ros2/hardware/ADS1296_6CH_sEMG/ADS1296_RevA4_TinySocket.kicad_pcb

## KiCad design hardware/ADS1296_6CH_sEMG/ADS1296_RevA4_TinySocket.kicad_pcb (continued)

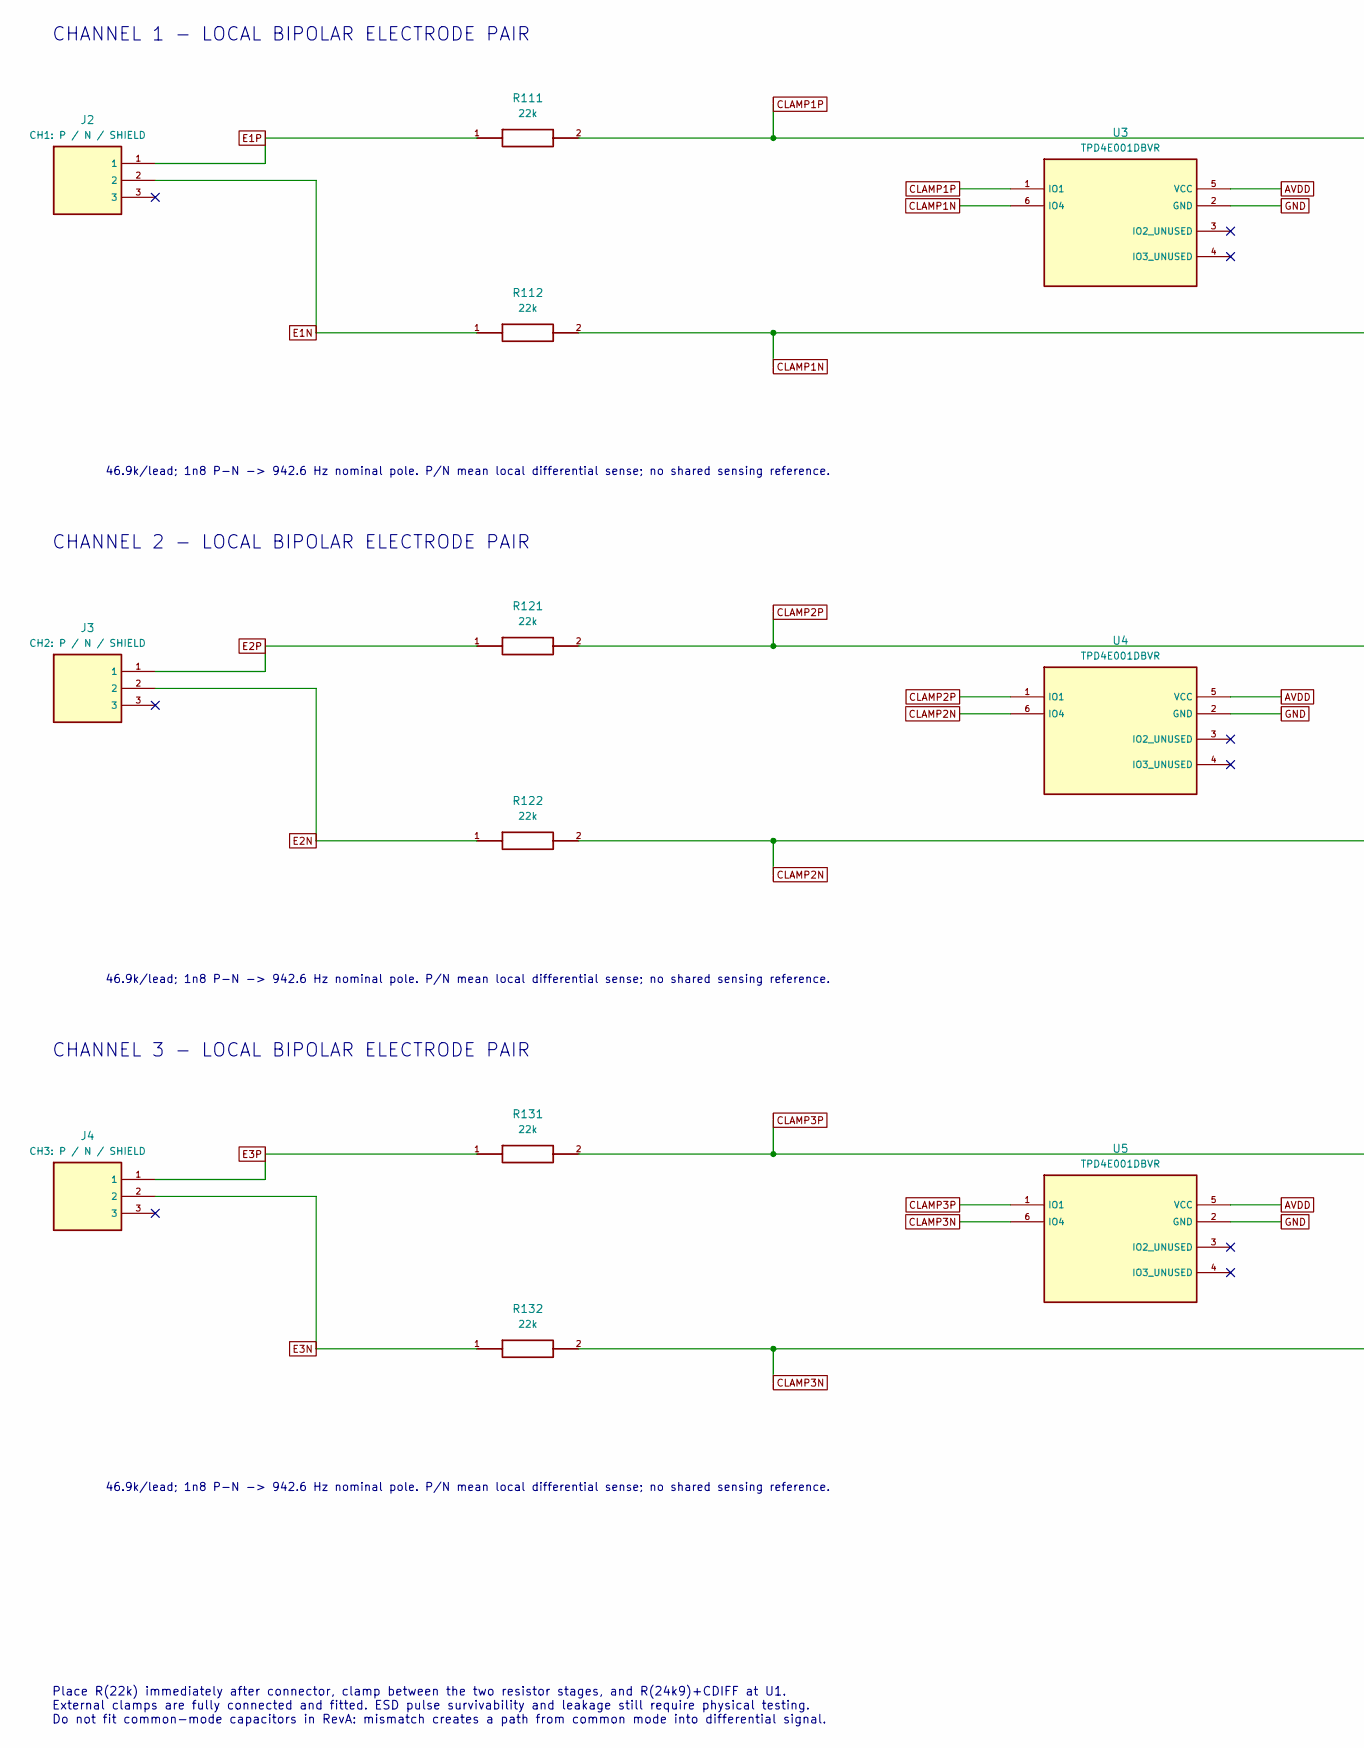
[picture p162: schematic 04_inputs_1_3.kicad_sch, 04 - Electrode inputs CH1 to CH3, part in row 1, column 1]

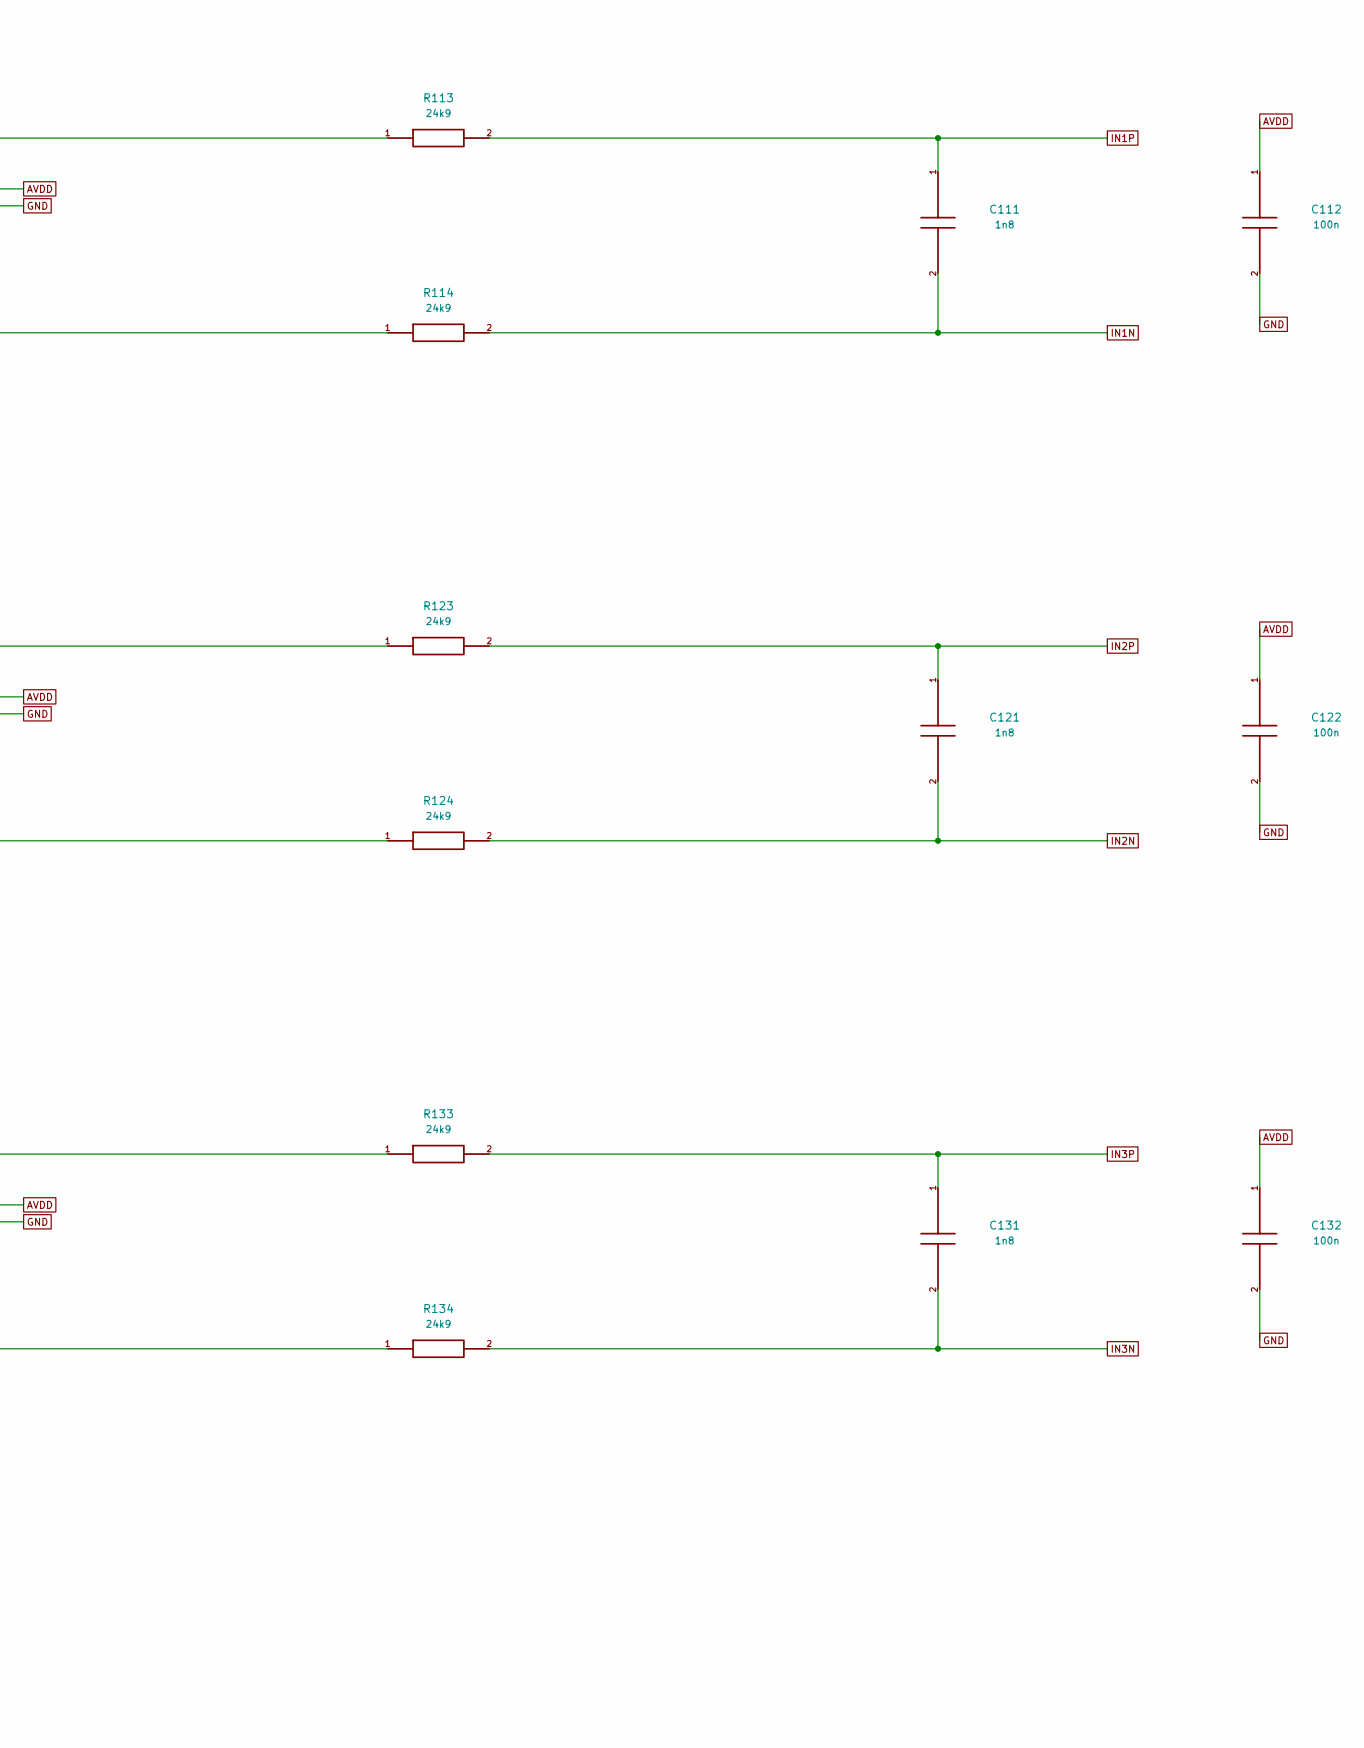
[picture p163: schematic 04_inputs_1_3.kicad_sch, 04 - Electrode inputs CH1 to CH3, part in row 1, column 2]

Parts:
C111, C121, C131: 1n8; C_0805_2012Metric; MPN C0805C182J5GACTU
C112, C122, C132: 100n; C_0805_2012Metric; MPN C0805C104K4RACTU
J2: CH1: P / N / SHIELD; JST_PH_B3B-PH-K_1x03_P2.00mm_Vertical; MPN B3B-PH-K-S(LF)(SN)
J3: CH2: P / N / SHIELD; JST_PH_B3B-PH-K_1x03_P2.00mm_Vertical; MPN B3B-PH-K-S(LF)(SN)
J4: CH3: P / N / SHIELD; JST_PH_B3B-PH-K_1x03_P2.00mm_Vertical; MPN B3B-PH-K-S(LF)(SN)
R111, R112, R121, R122, R131, R132: 22k; R_0805_2012Metric; MPN RT0805BRD0722KL
R113, R114, R123, R124, R133, R134: 24k9; R_0805_2012Metric; MPN RT0805BRD0724K9L
U3, U4, U5: TPD4E001DBVR; SOT-23-6; MPN TPD4E001DBVR

Connections:
AVDD: C112.1, C122.1, C132.1, U3.5 (VCC), U4.5 (VCC), U5.5 (VCC); also elsewhere on the board
CLAMP1N: R112.2, R114.1, U3.6 (IO4)
CLAMP1P: R111.2, R113.1, U3.1 (IO1)
CLAMP2N: R122.2, R124.1, U4.6 (IO4)
CLAMP2P: R121.2, R123.1, U4.1 (IO1)
CLAMP3N: R132.2, R134.1, U5.6 (IO4)
CLAMP3P: R131.2, R133.1, U5.1 (IO1)
E1N: J2.2, R112.1
E1P: J2.1, R111.1
E2N: J3.2, R122.1
E2P: J3.1, R121.1
E3N: J4.2, R132.1
E3P: J4.1, R131.1
GND: C112.2, C122.2, C132.2, U3.2 (GND), U4.2 (GND), U5.2 (GND); also elsewhere on the board
IN1N: C111.2, R114.2; also elsewhere on the board
IN1P: C111.1, R113.2; also elsewhere on the board
IN2N: C121.2, R124.2; also elsewhere on the board
IN2P: C121.1, R123.2; also elsewhere on the board
IN3N: C131.2, R134.2; also elsewhere on the board
IN3P: C131.1, R133.2; also elsewhere on the board

Notes on the sheet:
CHANNEL 1 - LOCAL BIPOLAR ELECTRODE PAIR
46.9k/lead; 1n8 P-N -> 942.6 Hz nominal pole. P/N mean local differential sense; no shared sensing reference.
CHANNEL 2 - LOCAL BIPOLAR ELECTRODE PAIR
CHANNEL 3 - LOCAL BIPOLAR ELECTRODE PAIR
Place R(22k) immediately after connector, clamp between the two resistor stages, and R(24k9)+CDIFF at U1. External clamps are fully connected and fitted. ESD pulse survivability and leakage still require physical testing. Do not fit common-mode capacitors in RevA: mismatch creates a path from commo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

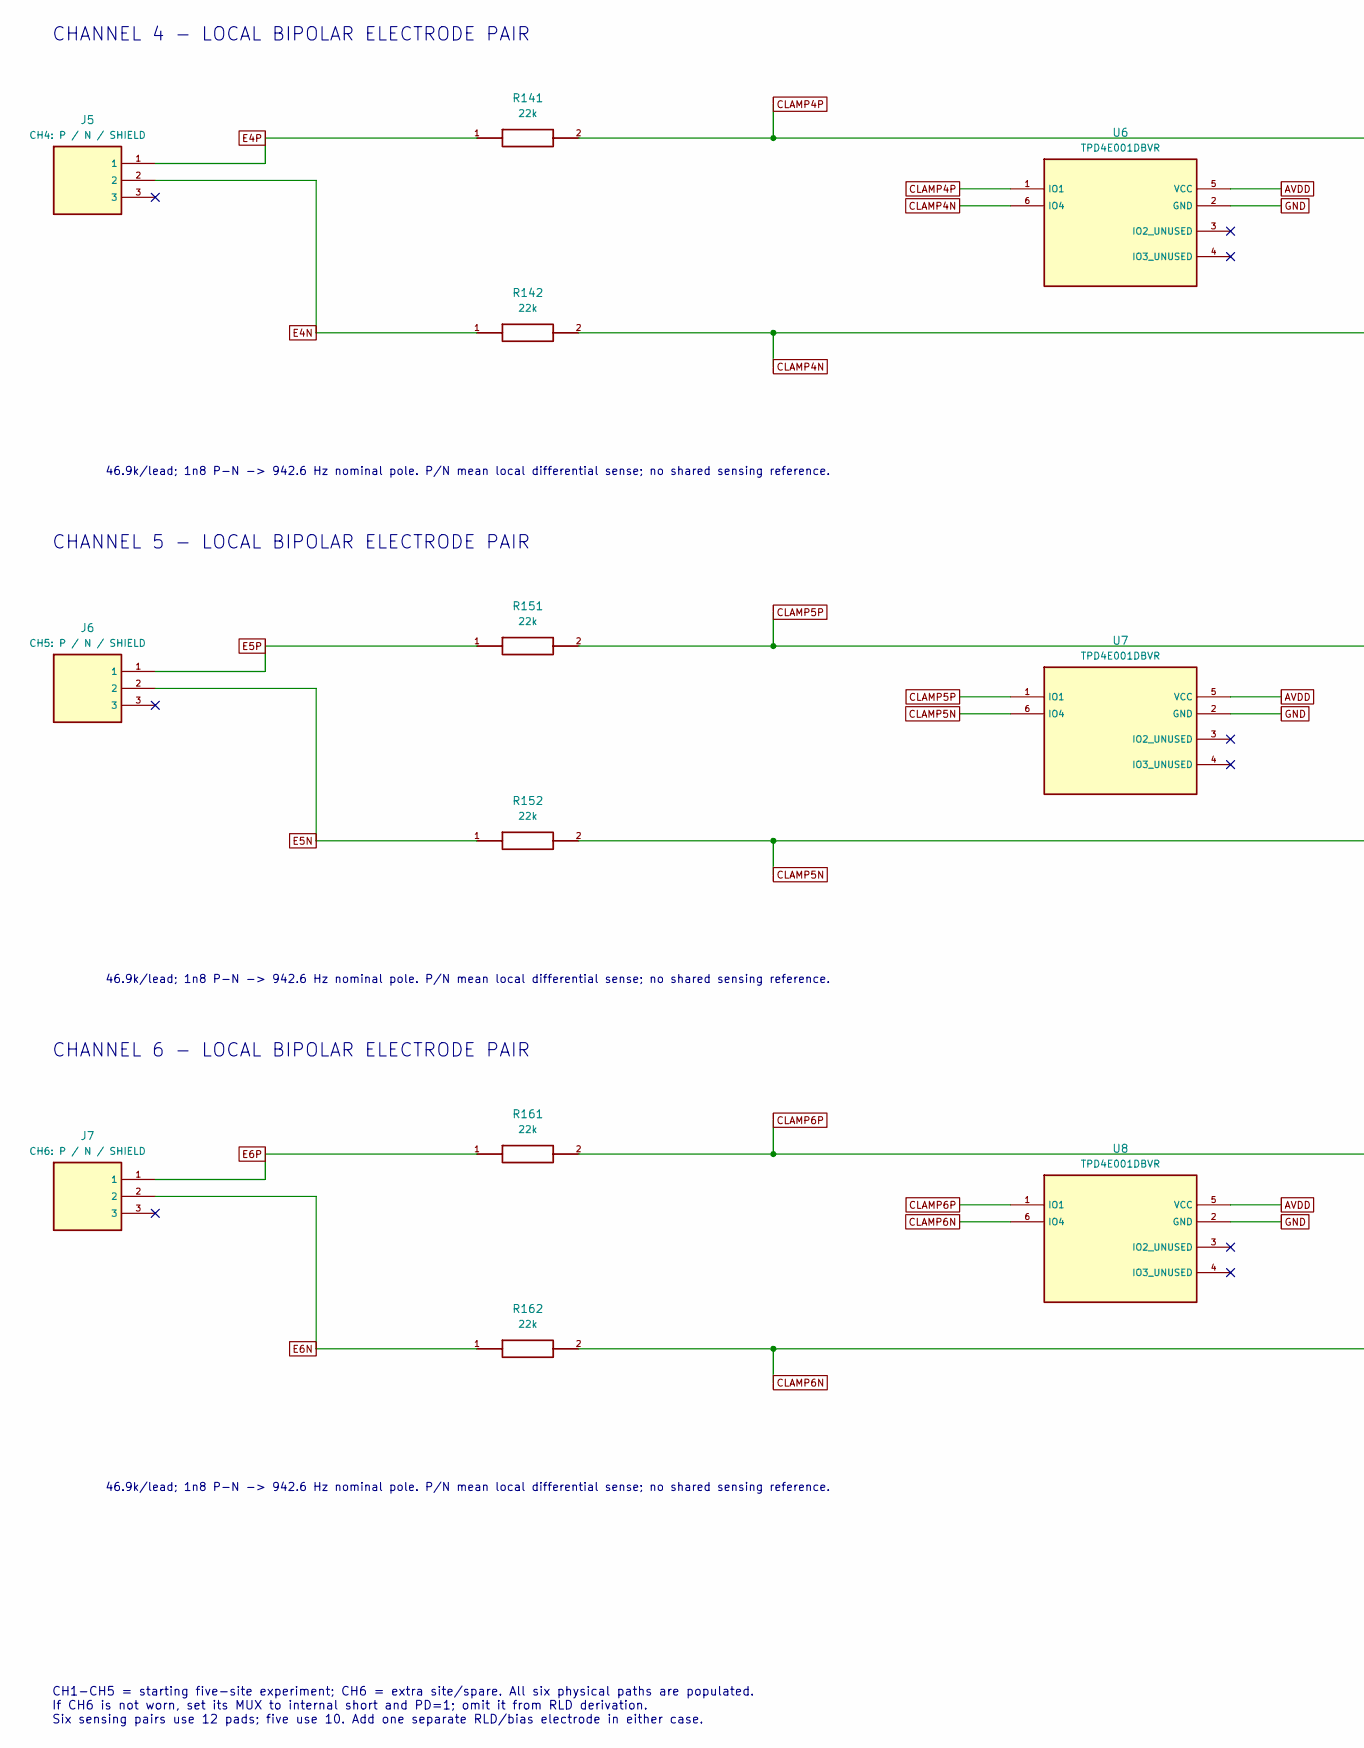
[picture p164: schematic 05_inputs_4_6.kicad_sch, 05 - Electrode inputs CH4 to CH6, part in row 1, column 1]

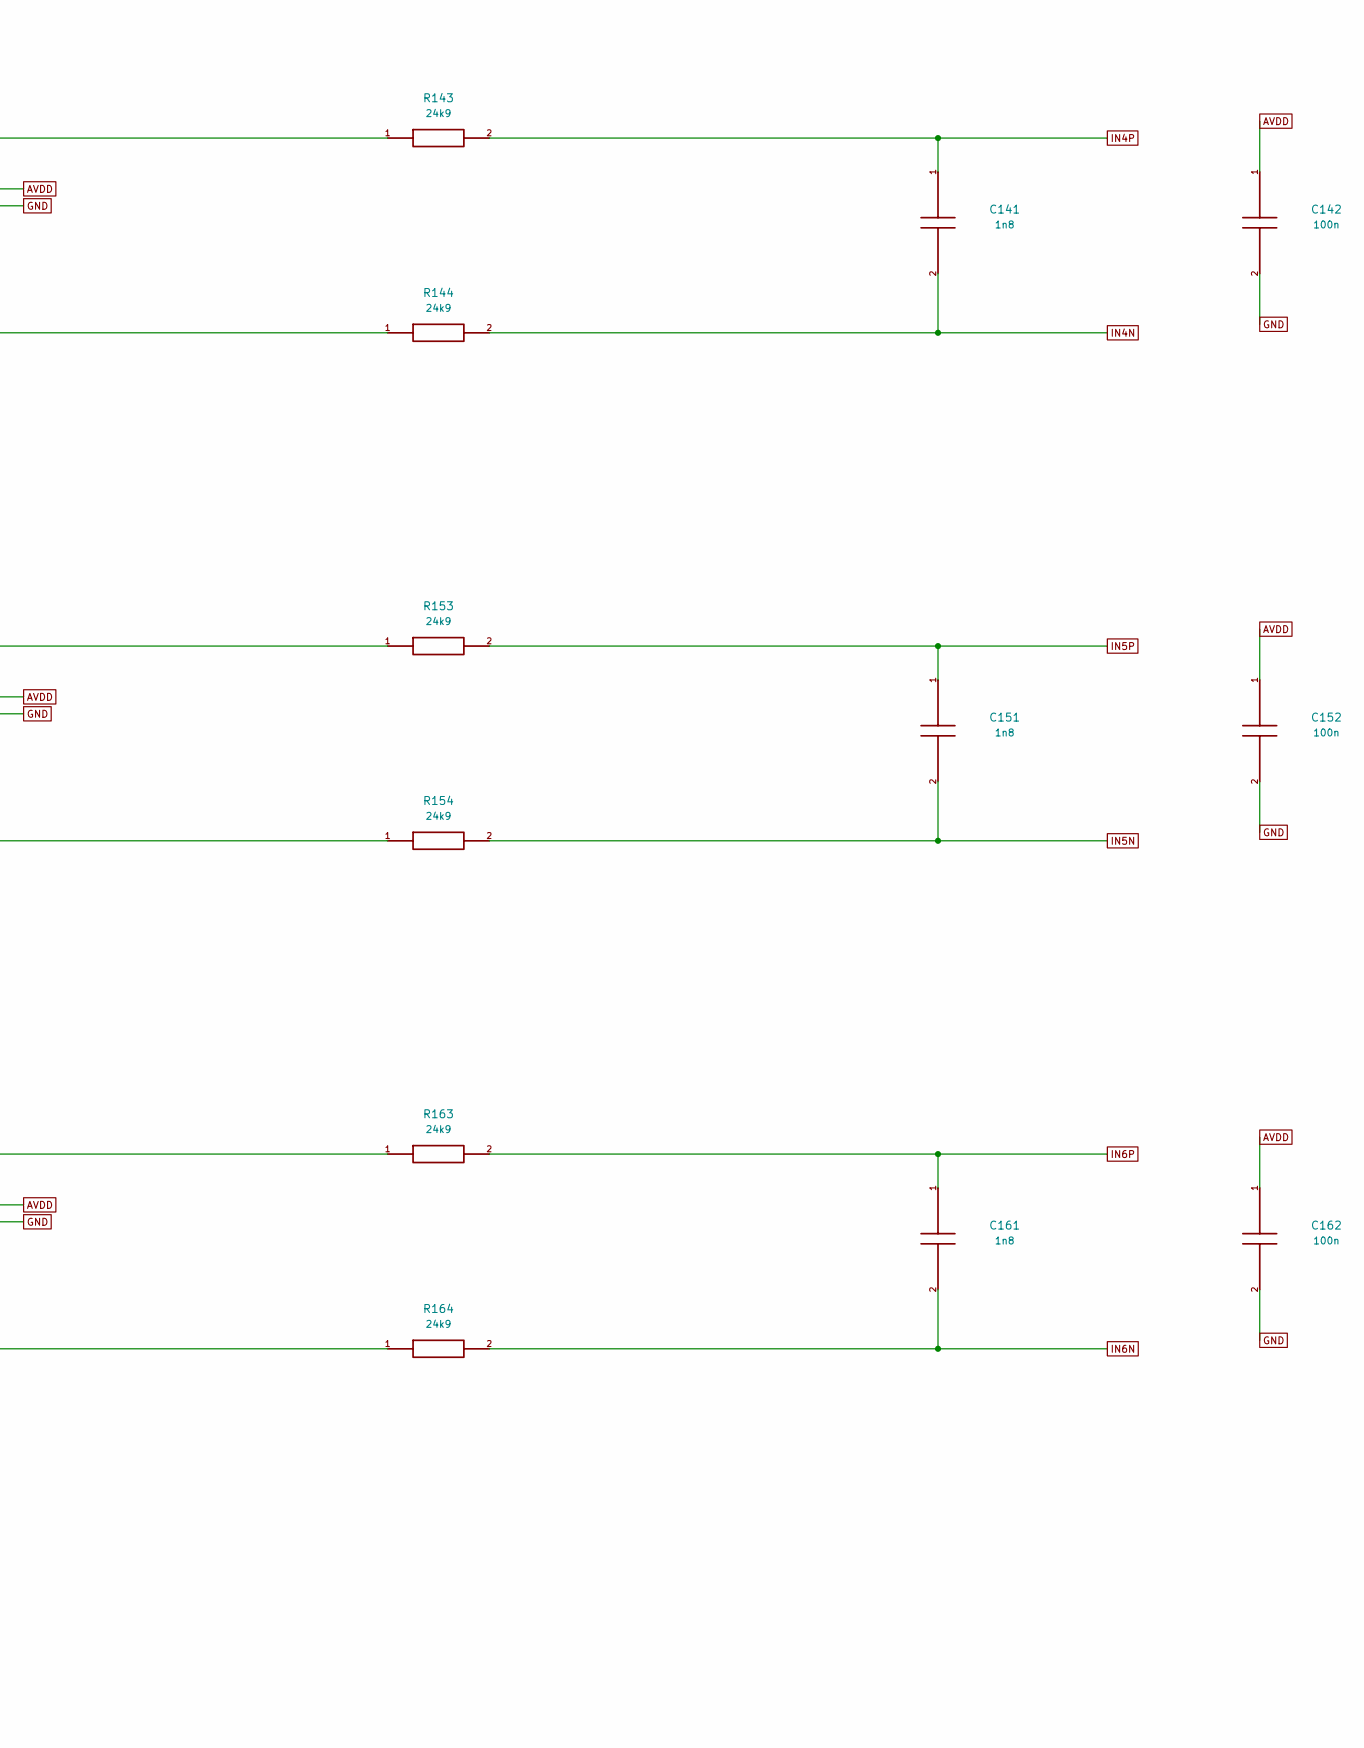
[picture p165: schematic 05_inputs_4_6.kicad_sch, 05 - Electrode inputs CH4 to CH6, part in row 1, column 2]

Parts:
C141, C151, C161: 1n8; C_0805_2012Metric; MPN C0805C182J5GACTU
C142, C152, C162: 100n; C_0805_2012Metric; MPN C0805C104K4RACTU
J5: CH4: P / N / SHIELD; JST_PH_B3B-PH-K_1x03_P2.00mm_Vertical; MPN B3B-PH-K-S(LF)(SN)
J6: CH5: P / N / SHIELD; JST_PH_B3B-PH-K_1x03_P2.00mm_Vertical; MPN B3B-PH-K-S(LF)(SN)
J7: CH6: P / N / SHIELD; JST_PH_B3B-PH-K_1x03_P2.00mm_Vertical; MPN B3B-PH-K-S(LF)(SN)
R141, R142, R151, R152, R161, R162: 22k; R_0805_2012Metric; MPN RT0805BRD0722KL
R143, R144, R153, R154, R163, R164: 24k9; R_0805_2012Metric; MPN RT0805BRD0724K9L
U6, U7, U8: TPD4E001DBVR; SOT-23-6; MPN TPD4E001DBVR

Connections:
AVDD: C142.1, C152.1, C162.1, U6.5 (VCC), U7.5 (VCC), U8.5 (VCC); also elsewhere on the board
CLAMP4N: R142.2, R144.1, U6.6 (IO4)
CLAMP4P: R141.2, R143.1, U6.1 (IO1)
CLAMP5N: R152.2, R154.1, U7.6 (IO4)
CLAMP5P: R151.2, R153.1, U7.1 (IO1)
CLAMP6N: R162.2, R164.1, U8.6 (IO4)
CLAMP6P: R161.2, R163.1, U8.1 (IO1)
E4N: J5.2, R142.1
E4P: J5.1, R141.1
E5N: J6.2, R152.1
E5P: J6.1, R151.1
E6N: J7.2, R162.1
E6P: J7.1, R161.1
GND: C142.2, C152.2, C162.2, U6.2 (GND), U7.2 (GND), U8.2 (GND); also elsewhere on the board
IN4N: C141.2, R144.2; also elsewhere on the board
IN4P: C141.1, R143.2; also elsewhere on the board
IN5N: C151.2, R154.2; also elsewhere on the board
IN5P: C151.1, R153.2; also elsewhere on the board
IN6N: C161.2, R164.2; also elsewhere on the board
IN6P: C161.1, R163.2; also elsewhere on the board

Notes on the sheet:
CHANNEL 4 - LOCAL BIPOLAR ELECTRODE PAIR
46.9k/lead; 1n8 P-N -> 942.6 Hz nominal pole. P/N mean local differential sense; no shared sensing reference.
CHANNEL 5 - LOCAL BIPOLAR ELECTRODE PAIR
CHANNEL 6 - LOCAL BIPOLAR ELECTRODE PAIR
CH1-CH5 = starting five-site experiment; CH6 = extra site/spare. All six physical paths are populated. If CH6 is not worn, set its MUX to internal short and PD=1; omit it from RLD derivation. Six sensing pairs use 12 pads; five use 10. Add one separate RLD/bias electrode in either case.

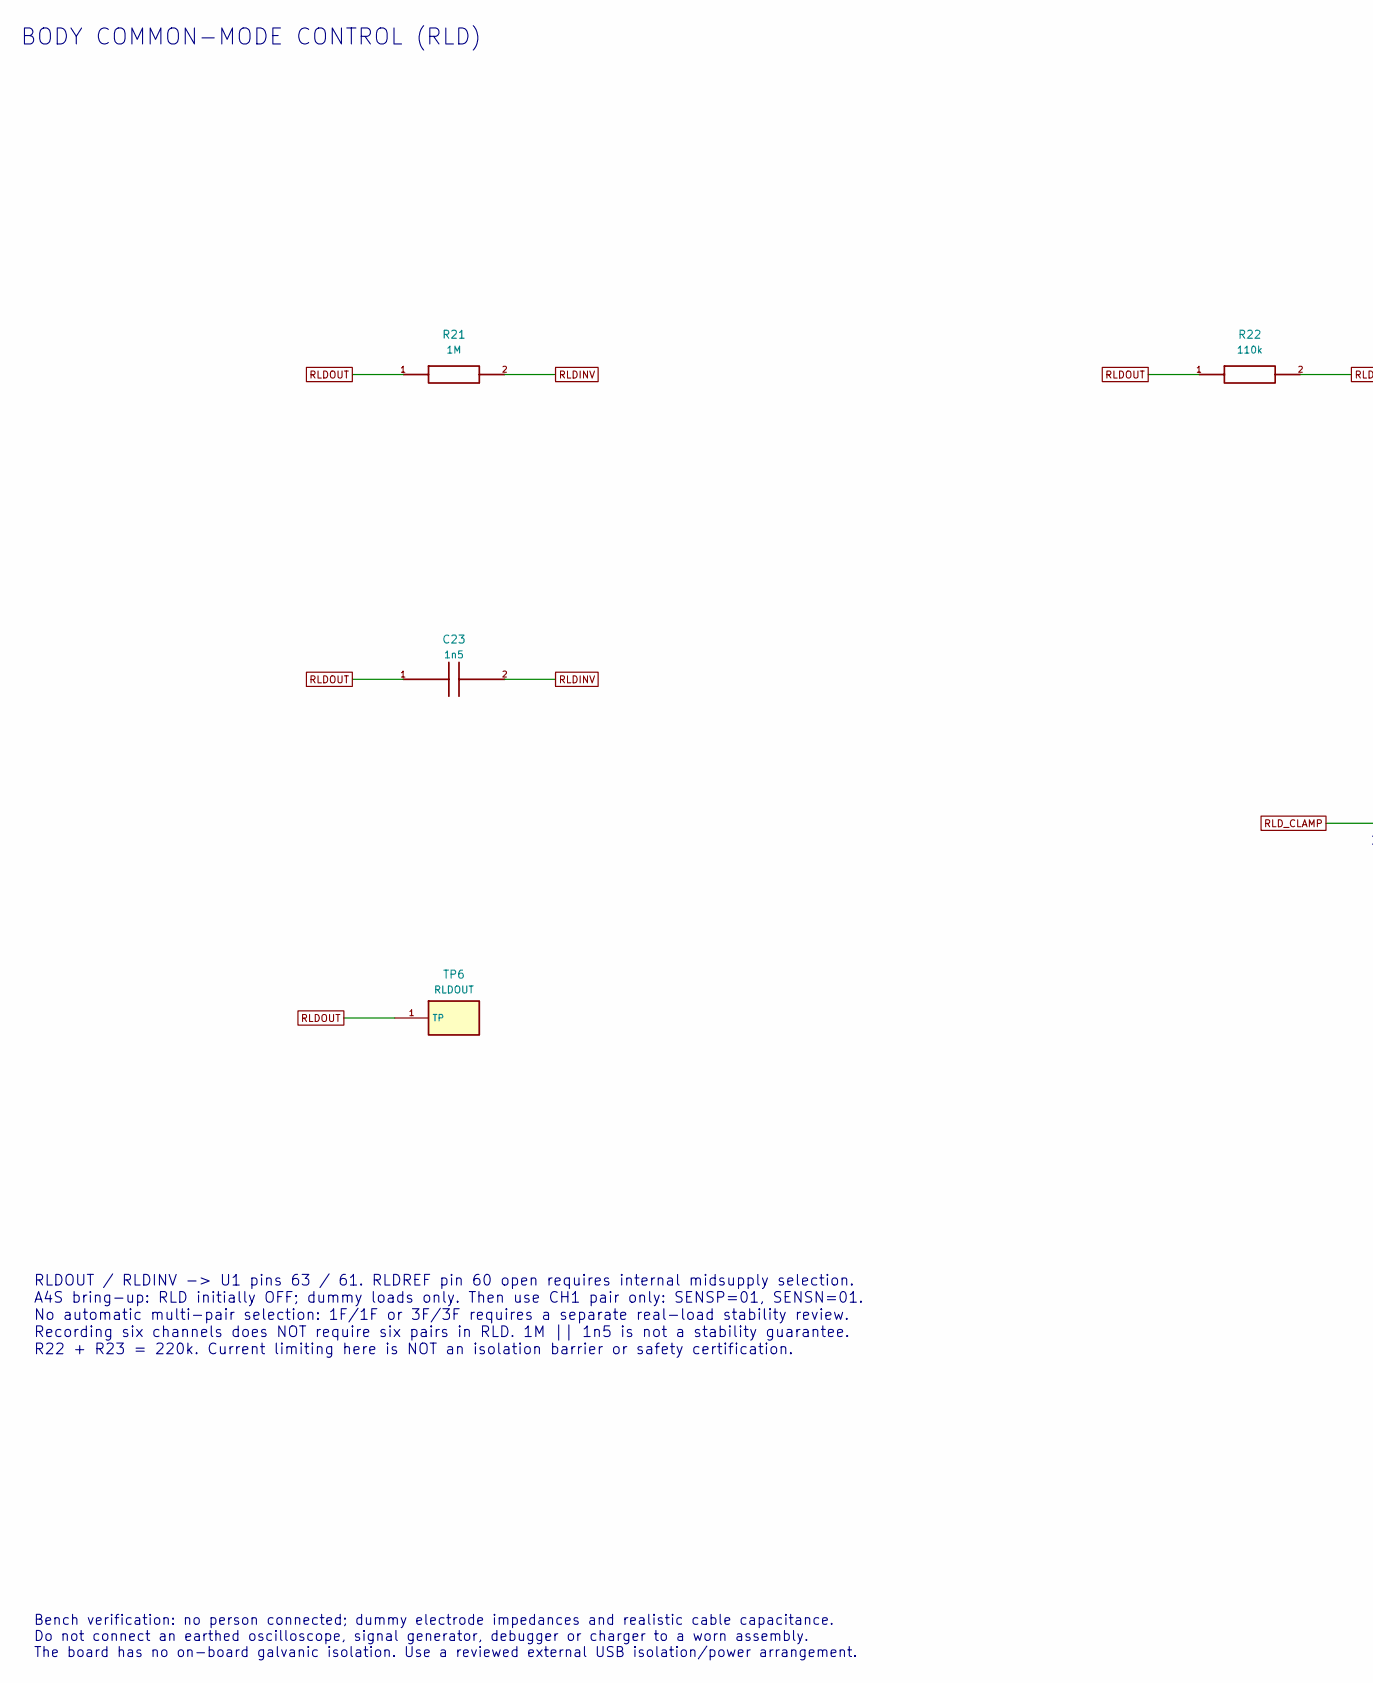
[picture p166: schematic 06_body_bias.kicad_sch, 06 - Body bias and feedback, part in row 1, column 1]

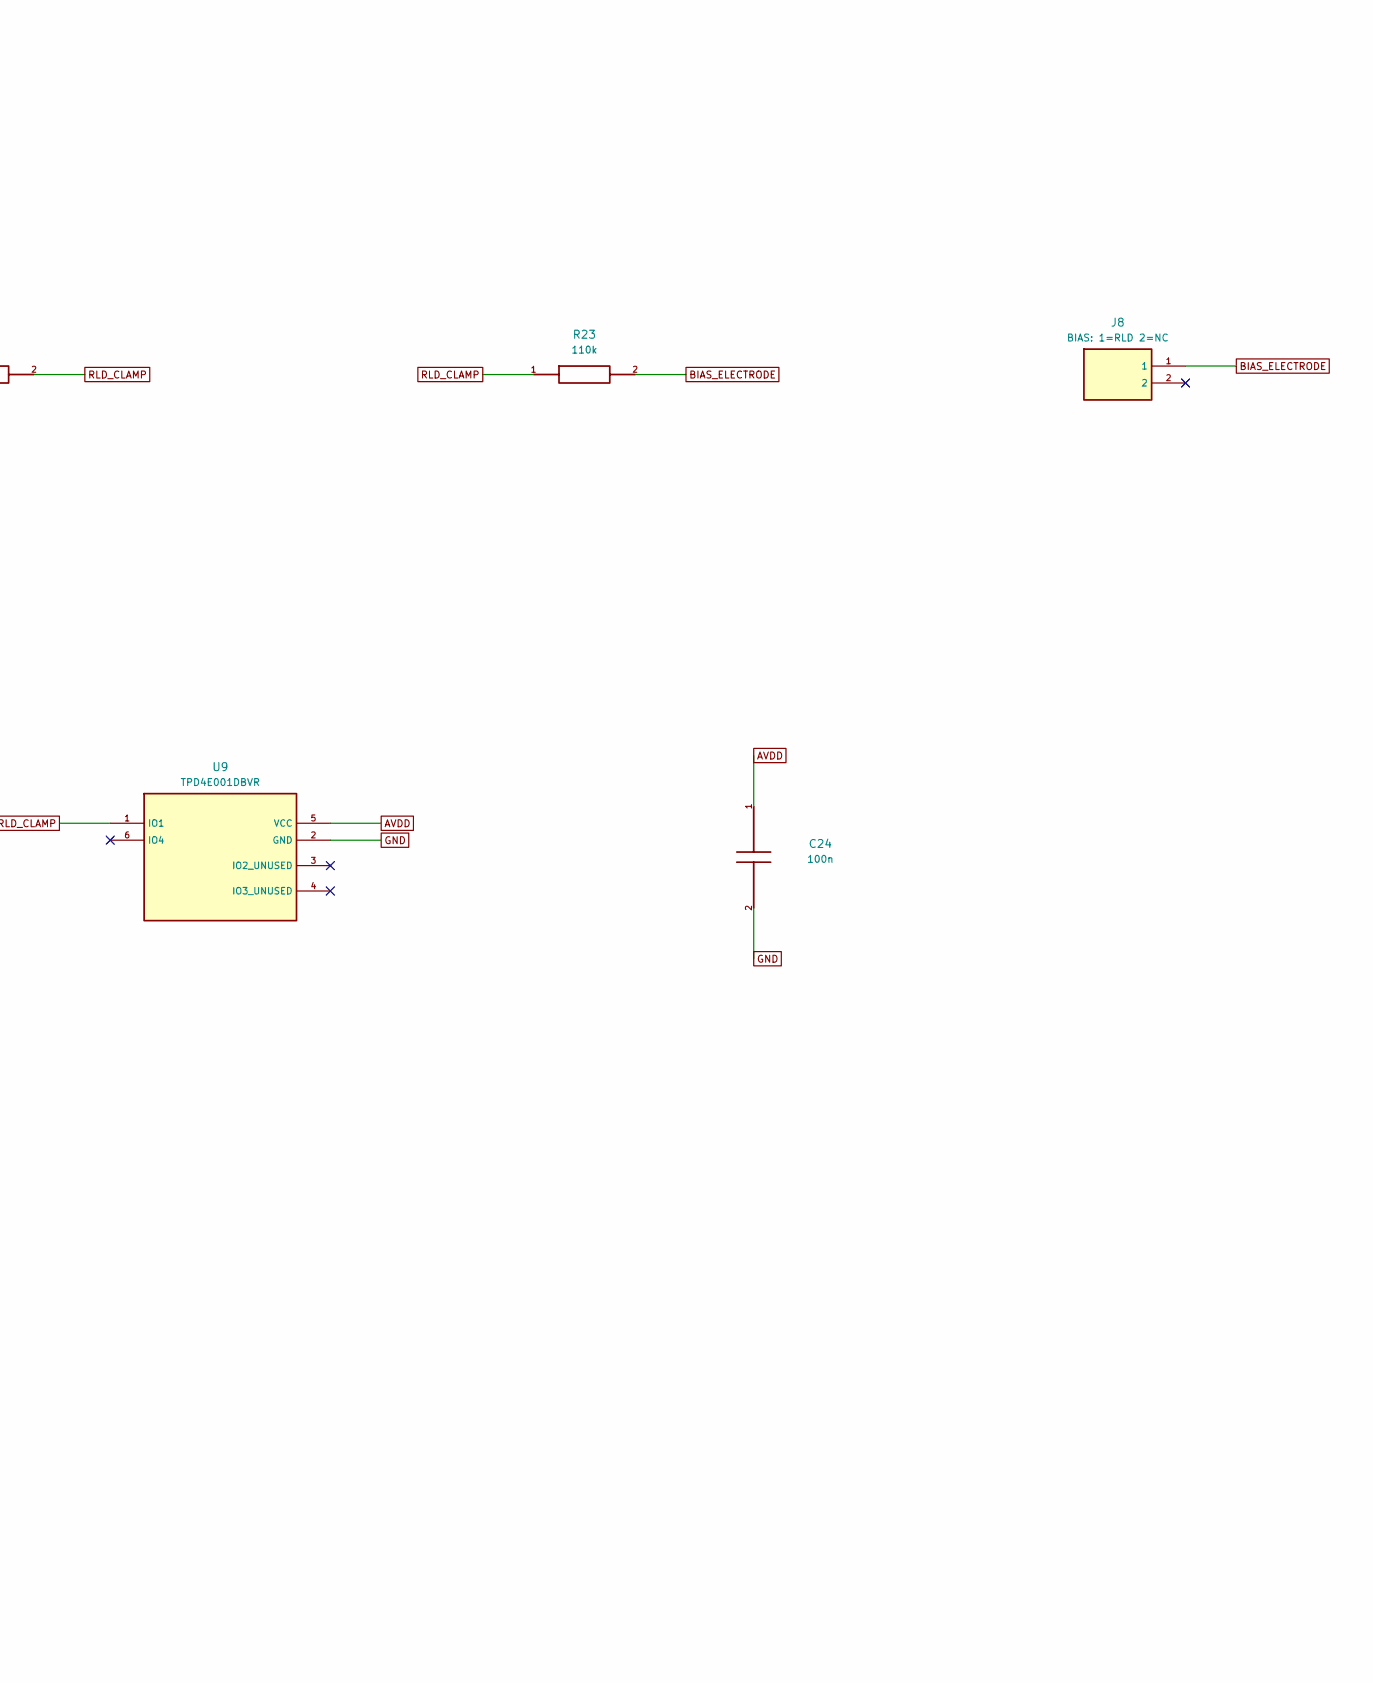
[picture p167: schematic 06_body_bias.kicad_sch, 06 - Body bias and feedback, part in row 1, column 2]

Parts:
C23: 1n5; C_0805_2012Metric; MPN C0805C152J5GACTU
C24: 100n; C_0805_2012Metric; MPN C0805C104K4RACTU
J8: BIAS: 1=RLD 2=NC; JST_PH_B2B-PH-K_1x02_P2.00mm_Vertical; MPN B2B-PH-K-S(LF)(SN)
R21: 1M; R_0805_2012Metric; MPN RC0805FR-071ML
R22, R23: 110k; R_0805_2012Metric; MPN RC0805FR-07110KL
TP6: RLDOUT; TestPoint_Pad_D1.5mm
U9: TPD4E001DBVR; SOT-23-6; MPN TPD4E001DBVR

Connections:
AVDD: C24.1, U9.5 (VCC); also elsewhere on the board
BIAS_ELECTRODE: J8.1, R23.2
GND: C24.2, U9.2 (GND); also elsewhere on the board
RLDINV: C23.2, R21.2; also elsewhere on the board
RLDOUT: C23.1, R21.1, R22.1, TP6.1; also elsewhere on the board
RLD_CLAMP: R22.2, R23.1, U9.1 (IO1)

Notes on the sheet:
BODY COMMON-MODE CONTROL (RLD)
RLDOUT / RLDINV -> U1 pins 63 / 61. RLDREF pin 60 open requires internal midsupply selection. A4S bring-up: RLD initially OFF; dummy loads only. Then use CH1 pair only: SENSP=01, SENSN=01. No automatic multi-pair selection: 1F/1F or 3F/3F requires a separate real-load stability review. Recording si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
Bench verification: no person connected; dummy electrode impedances and realistic cable capacitance. Do not connect an earthed oscilloscope, signal generator, debugger or charger to a worn assembly. The board has no on-board galvanic isolation. Use a reviewed external USB isolation/power arrangemen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

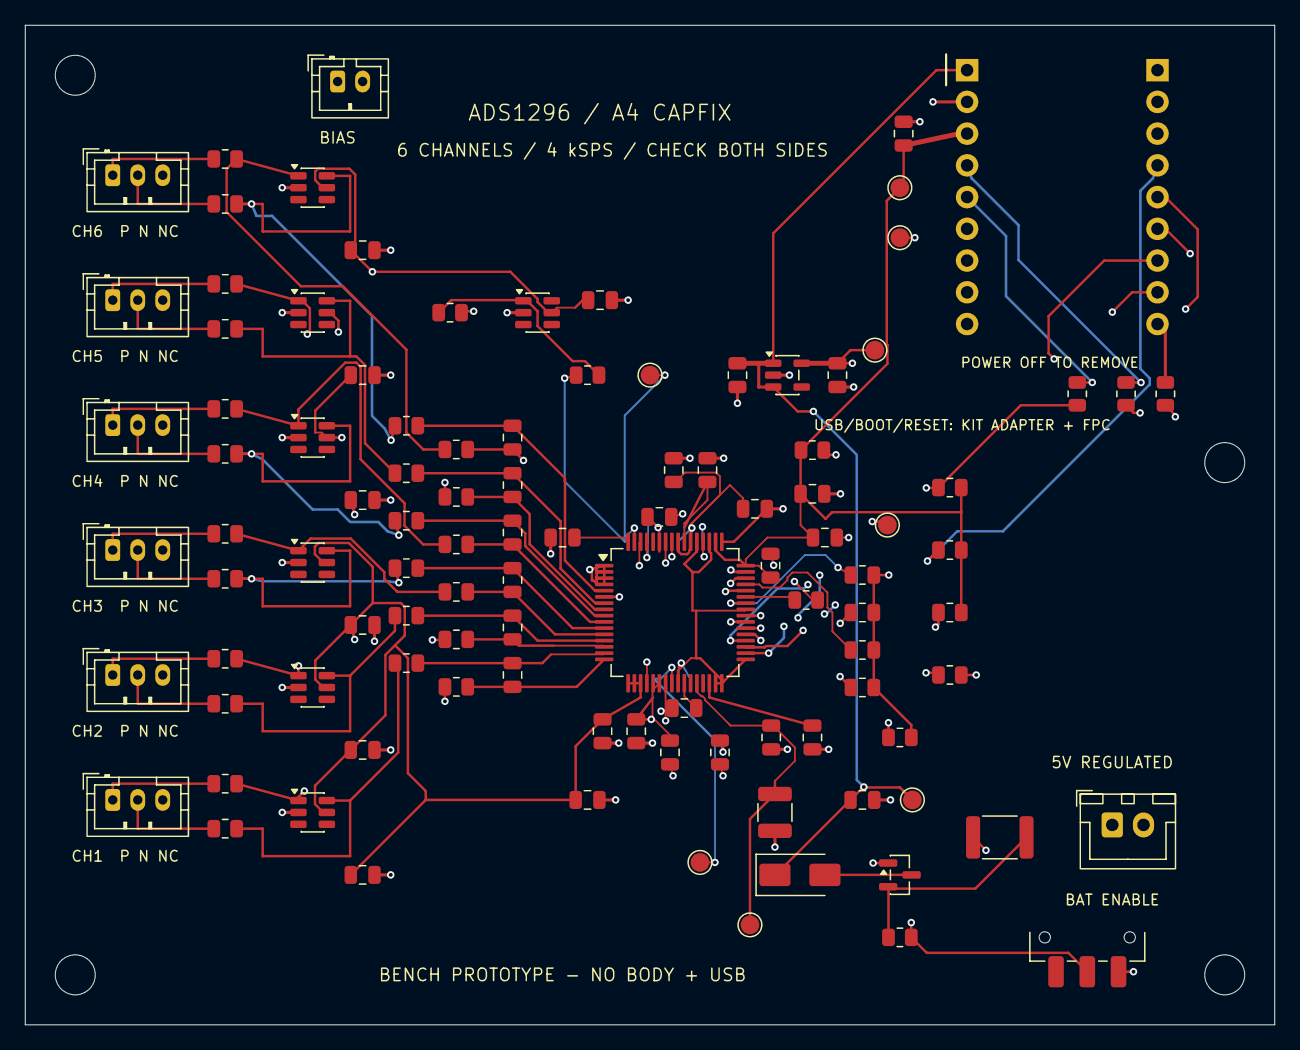
[picture p168: board ADS1296_RevA4_TinySocket.kicad_pcb from above]

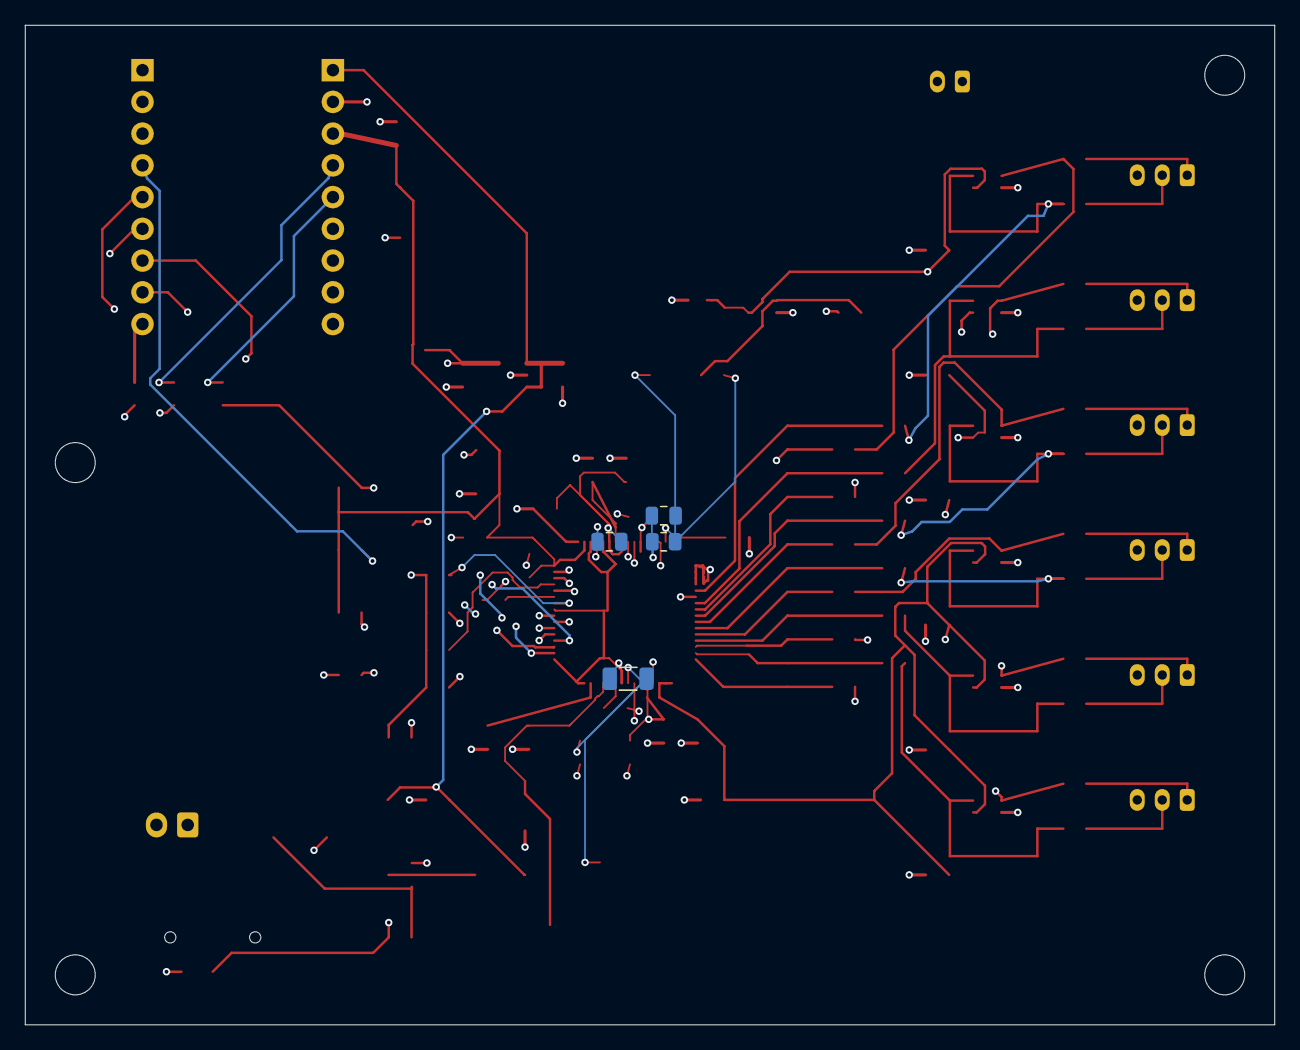
[picture p169: board ADS1296_RevA4_TinySocket.kicad_pcb from below]

Board: 4 copper layers, 100.0 x 80.0 mm, 113 parts (4 on the bottom side), 72 nets.
