PrithviBhende/emg-teleoperation-ros2/(commit log)

2026-11-13 feat: add end-to-end sEMG gesture recognition, ROS 2 InMoov teleoperation, ADS1296 hardware design, and comprehensive documentation
    [02_power.kicad_sch, 03_ads1296.kicad_sch, 04_inputs_1_3.kicad_sch, 05_inputs_4_6.kicad_sch, 06_body_bias.kicad_sch, 07_waveshare_tiny.kicad_sch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]
2026-11-13 fix(docs): add solid white background to schematic image for GitHub dark mode visibility
